reprapperMC/mini-hibiscus/production_parts/electronics/HEATSINK/No_heatsink/IR_4687.jpg

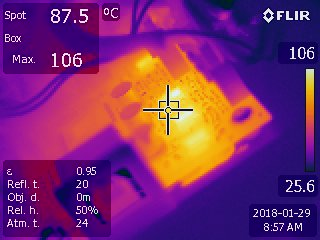
production_parts/electronics/HEATSINK/No_heatsink/IR_4687.jpg
