reprapperMC/mini-hibiscus/production_parts/printed_parts/x_carriage_mini2/ATTIC/README

X-Carriage v4.1 replaces v4 to address this ticket: https://code.alephobjects.com/T1295
See ticket for complete details
