reprapperMC/mini-hibiscus/photos/Mini2_Angled_800x800.PNG

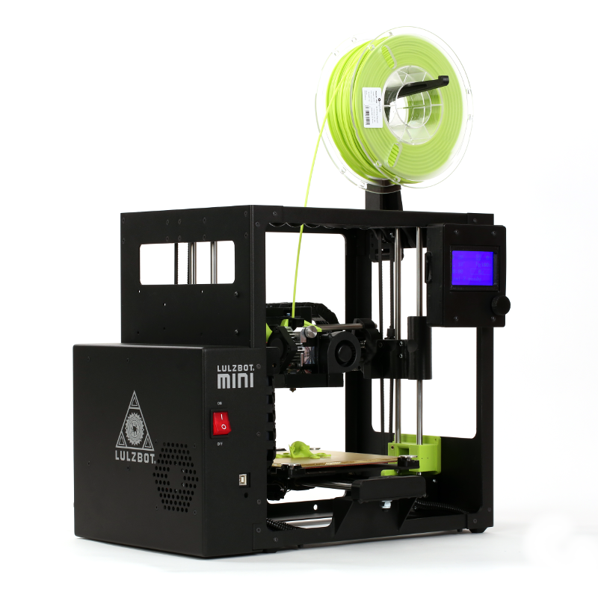
photos/Mini2_Angled_800x800.PNG
