reprapperMC/mini-hibiscus/photos/Mini2_Graphic_onBlack.JPG

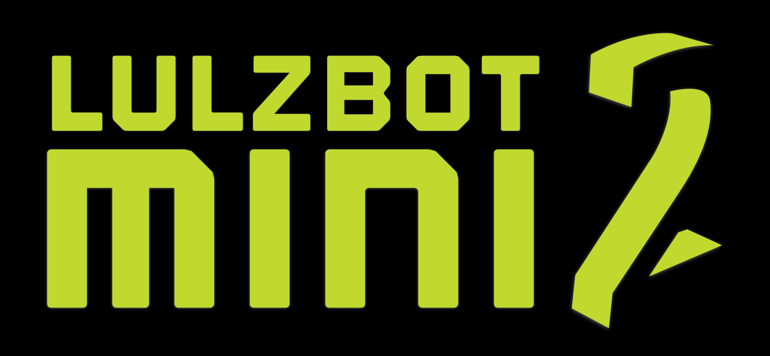
photos/Mini2_Graphic_onBlack.JPG
