reprapperMC/mini-hibiscus/photos/Mini2_Graphic_TransparentBG.png

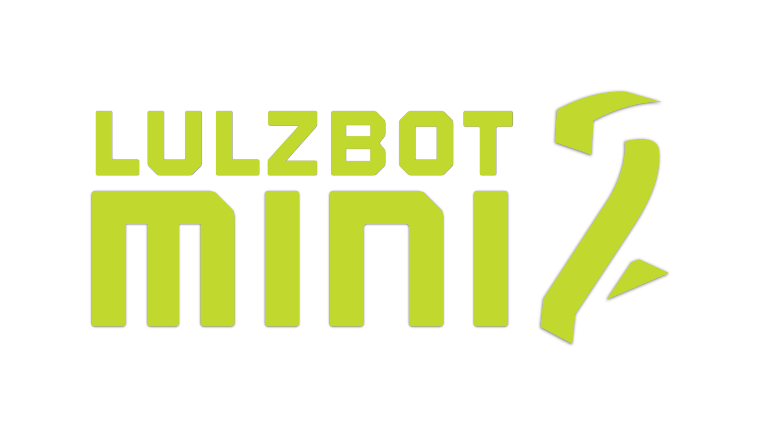
photos/Mini2_Graphic_TransparentBG.png
