reprapperMC/mini-hibiscus/photos/Mini2_Graphic_whitebg.JPG

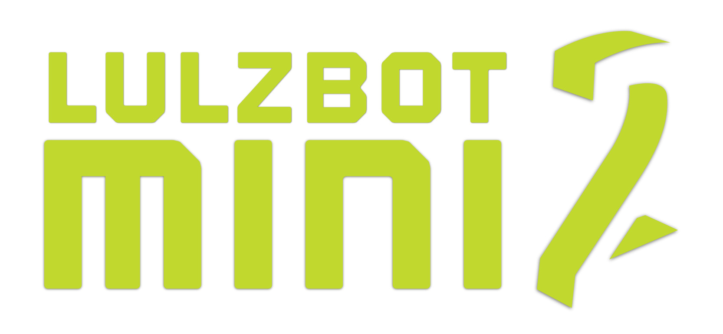
photos/Mini2_Graphic_whitebg.JPG
