reprapperMC/mini-hibiscus/photos/Mini2_StraightOn_800x800.PNG

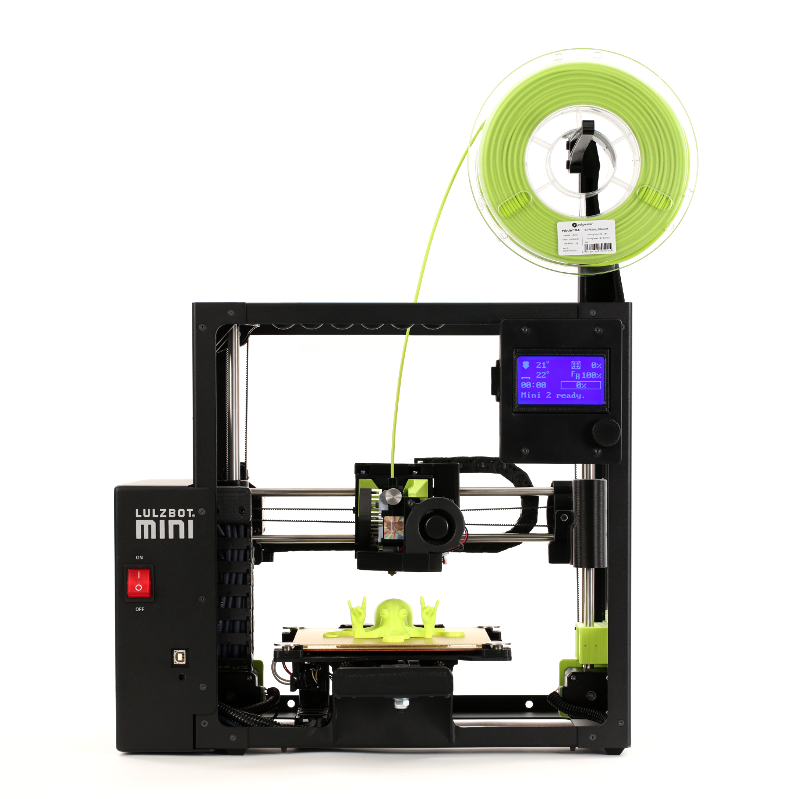
photos/Mini2_StraightOn_800x800.PNG
