reprapperMC/mini-hibiscus/production_docs/labels/asset_tag/source/Mini2_AssetTag_MockedUp.JPG

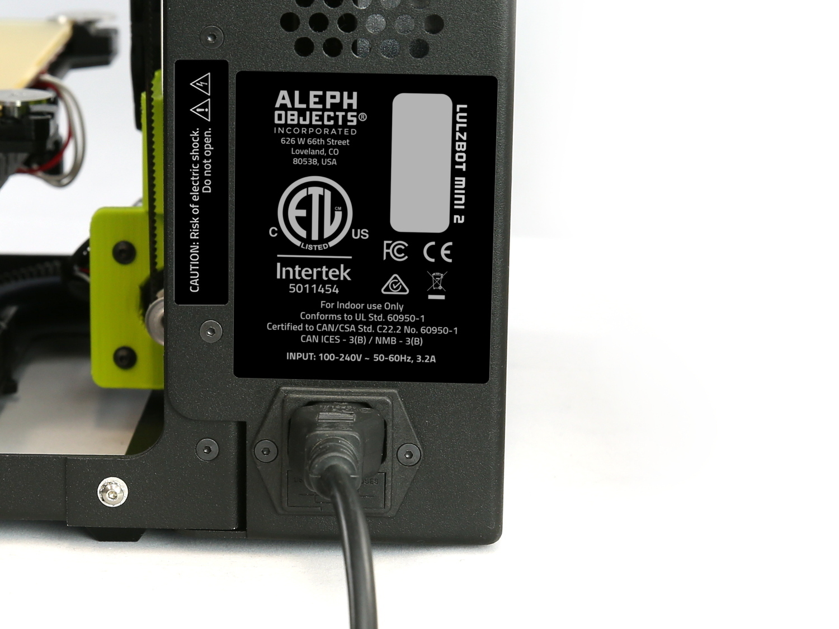
production_docs/labels/asset_tag/source/Mini2_AssetTag_MockedUp.JPG
