reprapperMC/mini-hibiscus/production_docs/labels/hot_symbol/Source/Mini2_FrontRight_Caution.JPG

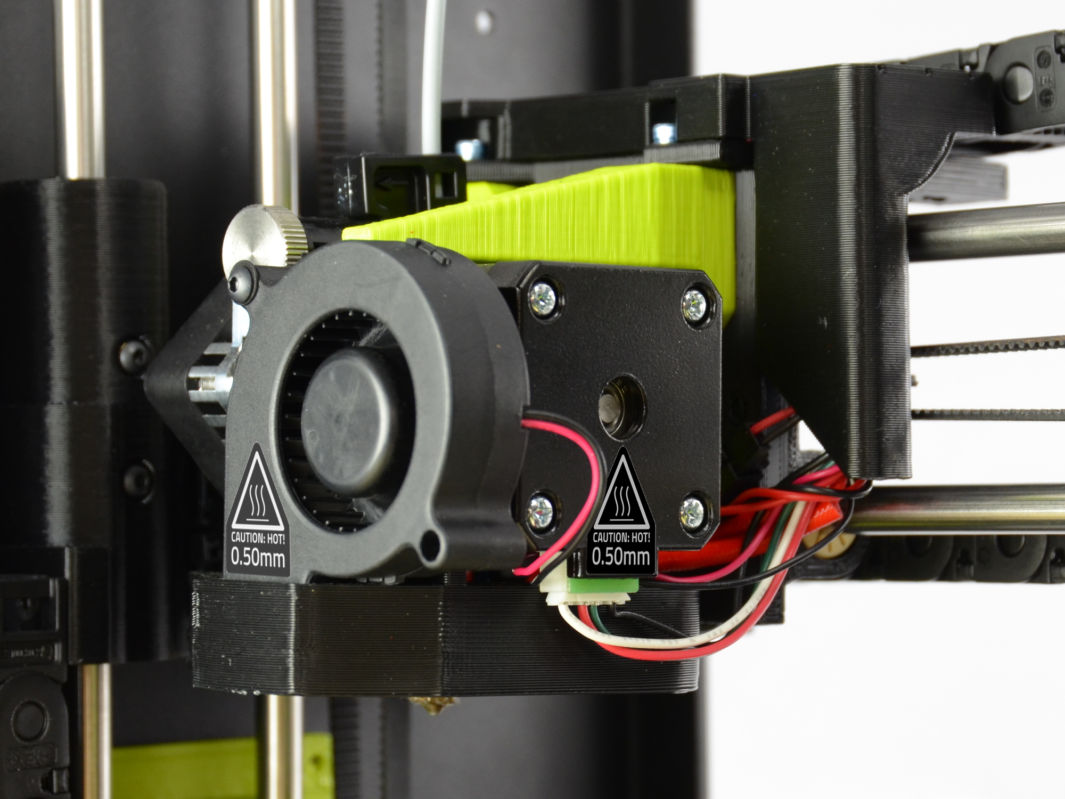
production_docs/labels/hot_symbol/Source/Mini2_FrontRight_Caution.JPG
