reprapperMC/mini-hibiscus/production_parts/electronics/HEATSINK/No_heatsink/IR_4691.jpg

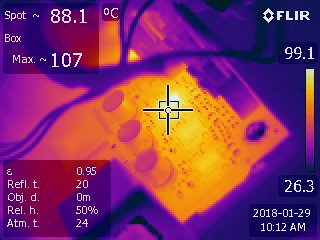
production_parts/electronics/HEATSINK/No_heatsink/IR_4691.jpg
