reprapperMC/mini-hibiscus/production_docs/Mini_2_MBOM.ods

Sheet: OdooParts_PurchaseNotes
Internal Reference | Name | Long Lead | Possibly Change Part, PN, or Modify | Special | U/M | Supplier PN | Category | Price Per Unit | Released to Order | Manufacturer | Mfg PN | Distributor | Distributor SKU | Notes | 2nd Distributor | 2nd Dist. Part Number | Mass each (g) | Mass per Printer (g) | Mass Total (kg)
AO-PG0001 | Aleph Objects, Inc. Business Cards | #N/A | #N/A | #N/A | PCE | 0 | #N/A | #N/A | #N/A | #N/A | 0 | #N/A | #N/A | #N/A | #N/A | #N/A | #N/A | #N/A | #N/A
AP0010 | Print die | No | No | No | PCE |  |  |  |  | Aleph Objects
AP-MM0000 | MendelMax Prototype, Dual Extrusion | No | No | No | PCE |  |  |  |  | Aleph Objects
AP-MM0001 | RepRap 3D Printer, MendelMax Variant, Fully Calibrated | No | No | No | PCE |  |  |  |  | Aleph Objects
AP-MM0001 | RepRap 3D Printer, MendelMax Variant, Fully Calibrated (copy) | No | No | No | PCE |  |  |  |  | Aleph Objects
AP-PR0000 | 3D Printer, RepRap Mendel by LulzBot | No | No | No | PCE |  |  |  |  | Aleph Objects
AP-PR0001 | RepRap Prusa Mendel by LulzBot, Used 3D Printer | No | No | No | PCE |  |  |  |  | Aleph Objects
AP-PR0002 | Original Prusa i3 MK2 3D Printer | No | No | No | PCE |  |  |  |  | Aleph Objects
AS-CB0001 | Heater Cartridge 225mm Harness | No | No | No | PCE |  |  |  |  | Aleph Objects
AS-CB0002 | Thermistor 220mm Harness | No | No | No | PCE |  |  |  |  | Aleph Objects
AS-CB0003 | Zero Sense 220mm Harness | No | No | No | PCE |  |  |  |  | Aleph Objects
AS-CB0005 | 40mm 5v Low Flow Fan-150mm Harness | No | No | No | PCE |  |  |  |  | Aleph Objects
AS-CB0006 | X-Max-185mm Purple Harness | No | No | No | PCE |  |  |  |  | Aleph Objects
AS-CB0007 | Heater Cartridge 180mm Harness | No | No | No | PCE |  |  |  |  | Aleph Objects
AS-CB0008 | Thermistor 150mm Harness | No | No | No | PCE |  |  |  |  | Aleph Objects
AS-CB0009 | Zero Sense 155mm Harness | No | No | No | PCE |  |  |  |  | Aleph Objects
AS-CB0010 | Zero Sense 175mm Harness | No | No | No | PCE |  |  |  |  | Aleph Objects
AS-CB0011 | 40mm 5v Low Flow Fan-160mm Harness | No | No | No | PCE |  |  |  |  | Aleph Objects
AS-CB0012 | Dual 24v Fan 115mm-65mm SS Harness | No | No | No | PCE |  |  |  |  | Aleph Objects
AS-CB0013 | Heater Cartridge 185mm Harness | No | No | No | PCE |  |  |  |  | Aleph Objects
AS-CB0014 | MOARstruder Thermistor Extension Harness | No | No | No | PCE |  |  |  |  | Aleph Objects
AS-CB0015 | X-Max 160mm-Purple Harness | No | No | No | PCE |  |  |  |  | Aleph Objects
AS-CB0016 | NEMA17 Stepper Motor-200mm Leads Harness | No | No | No | PCE |  |  |  |  | Aleph Objects
AS-CB0017 | Microblower- 195mm | No | No | No | PCE |  |  |  |  | Aleph Objects
AS-CB0018 | TAZ 5, Extruder Motor Harness | No | No | No | PCE |  |  |  |  | Aleph Objects
AS-CB0019 | Heater Cartridge 210mm Harness | No | No | No | PCE |  |  |  |  | Aleph Objects
AS-CB0020 | 40mm 24v Low Flow Fan-200mm Harness | No | No | No | PCE |  |  |  |  | Aleph Objects
AS-CB0021 | NEMA17 Half Height Stepper Motor-130mm Leads Harness | No | No | No | PCE |  |  |  |  | Aleph Objects
AS-CB0022 | Thermistor 235mm Harness | No | No | No | PCE |  |  |  |  | Aleph Objects
AS-CB0023 | X-Max-160mm Black harness | No | No | No | PCE |  |  |  |  | Aleph Objects
AS-CB0024 | Heater Cartridge 175mm Harness | No | No | No | PCE |  |  |  |  | Aleph Objects
AS-CB0025 | Thermistor 195mm Harness | No | No | No | PCE |  |  |  |  | Aleph Objects
AS-CB0026 | Mini 1.00 - 1.03 Bed Power Cable 550mm | No | No | No | PCE |  |  |  |  | Aleph Objects
AS-CB0027 | Mini 1.00 - 1.03 Bed Thermistor Cable 500mm | No | No | No | PCE |  |  |  |  | Aleph Objects
AS-CB0028 | Mini 1.00 - 1.03 Y Max Switch Cable 525mm | No | No | No | PCE |  |  |  |  | Aleph Objects
AS-CB0029 | Mini 1.00 - 1.03 Y Min Switch Cable 525mm | No | No | No | PCE |  |  |  |  | Aleph Objects
AS-CB0030 | Mini 1.00 - 1.03 Bed Ground Cable 500mm | No | No | No | PCE |  |  |  |  | Aleph Objects
AS-CB0031 | NEMA17 Stepper Motor-65mm Leads Harness | No | No | No | PCE |  |  |  |  | Aleph Objects
AS-CB0032 | 24v 40w Heater Cartridge, 235mm | No | No | No | PCE |  |  |  |  | Aleph Objects
AS-CB0033 | NTC Thermistor Extension, 170mm | No | No | No | PCE |  |  |  |  | Aleph Objects
AS-CB0034 | Heat Bed Extension v1.0, TAZ | No | No | No | PCE |  |  |  |  | Aleph Objects
AS-CB0035 | CB Heat Bed Harness v2.1, TAZ | No | No | No | PCE |  |  |  |  | Aleph Objects
AS-CB0036 | 40mm 5v LowFlowFan Harness | No | No | No | PCE |  |  |  |  | Aleph Objects
AS-CB0037 | Stepper Motor JST 55mm Harness | No | No | No | PCE |  |  |  |  | Aleph Objects
AS-CB0038 | TAZ Dual Extruder v3 40mm Fan Harness | No | No | No | PCE |  |  |  |  | Aleph Objects
AS-CB0039 | v3 Dual Extruder Harness 1 | No | No | No | PCE |  |  |  |  | Aleph Objects
AS-CB0040 | v3 Dual Thermistor Extension Harness | No | No | No | PCE |  |  |  |  | Aleph Objects
AS-CB0041 | X Max Purple Harness | No | No | No | PCE |  |  |  |  | Aleph Objects
AS-CB0042 | v3 Dual Extruder Harness 0 | No | No | No | PCE |  |  |  |  | Aleph Objects
AS-CB0043 | 24v 30w Heater Cartridge, 200mm | No | No | No | PCE |  |  |  |  | Aleph Objects
AS-CB0044 | Blower Fan Harness, 210mm | No | No | No | PCE |  |  |  |  | Aleph Objects
AS-CB0045 | Extruder Motor Harness, 185mm | No | No | No | PCE |  |  |  |  | Aleph Objects
AS-CB0046 | Heatsink Fan Harness, 155mm | No | No | No | PCE |  |  |  |  | Aleph Objects
AS-CB0047 | Hotend GND Wire, 210mm | No | No | No | PCE |  |  |  |  | Aleph Objects
AS-CB0048 | Thermistor Harness | No | No | No | PCE |  |  |  |  | Aleph Objects
AS-CB0049 | Xmax Switch Harness, 190mm | No | No | No | PCE |  |  |  |  | Aleph Objects
AS-CB0050 | Blower fan Harness, 250mm | No | No | No | PCE |  |  |  |  | Aleph Objects
AS-CB0051 | Extruder Motor Harness, 180mm | No | No | No | PCE |  |  |  |  | Aleph Objects
AS-CB0052 | Heatsink fan Harness, 220mm | No | No | No | PCE |  |  |  |  | Aleph Objects
AS-CB0053 | Thermistor Harness, 120mm | No | No | No | PCE |  |  |  |  | Aleph Objects
AS-CB0054 | Xmax switch Harness, 175mm | No | No | No | PCE |  |  |  |  | Aleph Objects
AS-CB0055 | Replicape CB Bed Power Harness | No | No | No | PCE |  |  |  |  | Aleph Objects
AS-CB0056 | Replicape CB Y-Z Harness | No | No | No | PCE |  |  |  |  | Aleph Objects
AS-CB0057 | Replicape CB Extruder Harness | No | No | No | PCE |  |  |  |  | Aleph Objects
AS-CB0058 | Replicape CB X-Harness | No | No | No | PCE |  |  |  |  | Aleph Objects
AS-CB0059 | Replicape CB Bed Harness | No | No | No | PCE |  |  |  |  | Aleph Objects
AS-CB0060 | Zero Sense 145mm Harness | No | No | No | PCE |  |  |  |  | Aleph Objects
AS-CB0061 | Extruder Motor Harness v2Aero | No | No | No | PCE |  |  |  |  | Aleph Objects
AS-CB0062 | v2Aero Extruder Blower Harness | No | No | No | PCE |  |  |  |  | Aleph Objects
AS-CB0063 | v2 Aero Zero Sense Harness | No | No | No | PCE |  |  |  |  | Aleph Objects
AS-CB0064 | v2Aero Heatsink Fan Harness | No | No | No | PCE |  |  |  |  | Aleph Objects
AS-CB0065 | v2 Aero X-Max Switch Harness | No | No | No | PCE |  |  |  |  | Aleph Objects
AS-CB0066 | v2Aero Thermistor Harness | No | No | No | PCE |  |  |  |  | Aleph Objects
AS-CB0067 | v2Aero Extruder Harness - Complete | No | No | No | PCE |  |  |  |  | Aleph Objects
AS-CB0068 | TAZ6_CB_LCD_Harness_V2 | No | No | No | PCE |  |  |  |  | Aleph Objects
AS-CB0069 | Z brake power harness | No | No | No | PCE |  |  |  |  | Aleph Objects
AS-CB0070 | Z brake motor harness- Hibiscus | No | No | No | PCE |  |  |  |  | Aleph Objects
AS-CB0071 | Bed Harnesses- Hibiscus | No | No | No | PCE |  |  |  |  | Aleph Objects
AS-CB0072 | YZ Harness- Hibiscus | No | No | No | PCE |  |  |  |  | Aleph Objects
AS-CB0073 | Mini Plug to SW Extension Harness Assembly - Hibiscus | No | No | No | PCE |  |  |  |  | Aleph Objects
AS-CB0074 | Mini PS to EinsyRetro Red Wire | No | No | No | PCE |  |  |  |  | Aleph Objects
AS-CB0075 | Earth Ground Extension Wire Harness- Hibiscus | No | No | No | PCE |  |  |  |  | Aleph Objects
AS-CB0076 | Mini SW to PS - Black Wire Extension Harness Assembly - Hibiscus | No | No | No | PCE |  |  |  |  | Aleph Objects
AS-CB0077 | Mini SW to PS - White Wire Extension Harness Assembly – Hibiscus | No | No | No | PCE |  |  |  |  | Aleph Objects
AS-CB0078 | Case Fan Harness- Hibiscus | No | No | No | PCE |  |  |  |  | Aleph Objects
AS-CB0079 | Plug to Ground Post Extension- Hibiscus | No | No | No | PCE |  |  |  |  | Aleph Objects
AS-CB0080 | PS to Ground Post Extension- Hibiscus | No | No | No | PCE |  |  |  |  | Aleph Objects
AS-CB0081 | Mini PS to EinsyRetro Black Wire | No | No | No | PCE |  |  |  |  | Aleph Objects
AS-EL0001 | Mini LCD Add-On Assembly | No | No | No | PCE |  |  |  |  | Aleph Objects
AS-EL0002 | Hibiscus LCD Assembly | No | No | No | PCE |  |  |  |  | Aleph Objects
AS-EL0003 | Z-Motor Brake Assembled | No | No | No | PCE |  |  |  |  | Aleph Objects
AS-FA0001 | Micro Blower Assembly 250mm | No | No | No | PCE |  |  |  |  | Aleph Objects
AS-HB0001 | Mini Glass/PEI Print Surface | No | No | No | PCE |  |  |  |  | Aleph Objects
AS-HB0002 | Mini Modular Print Bed Heater | No | No | No | PCE |  |  |  |  | Aleph Objects
AS-HB0003 | TAZ Glass/PEI Print Surface | No | No | No | PCE |  |  |  |  | Aleph Objects
AS-HB0004 | TAZ Modular Print Bed Heater | No | No | No | PCE |  |  |  |  | Aleph Objects
AS-HB0005 | Mini Etched Modular Print Bed Heater | No | No | No | PCE |  |  |  |  | Aleph Objects
AS-HB0006 | TAZ Silkscreened Modular Print Bed Heater | No | No | No | PCE |  |  |  |  | Aleph Objects
AS-HB0007 | TAZ Modular Print Bed Heater, no felt | No | No | No | PCE |  |  |  |  | Aleph Objects
AS-HB0008 | Mini Modular Print Bed Heater, no felt, UR/CSA | No | No | No | PCE |  |  |  |  | Aleph Objects
AS-HE0001 | .50mm Hot End Assembly, for dual | No | No | No | PCE |  |  |  |  | Aleph Objects
AS-HE0002 | .50mm Hot End Assembly, for single | No | No | No | PCE |  |  |  |  | Aleph Objects
AS-HE0003 | .60mm Hot End Assembly | No | No | No | PCE |  |  |  |  | Aleph Objects
AS-HE0005 | Hexagon Hot End, .5mm Assembly, Mini Single | No | No | No | PCE |  |  |  |  | Aleph Objects
AS-HE0007 | Longblock Hotend kit, Lulzbot Edition, 3.0mm Filament | No | No | No | PCE |  |  |  |  | Aleph Objects
AS-HE0008 | Flexystruder_v2, .60mm Hot End Assembly | No | No | No | PCE |  |  |  |  | Aleph Objects
AS-HE0009 | TAZ 0.35mm Hot End Assembly | No | No | No | PCE |  |  |  |  | Aleph Objects
AS-HE0010 | TAZ, Flexystruder, Hot End Assembly | No | No | No | PCE |  |  |  |  | Aleph Objects
AS-HE0011 | TAZ 5 Hot End Assembly, 0.5mm | No | No | No | PCE |  |  |  |  | Aleph Objects
AS-HE0012 | 0.50 Hot End Assembly for HE Kit | No | No | No | PCE |  |  |  |  | Aleph Objects
AS-HE0013 | 0.35 Hot End Assembly for HE Kit | No | No | No | PCE |  |  |  |  | Aleph Objects
AS-HE0014 | .60 Hot End Assembly for HE Kit | No | No | No | PCE |  |  |  |  | Aleph Objects
AS-HE0015 | E3D MOARstruder Hot End, 3.0mm Filament, 1.2mm Nozzle, assembled and crimped | No | No | No | PCE |  |  |  |  | Aleph Objects
AS-HE0016 | E3D Dual v3 Hot End, Left, Pre-Assembled | No | No | No | PCE |  |  |  |  | Aleph Objects
AS-HE0017 | E3D Dual v3 Hot End, Right, Pre-Assembled | No | No | No | PCE |  |  |  |  | Aleph Objects
AS-HE0018 | TAZ Dual V3 Hotend Assembly | No | No | No | PCE |  |  |  |  | Aleph Objects
AS-HE0019 | TAZ Aero Hotend Assembly | No | No | No | PCE |  |  |  |  | Aleph Objects
AS-HE0020 | TAZ E3D Aero Hot End 3.0mm, 0.5mm Nozzle, Hot-Tightened, Pre-Assembled | No | No | No | PCE |  |  |  |  | Aleph Objects
AS-HE0021 | Mini E3D Aero Hot End 3.0mm, 0.5mm Nozzle, Hot-Tightened, Pre-Assembled | No | No | No | PCE |  |  |  |  | Aleph Objects
AS-HE0022 | Mini AeroStruder Hotend Assembly | No | No | No | PCE |  |  |  |  | Aleph Objects
AS-HE0023 | E3D Dual v3 Hot End, Left, Assembly | No | No | No | PCE |  |  |  |  | Aleph Objects
AS-HE0024 | E3D Dual v3 Hot End, Right, Assembly | No | No | No | PCE |  |  |  |  | Aleph Objects
AS-HE0025 | v2Aero Hotend Assembly | No | No | No | PCE |  |  |  |  | Aleph Objects
AS-HE0026 | Universal E3D Aero Hot End 3.0mm, 0.5mm Nozzle, Hot-Tightened, Pre-Assembled | No | No | No | PCE |  |  |  |  | Aleph Objects
AS-PK0001 | TAZ, Dual Extruder, Packaging | No | No | No | PCE |  |  |  |  | Aleph Objects
AS-PK0002 | Tilapia, Extruder Assembly_v2.1, Packaging | No | No | No | PCE |  |  |  |  | Aleph Objects
AS-PK0003 | FlexyDually_v2, Packaging | No | No | No | PCE |  |  |  |  | Aleph Objects
AS-PK0004 | FlexyDually_v2, Accessories | No | No | No | PCE |  |  |  |  | Aleph Objects
AS-PK0006 | TAZ6, Olive Oil, Documentation Bag | No | No | No | PCE |  |  |  |  | Aleph Objects
AS-PK0007 | TAZ6, Olive Oil, Extruder Package | No | No | No | PCE |  |  |  |  | Aleph Objects
AS-PK0008 | TAZ6, Olive Oil, Accessories Package | No | No | No | PCE |  |  |  |  | Aleph Objects
AS-PK0009 | TAZ6, Tool Kit | No | No | No | PCE |  |  |  |  | Aleph Objects
AS-PK0010 | 90 mm wiper pad set | No | No | No | PCE |  |  |  |  | Aleph Objects
AS-PK0012 | TAZ, MOARstruder, Accessories | No | No | No | PCE |  |  |  |  | Aleph Objects
AS-PK0013 | Flexystruder_v2, TAZ, Accessories | No | No | No | PCE |  |  |  |  | Aleph Objects
AS-PK0014 | TAZ, Flexystruder v2 Packaging | No | No | No | PCE |  |  |  |  | Aleph Objects
AS-PK0015 | Flexystruder_V2, Mini, Accessories | No | No | No | PCE |  |  |  |  | Aleph Objects
AS-PK0016 | Flexystruder_V2, Mini, Packaging | No | No | No | PCE |  |  |  |  | Aleph Objects
AS-PK0017 | TAZ 5 Extruder Assembly, Packaging | No | No | No | PCE |  |  |  |  | Aleph Objects
AS-PK0018 | Single Extruder Tool Head 2.1 Packaging | No | No | No | PCE |  |  |  |  | Aleph Objects
AS-PK0019 | Mini, Gladiola, Documentation Bag | No | No | No | PCE |  |  |  |  | Aleph Objects
AS-PK0020 | Mini, Tool Kit | No | No | No | PCE |  |  |  |  | Aleph Objects
AS-PK0021 | Mini Modular Bed Corners Kit | No | No | No | PCE |  |  |  |  | Aleph Objects
AS-PK0022 | TAZ Dual Extruder V3 Accessories Kit | No | No | No | PCE |  |  |  |  | Aleph Objects
AS-PK0023 | Mini LCD Packaging Assembly | No | No | No | PCE |  |  |  |  | Aleph Objects
AS-PK0024 | 6 Mil Heavy Duty Poly Tubing 250mm | No | No | No | PCE |  |  |  |  | Aleph Objects
AS-PK0025 | 6 Mil Heavy Duty Poly Tubing 390mm | No | No | No | PCE |  |  |  |  | Aleph Objects
AS-PK0026 | 6 Mil Heavy Duty Poly Tubing 425mm | No | No | No | PCE |  |  |  |  | Aleph Objects
AS-PK0027 | Clam knife with label | No | No | No | PCE |  |  |  |  | Aleph Objects
AS-PK0028 | Mini 2 Documentation Bag | No | No | No | PCE |  |  |  |  | Aleph Objects
AS-PK0029 | Mini 2, Tool Kit | No | No | No | PCE |  |  |  |  | Aleph Objects
AS-PR0001 | TAZ6, Olive Oil, Calibrated Assembly | #N/A | #N/A | #N/A | PCE | 0 | #N/A | #N/A | #N/A | #N/A | 0 | #N/A | #N/A | #N/A | #N/A | #N/A | #N/A | #N/A | #N/A
AS-PR0002 | TAZ6, Print Bed Assembly | #N/A | #N/A | #N/A | PCE | 0 | #N/A | #N/A | #N/A | #N/A | 0 | #N/A | #N/A | #N/A | #N/A | #N/A | #N/A | #N/A | #N/A
AS-PR0003 | TAZ6, Olive Oil, Final Mechanical Assembly | #N/A | #N/A | #N/A | PCE | 0 | #N/A | #N/A | #N/A | #N/A | 0 | #N/A | #N/A | #N/A | #N/A | #N/A | #N/A | #N/A | #N/A
AS-PR0004 | TAZ6, Olive Oil, Control Box Assembly | #N/A | #N/A | #N/A | PCE | 0 | #N/A | #N/A | #N/A | #N/A | 0 | #N/A | #N/A | #N/A | #N/A | #N/A | #N/A | #N/A | #N/A
AS-PR0006 | TAZ6, Frame, Final Assembly | #N/A | #N/A | #N/A | PCE | S-2845 | #N/A | #N/A | #N/A | #N/A | 0 | #N/A | #N/A | #N/A | #N/A | #N/A | #N/A | #N/A | #N/A
AS-PR0008 | TAZ6, Bed Mount Chassis with Inserts | #N/A | #N/A | #N/A | PCE | 0 | #N/A | #N/A | #N/A | #N/A | 0 | #N/A | #N/A | #N/A | #N/A | #N/A | #N/A | #N/A | #N/A
AS-PR0010 | Taz tool sub-kit | #N/A | #N/A | #N/A | PCE | 0 | #N/A | #N/A | #N/A | #N/A | 0 | #N/A | #N/A | #N/A | #N/A | #N/A | #N/A | #N/A | #N/A
AS-PR0011 | TAZ6, Tippy Feed Tube Holder with Bushing Assembly | #N/A | #N/A | #N/A | PCE | 0 | #N/A | #N/A | #N/A | #N/A | 0 | #N/A | #N/A | #N/A | #N/A | #N/A | #N/A | #N/A | #N/A
AS-PR0012 | TAZ6, Spool Arm with Bushing Assembly | #N/A | #N/A | #N/A | PCE | S-17021 | #N/A | #N/A | #N/A | #N/A | 0 | #N/A | #N/A | #N/A | #N/A | #N/A | #N/A | #N/A | #N/A
AS-PR0013 | TAZ6, Z Axis Left Assembly | #N/A | #N/A | #N/A | PCE | S-3005 | #N/A | #N/A | #N/A | #N/A | 0 | #N/A | #N/A | #N/A | #N/A | #N/A | #N/A | #N/A | #N/A
AS-PR0014 | TAZ6, Z Carriage Motor with Bearings and Inserts Assembly | #N/A | #N/A | #N/A | PCE | S-248 | #N/A | #N/A | #N/A | #N/A | 0 | #N/A | #N/A | #N/A | #N/A | #N/A | #N/A | #N/A | #N/A
AS-PR0015 | TAZ6, Z Carriage Motor with Bearings Assembly | #N/A | #N/A | #N/A | PCE | 14035T23 | #N/A | #N/A | #N/A | #N/A | 0 | #N/A | #N/A | #N/A | #N/A | #N/A | #N/A | #N/A | #N/A
AS-PR0016 | TAZ6, Z Lower Left with Inserts Assembly | #N/A | #N/A | #N/A | PCE | 14035T25 | #N/A | #N/A | #N/A | #N/A | 0 | #N/A | #N/A | #N/A | #N/A | #N/A | #N/A | #N/A | #N/A
AS-PR0017 | TAZ6, Z Axis Right Assembly | #N/A | #N/A | #N/A | PCE | 0 | #N/A | #N/A | #N/A | #N/A | 0 | #N/A | #N/A | #N/A | #N/A | #N/A | #N/A | #N/A | #N/A
AS-PR0018 | TAZ6, Z Carriage Idler with Bearings and Inserts Assembly | #N/A | #N/A | #N/A | PCE | 0 | #N/A | #N/A | #N/A | #N/A | 0 | #N/A | #N/A | #N/A | #N/A | #N/A | #N/A | #N/A | #N/A
AS-PR0019 | TAZ6, Z Carriage Idler with Bearings Assembly | #N/A | #N/A | #N/A | PCE | 0 | #N/A | #N/A | #N/A | #N/A | 0 | #N/A | #N/A | #N/A | #N/A | #N/A | #N/A | #N/A | #N/A
AS-PR0020 | TAZ6, Z Lower Right with Inserts Assembly | #N/A | #N/A | #N/A | PCE | 112797 | #N/A | #N/A | #N/A | #N/A | 0 | #N/A | #N/A | #N/A | #N/A | #N/A | #N/A | #N/A | #N/A
AS-PR0021 | TAZ6, Olive Oil, Y Axis Assembly | #N/A | #N/A | #N/A | PCE | 0 | #N/A | #N/A | #N/A | #N/A | 0 | #N/A | #N/A | #N/A | #N/A | #N/A | #N/A | #N/A | #N/A
AS-PR0023 | 90mm Cut wiper pad | #N/A | #N/A | #N/A | PCE | 0 | #N/A | #N/A | #N/A | #N/A | 0 | #N/A | #N/A | #N/A | #N/A | #N/A | #N/A | #N/A | #N/A
AS-PR0024 | TAZ6, Y Belt Mount with Inserts Assembly | #N/A | #N/A | #N/A | PCE | 0 | #N/A | #N/A | #N/A | #N/A | 0 | #N/A | #N/A | #N/A | #N/A | #N/A | #N/A | #N/A | #N/A
AS-PR0025 | 10mm Single Bearing holders Assembly | #N/A | #N/A | #N/A | PCE | S-13119 | #N/A | #N/A | #N/A | #N/A | 0 | #N/A | #N/A | #N/A | #N/A | #N/A | #N/A | #N/A | #N/A
AS-PR0026 | TAZ6, Y Corner Right with Insert Assembly | #N/A | #N/A | #N/A | PCE | S-5914 | #N/A | #N/A | #N/A | #N/A | 0 | #N/A | #N/A | #N/A | #N/A | #N/A | #N/A | #N/A | #N/A
AS-PR0027 | TAZ6, Y Corner Left with Insert Assembly | #N/A | #N/A | #N/A | PCE | S-13118 | #N/A | #N/A | #N/A | #N/A | 0 | #N/A | #N/A | #N/A | #N/A | #N/A | #N/A | #N/A | #N/A
AS-PR0028 | TAZ6, Y Idler with Bearings and Inserts | #N/A | #N/A | #N/A | PCE | 0 | #N/A | #N/A | #N/A | #N/A | 0 | #N/A | #N/A | #N/A | #N/A | #N/A | #N/A | #N/A | #N/A
AS-PR0030 | TAZ6, Y Axis Motor End Assembly | #N/A | #N/A | #N/A | PCE | 0 | #N/A | #N/A | #N/A | #N/A | 0 | #N/A | #N/A | #N/A | #N/A | #N/A | #N/A | #N/A | #N/A
AS-PR0032 | TAZ6, Olive Oil, X Carriage Assembly | #N/A | #N/A | #N/A | PCE | 0 | #N/A | #N/A | #N/A | #N/A | 0 | #N/A | #N/A | #N/A | #N/A | #N/A | #N/A | #N/A | #N/A
AS-PR0033 | TAZ6, X carriage with Inserts Assembly | #N/A | #N/A | #N/A | PCE | 0 | #N/A | #N/A | #N/A | #N/A | 0 | #N/A | #N/A | #N/A | #N/A | #N/A | #N/A | #N/A | #N/A
AS-PR0034 | TAZ6, 12mm Double Bearing Holder with Bearings Assembly | 0 | Y | 0 | PCE | 0 | Packaging | 0.14 |  | 0 | 0 | The print shop of loveland | 0 | 0 | 0 | 0 | 0 | 0 | 0
AS-PR0035 | TAZ6, 12mm Single Bearing Holder with Bearing Assembly | 0 | Y | 0 | PCE | 0 | Packaging | 0.014 |  | 0 | 0 | The print shop of loveland | 0 | 0 | 0 | 0 | 0 | 0 | 0
AS-PR0036 | 16mm Thumbscrew Cap Installed onto M5 x14 Black Oxide screw | #N/A | #N/A | #N/A | PCE | S-13827 | #N/A | #N/A | #N/A | #N/A | 0 | #N/A | #N/A | #N/A | #N/A | #N/A | #N/A | #N/A | #N/A
AS-PR0037 | Mini, Gladiola, Final Electrical Assembly | #N/A | #N/A | #N/A | PCE | 0 | #N/A | #N/A | #N/A | #N/A | 0 | #N/A | #N/A | #N/A | #N/A | #N/A | #N/A | #N/A | #N/A
AS-PR0038 | Mini, Final Mechanical Assembly | #N/A | #N/A | #N/A | PCE | 0 | #N/A | #N/A | #N/A | #N/A | 0 | #N/A | #N/A | #N/A | #N/A | #N/A | #N/A | #N/A | #N/A
AS-PR0039 | Mini, Bed Plate Assembly | #N/A | #N/A | #N/A | PCE | 0 | #N/A | #N/A | #N/A | #N/A | 0 | #N/A | #N/A | #N/A | #N/A | #N/A | #N/A | #N/A | #N/A
AS-PR0042 | Mini, Z Axis, Left Assembly | #N/A | #N/A | #N/A | PCE | 0 | #N/A | #N/A | #N/A | #N/A | 0 | #N/A | #N/A | #N/A | #N/A | #N/A | #N/A | #N/A | #N/A
AS-PR0044 | Mini, Z upper left v1.2, Mini, complete | #N/A | #N/A | #N/A | PCE | 0 | #N/A | #N/A | #N/A | #N/A | 0 | #N/A | #N/A | #N/A | #N/A | #N/A | #N/A | #N/A | #N/A
AS-PR0045 | Mini, Z lower, Left complete | #N/A | #N/A | #N/A | PCE | 0 | #N/A | #N/A | #N/A | #N/A | 0 | #N/A | #N/A | #N/A | #N/A | #N/A | #N/A | #N/A | #N/A
AS-PR0046 | Mini, Z carriage- X Motor Inserts and Bushing Assembly | #N/A | #N/A | #N/A | PCE | 0 | #N/A | #N/A | #N/A | #N/A | 0 | #N/A | #N/A | #N/A | #N/A | #N/A | #N/A | #N/A | #N/A
AS-PR0047 | Mini, X End Motor Assembly | #N/A | #N/A | #N/A | PCE | 0 | #N/A | #N/A | #N/A | #N/A | 0 | #N/A | #N/A | #N/A | #N/A | #N/A | #N/A | #N/A | #N/A
AS-PR0048 | Mini, Z Axis, Right Assembly | #N/A | #N/A | #N/A | PCE | 0 | #N/A | #N/A | #N/A | #N/A | 0 | #N/A | #N/A | #N/A | #N/A | #N/A | #N/A | #N/A | #N/A
AS-PR0049 | Mini, Z Axis Motor, Damper, Coupler assembly | #N/A | #N/A | #N/A | PCE | 0 | #N/A | #N/A | #N/A | #N/A | 0 | #N/A | #N/A | #N/A | #N/A | #N/A | #N/A | #N/A | #N/A
AS-PR0050 | Mini, Z upper right v1.2 Assembly | #N/A | #N/A | #N/A | PCE | 0 | #N/A | #N/A | #N/A | #N/A | 0 | #N/A | #N/A | #N/A | #N/A | #N/A | #N/A | #N/A | #N/A
AS-PR0051 | Mini, Z lower right Assembly | #N/A | #N/A | #N/A | PCE | 0 | #N/A | #N/A | #N/A | #N/A | 0 | #N/A | #N/A | #N/A | #N/A | #N/A | #N/A | #N/A | #N/A
AS-PR0052 | Mini, X End Idler Assembly | #N/A | #N/A | #N/A | PCE | 0 | #N/A | #N/A | #N/A | #N/A | 0 | #N/A | #N/A | #N/A | #N/A | #N/A | #N/A | #N/A | #N/A
AS-PR0054 | Mini, X End Idler Printed Assembly | #N/A | #N/A | #N/A | PCE | 0 | #N/A | #N/A | #N/A | #N/A | 0 | #N/A | #N/A | #N/A | #N/A | #N/A | #N/A | #N/A | #N/A
AS-PR0055 | Mini, X Axis, Carriage Assembly | #N/A | #N/A | #N/A | PCE | 0 | #N/A | #N/A | #N/A | #N/A | 0 | #N/A | #N/A | #N/A | #N/A | #N/A | #N/A | #N/A | #N/A
AS-PR0056 | Mini, X Motor Carriage with Bearings Assembly | #N/A | #N/A | #N/A | PCE | Custom Part | #N/A | #N/A | #N/A | #N/A | 0 | #N/A | #N/A | #N/A | #N/A | #N/A | #N/A | #N/A | #N/A
AS-PR0057 | Mini, Upper Bearing holder Assembly | #N/A | #N/A | #N/A | PCE | 0 | #N/A | #N/A | #N/A | #N/A | 0 | #N/A | #N/A | #N/A | #N/A | #N/A | #N/A | #N/A | #N/A
AS-PR0058 | Mini, Upper Bearing holder with Bearings Assembly | #N/A | #N/A | #N/A | PCE | 0 | #N/A | #N/A | #N/A | #N/A | 0 | #N/A | #N/A | #N/A | #N/A | #N/A | #N/A | #N/A | #N/A
AS-PR0059 | Mini, Belt Clamp assembly | #N/A | #N/A | #N/A | PCE | 0 | #N/A | #N/A | #N/A | #N/A | 0 | #N/A | #N/A | #N/A | #N/A | #N/A | #N/A | #N/A | #N/A
AS-PR0060 | Mini, Printed belt clamp assembly | #N/A | #N/A | #N/A | PCE | 0 | #N/A | #N/A | #N/A | #N/A | 0 | #N/A | #N/A | #N/A | #N/A | #N/A | #N/A | #N/A | #N/A
AS-PR0061 | Mini Spool Arm Assembly | #N/A | #N/A | #N/A | PCE | 0 | #N/A | #N/A | #N/A | #N/A | 0 | #N/A | #N/A | #N/A | #N/A | #N/A | #N/A | #N/A | #N/A
AS-PR0062 | Mini, Spool Hinge | #N/A | #N/A | #N/A | PCE | 0 | #N/A | #N/A | #N/A | #N/A | 0 | #N/A | #N/A | #N/A | #N/A | #N/A | #N/A | #N/A | #N/A
AS-PR0063 | Mini, Spool Mount | #N/A | #N/A | #N/A | PCE | 0 | #N/A | #N/A | #N/A | #N/A | 0 | #N/A | #N/A | #N/A | #N/A | #N/A | #N/A | #N/A | #N/A
AS-PR0064 | Mini, Final Frame Assembly | #N/A | #N/A | #N/A | PCE | 0 | #N/A | #N/A | #N/A | #N/A | 0 | #N/A | #N/A | #N/A | #N/A | #N/A | #N/A | #N/A | #N/A
AS-PR0065 | Mini, Handle Complete | #N/A | #N/A | #N/A | PCE | 0 | #N/A | #N/A | #N/A | #N/A | 0 | #N/A | #N/A | #N/A | #N/A | #N/A | #N/A | #N/A | #N/A
AS-PR0066 | Mini, Upper Relief Mount Assembly | #N/A | #N/A | #N/A | PCE | 0 | #N/A | #N/A | #N/A | #N/A | 0 | #N/A | #N/A | #N/A | #N/A | #N/A | #N/A | #N/A | #N/A
AS-PR0067 | Mini, Y Axis Assembly | #N/A | #N/A | #N/A | PCE | 0 | #N/A | #N/A | #N/A | #N/A | 0 | #N/A | #N/A | #N/A | #N/A | #N/A | #N/A | #N/A | #N/A
AS-PR0068 | Mini, Y Axis Idler Mount Assembly | #N/A | #N/A | #N/A | PCE | 0 | #N/A | #N/A | #N/A | #N/A | 0 | #N/A | #N/A | #N/A | #N/A | #N/A | #N/A | #N/A | #N/A
AS-PR0069 | Mini, Y Axis Mount Idler Insert Assembly | #N/A | #N/A | #N/A | PCE | 0 | #N/A | #N/A | #N/A | #N/A | 0 | #N/A | #N/A | #N/A | #N/A | #N/A | #N/A | #N/A | #N/A
AS-PR0070 | Mini, Y Axis Rod Mount, Motor Side Assembly | #N/A | #N/A | #N/A | PCE | 0 | #N/A | #N/A | #N/A | #N/A | 0 | #N/A | #N/A | #N/A | #N/A | #N/A | #N/A | #N/A | #N/A
AS-PR0071 | Mini, Bottom Plate Assembly | #N/A | #N/A | #N/A | PCE | Custom Part | #N/A | #N/A | #N/A | #N/A | 0 | #N/A | #N/A | #N/A | #N/A | #N/A | #N/A | #N/A | #N/A
AS-PR0072 | Mini, Double Bearing Holder, Switchside Assembly | 0 | 0 | 0 | PCE | 0 | Packaging | 0.350877 |  | 0 | 0 | Sticker Giant | 0 | 0 | 0 | 0 | 0 | 0 | 0
AS-PR0073 | Mini, Double Bearing Holder, Switchside Insert Assembly | 0 | 0 | 0 | PCE | 0 | Packaging | 0.07 |  | 0 | 0 | The print shop of loveland | 0 | 0 | 0 | 0 | 0 | 0 | 0
AS-PR0074 | Mini, Double Bearing Holder Assembly | #N/A | #N/A | #N/A | PCE | 0 | #N/A | #N/A | #N/A | #N/A | 0 | #N/A | #N/A | #N/A | #N/A | #N/A | #N/A | #N/A | #N/A
AS-PR0075 | Mini, Double Bearing Holder, Non-switchside Insert Assembly | #N/A | #N/A | #N/A | PCE | 0 | #N/A | #N/A | #N/A | #N/A | 0 | #N/A | #N/A | #N/A | #N/A | #N/A | #N/A | #N/A | #N/A
AS-PR0077 | Mini, Y Axis Motor, Damper Pulley Assembly | #N/A | #N/A | #N/A | PCE | 0 | #N/A | #N/A | #N/A | #N/A | 0 | #N/A | #N/A | #N/A | #N/A | #N/A | #N/A | #N/A | #N/A
AS-PR0078 | Mini, Electrical Cover Assembly | #N/A | #N/A | #N/A | PCE | 0 | #N/A | #N/A | #N/A | #N/A | 0 | #N/A | #N/A | #N/A | #N/A | #N/A | #N/A | #N/A | #N/A
AS-PR0079 | Mini, Glass Bed Assembly | #N/A | #N/A | #N/A | PCE | 0 | #N/A | #N/A | #N/A | #N/A | 0 | #N/A | #N/A | #N/A | #N/A | #N/A | #N/A | #N/A | #N/A
AS-PR0080 | Mini, Gladiola, Packaging | #N/A | #N/A | #N/A | PCE | 0 | #N/A | #N/A | #N/A | #N/A | 0 | #N/A | #N/A | #N/A | #N/A | #N/A | #N/A | #N/A | #N/A
AS-PR0082 | Feed Tube Assembly, v3.0 | #N/A | #N/A | #N/A | PCE | 0 | #N/A | #N/A | #N/A | #N/A | 0 | #N/A | #N/A | #N/A | #N/A | #N/A | #N/A | #N/A | #N/A
AS-PR0083 | TAZ, Flexystruder Mount with Inserts Assembly | #N/A | #N/A | #N/A | PCE | 0 | #N/A | #N/A | #N/A | #N/A | 0 | #N/A | #N/A | #N/A | #N/A | #N/A | #N/A | #N/A | #N/A
AS-PR0084 | TAZ5 Y Idler Assembly | #N/A | #N/A | #N/A | PCE | 0 | #N/A | #N/A | #N/A | #N/A | 0 | #N/A | #N/A | #N/A | #N/A | #N/A | #N/A | #N/A | #N/A
AS-PR0085 | Assembled TAZ 6 Y Idler | #N/A | #N/A | #N/A | PCE | 0 | #N/A | #N/A | #N/A | #N/A | 0 | #N/A | #N/A | #N/A | #N/A | #N/A | #N/A | #N/A | #N/A
AS-PR0086 | X Carriage Assembly, Mini 2 | #N/A | #N/A | #N/A | PCE | 0 | #N/A | #N/A | #N/A | #N/A | 0 | #N/A | #N/A | #N/A | #N/A | #N/A | #N/A | #N/A | #N/A
AS-PR0087 | X End Idler Assembly With Inserts and Bushings, Mini 2 | #N/A | #N/A | #N/A | PCE | 0 | #N/A | #N/A | #N/A | #N/A | 0 | #N/A | #N/A | #N/A | #N/A | #N/A | #N/A | #N/A | #N/A
AS-PR0088 | Z Upper Right Assembly, Mini 2 | #N/A | #N/A | #N/A | PCE | 0 | #N/A | #N/A | #N/A | #N/A | 0 | #N/A | #N/A | #N/A | #N/A | #N/A | #N/A | #N/A | #N/A
AS-PR0089 | Z Axis Right Assembly, Mini 2 | #N/A | #N/A | #N/A | PCE | 0 | #N/A | #N/A | #N/A | #N/A | 0 | #N/A | #N/A | #N/A | #N/A | #N/A | #N/A | #N/A | #N/A
AS-PR0090 | X end motor assembly with inserts and bushings, Mini 2 | #N/A | #N/A | #N/A | PCE | 0 | #N/A | #N/A | #N/A | #N/A | 0 | #N/A | #N/A | #N/A | #N/A | #N/A | #N/A | #N/A | #N/A
AS-PR0091 | Z Upper Left Assembly, Mini 2 | #N/A | #N/A | #N/A | PCE | 0 | #N/A | #N/A | #N/A | #N/A | 0 | #N/A | #N/A | #N/A | #N/A | #N/A | #N/A | #N/A | #N/A
AS-PR0092 | Mini, Hibiscus, Final Electrical Assembly | #N/A | #N/A | #N/A | PCE | 0 | #N/A | #N/A | #N/A | #N/A | 0 | #N/A | #N/A | #N/A | #N/A | #N/A | #N/A | #N/A | #N/A
AS-PR0093 | Mini, Hibiscus, Calibrated | #N/A | #N/A | #N/A | PCE | 0 | #N/A | #N/A | #N/A | #N/A | 0 | #N/A | #N/A | #N/A | #N/A | #N/A | #N/A | #N/A | #N/A
AS-PR0094 | X End Motor Assembly, Mini 2 | #N/A | #N/A | #N/A | PCE | 0 | #N/A | #N/A | #N/A | #N/A | 0 | #N/A | #N/A | #N/A | #N/A | #N/A | #N/A | #N/A | #N/A
AS-PR0095 | X End Idler Assembly Mini 2 | #N/A | #N/A | #N/A | PCE | 0 | #N/A | #N/A | #N/A | #N/A | 0 | #N/A | #N/A | #N/A | #N/A | #N/A | #N/A | #N/A | #N/A
AS-PR0096 | X Carriage with Bushing Assembly, Mini 2 | #N/A | #N/A | #N/A | PCE | 0 | #N/A | #N/A | #N/A | #N/A | 0 | #N/A | #N/A | #N/A | #N/A | #N/A | #N/A | #N/A | #N/A
AS-PR0097 | X Bearing Holder Assembly, Mini 2 | #N/A | #N/A | #N/A | PCE | 0 | #N/A | #N/A | #N/A | #N/A | 0 | #N/A | #N/A | #N/A | #N/A | #N/A | #N/A | #N/A | #N/A
AS-PR0098 | Spool Mount Assembly, Mini 2 | #N/A | #N/A | #N/A | PCE | 0 | #N/A | #N/A | #N/A | #N/A | 0 | #N/A | #N/A | #N/A | #N/A | #N/A | #N/A | #N/A | #N/A
AS-PR0099 | Z Axis Left Assembly, Mini 2 | #N/A | #N/A | #N/A | PCE | 0 | #N/A | #N/A | #N/A | #N/A | 0 | #N/A | #N/A | #N/A | #N/A | #N/A | #N/A | #N/A | #N/A
AS-PR0100 | Mini 2 Part Bed Assembly | #N/A | #N/A | #N/A | PCE | 0 | #N/A | #N/A | #N/A | #N/A | 0 | #N/A | #N/A | #N/A | #N/A | #N/A | #N/A | #N/A | #N/A
AS-PR0101 | Mini 2 Final Frame Assembly | #N/A | #N/A | #N/A | PCE | 0 | #N/A | #N/A | #N/A | #N/A | 0 | #N/A | #N/A | #N/A | #N/A | #N/A | #N/A | #N/A | #N/A
AS-PR0102 | Mini 2 Y-axis Assembly | #N/A | #N/A | #N/A | PCE | 0 | #N/A | #N/A | #N/A | #N/A | 0 | #N/A | #N/A | #N/A | #N/A | #N/A | #N/A | #N/A | #N/A
AS-PR0104 | Mini 2 Double Bearing Holder | #N/A | #N/A | #N/A | PCE | 0 | #N/A | #N/A | #N/A | #N/A | 0 | #N/A | #N/A | #N/A | #N/A | #N/A | #N/A | #N/A | #N/A
AS-PR0107 | Mini Spool Arm Assembly, v2 | #N/A | #N/A | #N/A | PCE | 0 | #N/A | #N/A | #N/A | #N/A | 0 | #N/A | #N/A | #N/A | #N/A | #N/A | #N/A | #N/A | #N/A
AS-PR0108 | Filament sample pack | #N/A | #N/A | #N/A | PCE | 0 | #N/A | #N/A | #N/A | #N/A | 0 | #N/A | #N/A | #N/A | #N/A | #N/A | #N/A | #N/A | #N/A
AS-PR0109 | Mini tool sub-kit | #N/A | #N/A | #N/A | PCE | 105 up - 1.25" x 0.375" | #N/A | #N/A | #N/A | #N/A | 0 | #N/A | #N/A | #N/A | #N/A | #N/A | #N/A | #N/A | #N/A
AS-PR0110 | TAZ 6 Controller Box assembly (without external harnesses) | #N/A | #N/A | #N/A | PCE | 0 | #N/A | 0.22833 | #N/A | Sticker Giant | 0 | Sticker Giant | #N/A | #N/A | #N/A | #N/A | #N/A | #N/A | #N/A
AS-PR0111 | Mini 2, Y Axis Rod Mount, Motor Side Assembly | #N/A | #N/A | #N/A | PCE | 0 | #N/A | #N/A | #N/A | #N/A | 0 | #N/A | #N/A | #N/A | #N/A | #N/A | #N/A | #N/A | #N/A
AS-PR0112 | Mini 2, Electrical Cover Assembly | #N/A | #N/A | #N/A | PCE | 0 | #N/A | #N/A | #N/A | #N/A | 0 | #N/A | #N/A | #N/A | #N/A | #N/A | #N/A | #N/A | #N/A
AS-TH0001 | TAZ, Dual Extruder Mount with Inserts Assembly | #N/A | #N/A | #N/A | PCE | 0 | #N/A | #N/A | #N/A | #N/A | 0 | #N/A | #N/A | #N/A | #N/A | #N/A | #N/A | #N/A | #N/A
AS-TH0002 | TAZ, Dual Extruder Flexplate with Inserts Assembly | #N/A | #N/A | #N/A | PCE | 0 | #N/A | #N/A | #N/A | #N/A | 0 | #N/A | #N/A | #N/A | #N/A | #N/A | #N/A | #N/A | #N/A
AS-TH0003 | Large Herringbone, Green with Hob Bolt Assembly | #N/A | #N/A | #N/A | PCE | 0 | #N/A | #N/A | #N/A | #N/A | 0 | #N/A | #N/A | #N/A | #N/A | #N/A | #N/A | #N/A | #N/A
AS-TH0004 | Extruder Idler Block with Bearing Assembly | #N/A | #N/A | #N/A | PCE | 0 | #N/A | #N/A | #N/A | #N/A | 0 | #N/A | #N/A | #N/A | #N/A | #N/A | #N/A | #N/A | #N/A
AS-TH0005 | Extruder Thumb Screw assembly | #N/A | #N/A | #N/A | PCE | 0 | #N/A | #N/A | #N/A | #N/A | 0 | #N/A | #N/A | #N/A | #N/A | #N/A | #N/A | #N/A | #N/A
AS-TH0010 | TAZ, Dual Extruder Assembly | #N/A | #N/A | #N/A | PCE | 0 | #N/A | 0.01791 | Yes | Sticker Giant | 0 | Sticker Giant | #N/A | #N/A | #N/A | #N/A | #N/A | #N/A | #N/A
AS-TH0011 | TAZ, Dual Extruder, Feed Tube Assembly | #N/A | #N/A | #N/A | PCE | S-13121 | #N/A | #N/A | #N/A | #N/A | 0 | #N/A | #N/A | #N/A | #N/A | #N/A | #N/A | #N/A | #N/A
AS-TH0012 | TAZ, Dual Extruder, Spool arm assembly | #N/A | #N/A | #N/A | PCE | 0 | #N/A | #N/A | #N/A | #N/A | 0 | #N/A | #N/A | #N/A | #N/A | #N/A | #N/A | #N/A | #N/A
AS-TH0013 | TAZ, Dual Extruder, Accessory Assembly | #N/A | #N/A | #N/A | PCE | 0 | #N/A | #N/A | #N/A | #N/A | 0 | #N/A | #N/A | #N/A | #N/A | #N/A | #N/A | #N/A | #N/A
AS-TH0014 | TAZ6, Olive Oil, Extruder Assembly | #N/A | #N/A | #N/A | PCE | 0 | #N/A | #N/A | #N/A | #N/A | 0 | #N/A | #N/A | #N/A | #N/A | #N/A | #N/A | #N/A | #N/A
AS-TH0015 | TAZ6, Extruder Mount with Inserts | #N/A | #N/A | #N/A | PCE | 0 | #N/A | #N/A | #N/A | #N/A | 0 | #N/A | #N/A | #N/A | #N/A | #N/A | #N/A | #N/A | #N/A
AS-TH0016 | Extruder Heatsink Fan duct with Insert Assembly | #N/A | #N/A | #N/A | PCE | 0 | #N/A | #N/A | #N/A | #N/A | 0 | #N/A | #N/A | #N/A | #N/A | #N/A | #N/A | #N/A | #N/A
AS-TH0017 | TAZ6, Fan Duct Left | #N/A | #N/A | #N/A | PCE | 0 | #N/A | 0.1258 | #N/A | Sticker Giant | 0 | Sticker Giant | #N/A | #N/A | #N/A | #N/A | #N/A | #N/A | #N/A
AS-TH0018 | TAZ6, Fan Duct Right | #N/A | #N/A | #N/A | Each - OLD | 0 | #N/A | #N/A | #N/A | #N/A | 0 | #N/A | #N/A | #N/A | #N/A | #N/A | #N/A | #N/A | #N/A
AS-TH0019 | TAZ, FlexyDualy_v2, Extruder assembly | #N/A | #N/A | #N/A | PCE | 0 | #N/A | #N/A | #N/A | #N/A | 0 | #N/A | #N/A | #N/A | #N/A | #N/A | #N/A | #N/A | #N/A
AS-TH0020 | Large Herringbone Black Assembly | #N/A | #N/A | #N/A | PCE | 0 | #N/A | #N/A | #N/A | #N/A | 0 | #N/A | #N/A | #N/A | #N/A | #N/A | #N/A | #N/A | #N/A
AS-TH0021 | Flexystruder_v2, Extruder body with PTFE tube | #N/A | #N/A | #N/A | PCE | 0 | #N/A | #N/A | #N/A | #N/A | 0 | #N/A | #N/A | #N/A | #N/A | #N/A | #N/A | #N/A | #N/A
AS-TH0022 | Mini, Gladiola, Extruder Assembly | #N/A | #N/A | #N/A | PCE | 0 | #N/A | #N/A | #N/A | #N/A | 0 | #N/A | #N/A | #N/A | #N/A | #N/A | #N/A | #N/A | #N/A
AS-TH0023 | Mini, Nozzle Fan Mount Complete | #N/A | #N/A | #N/A | PCE | 0 | #N/A | #N/A | #N/A | #N/A | 0 | #N/A | #N/A | #N/A | #N/A | #N/A | #N/A | #N/A | #N/A
AS-TH0025 | Mini, Heat Sink Fan Mount Complete | #N/A | #N/A | #N/A | PCE | 0 | #N/A | #N/A | #N/A | #N/A | 0 | #N/A | #N/A | #N/A | #N/A | #N/A | #N/A | #N/A | #N/A
AS-TH0027 | Mini, Extruder Mount Complete | #N/A | #N/A | #N/A | PCE | 0 | #N/A | #N/A | #N/A | #N/A | 0 | #N/A | #N/A | #N/A | #N/A | #N/A | #N/A | #N/A | #N/A
AS-TH0028 | Beefy idler Assembly, Black | #N/A | #N/A | #N/A | PCE | 0 | #N/A | #N/A | #N/A | #N/A | 0 | #N/A | #N/A | #N/A | #N/A | #N/A | #N/A | #N/A | #N/A
AS-TH0032 | TAZ, MOARstruder, Extruder Assembly | #N/A | #N/A | #N/A | PCE | 0 | #N/A | #N/A | #N/A | #N/A | 0 | #N/A | #N/A | #N/A | #N/A | #N/A | #N/A | #N/A | #N/A
AS-TH0033 | TAZ, MOARstruder Mount with Inserts Assembly | #N/A | #N/A | #N/A | PCE | 0 | #N/A | #N/A | #N/A | #N/A | 0 | #N/A | #N/A | #N/A | #N/A | #N/A | #N/A | #N/A | #N/A
AS-TH0035 | MOARstruder Heat sink Fan duct with Inserts Assembly | #N/A | #N/A | #N/A | PCE | 0 | #N/A | #N/A | #N/A | #N/A | 0 | #N/A | #N/A | #N/A | #N/A | #N/A | #N/A | #N/A | #N/A
AS-TH0036 | MOARstruder Body with Insert Assembly | #N/A | #N/A | #N/A | PCE | 0 | #N/A | #N/A | #N/A | #N/A | 0 | #N/A | #N/A | #N/A | #N/A | #N/A | #N/A | #N/A | #N/A
AS-TH0041 | TAZ, Extruder Fan Mount with Inserts Toolhead V2 | #N/A | #N/A | #N/A | PCE | 0 | #N/A | #N/A | #N/A | #N/A | 0 | #N/A | #N/A | #N/A | #N/A | #N/A | #N/A | #N/A | #N/A
AS-TH0045 | TAZ, Flexystruder v2, Extruder Assembly | #N/A | #N/A | #N/A | PCE | 0 | #N/A | 2.42 | #N/A | Lightning Source | 0 | #N/A | #N/A | #N/A | #N/A | #N/A | #N/A | #N/A | #N/A
AS-TH0046 | Mini, Flexystruder v2 Mount with Inserts Assembly | #N/A | #N/A | #N/A | PCE | 0 | #N/A | #N/A | #N/A | #N/A | 0 | #N/A | #N/A | #N/A | #N/A | #N/A | #N/A | #N/A | #N/A
AS-TH0047 | Mini, Flexystruder v2, Extruder Assembly | #N/A | #N/A | #N/A | PCE | 0 | #N/A | #N/A | #N/A | #N/A | 0 | #N/A | #N/A | #N/A | #N/A | #N/A | #N/A | #N/A | #N/A
AS-TH0048 | TAZ 5 Extruder Mount with Inserts | #N/A | #N/A | #N/A | PCE | 0 | #N/A | #N/A | #N/A | #N/A | 0 | #N/A | #N/A | #N/A | #N/A | #N/A | #N/A | #N/A | #N/A
AS-TH0049 | TAZ 5 Extruder Assembly, 0.5mm | #N/A | #N/A | #N/A | PCE | 0 | #N/A | #N/A | #N/A | #N/A | 0 | #N/A | #N/A | #N/A | #N/A | #N/A | #N/A | #N/A | #N/A
AS-TH0050 | TAZ 5 Extruder Assembly, 0.35mm | #N/A | #N/A | #N/A | PCE | 0 | #N/A | #N/A | #N/A | #N/A | 0 | #N/A | #N/A | #N/A | #N/A | #N/A | #N/A | #N/A | #N/A
AS-TH0051 | Dual Extruder Mount v2 Sub Assembly | #N/A | #N/A | #N/A | PCE | 0 | #N/A | #N/A | #N/A | #N/A | 0 | #N/A | #N/A | #N/A | #N/A | #N/A | #N/A | #N/A | #N/A
AS-TH0052 | TAZ Titan Aero Assembled | #N/A | #N/A | #N/A | PCE | 0 | #N/A | #N/A | #N/A | #N/A | 0 | #N/A | #N/A | #N/A | #N/A | #N/A | #N/A | #N/A | #N/A
AS-TH0053 | Mini Titan Aero Assembled | #N/A | #N/A | #N/A | PCE | 0 | #N/A | #N/A | #N/A | #N/A | 0 | #N/A | #N/A | #N/A | #N/A | #N/A | #N/A | #N/A | #N/A
AS-TH0054 | V3 Dual Extruder Mount with Ducts | #N/A | #N/A | #N/A | PCE | 0 | #N/A | #N/A | #N/A | #N/A | 0 | #N/A | #N/A | #N/A | #N/A | #N/A | #N/A | #N/A | #N/A
AS-TH0055 | TAZ Dual V3 Extruder Body Assembly | #N/A | #N/A | #N/A | PCE | 0 | #N/A | #N/A | #N/A | #N/A | 0 | #N/A | #N/A | #N/A | #N/A | #N/A | #N/A | #N/A | #N/A
AS-TH0056 | TAZ Dual V3 Assembly | #N/A | #N/A | #N/A | PCE | 0 | #N/A | #N/A | #N/A | #N/A | 0 | #N/A | #N/A | #N/A | #N/A | #N/A | #N/A | #N/A | #N/A
AS-TH0057 | TAZ Aero Motor with Gear Assembly | #N/A | #N/A | #N/A | PCE | 0 | #N/A | #N/A | #N/A | #N/A | 0 | #N/A | #N/A | #N/A | #N/A | #N/A | #N/A | #N/A | #N/A
AS-TH0058 | TAZ Aero Blower Shroud Assembly | #N/A | #N/A | #N/A | PCE | 0 | #N/A | #N/A | #N/A | #N/A | 0 | #N/A | #N/A | #N/A | #N/A | #N/A | #N/A | #N/A | #N/A
AS-TH0059 | TAZ AeroStruder Assembly | #N/A | #N/A | #N/A | PCE | 0 | #N/A | #N/A | #N/A | #N/A | 0 | #N/A | #N/A | #N/A | #N/A | #N/A | #N/A | #N/A | #N/A
AS-TH0060 | Mini Aero Motor with Gear Assembly | #N/A | #N/A | #N/A | PCE | 0 | #N/A | #N/A | #N/A | #N/A | 0 | #N/A | #N/A | #N/A | #N/A | #N/A | #N/A | #N/A | #N/A
AS-TH0061 | Mini AeroStruder Assembly | #N/A | #N/A | #N/A | PCE | 0 | #N/A | #N/A | #N/A | #N/A | 0 | #N/A | #N/A | #N/A | #N/A | #N/A | #N/A | #N/A | #N/A
AS-TH0063 | TAZ Dual V3 Front Bearing Housing with Bearings | #N/A | #N/A | #N/A | PCE | 0 | #N/A | #N/A | #N/A | #N/A | 0 | #N/A | #N/A | #N/A | #N/A | #N/A | #N/A | #N/A | #N/A
AS-TH0066 | Titan Aero Assembly, Mini 2 | #N/A | #N/A | #N/A | PCE | 0 | #N/A | #N/A | #N/A | #N/A | 0 | #N/A | #N/A | #N/A | #N/A | #N/A | #N/A | #N/A | #N/A
AS-TH0067 | V3 Thumbscrew Assembly | #N/A | #N/A | #N/A | PCE | 0 | #N/A | #N/A | #N/A | #N/A | 0 | #N/A | #N/A | #N/A | #N/A | #N/A | #N/A | #N/A | #N/A
DC-LB0001 | Label, Lulzbot AO-101 Barcode label | #N/A | #N/A | #N/A | PCE | 0 | #N/A | #N/A | #N/A | #N/A | 0 | #N/A | #N/A | #N/A | #N/A | #N/A | #N/A | #N/A | #N/A
DC-LB0002 | Label, LulzBot AO-100 Barcode | #N/A | #N/A | #N/A | PCE | 0 | #N/A | #N/A | #N/A | #N/A | 0 | #N/A | #N/A | #N/A | #N/A | #N/A | #N/A | #N/A | #N/A
DC-LB0003 | Label, Hobbed Bolt | #N/A | #N/A | #N/A | PCE | 0 | #N/A | #N/A | #N/A | #N/A | 0 | #N/A | #N/A | #N/A | #N/A | #N/A | #N/A | #N/A | #N/A
DC-LB0004 | Label, Budaschnozzle 1.1 threaded extension | #N/A | #N/A | #N/A | PCE | 0 | #N/A | #N/A | #N/A | #N/A | 0 | #N/A | #N/A | #N/A | #N/A | #N/A | #N/A | #N/A | #N/A
DC-LB0005 | 2 x 2" D.O.T. Labels - "Right to Know" | #N/A | #N/A | #N/A | PCE | 0 | #N/A | #N/A | #N/A | #N/A | 0 | #N/A | #N/A | #N/A | #N/A | #N/A | #N/A | #N/A | #N/A
DC-LB0006 | Label, Lulzbot TAZ 2.0 Barcode | #N/A | #N/A | #N/A | PCE | 0 | #N/A | #N/A | #N/A | #N/A | 0 | #N/A | #N/A | #N/A | #N/A | #N/A | #N/A | #N/A | #N/A
DC-LB0007 | Label, Top of Box | #N/A | #N/A | #N/A | PCE | 0 | #N/A | #N/A | #N/A | #N/A | 0 | #N/A | #N/A | #N/A | #N/A | #N/A | #N/A | #N/A | #N/A
DC-LB0008 | 2 x 2" D.O.T. Labels - "Right to Know", single label | #N/A | #N/A | #N/A | PCE | 0 | #N/A | #N/A | #N/A | #N/A | 0 | #N/A | #N/A | #N/A | #N/A | #N/A | #N/A | #N/A | #N/A
DC-LB0009 | 1", "Made In USA" Labels 500/roll | #N/A | #N/A | #N/A | PCE | 0 | #N/A | #N/A | #N/A | #N/A | 0 | #N/A | #N/A | #N/A | #N/A | #N/A | #N/A | #N/A | #N/A
DC-LB0010 | 3X5 DELICATE INSTRUMENTS LBL 500/RL | #N/A | #N/A | #N/A | PCE | 0 | #N/A | #N/A | #N/A | #N/A | 0 | #N/A | #N/A | #N/A | #N/A | #N/A | #N/A | #N/A | #N/A
DC-LB0011 | Flame Labels - "Hot", 1 1⁄2 x 2" | #N/A | #N/A | #N/A | PCE | 0 | #N/A | #N/A | #N/A | #N/A | 0 | #N/A | #N/A | #N/A | #N/A | #N/A | #N/A | #N/A | #N/A
DC-LB0012 | 14035T23 Hazardous Material Sign, NFPA Diamond Style, 5" X5", Adhesive-Backed Vinyl | 0 | 0 | 0 | PCE | 0 | Packaging | 0.18 |  | 0 | 0 | The print shop of loveland | 0 | 0 | 0 | 0 | 0 | 0 | 0
DC-LB0013 | Hazardous Material Sign, NFPA Diamond, 10-1/2" x 10-1/2", Adhesive-Back Vinyl | 0 | 0 | 0 | PCE | 0 | Packaging | 0.11 |  | 0 | 0 | The print shop of loveland | 0 | 0 | 0 | 0 | 0 | 0 | 0
DC-LB0014 | TAZ v3.1 serial number sticker | 0 | 0 | 0 | PCE | 0 | Packaging | 0.75 |  | 0 | 0 | The print shop of loveland | 0 | 0 | 0 | 0 | 0 | 0 | 0
DC-LB0015 | 24VDC sticker | 0 | 0 | 0 | PCE | 0 | Packaging | 0.07 |  | 0 | 0 | The print shop of loveland | 0 | 0 | 0 | 0 | 0 | 0 | 0
DC-LB0016 | TAZ v3.1 bar code and serial number sticker | 0 | 0 | 0 | PCE | 0 | Packaging | 0.95 |  | 0 | 0 | The Print shop of Loveland | 0 | 0 | 0 | 0 | 0 | 0 | 0
DC-LB0017 | Label, Extruder E-Step Number, Avery 1/2 x 3/4 | 0 | 0 | 0 | PCE | 0 | Packaging | 0.11 |  | 0 | 0 | The print shop of loveland | 0 | 0 | 0 | 0 | 0 | 0 | 0
DC-LB0018 | TAZ v4.0 serial number sticker | #N/A | #N/A | #N/A | PCE | 0 | #N/A | #N/A | #N/A | #N/A | 0 | #N/A | #N/A | #N/A | #N/A | #N/A | #N/A | #N/A | #N/A
DC-LB0019 | Label, 12VDC Extrusion Fan | #N/A | #N/A | #N/A | PCE | 0 | #N/A | #N/A | #N/A | #N/A | 0 | #N/A | #N/A | #N/A | #N/A | #N/A | #N/A | #N/A | #N/A
DC-LB0020 | Label, 24VDC Extrusion Fan | #N/A | #N/A | #N/A | PCE | 0 | #N/A | #N/A | #N/A | #N/A | 0 | #N/A | #N/A | #N/A | #N/A | #N/A | #N/A | #N/A | #N/A
DC-LB0021 | 1" Circle Inventory Control Labels - "Inspected by _____" roll 500 | #N/A | #N/A | #N/A | PCE | 0 | #N/A | #N/A | #N/A | #N/A | 0 | #N/A | #N/A | #N/A | #N/A | #N/A | #N/A | #N/A | #N/A
DC-LB0022 | 2" Circle Inventory Control Labels - "QC Rejected" roll 500 | #N/A | #N/A | #N/A | PCE | 0 | #N/A | #N/A | #N/A | #N/A | 0 | #N/A | #N/A | #N/A | #N/A | #N/A | #N/A | #N/A | #N/A
DC-LB0023 | 1" Circle Inventory Control Labels - "QC Passed" Roll 500 | #N/A | #N/A | #N/A | PCE | 0 | #N/A | #N/A | #N/A | #N/A | 0 | #N/A | #N/A | #N/A | #N/A | #N/A | #N/A | #N/A | #N/A
DC-LB0024 | Label, Bottom of Box | #N/A | #N/A | #N/A | PCE | 0 | #N/A | #N/A | #N/A | #N/A | 0 | #N/A | #N/A | #N/A | #N/A | #N/A | #N/A | #N/A | #N/A
DC-LB0025 | TAZ v4.1 serial number sticker | #N/A | #N/A | #N/A | PCE | 0 | #N/A | #N/A | #N/A | #N/A | 0 | #N/A | #N/A | #N/A | #N/A | #N/A | #N/A | #N/A | #N/A
DC-LB0026 | Label, Lulzbot TAZ 4.1 Barcode | #N/A | #N/A | #N/A | PCE | 0 | #N/A | #N/A | #N/A | #N/A | 0 | #N/A | #N/A | #N/A | #N/A | #N/A | #N/A | #N/A | #N/A
DC-LB0027 | KITTAZ Labels Complete Set | #N/A | #N/A | #N/A | PCE | DC-MS0043 | #N/A | #N/A | #N/A | #N/A | 0 | #N/A | #N/A | #N/A | #N/A | #N/A | #N/A | #N/A | #N/A
DC-LB0028 | Label, Lulzbot Mini Barcode | #N/A | #N/A | #N/A | PCE | 0 | #N/A | #N/A | #N/A | #N/A | 0 | #N/A | #N/A | #N/A | #N/A | #N/A | #N/A | #N/A | #N/A
DC-LB0029 | Mini v1 serial number sticker | #N/A | #N/A | #N/A | PCE | 0 | #N/A | #N/A | #N/A | #N/A | 0 | #N/A | #N/A | #N/A | #N/A | #N/A | #N/A | #N/A | #N/A
DC-LB0030 | "CE" Regulated Label - 1 x 1" | #N/A | #N/A | #N/A | PCE | 0 | #N/A | #N/A | #N/A | #N/A | 0 | #N/A | #N/A | #N/A | #N/A | #N/A | #N/A | #N/A | #N/A
DC-LB0031 | TAZ v5.0 serial number sticker, KT-PR0017NA | #N/A | #N/A | #N/A | PCE | 0 | #N/A | #N/A | #N/A | #N/A | 0 | #N/A | #N/A | #N/A | #N/A | #N/A | #N/A | #N/A | #N/A
DC-LB0032 | Label, Lulzbot TAZ 5.0 Barcode, KT-PR0017NA | #N/A | #N/A | #N/A | PCE | 0 | #N/A | #N/A | #N/A | #N/A | 0 | #N/A | #N/A | #N/A | #N/A | #N/A | #N/A | #N/A | #N/A
DC-LB0033 | TAZ v5.0 serial number sticker, KT-PR0017EU | #N/A | #N/A | #N/A | PCE | 0 | #N/A | #N/A | #N/A | #N/A | 0 | #N/A | #N/A | #N/A | #N/A | #N/A | #N/A | #N/A | #N/A
DC-LB0034 | Label, Lulzbot TAZ 5.0 Barcode, KT-PR0017EU | #N/A | #N/A | #N/A | PCE | 0 | #N/A | #N/A | #N/A | #N/A | 0 | #N/A | #N/A | #N/A | #N/A | #N/A | #N/A | #N/A | #N/A
DC-LB0035 | TAZ v5.0 serial number sticker, KT-PR0017AU | #N/A | #N/A | #N/A | PCE | 0 | #N/A | #N/A | #N/A | #N/A | 0 | #N/A | #N/A | #N/A | #N/A | #N/A | #N/A | #N/A | #N/A
DC-LB0036 | Label, Lulzbot TAZ 5.0 Barcode, KT-PR0017AU | #N/A | #N/A | #N/A | PCE | 0 | #N/A | #N/A | #N/A | #N/A | 0 | #N/A | #N/A | #N/A | #N/A | #N/A | #N/A | #N/A | #N/A
DC-LB0037 | FCC Sticker, Blank | #N/A | #N/A | #N/A | PCE | 0 | #N/A | #N/A | #N/A | #N/A | 0 | #N/A | #N/A | #N/A | #N/A | #N/A | #N/A | #N/A | #N/A
DC-LB0038 | FCC Sticker, KT-PR0035-**** | #N/A | #N/A | #N/A | PCE | 0 | #N/A | #N/A | #N/A | #N/A | 0 | #N/A | #N/A | #N/A | #N/A | #N/A | #N/A | #N/A | #N/A
DC-LB0039 | Label, LulzBot TAZ Single Extruder Tool Head v2, 0.35 Nozzle | #N/A | #N/A | #N/A | PCE | 0 | #N/A | #N/A | #N/A | #N/A | 0 | #N/A | #N/A | #N/A | #N/A | #N/A | #N/A | #N/A | #N/A
DC-LB0040 | Label, Lulzbot Mini Barcode, NA | #N/A | #N/A | #N/A | PCE | 0 | #N/A | #N/A | #N/A | #N/A | 0 | #N/A | #N/A | #N/A | #N/A | #N/A | #N/A | #N/A | #N/A
DC-LB0041 | Label, Lulzbot Mini Barcode, EU | #N/A | #N/A | #N/A | PCE | 0 | #N/A | #N/A | #N/A | #N/A | 0 | #N/A | #N/A | #N/A | #N/A | #N/A | #N/A | #N/A | #N/A
DC-LB0042 | Label, Lulzbot Mini Barcode, AU | #N/A | #N/A | #N/A | PCE | ALE-0000133 | #N/A | #N/A | #N/A | #N/A | 0 | #N/A | #N/A | #N/A | #N/A | #N/A | #N/A | #N/A | #N/A
DC-LB0043 | Mini v1 serial number sticker, NA | #N/A | #N/A | #N/A | PCE | ALE-0000132 | #N/A | #N/A | #N/A | #N/A | 0 | #N/A | #N/A | #N/A | #N/A | #N/A | #N/A | #N/A | #N/A
DC-LB0044 | Mini v1 serial number sticker, EU | #N/A | #N/A | #N/A | PCE | 5441 | #N/A | #N/A | #N/A | #N/A | 0 | #N/A | #N/A | #N/A | #N/A | #N/A | #N/A | #N/A | #N/A
DC-LB0045 | Mini v1 serial number sticker, AU | #N/A | #N/A | #N/A | PCE | 5445 | #N/A | #N/A | #N/A | #N/A | 0 | #N/A | #N/A | #N/A | #N/A | #N/A | #N/A | #N/A | #N/A
DC-LB0046 | FCC-CE-RSF-Colorado Made 3" x 3" B&W Sticker | #N/A | #N/A | #N/A | PCE | 5436 | #N/A | #N/A | #N/A | #N/A | 0 | #N/A | #N/A | #N/A | #N/A | #N/A | #N/A | #N/A | #N/A
DC-LB0047 | TAZ v5.0 serial number sticker, KT-PR0036NA | #N/A | #N/A | #N/A | PCE | 5440 | #N/A | #N/A | #N/A | #N/A | 0 | #N/A | #N/A | #N/A | #N/A | #N/A | #N/A | #N/A | #N/A
DC-LB0048 | Label, Lulzbot TAZ 5.0 Barcode, KT-PR0036NA | #N/A | #N/A | #N/A | PCE | 5442 | #N/A | #N/A | #N/A | #N/A | 0 | #N/A | #N/A | #N/A | #N/A | #N/A | #N/A | #N/A | #N/A
DC-LB0049 | TAZ v5.0 serial number sticker, KT-PR0036EU | #N/A | #N/A | #N/A | PCE | 5437 | #N/A | #N/A | #N/A | #N/A | 0 | #N/A | #N/A | #N/A | #N/A | #N/A | #N/A | #N/A | #N/A
DC-LB0050 | Label, Lulzbot TAZ 5.0 Barcode, KT-PR0036EU | #N/A | #N/A | #N/A | PCE | 5443 | #N/A | #N/A | #N/A | #N/A | 0 | #N/A | #N/A | #N/A | #N/A | #N/A | #N/A | #N/A | #N/A
DC-LB0051 | TAZ v5.0 serial number sticker, KT-PR0036AU | #N/A | #N/A | #N/A | PCE | 5439 | #N/A | #N/A | #N/A | #N/A | 0 | #N/A | #N/A | #N/A | #N/A | #N/A | #N/A | #N/A | #N/A
DC-LB0052 | Label, Lulzbot TAZ 5.0 Barcode, KT-PR0036AU | #N/A | #N/A | #N/A | PCE | 5449 | #N/A | #N/A | #N/A | #N/A | 0 | #N/A | #N/A | #N/A | #N/A | #N/A | #N/A | #N/A | #N/A
DC-LB0053 | Label, LulzBot TAZ Flexystruder Tool Head v2, 0.6 Nozzle | #N/A | #N/A | #N/A | PCE | 0 | #N/A | #N/A | #N/A | #N/A | 0 | #N/A | #N/A | #N/A | #N/A | #N/A | #N/A | #N/A | #N/A
DC-LB0054 | TAZ v5.0 serial number sticker, KT-PR0036NA | #N/A | #N/A | #N/A | PCE | 482038 | #N/A | #N/A | #N/A | #N/A | 0 | #N/A | #N/A | #N/A | #N/A | #N/A | #N/A | #N/A | #N/A
DC-LB0055 | Label, Lulzbot TAZ 5.0 Barcode, KT-PR0036NA | #N/A | #N/A | #N/A | PCE | 51935 | #N/A | #N/A | #N/A | #N/A | 0 | #N/A | #N/A | #N/A | #N/A | #N/A | #N/A | #N/A | #N/A
DC-LB0056 | TAZ v5.0 serial number sticker, KT-PR0036EU | #N/A | #N/A | #N/A | PCE | 284410 | #N/A | #N/A | #N/A | #N/A | 0 | #N/A | #N/A | #N/A | #N/A | #N/A | #N/A | #N/A | #N/A
DC-LB0057 | Label, Lulzbot TAZ 5.0 Barcode, KT-PR0036EU | #N/A | #N/A | #N/A | ft | 517-3517/10 | #N/A | #N/A | #N/A | #N/A | 0 | #N/A | #N/A | #N/A | #N/A | #N/A | #N/A | #N/A | #N/A
DC-LB0058 | TAZ v5.0 serial number sticker, KT-PR0036AU | #N/A | #N/A | #N/A | PCE | 517-3517/10 | #N/A | #N/A | #N/A | #N/A | 0 | #N/A | #N/A | #N/A | #N/A | #N/A | #N/A | #N/A | #N/A
DC-LB0059 | Label, Lulzbot TAZ 5.0 Barcode, KT-PR0036AU | #N/A | #N/A | #N/A | PCE | 0 | #N/A | #N/A | #N/A | #N/A | 0 | #N/A | #N/A | #N/A | #N/A | #N/A | #N/A | #N/A | #N/A
DC-LB0060 | Tool head ID label, TAZ 5 0.5mm Nozzle | #N/A | #N/A | #N/A | PCE | 0 | #N/A | #N/A | #N/A | #N/A | 0 | #N/A | #N/A | #N/A | #N/A | #N/A | #N/A | #N/A | #N/A
DC-LB0061 | FCC_CE_ROHS_OSHW_RYF_CO_Made_Sticker_4" x3" | #N/A | #N/A | #N/A | PCE | 0 | #N/A | #N/A | #N/A | #N/A | 0 | #N/A | #N/A | #N/A | #N/A | #N/A | #N/A | #N/A | #N/A
DC-LB0062 | Clam Knife Sheath Sticker - Caution Sharp Blade! (1"x2.5" Rectangle) | #N/A | #N/A | #N/A | PCE | 0 | #N/A | #N/A | #N/A | #N/A | 0 | #N/A | #N/A | #N/A | #N/A | #N/A | #N/A | #N/A | #N/A
DC-LB0063 | Modification Warning Insert Modification 2.75 x 8.5 on 100 lb. Astrobright Lift Off Lemon Very Bright | #N/A | #N/A | #N/A | PCE | B003L1ZYYM | #N/A | #N/A | #N/A | #N/A | 0 | #N/A | #N/A | #N/A | #N/A | #N/A | #N/A | #N/A | #N/A
DC-LB0064 | Hexagon Hot End Retail Box Label | #N/A | #N/A | #N/A | PCE | 8818542 | #N/A | #N/A | #N/A | #N/A | 0 | #N/A | #N/A | #N/A | #N/A | #N/A | #N/A | #N/A | #N/A
DC-LB0065 | Hexagon Hot End Retail Box Label, 0.35mm | #N/A | #N/A | #N/A | PCE | 9432 | #N/A | #N/A | #N/A | #N/A | 0 | #N/A | #N/A | #N/A | #N/A | #N/A | #N/A | #N/A | #N/A
DC-LB0066 | Hexagon Hot End Retail Box Label, 0.50mm | #N/A | #N/A | #N/A | PCE | 2132 | #N/A | #N/A | #N/A | #N/A | 0 | #N/A | #N/A | #N/A | #N/A | #N/A | #N/A | #N/A | #N/A
DC-LB0067 | Hexagon Hot End Retail Box Label, 0.60mm | #N/A | #N/A | #N/A | PCE | 2139 | #N/A | #N/A | #N/A | #N/A | 0 | #N/A | #N/A | #N/A | #N/A | #N/A | #N/A | #N/A | #N/A
DC-LB0068 | Label, LulzBot TAZ Flexystruder Tool Head v2c, 0.6 Nozzle, Front | #N/A | #N/A | #N/A | PCE | 2145 | #N/A | #N/A | #N/A | #N/A | 0 | #N/A | #N/A | #N/A | #N/A | #N/A | #N/A | #N/A | #N/A
DC-LB0069 | Label, LulzBot TAZ Flexystruder Tool Head v2c, 0.6 Nozzle, Back | #N/A | #N/A | #N/A | PCE | 4984 | #N/A | #N/A | #N/A | #N/A | 0 | #N/A | #N/A | #N/A | #N/A | #N/A | #N/A | #N/A | #N/A
DC-LB0070 | Label, LulzBot Mini Flexystruder Tool Head v2, 0.6 Nozzle, Front | #N/A | #N/A | #N/A | PCE | 2151 | #N/A | #N/A | #N/A | #N/A | 0 | #N/A | #N/A | #N/A | #N/A | #N/A | #N/A | #N/A | #N/A
DC-LB0071 | Label, LulzBot Mini Flexystruder Tool Head v2, 0.6 Nozzle, Back | #N/A | #N/A | #N/A | PCE | 3384 | #N/A | #N/A | #N/A | #N/A | 0 | #N/A | #N/A | #N/A | #N/A | #N/A | #N/A | #N/A | #N/A
DC-LB0072 | Label, LulzBot TAZ Dual Extruder Tool Head v2c, 0.5 Nozzle, Front | 0 | 0 | 0 | PCE | 5279 | Electronic | 1.1 |  | 0 | 0 | Linvox | 5279 | 0 | 0 | 0 | 0 | 0 | 0
DC-LB0073 | Label, LulzBot TAZ Dual Extruder Tool Head v2c, 0.5 Nozzle, Back | 0 | 0 | 0 | PCE | 7691 | Electronic | 1.98 |  | 0 | 0 | Linvox | 7691 |  | 0 | 0 | 0 | 0 | 0
DC-LB0074 | Label, LulzBot TAZ FlexyDually Tool Head v2c, 0.6 Nozzle, Front | 0 | 0 | 0 | PCE | 7692 | Electronic | 1.25 |  | 0 | 0 | Linvox | 7692 |  | 0 | 0 | 0 | 0 | 0
DC-LB0075 | Label, LulzBot TAZ FlexyDually Tool Head v2c, 0.6 Nozzle, Back | #N/A | #N/A | #N/A | PCE | 5280 | #N/A | #N/A | #N/A | #N/A | 0 | #N/A | #N/A | #N/A | #N/A | #N/A | #N/A | #N/A | #N/A
DC-LB0076 | LulzBot Mini Flexystruder v2 Serial Number Label | #N/A | #N/A | #N/A | PCE | 5281 | #N/A | #N/A | #N/A | #N/A | 0 | #N/A | #N/A | #N/A | #N/A | #N/A | #N/A | #N/A | #N/A
DC-LB0077 | Tool head ID label, TAZ 5 0.35mm Nozzle | #N/A | #N/A | #N/A | PCE | T3008-152-ND | #N/A | #N/A | #N/A | #N/A | 0 | #N/A | #N/A | #N/A | #N/A | #N/A | #N/A | #N/A | #N/A
DC-LB0078 | Label, LulzBot TAZ Single Extruder Tool Head v2c, 0.5 Nozzle, Front | #N/A | #N/A | #N/A | PCE | 0 | #N/A | #N/A | #N/A | #N/A | 0 | #N/A | #N/A | #N/A | #N/A | #N/A | #N/A | #N/A | #N/A
DC-LB0079 | Label, LulzBot TAZ Single Extruder Tool Head v2c, 0.5 Nozzle, Back | #N/A | #N/A | #N/A | PCE | 0 | #N/A | #N/A | #N/A | #N/A | 0 | #N/A | #N/A | #N/A | #N/A | #N/A | #N/A | #N/A | #N/A
DC-LB0080 | Label, LulzBot TAZ Single Extruder Tool Head v2c, 0.35 Nozzle, Front | #N/A | #N/A | #N/A | PCE | 0 | #N/A | #N/A | #N/A | #N/A | 0 | #N/A | #N/A | #N/A | #N/A | #N/A | #N/A | #N/A | #N/A
DC-LB0081 | Label, LulzBot TAZ Single Extruder Tool Head v2c, 0.35 Nozzle, Back | #N/A | #N/A | #N/A | PCE | 0 | #N/A | #N/A | #N/A | #N/A | 0 | #N/A | #N/A | #N/A | #N/A | #N/A | #N/A | #N/A | #N/A
DC-LB0082 | LulzBot TAZ Flexystruder v2 Serial Number Label | #N/A | #N/A | #N/A | PCE | 0 | #N/A | #N/A | #N/A | #N/A | 0 | #N/A | #N/A | #N/A | #N/A | #N/A | #N/A | #N/A | #N/A
DC-LB0083 | LulzBot TAZ Dual Extruder v2 Serial Number Label | #N/A | #N/A | #N/A | PCE | 0 | #N/A | #N/A | #N/A | #N/A | 0 | #N/A | #N/A | #N/A | #N/A | #N/A | #N/A | #N/A | #N/A
DC-LB0084 | LulzBot TAZ FlexyDually v2 Serial Number Label | #N/A | #N/A | #N/A | PCE | 0 | #N/A | #N/A | #N/A | #N/A | 0 | #N/A | #N/A | #N/A | #N/A | #N/A | #N/A | #N/A | #N/A
DC-LB0085 | LulzBot TAZ Single Extruder 0.50noz v2c Serial Number Label | #N/A | #N/A | #N/A | PCE | 909-CABLE-IDC40-15CM | #N/A | #N/A | #N/A | #N/A | 0 | #N/A | #N/A | #N/A | #N/A | #N/A | #N/A | #N/A | #N/A
DC-LB0086 | LulzBot TAZ Single Extruder 0.35noz v2c Serial Number Label | #N/A | #N/A | #N/A | PCE | 1188-1018-ND | #N/A | #N/A | #N/A | #N/A | 0 | #N/A | #N/A | #N/A | #N/A | #N/A | #N/A | #N/A | #N/A
DC-LB0087 | Lulzbot Mini topper "sign for Micro Center" | #N/A | #N/A | #N/A | PCE | 5137 | #N/A | #N/A | #N/A | #N/A | 0 | #N/A | #N/A | #N/A | #N/A | #N/A | #N/A | #N/A | #N/A
DC-LB0088 | Lulzbot Taz 5, "sign for Micro Center" | #N/A | #N/A | #N/A | PCE | 908 | #N/A | #N/A | #N/A | #N/A | 0 | #N/A | #N/A | #N/A | #N/A | #N/A | #N/A | #N/A | #N/A
DC-LB0089 | Lulzbot ticket molding "for Micro Center" | #N/A | #N/A | #N/A | PCE | 909 | #N/A | #N/A | #N/A | #N/A | 0 | #N/A | #N/A | #N/A | #N/A | #N/A | #N/A | #N/A | #N/A
DC-LB0090 | Lulzbot Channel strip "for Micro Center" | #N/A | #N/A | #N/A | PCE | 3872 | #N/A | #N/A | #N/A | #N/A | 0 | #N/A | #N/A | #N/A | #N/A | #N/A | #N/A | #N/A | #N/A
DC-LB0091 | Lulzbot Mini Fact Tag "for Micro Center" | #N/A | #N/A | #N/A | PCE | SERCAB_PCDUINO_O29 | #N/A | #N/A | #N/A | #N/A | 0 | #N/A | #N/A | #N/A | #N/A | #N/A | #N/A | #N/A | #N/A
DC-LB0092 | Lulzbot Taz 5 Fact Tag "for Micro Center" | #N/A | #N/A | #N/A | PCE | 3344 | #N/A | #N/A | #N/A | #N/A | 0 | #N/A | #N/A | #N/A | #N/A | #N/A | #N/A | #N/A | #N/A
DC-LB0093 | RCM certified for sales in Australia | #N/A | #N/A | #N/A | PCE | 3345 | #N/A | #N/A | #N/A | #N/A | 0 | #N/A | #N/A | #N/A | #N/A | #N/A | #N/A | #N/A | #N/A
DC-LB0094 | Serial number label sheets (blank) 100/pk 105 up - 1.25" x 0.375" | #N/A | #N/A | #N/A | PCE | 3659 | #N/A | #N/A | #N/A | #N/A | 0 | #N/A | #N/A | #N/A | #N/A | #N/A | #N/A | #N/A | #N/A
DC-LB0095 | LulzBot Logo Sticker, 3 - Inch | #N/A | #N/A | #N/A | PCE | AE40A-25-ND | #N/A | #N/A | #N/A | #N/A | 0 | #N/A | #N/A | #N/A | #N/A | #N/A | #N/A | #N/A | #N/A
DC-LB0096 | Tool head ID label, Mini 0.5mm Nozzle | #N/A | #N/A | #N/A | PCE | RFQ442 | #N/A | #N/A | #N/A | #N/A | 0 | #N/A | #N/A | #N/A | #N/A | #N/A | #N/A | #N/A | #N/A
DC-LB0097 | TAZ v6.0 serial number sticker, KT-PR0041NA | #N/A | #N/A | #N/A | PCE | 11381 | #N/A | #N/A | #N/A | #N/A | 0 | #N/A | #N/A | #N/A | #N/A | #N/A | #N/A | #N/A | #N/A
DC-LB0098 | Label, Lulzbot TAZ 6.0 Barcode, KT-PR0041NA | #N/A | #N/A | #N/A | PCE | 7670 | #N/A | #N/A | #N/A | #N/A | 0 | #N/A | #N/A | #N/A | #N/A | #N/A | #N/A | #N/A | #N/A
DC-LB0099 | TAZ v6.0 serial number sticker, KT-PR0041EU | #N/A | #N/A | #N/A | PCE | ACX17236-ND | #N/A | #N/A | #N/A | #N/A | 0 | #N/A | #N/A | #N/A | #N/A | #N/A | #N/A | #N/A | #N/A
DC-LB0100 | Label, Lulzbot TAZ 6.0 Barcode, KT-PR0041EU | #N/A | #N/A | #N/A | PCE | 110A | #N/A | #N/A | #N/A | #N/A | 0 | #N/A | #N/A | #N/A | #N/A | #N/A | #N/A | #N/A | #N/A
DC-LB0101 | TAZ v6.0 serial number sticker, KT-PR0041AU | #N/A | #N/A | #N/A | PCE | 290-1012-ND | #N/A | #N/A | #N/A | #N/A | 0 | #N/A | #N/A | #N/A | #N/A | #N/A | #N/A | #N/A | #N/A
DC-LB0102 | Label, Lulzbot TAZ 6.0 Barcode, KT-PR0041AU | #N/A | #N/A | #N/A | PCE | 9581T21 | #N/A | #N/A | #N/A | #N/A | 0 | #N/A | #N/A | #N/A | #N/A | #N/A | #N/A | #N/A | #N/A
DC-LB0104 | Tool Head Wiring Connector Alignment Label | #N/A | #N/A | #N/A | PCE | 5388K14 | #N/A | #N/A | #N/A | #N/A | 0 | #N/A | #N/A | #N/A | #N/A | #N/A | #N/A | #N/A | #N/A
DC-LB0105 | Arrow Labels - Yellow, 1 x 3" 500/roll | Y | 0 | 0 | PCE | U023-006 | Electronic | 2.89 |  | 0 | U023-006 | EDC (Electronics Distributors Corp. | Tripplite U023-006 | 0 | 0 | 0 | 0 | 0 | 0
DC-LB0106 | TAZ 6 Inner Box Label #1 Contents | #N/A | #N/A | #N/A | PCE | C1352-50-ND | #N/A | #N/A | #N/A | #N/A | 0 | #N/A | #N/A | #N/A | #N/A | #N/A | #N/A | #N/A | #N/A
DC-LB0107 | TAZ 6 Inner Box Label #2, Contents | #N/A | #N/A | #N/A | PCE | 11559 | #N/A | #N/A | #N/A | #N/A | 0 | #N/A | #N/A | #N/A | #N/A | #N/A | #N/A | #N/A | #N/A
DC-LB0108 | Filament Samples Bag Label - TAZ 6 | #N/A | #N/A | #N/A | PCE | 3391 | #N/A | #N/A | #N/A | #N/A | 0 | #N/A | #N/A | #N/A | #N/A | #N/A | #N/A | #N/A | #N/A
DC-LB0109 | Label, LulzBot TAZ Opah Tool Head v2c, 1.2 Nozzle, Front | #N/A | #N/A | #N/A | PCE | N82E16812422007 | #N/A | #N/A | #N/A | #N/A | 0 | #N/A | #N/A | #N/A | #N/A | #N/A | #N/A | #N/A | #N/A
DC-LB0110 | Label, LulzBot TAZ Opah Tool Head v2c, 1.2 Nozzle, Back | #N/A | #N/A | #N/A | PCE | B00GCG94WG | #N/A | #N/A | #N/A | #N/A | 0 | #N/A | #N/A | #N/A | #N/A | #N/A | #N/A | #N/A | #N/A
DC-LB0111 | Filament Samples Bag Label - Mini | #N/A | #N/A | #N/A | PCE | 5460 | #N/A | #N/A | #N/A | #N/A | 0 | #N/A | #N/A | #N/A | #N/A | #N/A | #N/A | #N/A | #N/A
DC-LB0112 | Calibration Label, Self-Adhesive Polyester, Height: 1/2" x Width: 1", 350 PK | #N/A | #N/A | #N/A | PCE | 5450 | #N/A | #N/A | #N/A | #N/A | 0 | #N/A | #N/A | #N/A | #N/A | #N/A | #N/A | #N/A | #N/A
DC-LB0113 | Inventory Control Labels - "Quarantine", 2 x 3" | #N/A | #N/A | #N/A | PCE | 87327-01 | #N/A | #N/A | #N/A | #N/A | 0 | #N/A | #N/A | #N/A | #N/A | #N/A | #N/A | #N/A | #N/A
DC-LB0114 | LulzBot Logo Hologram Tamper-Evident Sticker | #N/A | #N/A | #N/A | PCE | TL383-ND | #N/A | #N/A | #N/A | #N/A | 0 | #N/A | #N/A | #N/A | #N/A | #N/A | #N/A | #N/A | #N/A
DC-LB0115 | MOARstruder Tool Head Packaging Sleeve | #N/A | #N/A | #N/A | mm | 1310A 010U500 | #N/A | #N/A | #N/A | #N/A | 0 | #N/A | #N/A | #N/A | #N/A | #N/A | #N/A | #N/A | #N/A
DC-LB0116 | FlexyDually Tool Head Packaging Sleeve | #N/A | #N/A | #N/A | PCE | 566-1310A-U500-10 | #N/A | #N/A | #N/A | #N/A | 0 | #N/A | #N/A | #N/A | #N/A | #N/A | #N/A | #N/A | #N/A
DC-LB0117 | Dual Extruder Tool Head Packaging Sleeve | #N/A | #N/A | #N/A | PCE | B00L3KNY22 | #N/A | #N/A | #N/A | #N/A | 0 | #N/A | #N/A | #N/A | #N/A | #N/A | #N/A | #N/A | #N/A
DC-LB0118 | Save your TAZ 6 Packaging Sticker | #N/A | #N/A | #N/A | PCE | 109767 or B00AJHBES6 | #N/A | #N/A | #N/A | #N/A | 0 | #N/A | #N/A | #N/A | #N/A | #N/A | #N/A | #N/A | #N/A
DC-LB0119 | Circle Inventory Control Labels - "Do Not Inventory", 2" | #N/A | #N/A | #N/A | PCE | 443149 | #N/A | #N/A | #N/A | #N/A | 0 | #N/A | #N/A | #N/A | #N/A | #N/A | #N/A | #N/A | #N/A
DC-LB0120 | Standard White Matte - 0.5" x 0.5" Small Square Labels | #N/A | #N/A | #N/A | PCE | 68113107335 | #N/A | #N/A | #N/A | #N/A | 0 | #N/A | #N/A | #N/A | #N/A | #N/A | #N/A | #N/A | #N/A
DC-LB0121 | Save your Mini Packaging Sticker | #N/A | #N/A | #N/A | mm | 517-3302/10-300 | #N/A | #N/A | #N/A | #N/A | 3302/10-300 | #N/A | #N/A | #N/A | #N/A | #N/A | #N/A | #N/A | #N/A
DC-LB0122 | Longblock Hot End Retail Box Label | #N/A | #N/A | #N/A | PCE | 0 | #N/A | #N/A | #N/A | #N/A | 0 | #N/A | #N/A | #N/A | #N/A | #N/A | #N/A | #N/A | #N/A
DC-LB0123 | LulzBot Fidget Spinner Labels | #N/A | #N/A | #N/A | PCE | 29812 | #N/A | #N/A | #N/A | #N/A | 0 | #N/A | #N/A | #N/A | #N/A | #N/A | #N/A | #N/A | #N/A
DC-LB0124 | Laser Label - White, 1 1⁄2 x 3⁄4"(box 7,000) | #N/A | #N/A | #N/A | PCE | 603002 | #N/A | #N/A | #N/A | #N/A | 603002 | #N/A | #N/A | #N/A | #N/A | #N/A | #N/A | #N/A | #N/A
DC-LB0125 | Hexagon Hot End Retail Box Label, 0.50mm, v2 | #N/A | #N/A | #N/A | PCE | 3271VF76 | #N/A | #N/A | #N/A | #N/A | 3271VF76 | #N/A | #N/A | #N/A | #N/A | #N/A | #N/A | #N/A | #N/A
DC-LB0126 | Label, LulzBot TAZ Dual Tool Head V3, 0.5 Nozzle, Front | #N/A | #N/A | #N/A | PCE | UM40FAN | #N/A | #N/A | #N/A | #N/A | 0 | #N/A | #N/A | #N/A | #N/A | #N/A | #N/A | #N/A | #N/A
DC-LB0127 | Suffocation Warning Label - 3 x 4 1⁄4" | #N/A | #N/A | #N/A | PCE | 1053-1205-ND | #N/A | #N/A | #N/A | #N/A | 0 | #N/A | #N/A | #N/A | #N/A | #N/A | #N/A | #N/A | #N/A
DC-LB0128 | Hexagon Hot End Retail Box Label, 0.35mm, v2 | #N/A | #N/A | #N/A | PCE | TF4010-12H-S | #N/A | #N/A | #N/A | #N/A | 0 | #N/A | #N/A | #N/A | #N/A | #N/A | #N/A | #N/A | #N/A
DC-LB0129 | Hexagon Hot End Retail Box Label, 0.60mm, v2 | #N/A | #N/A | #N/A | PCE | 0 | #N/A | #N/A | #N/A | #N/A | 0 | #N/A | #N/A | #N/A | #N/A | #N/A | #N/A | #N/A | #N/A
DC-LB0130 | Factory Refurbished Checkerboard Tamperproof Labels - ¾" x 1-7/8" | #N/A | #N/A | #N/A | PCE | ME40101V1-000U-A99 | #N/A | #N/A | #N/A | #N/A | 0 | #N/A | #N/A | #N/A | #N/A | #N/A | #N/A | #N/A | #N/A
DC-LB0131 | Gladiola Serial Number Labels | #N/A | #N/A | #N/A | PCE | 25-1565-ND | #N/A | #N/A | #N/A | #N/A | 0 | #N/A | #N/A | #N/A | #N/A | #N/A | #N/A | #N/A | #N/A
DC-LB0132 | Label, LulzBot TAZ Dual Tool Head V3, 0.5 Nozzle, Back | #N/A | #N/A | #N/A | PCE | 259-1630-ND | #N/A | #N/A | #N/A | #N/A | 0 | #N/A | #N/A | #N/A | #N/A | #N/A | #N/A | #N/A | #N/A
DC-LB0133 | Label, Mini Modular Glass/PEI | #N/A | #N/A | #N/A | PCE | 664-D4010HX-G70-LF | #N/A | #N/A | #N/A | #N/A | 0 | #N/A | #N/A | #N/A | #N/A | #N/A | #N/A | #N/A | #N/A
DC-LB0134 | Label, Mini Modular Heat Bed | #N/A | #N/A | #N/A | PCE | 0 | #N/A | #N/A | #N/A | #N/A | 0 | #N/A | #N/A | #N/A | #N/A | #N/A | #N/A | #N/A | #N/A
DC-LB0135 | Label, TAZ Modular Glass/PEI | 0 | 0 | 0 | PCE | 69829 - TF4010-24H-S | #N/A | #N/A | #N/A | #N/A | TF4010-24H-S | #N/A | #N/A | #N/A | #N/A | #N/A | #N/A | #N/A | #N/A
DC-LB0136 | Label, TAZ Modular Heat Bed | 0 | Y | 0 | PCE | 69866 - TF8015-24M-B | #N/A | #N/A | #N/A | #N/A | TF8015-24M-B | #N/A | #N/A | #N/A | #N/A | #N/A | #N/A | #N/A | #N/A
DC-LB0137 | Label, LulzBot TAZ Aerostruder Tool Head, Front | #N/A | #N/A | #N/A | PCE | TF4010-12H-S | #N/A | #N/A | #N/A | #N/A | 0 | #N/A | #N/A | #N/A | #N/A | #N/A | #N/A | #N/A | #N/A
DC-LB0138 | Label, LulzBot TAZ Aerosturder Tool Head, Back | #N/A | #N/A | #N/A | PCE | 1053-1210-ND | #N/A | #N/A | #N/A | #N/A | 0 | #N/A | #N/A | #N/A | #N/A | #N/A | #N/A | #N/A | #N/A
DC-LB0139 | Label, LulzBot Mini Aerostruder Tool Head, Front | #N/A | #N/A | #N/A | PCE | 0 | #N/A | #N/A | #N/A | #N/A | 0 | #N/A | #N/A | #N/A | #N/A | #N/A | #N/A | #N/A | #N/A
DC-LB0140 | Label, LulzBot Mini Aerostruder Tool Head, Back | #N/A | #N/A | #N/A | PCE | 0 | #N/A | #N/A | #N/A | #N/A | 0 | #N/A | #N/A | #N/A | #N/A | #N/A | #N/A | #N/A | #N/A
DC-LB0141 | LulzBot Make Everything Sticker, 4x1.25 | #N/A | #N/A | #N/A | PCE | 0 | #N/A | #N/A | #N/A | #N/A | 0 | #N/A | #N/A | #N/A | #N/A | #N/A | #N/A | #N/A | #N/A
DC-LB0142 | Rock2pus Make Everything Sticker, 3x2.25 | #N/A | #N/A | #N/A | PCE | TF4010-12H-S | #N/A | #N/A | #N/A | #N/A | 0 | #N/A | #N/A | #N/A | #N/A | #N/A | #N/A | #N/A | #N/A
DC-LB0143 | Rocknrollo Made it in Vegas Sticker, 3x3 | #N/A | #N/A | #N/A | PCE | 259-1316-ND | #N/A | #N/A | #N/A | #N/A | 0 | #N/A | #N/A | #N/A | #N/A | #N/A | #N/A | #N/A | #N/A
DC-LB0144 | LulzBot Mini Graphical LCD Controller Label - Front | 0 | 0 | 0 | PCE | RFB2008 | Electronic | 6.54 |  | 0 | 0 | Pelonis | 0 | 0 | 0 | 0 | 0 | 0 | 0
DC-LB0145 | LulzBot Mini Graphical LCD Controller Label - Back | Y | #N/A | #N/A | PCE | 603-1116-ND | #N/A | #N/A | #N/A | #N/A | 0 | #N/A | #N/A | #N/A | #N/A | #N/A | #N/A | #N/A | #N/A
DC-LB0146 | Mini 2 Certification Sticker | #N/A | #N/A | #N/A | PCE | 259-1615-ND | #N/A | #N/A | #N/A | #N/A | 0 | #N/A | #N/A | #N/A | #N/A | #N/A | #N/A | #N/A | #N/A
DC-MN0000 | AO-100 User Manual | #N/A | #N/A | #N/A | PCE | 0 | #N/A | #N/A | #N/A | #N/A | 0 | #N/A | #N/A | #N/A | #N/A | #N/A | #N/A | #N/A | #N/A
DC-MN0001 | AO-101 User Manual | #N/A | #N/A | #N/A | PCE | 0 | #N/A | #N/A | #N/A | #N/A | 0 | #N/A | #N/A | #N/A | #N/A | #N/A | #N/A | #N/A | #N/A
DC-MN0002 | Lulzbot-Taz Manual Print & Binding | #N/A | #N/A | #N/A | PCE | TF4010-24H-S | #N/A | #N/A | #N/A | #N/A | 0 | #N/A | #N/A | #N/A | #N/A | #N/A | #N/A | #N/A | #N/A
DC-MN0003 | Lulzbot-Taz User Manual | #N/A | #N/A | #N/A | PCE | TF8015-24M-B | #N/A | #N/A | #N/A | #N/A | 0 | #N/A | #N/A | #N/A | #N/A | #N/A | #N/A | #N/A | #N/A
DC-MN0004 | Quick Start Guide, Lulzbot | #N/A | #N/A | #N/A | PCE | 0 | #N/A | #N/A | #N/A | #N/A | 0 | #N/A | #N/A | #N/A | #N/A | #N/A | #N/A | #N/A | #N/A
DC-MN0005 | Lulzbot-Taz 2.0 User Manual | #N/A | #N/A | #N/A | PCE | 0 | #N/A | #N/A | #N/A | #N/A | 0 | #N/A | #N/A | #N/A | #N/A | #N/A | #N/A | #N/A | #N/A
DC-MN0006 | Lulzbot-Taz 2.1 User Manual | #N/A | #N/A | #N/A | PCE | 259-1565-ND | #N/A | #N/A | #N/A | #N/A | 0 | #N/A | #N/A | #N/A | #N/A | #N/A | #N/A | #N/A | #N/A
DC-MN0007 | Lulzbot-Taz 3.0 User Manual | #N/A | #N/A | #N/A | PCE | 0 | #N/A | #N/A | #N/A | #N/A | 0 | #N/A | #N/A | #N/A | #N/A | #N/A | #N/A | #N/A | #N/A
DC-MN0008 | Lulzbot-Taz 3.1 User Manual | #N/A | #N/A | #N/A | PCE | 0 | #N/A | #N/A | #N/A | #N/A | 0 | #N/A | #N/A | #N/A | #N/A | #N/A | #N/A | #N/A | #N/A
DC-MN0009 | Lulzbot-Taz 4.0 User Manual | Y | #N/A | #N/A | PCE | C4010L24BPLB1b-7 | #N/A | 3.13 | Y- Long Lead | #N/A | C4010L24BPLB1b-7 | Pelonis | #N/A | #N/A | #N/A | #N/A | #N/A | #N/A | #N/A
DC-MN0010 | Lulzbot-Taz 4.1 User Manual | Y | #N/A | #N/A | PCE | C8015L24BPLP1b-7 | #N/A | 3.12 | Y- Long Lead | #N/A | C8015L24BPLP1b-7 | Pelonis | #N/A | #N/A | #N/A | #N/A | #N/A | #N/A | #N/A
DC-MN0011 | Getting Started Guide, TAZ 4 | Y | #N/A | #N/A | PCE | C4010L05BPLB1b-7 | #N/A | 3.07 | Y- Long Lead | #N/A | C4010L05BPLB1b-7 | Pelonis | #N/A | #N/A | #N/A | #N/A | #N/A | #N/A | #N/A
DC-MN0012 | Getting Started Guide, TAZ 5 | Y | #N/A | #N/A | PCE | C4010M24BPLP1b-7 | #N/A | #N/A | Y- Long Lead | #N/A | 0 | Pelonis | #N/A | #N/A | #N/A | #N/A | #N/A | #N/A | #N/A
DC-MN0013 | Lulzbot-Taz 5.0 User Manual | #N/A | #N/A | #N/A | PCE | 0 | #N/A | #N/A | #N/A | #N/A | 0 | #N/A | #N/A | #N/A | #N/A | #N/A | #N/A | #N/A | #N/A
DC-MN0014 | LulzBot Mini User Manual | #N/A | #N/A | #N/A | PCE | 00051135329573-31196 | #N/A | #N/A | #N/A | #N/A | 963E | #N/A | #N/A | #N/A | #N/A | #N/A | #N/A | #N/A | #N/A
DC-MN0015 | Lulzbot-TAZ 6.0 User Manual | #N/A | #N/A | #N/A | PCE | 381-2367-ND | #N/A | #N/A | #N/A | #N/A | 414FH | #N/A | #N/A | #N/A | #N/A | #N/A | #N/A | #N/A | #N/A
DC-MN0016 | Operating Guide, TAZ 6 | #N/A | #N/A | #N/A | PCE | 1053-1210-ND | #N/A | #N/A | #N/A | #N/A | OD4010-24HSS | #N/A | #N/A | #N/A | #N/A | #N/A | #N/A | #N/A | #N/A
DC-MN0017 | Unboxing Guide, TAZ 6 | #N/A | #N/A | #N/A | PCE | 1053-1208-ND | #N/A | #N/A | #N/A | #N/A | OD4010-24HB | #N/A | #N/A | #N/A | #N/A | #N/A | #N/A | #N/A | #N/A
DC-MN0018 | FreeCAD: A Manual | #N/A | #N/A | #N/A | PCE | MDS410-24 | #N/A | #N/A | #N/A | #N/A | MDS410-24 | #N/A | #N/A | #N/A | #N/A | #N/A | #N/A | #N/A | #N/A
DC-MN0019 | LulzBot Mini 2 User Manual | Y | #N/A | #N/A | PCE | C8015M24BPLP1b-7 | #N/A | #N/A | #N/A | #N/A | C8015M24BPLP1b-7 | Pelonis | #N/A | #N/A | #N/A | #N/A | #N/A | #N/A | #N/A
DC-MS0001 | Registration Card, AO-100 | Y | #N/A | #N/A | PCE | C8015H24BPLP1b-7 | #N/A | 3.88 | #N/A | #N/A | C8015H24BPLP1b-7 | Pelonis | #N/A | #N/A | #N/A | #N/A | #N/A | #N/A | #N/A
DC-MS0003 | AO-101 Unpacking Instructions | #N/A | #N/A | #N/A | PCE | 0 | #N/A | #N/A | #N/A | #N/A | 0 | #N/A | #N/A | #N/A | #N/A | #N/A | #N/A | #N/A | #N/A
DC-MS0004 | Quality checklist, TAZ 2.0 | #N/A | #N/A | #N/A | PCE | 0 | #N/A | #N/A | #N/A | #N/A | 0 | #N/A | #N/A | #N/A | #N/A | #N/A | #N/A | #N/A | #N/A
DC-MS0005 | Test/Acceptance record TAZ 2.0 | #N/A | #N/A | #N/A | PCE | 35765K51 | #N/A | #N/A | #N/A | #N/A | 0 | #N/A | #N/A | #N/A | #N/A | #N/A | #N/A | #N/A | #N/A
DC-MS0006 | Forum Postcards | #N/A | #N/A | #N/A | PCE | 0 | #N/A | #N/A | #N/A | #N/A | 0 | #N/A | #N/A | #N/A | #N/A | #N/A | #N/A | #N/A | #N/A
DC-MS0007 | Packing List, TAZ 2.0 | #N/A | #N/A | #N/A | PCE | 35765k512 | #N/A | #N/A | #N/A | #N/A | 0 | #N/A | #N/A | #N/A | #N/A | #N/A | #N/A | #N/A | #N/A
DC-MS0008 | AO-101 Printer Documentation | #N/A | #N/A | #N/A | PCE | 35765K513 | #N/A | #N/A | #N/A | #N/A | 0 | #N/A | #N/A | #N/A | #N/A | #N/A | #N/A | #N/A | #N/A
DC-MS0009 | Brochure, Lulzbot Flyer | #N/A | #N/A | #N/A | PCE | 0 | #N/A | #N/A | #N/A | #N/A | 0 | #N/A | #N/A | #N/A | #N/A | #N/A | #N/A | #N/A | #N/A
DC-MS0010 | DVD Training 12: Blender for 3D Printing | #N/A | #N/A | #N/A | PCE | 0 | #N/A | #N/A | #N/A | #N/A | 0 | #N/A | #N/A | #N/A | #N/A | #N/A | #N/A | #N/A | #N/A
DC-MS0011 | New Product Introduction | #N/A | #N/A | #N/A | PCE | 0 | #N/A | #N/A | #N/A | #N/A | 0 | #N/A | #N/A | #N/A | #N/A | #N/A | #N/A | #N/A | #N/A
DC-MS0012 | Postcards | #N/A | #N/A | #N/A | PCE | 0 | #N/A | #N/A | #N/A | #N/A | 0 | #N/A | #N/A | #N/A | #N/A | #N/A | #N/A | #N/A | #N/A
DC-MS0013 | Product Flyers | #N/A | #N/A | #N/A | PCE | 35765K55 | #N/A | #N/A | #N/A | #N/A | 0 | #N/A | #N/A | #N/A | #N/A | #N/A | #N/A | #N/A | #N/A
DC-MS0014 | Quality checklist, TAZ 3.1 | #N/A | #N/A | #N/A | PCE | 0 | #N/A | #N/A | #N/A | #N/A | 0 | #N/A | #N/A | #N/A | #N/A | #N/A | #N/A | #N/A | #N/A
DC-MS0015 | Test/Acceptance record TAZ 3.1 | #N/A | #N/A | #N/A | PCE | HH-SC_PCB_YH | #N/A | #N/A | #N/A | #N/A | 0 | #N/A | #N/A | #N/A | #N/A | #N/A | #N/A | #N/A | #N/A
DC-MS0016 | Packing List, TAZ 3.1 | #N/A | #N/A | #N/A | PCE | 0 | #N/A | #N/A | #N/A | #N/A | 0 | #N/A | #N/A | #N/A | #N/A | #N/A | #N/A | #N/A | #N/A
DC-MS0017 | TAZ 3 unpacking instructions, #1 | #N/A | #N/A | #N/A | PCE | 0 | #N/A | #N/A | #N/A | #N/A | 0 | #N/A | #N/A | #N/A | #N/A | #N/A | #N/A | #N/A | #N/A
DC-MS0018 | TAZ 3 set up instructions, #2 | #N/A | #N/A | #N/A | PCE | 0 | #N/A | #N/A | #N/A | #N/A | 0 | #N/A | #N/A | #N/A | #N/A | #N/A | #N/A | #N/A | #N/A
DC-MS0019 | TAZ 3 quick print instructions, #3 | #N/A | #N/A | #N/A | PCE | 0 | #N/A | #N/A | #N/A | #N/A | 0 | #N/A | #N/A | #N/A | #N/A | #N/A | #N/A | #N/A | #N/A
DC-MS0020 | Test/Acceptance record TAZ 4.0 | #N/A | #N/A | #N/A | PCE | 0 | #N/A | #N/A | #N/A | #N/A | 0 | #N/A | #N/A | #N/A | #N/A | #N/A | #N/A | #N/A | #N/A
DC-MS0021 | Quality checklist, TAZ 4.0 | #N/A | #N/A | #N/A | PCE | 0 | #N/A | #N/A | #N/A | #N/A | 0 | #N/A | #N/A | #N/A | #N/A | #N/A | #N/A | #N/A | #N/A
DC-MS0022 | Packing List, TAZ 4.0 | #N/A | #N/A | #N/A | PCE | 0 | #N/A | #N/A | #N/A | #N/A | 0 | #N/A | #N/A | #N/A | #N/A | #N/A | #N/A | #N/A | #N/A
DC-MS0023 | Test/Acceptance record TAZ 4.1 | #N/A | #N/A | #N/A | PCE | 0 | #N/A | #N/A | #N/A | #N/A | 0 | #N/A | #N/A | #N/A | #N/A | #N/A | #N/A | #N/A | #N/A
DC-MS0024 | Quality checklist, TAZ 4.1 | #N/A | #N/A | #N/A | PCE | 0 | #N/A | #N/A | #N/A | #N/A | 0 | #N/A | #N/A | #N/A | #N/A | #N/A | #N/A | #N/A | #N/A
DC-MS0025 | Packing List, TAZ 4.1 | #N/A | #N/A | #N/A | PCE | 0 | #N/A | #N/A | #N/A | #N/A | 0 | #N/A | #N/A | #N/A | #N/A | #N/A | #N/A | #N/A | #N/A
DC-MS0026 | KITTAZ 4 Page Packing List | #N/A | #N/A | #N/A | PCE | 0 | #N/A | #N/A | #N/A | #N/A | 0 | #N/A | #N/A | #N/A | #N/A | #N/A | #N/A | #N/A | #N/A
DC-MS0027 | KITTAZ Insert | #N/A | #N/A | #N/A | PCE | 0 | #N/A | #N/A | #N/A | #N/A | 0 | #N/A | #N/A | #N/A | #N/A | #N/A | #N/A | #N/A | #N/A
DC-MS0028 | Packing List, Mini 1.0 | #N/A | #N/A | #N/A | PCE | 0 | #N/A | #N/A | #N/A | #N/A | 0 | #N/A | #N/A | #N/A | #N/A | #N/A | #N/A | #N/A | #N/A
DC-MS0029 | Quality assurance record Mini 1.0 | #N/A | #N/A | #N/A | PCE | 0 | #N/A | #N/A | #N/A | #N/A | 0 | #N/A | #N/A | #N/A | #N/A | #N/A | #N/A | #N/A | #N/A
DC-MS0030 | Lulzbot Mini Poster | #N/A | #N/A | #N/A | PCE | 0 | #N/A | #N/A | #N/A | #N/A | 0 | #N/A | #N/A | #N/A | #N/A | #N/A | #N/A | #N/A | #N/A
DC-MS0031 | Warning sheet, Mini | #N/A | #N/A | #N/A | PCE | 0 | #N/A | #N/A | #N/A | #N/A | 0 | #N/A | #N/A | #N/A | #N/A | #N/A | #N/A | #N/A | #N/A
DC-MS0032 | Quick start guide, Mini | #N/A | #N/A | #N/A | PCE | 0 | #N/A | #N/A | #N/A | #N/A | 0 | #N/A | #N/A | #N/A | #N/A | #N/A | #N/A | #N/A | #N/A
DC-MS0033 | EC Declaration of Conformity, Mini v1.0 | #N/A | #N/A | #N/A | PCE | 0 | #N/A | #N/A | #N/A | #N/A | 0 | #N/A | #N/A | #N/A | #N/A | #N/A | #N/A | #N/A | #N/A
DC-MS0034 | Test/Acceptance record TAZ 5.0 | #N/A | #N/A | #N/A | PCE | 0 | #N/A | #N/A | #N/A | #N/A | 0 | #N/A | #N/A | #N/A | #N/A | #N/A | #N/A | #N/A | #N/A
DC-MS0035 | Quality checklist, TAZ 5.0 | #N/A | #N/A | #N/A | PCE | 0 | #N/A | #N/A | #N/A | #N/A | 0 | #N/A | #N/A | #N/A | #N/A | #N/A | #N/A | #N/A | #N/A
DC-MS0036 | Packing List, TAZ 5.0 | #N/A | #N/A | #N/A | PCE | 0 | #N/A | #N/A | #N/A | #N/A | 0 | #N/A | #N/A | #N/A | #N/A | #N/A | #N/A | #N/A | #N/A
DC-MS0037 | Colorado Made Green Sticker | #N/A | #N/A | #N/A | PCE | 0 | #N/A | #N/A | #N/A | #N/A | 0 | #N/A | #N/A | #N/A | #N/A | #N/A | #N/A | #N/A | #N/A
DC-MS0038 | Lulzbot Mini Promo Postcard | #N/A | #N/A | #N/A | PCE | 0 | #N/A | #N/A | #N/A | #N/A | 0 | #N/A | #N/A | #N/A | #N/A | #N/A | #N/A | #N/A | #N/A
DC-MS0039 | Lulzbot MINI Brochure | #N/A | #N/A | #N/A | PCE | 0 | #N/A | #N/A | #N/A | #N/A | 0 | #N/A | #N/A | #N/A | #N/A | #N/A | #N/A | #N/A | #N/A
DC-MS0040 | TAZ 4, One Pager (Brochure and Specs) | #N/A | #N/A | #N/A | PCE | 0 | #N/A | #N/A | #N/A | #N/A | 0 | #N/A | #N/A | #N/A | #N/A | #N/A | #N/A | #N/A | #N/A
DC-MS0041 | EC Declaration of Conformity, TAZ v5.0 | #N/A | #N/A | #N/A | PCE | 0 | #N/A | #N/A | #N/A | #N/A | 0 | #N/A | #N/A | #N/A | #N/A | #N/A | #N/A | #N/A | #N/A
DC-MS0042 | TAZ 5, One Pager (Brochure and Specs) | #N/A | #N/A | #N/A | PCE | 0 | #N/A | #N/A | #N/A | #N/A | 0 | #N/A | #N/A | #N/A | #N/A | #N/A | #N/A | #N/A | #N/A
DC-MS0043 | Vinyl Lulzbot Wall Graphic, 4/0, contour cut, 24 x 30 White # 3M Control Tac IJ180 CV3 Matte , high resolution ink jet on 1 side | #N/A | #N/A | #N/A | PCE | 1725950-2 | #N/A | #N/A | #N/A | #N/A | 0 | #N/A | #N/A | #N/A | #N/A | #N/A | #N/A | #N/A | #N/A
DC-MS0044 | LulzBot Give-Away Banner v2 | #N/A | #N/A | #N/A | PCE | 1333228-2 | #N/A | #N/A | #N/A | #N/A | 0 | #N/A | #N/A | #N/A | #N/A | #N/A | #N/A | #N/A | #N/A
DC-MS0045 | LulzBot_Give-Away_Banner_Final | #N/A | #N/A | #N/A | PCE | 1-1333201-1 | #N/A | #N/A | #N/A | #N/A | 0 | #N/A | #N/A | #N/A | #N/A | #N/A | #N/A | #N/A | #N/A
DC-MS0046 | Warning sheet, TAZ | #N/A | #N/A | #N/A | PCE | 2-456135-2 | #N/A | #N/A | #N/A | #N/A | 0 | #N/A | #N/A | #N/A | #N/A | #N/A | #N/A | #N/A | #N/A
DC-MS0047 | v2 - CONGRATULATIONS!- Tool Head Instruction Card | #N/A | #N/A | #N/A | PCE | 2119784.7 | #N/A | #N/A | #N/A | #N/A | 0 | #N/A | #N/A | #N/A | #N/A | #N/A | #N/A | #N/A | #N/A
DC-MS0048 | TAZ 1 Page Brochure v. 3.1 | #N/A | #N/A | #N/A | PCE | 1-456403-2 | #N/A | #N/A | #N/A | #N/A | 0 | #N/A | #N/A | #N/A | #N/A | #N/A | #N/A | #N/A | #N/A
DC-MS0049 | Test/Acceptance record TAZ 6.0 | #N/A | #N/A | #N/A | PCE | 4-456406-7 | #N/A | #N/A | #N/A | #N/A | 0 | #N/A | #N/A | #N/A | #N/A | #N/A | #N/A | #N/A | #N/A
DC-MS0050 | Packing List, TAZ 6.0 | #N/A | #N/A | #N/A | PCE | 454276-1 | #N/A | #N/A | #N/A | #N/A | 0 | #N/A | #N/A | #N/A | #N/A | #N/A | #N/A | #N/A | #N/A
DC-MS0051 | EC Declaration of Conformity, TAZ 6.0 | #N/A | #N/A | #N/A | PCE | 462006-6 | #N/A | #N/A | #N/A | #N/A | 0 | #N/A | #N/A | #N/A | #N/A | #N/A | #N/A | #N/A | #N/A
DC-MS0052 | Safety Warnings sheet, TAZ 6.0 | #N/A | #N/A | #N/A | PCE | 1426179-2 | #N/A | #N/A | #N/A | #N/A | 0 | #N/A | #N/A | #N/A | #N/A | #N/A | #N/A | #N/A | #N/A
DC-MS0053 | LulzBot Give-Away Banner | #N/A | #N/A | #N/A | PCE | 2119806-1 | #N/A | #N/A | #N/A | #N/A | 0 | #N/A | #N/A | #N/A | #N/A | #N/A | #N/A | #N/A | #N/A
DC-MS0054 | Firmware Update Warning Cards | #N/A | #N/A | #N/A | PCE | 2151641-1 | #N/A | #N/A | #N/A | #N/A | 0 | #N/A | #N/A | #N/A | #N/A | #N/A | #N/A | #N/A | #N/A
DC-MS0055 | TAZ 6 One-Page Flyers | #N/A | #N/A | #N/A | PCE | 2151101-1 | #N/A | #N/A | #N/A | #N/A | 0 | #N/A | #N/A | #N/A | #N/A | #N/A | #N/A | #N/A | #N/A
DC-MS0056 | Frosted Vinyl Applique Sticker | #N/A | #N/A | #N/A | PCE | CRK-1003 | #N/A | #N/A | #N/A | #N/A | 0 | #N/A | #N/A | #N/A | #N/A | #N/A | #N/A | #N/A | #N/A
DC-MS0057 | Mini One-Page Flyers | #N/A | #N/A | #N/A | PCE | 0 | #N/A | #N/A | #N/A | #N/A | 0 | #N/A | #N/A | #N/A | #N/A | #N/A | #N/A | #N/A | #N/A
DC-MS0058 | LulzBot Product Brochure - Angle cut tri-fold | #N/A | #N/A | #N/A | PCE | 0 | #N/A | #N/A | #N/A | #N/A | 0 | #N/A | #N/A | #N/A | #N/A | #N/A | #N/A | #N/A | #N/A
DC-MS0059 | Printed Case Study, 4.25 x 11" | #N/A | #N/A | #N/A | PCE | 0 | #N/A | #N/A | #N/A | #N/A | 0 | #N/A | #N/A | #N/A | #N/A | #N/A | #N/A | #N/A | #N/A
DC-MS0060 | CONGRATULATIONS!- Tool Head Instruction Card | #N/A | #N/A | #N/A | PCE | CRK-420102105 | #N/A | #N/A | #N/A | #N/A | 0 | #N/A | #N/A | #N/A | #N/A | #N/A | #N/A | #N/A | #N/A
DC-MS0061 | Firmware Update Warning Cards- Cura 2 | #N/A | #N/A | #N/A | PCE | 0 | #N/A | #N/A | #N/A | #N/A | 0 | #N/A | #N/A | #N/A | #N/A | #N/A | #N/A | #N/A | #N/A
DC-MS0062 | LulzBot Reseller Banner, Vinyl 5x2 | #N/A | #N/A | #N/A | PCE | 0 | #N/A | #N/A | #N/A | #N/A | 0 | #N/A | #N/A | #N/A | #N/A | #N/A | #N/A | #N/A | #N/A
DC-MS0063 | LulzBot Education Banner, Vinyl 5x2 | #N/A | #N/A | #N/A | PCE | 0 | #N/A | #N/A | #N/A | #N/A | 0 | #N/A | #N/A | #N/A | #N/A | #N/A | #N/A | #N/A | #N/A
DC-MS0064 | LulzBot Generic Banner, Vinyl 5x2 | #N/A | #N/A | #N/A | PCE | 0 | #N/A | #N/A | #N/A | #N/A | 0 | #N/A | #N/A | #N/A | #N/A | #N/A | #N/A | #N/A | #N/A
DC-MS0065 | Cura LE Update Insert Card | #N/A | #N/A | #N/A | PCE | 0 | #N/A | #N/A | #N/A | #N/A | 0 | #N/A | #N/A | #N/A | #N/A | #N/A | #N/A | #N/A | #N/A
DC-MS0066 | Quick Start Quide, Mini 2 | #N/A | #N/A | #N/A | PCE | 0 | #N/A | #N/A | #N/A | #N/A | 0 | #N/A | #N/A | #N/A | #N/A | #N/A | #N/A | #N/A | #N/A
DC-MS0067 | Lulzbot Brand Book | #N/A | #N/A | #N/A | PCE | 0 | #N/A | #N/A | #N/A | #N/A | 0 | #N/A | #N/A | #N/A | #N/A | #N/A | #N/A | #N/A | #N/A
EL-CA0001 | 6ft USB 2.0 A Male to B Male 28/24AWG Cable | #N/A | #N/A | #N/A | PCE | 0 | #N/A | #N/A | #N/A | #N/A | 0 | #N/A | #N/A | #N/A | #N/A | #N/A | #N/A | #N/A | #N/A
EL-CA0002 | AC Power Cable w/ Bare End | #N/A | #N/A | #N/A | PCE | 0 | #N/A | #N/A | #N/A | #N/A | 0 | #N/A | #N/A | #N/A | #N/A | #N/A | #N/A | #N/A | #N/A
EL-CA0003 | 1.5ft USB 2.0 A Male to A Male 28/24AWG Cable (Gold Plated) | #N/A | #N/A | #N/A | PCE | 0 | #N/A | #N/A | #N/A | #N/A | 0 | #N/A | #N/A | #N/A | #N/A | #N/A | #N/A | #N/A | #N/A
EL-CA0004 | 15ft USB 2.0 A Male to A Male 28/24AWG Cable (Gold Plated) | #N/A | #N/A | #N/A | PCE | 0 | #N/A | #N/A | #N/A | #N/A | 0 | #N/A | #N/A | #N/A | #N/A | #N/A | #N/A | #N/A | #N/A
EL-CA0005 | 1.5ft USB 2.0 A Male to B Male 28/24AWG Cable - (Gold Plated) | #N/A | #N/A | #N/A | PCE | 0 | #N/A | #N/A | #N/A | #N/A | 0 | #N/A | #N/A | #N/A | #N/A | #N/A | #N/A | #N/A | #N/A
EL-CA0006 | 15ft USB 2.0 A Male to B Male 28/24AWG Cable (Gold Plated) | #N/A | #N/A | #N/A | PCE | 0 | #N/A | #N/A | #N/A | #N/A | 0 | #N/A | #N/A | #N/A | #N/A | #N/A | #N/A | #N/A | #N/A
EL-CA0007 | 3ft USB 2.0 A Male to A Male 28/24AWG Cable (Gold Plated) | #N/A | #N/A | #N/A | PCE | 0 | #N/A | #N/A | #N/A | #N/A | 0 | #N/A | #N/A | #N/A | #N/A | #N/A | #N/A | #N/A | #N/A
EL-CA0008 | 3ft USB 2.0 A Male to B Male 28/24AWG Cable - (Gold Plated) | #N/A | #N/A | #N/A | PCE | 0 | #N/A | #N/A | #N/A | #N/A | 0 | #N/A | #N/A | #N/A | #N/A | #N/A | #N/A | #N/A | #N/A
EL-CA0009 | 6ft USB 2.0 A Male to A Male 28/24AWG Cable (Gold Plated) | #N/A | #N/A | #N/A | PCE | 0 | #N/A | #N/A | #N/A | #N/A | 0 | #N/A | #N/A | #N/A | #N/A | #N/A | #N/A | #N/A | #N/A
EL-CA0010 | 10ft USB 2.0 A Male to B Male 28/24AWG Cable (Gold Plated) | #N/A | #N/A | #N/A | PCE | 0 | #N/A | #N/A | #N/A | #N/A | 0 | #N/A | #N/A | #N/A | #N/A | #N/A | #N/A | #N/A | #N/A
EL-CA0011 | 10ft USB 2.0 A Male to Mini-B 5pin Male 28/24AWG Cable w/ Ferrite Core (Gold Plated) | 0 | 0 | 0 | PCE | 0 | Electronic | 0 |  | 0 | 0 | 0 | 0 | 0 | 0 | 0 | 0 | 0 | 0
EL-CA0012 | 100cm Length Wire K-type Thermocouple Sensor Probe Temperature 1M Cable New | 0 | 0 | 0 | PCE | 0 | Electronic | 0 |  | 0 | 0 | 0 | 0 | 0 | 0 | 0 | 0 | 0 | 0
EL-CA0013 | Ativa® 3' High-Speed HDMI Cable, Black | #N/A | #N/A | #N/A | PCE | 0 | #N/A | #N/A | #N/A | #N/A | 0 | #N/A | #N/A | #N/A | #N/A | #N/A | #N/A | #N/A | #N/A
EL-CA0014 | BNC to USB Video Converter Cable, 2M length | #N/A | #N/A | #N/A | PCE | 0 | #N/A | #N/A | #N/A | #N/A | 0 | #N/A | #N/A | #N/A | #N/A | #N/A | #N/A | #N/A | #N/A
EL-CA0015 | CBL, MNG, PVC, 6' | #N/A | #N/A | #N/A | PCE | 0 | #N/A | #N/A | #N/A | #N/A | 0 | #N/A | #N/A | #N/A | #N/A | #N/A | #N/A | #N/A | #N/A
EL-CA0016 | Flat Cables .050" 10C SHIELDED BLACK 28AWG STRANDED | #N/A | #N/A | #N/A | PCE | 0 | #N/A | #N/A | #N/A | #N/A | 0 | #N/A | #N/A | #N/A | #N/A | #N/A | #N/A | #N/A | #N/A
EL-CA0016 old | (Obsolete) Flat Cables .050" 10C SHIELDED BLACK 28AWG STRANDED | #N/A | #N/A | #N/A | PCE | 0 | #N/A | #N/A | #N/A | #N/A | 0 | #N/A | #N/A | #N/A | #N/A | #N/A | #N/A | #N/A | #N/A
EL-CA0017 | HDMI cable for Raspberry Pi | #N/A | #N/A | #N/A | PCE | 0 | #N/A | #N/A | #N/A | #N/A | 0 | #N/A | #N/A | #N/A | #N/A | #N/A | #N/A | #N/A | #N/A
EL-CA0018 | Lot of Male to Male A/A USB cables | #N/A | #N/A | #N/A | PCE | 0 | #N/A | #N/A | #N/A | #N/A | 0 | #N/A | #N/A | #N/A | #N/A | #N/A | #N/A | #N/A | #N/A
EL-CA0019 | USB DATA CABLE | #N/A | #N/A | #N/A | PCE | 0 | #N/A | #N/A | #N/A | #N/A | 0 | #N/A | #N/A | #N/A | #N/A | #N/A | #N/A | #N/A | #N/A
EL-CA0020 | USB Extension Cable | #N/A | #N/A | #N/A | PCE | 0 | #N/A | #N/A | #N/A | #N/A | 0 | #N/A | #N/A | #N/A | #N/A | #N/A | #N/A | #N/A | #N/A
EL-CA0021 | AmazonBasics High-Speed HDMI Cable (6.5 Feet/2.0 Meters) - Supports Ethernet, 3D, and Audio Return [Newest Standard] | #N/A | #N/A | #N/A | PCE | 0 | #N/A | #N/A | #N/A | #N/A | 0 | #N/A | #N/A | #N/A | #N/A | #N/A | #N/A | #N/A | #N/A
EL-CA0022 | Micro HDMI Low Profile Cable | #N/A | #N/A | #N/A | PCE | 0 | #N/A | #N/A | #N/A | #N/A | 0 | #N/A | #N/A | #N/A | #N/A | #N/A | #N/A | #N/A | #N/A
EL-CA0023 | 50ft Ultra Slim Series High Performance HDMI® Cable w/ RedMere® Technology | #N/A | #N/A | #N/A | PCE | Q5-3X-3/4-01 | #N/A | #N/A | #N/A | #N/A | 0 | #N/A | #N/A | #N/A | #N/A | #N/A | #N/A | #N/A | #N/A
EL-CA0024 | 3FT 24AWG Cat5e 350MHz UTP Bare Copper Ethernet Network Cable - Black, 2132 | #N/A | #N/A | #N/A | PCE | 0 | #N/A | #N/A | #N/A | #N/A | 0 | #N/A | #N/A | #N/A | #N/A | #N/A | #N/A | #N/A | #N/A
EL-CA0025 | 7FT 24AWG Cat5e 350MHz UTP Bare Copper Ethernet Network Cable - Black, 2139 | #N/A | #N/A | #N/A | PCE | 0 | #N/A | #N/A | #N/A | #N/A | 0 | #N/A | #N/A | #N/A | #N/A | #N/A | #N/A | #N/A | #N/A
EL-CA0026 | 14FT 24AWG Cat5e 350MHz UTP Bare Copper Ethernet Network Cable - Black, 2145 | #N/A | #N/A | #N/A | PCE | Q5-3X-3/4-01 | #N/A | #N/A | #N/A | #N/A | 0 | #N/A | #N/A | #N/A | #N/A | #N/A | #N/A | #N/A | #N/A
EL-CA0027 | 20FT 24AWG Cat5e 350MHz UTP Bare Copper Ethernet Network Cable - Black, 4984 | #N/A | #N/A | #N/A | PCE | 0 | #N/A | #N/A | #N/A | #N/A | 0 | #N/A | #N/A | #N/A | #N/A | #N/A | #N/A | #N/A | #N/A
EL-CA0028 | 25FT 24AWG Cat5e 350MHz UTP Bare Copper Ethernet Network Cable - Black, 2151 | #N/A | #N/A | #N/A | PCE | 0 | #N/A | #N/A | #N/A | #N/A | 0 | #N/A | #N/A | #N/A | #N/A | #N/A | #N/A | #N/A | #N/A
EL-CA0029 | 10FT 24AWG Cat5e 350MHz UTP Bare Copper Ethernet Network Cable - Black, 3384 | #N/A | #N/A | #N/A | PCE | FSD74-6 | #N/A | #N/A | #N/A | #N/A | 0 | #N/A | #N/A | #N/A | #N/A | #N/A | #N/A | #N/A | #N/A
EL-CA0030 | North American - 6ft 18AWG Power Cord Cable w/ 3 Conductor PC Power Connector Socket (C13/5-15P) - Black, 5279, Box of 125 | #N/A | #N/A | #N/A | PCE | Q5-3X-3/4-01 | #N/A | #N/A | #N/A | #N/A | 0 | #N/A | #N/A | #N/A | #N/A | #N/A | #N/A | #N/A | #N/A
EL-CA0031 | 6ft 18AWG England Power Cord Cable - H05VV-F NEMA C13 - Black , Box of 75 | #N/A | #N/A | #N/A | PCE | 0 | #N/A | #N/A | #N/A | #N/A | 0 | #N/A | #N/A | #N/A | #N/A | #N/A | #N/A | #N/A | #N/A
EL-CA0032 | 6ft 18AWG European Power Cord Cable - H05VV-F NEMA C13 - Black, 125 per box | #N/A | #N/A | #N/A | PCE | 0 | #N/A | #N/A | #N/A | #N/A | 0 | #N/A | #N/A | #N/A | #N/A | #N/A | #N/A | #N/A | #N/A
EL-CA0033 | 10ft 18AWG Power Cord Cable w/ 3 Conductor PC Power Connector Socket (C13/5-15P) - Black, 5280 | #N/A | #N/A | #N/A | PCE | 0 | #N/A | #N/A | #N/A | #N/A | 0 | #N/A | #N/A | #N/A | #N/A | #N/A | #N/A | #N/A | #N/A
EL-CA0034 | 15ft 18AWG Power Cord Cable w/ 3 Conductor PC Power Connector Socket (C13/5-15P) - Black, 5281 | #N/A | #N/A | #N/A | PCE | 0 | #N/A | #N/A | #N/A | #N/A | 0 | #N/A | #N/A | #N/A | #N/A | #N/A | #N/A | #N/A | #N/A
EL-CA0035 | CABLE 22AWG 2COND 300V 152M | #N/A | #N/A | #N/A | PCE | 4634140204390 | #N/A | #N/A | #N/A | #N/A | 4634140204390 | #N/A | #N/A | #N/A | #N/A | #N/A | #N/A | #N/A | #N/A
EL-CA0036 | Velcro Reusable Self-Gripping Cable Ties, 0.5 Inches x 8 Inches Long, Black, 100 Ties per Pack (91140) | #N/A | #N/A | #N/A | PCE | 4634140204391 | #N/A | #N/A | #N/A | #N/A | 4634140204391 | #N/A | #N/A | #N/A | #N/A | #N/A | #N/A | #N/A | #N/A
EL-CA0037 | 5FT 24AWG Cat5e 350MHz UTP Bare Copper Ethernet Network Cable - Black, 3375 | #N/A | #N/A | #N/A | PCE | 0 | #N/A | #N/A | #N/A | #N/A | 0 | #N/A | #N/A | #N/A | #N/A | #N/A | #N/A | #N/A | #N/A
EL-CA0038 | Patch Cord, Cat5E, 7 foot | #N/A | #N/A | #N/A | PCE | 0 | #N/A | #N/A | #N/A | #N/A | 0 | #N/A | #N/A | #N/A | #N/A | #N/A | #N/A | #N/A | #N/A
EL-CA0039 | Patch Cord, Cat5E, 10 foot | #N/A | #N/A | #N/A | PCE | 0 | #N/A | #N/A | #N/A | #N/A | 0 | #N/A | #N/A | #N/A | #N/A | #N/A | #N/A | #N/A | #N/A
EL-CA0040 | Patch Cord, Cat5E, 3 foot | #N/A | #N/A | #N/A | PCE | 0 | #N/A | #N/A | #N/A | #N/A | 0 | #N/A | #N/A | #N/A | #N/A | #N/A | #N/A | #N/A | #N/A
EL-CA0041 | C2G / Cables to Go 27329 WSB 2.0 A to Mini-B Cable, Black (1 Meter/3.28 Feet) | #N/A | #N/A | #N/A | PCE | 0 | #N/A | #N/A | #N/A | #N/A | 0 | #N/A | #N/A | #N/A | #N/A | #N/A | #N/A | #N/A | #N/A
EL-CA0042 | 50 Ft Power Extension Cable | #N/A | #N/A | #N/A | PCE | 0 | #N/A | #N/A | #N/A | #N/A | 0 | #N/A | #N/A | #N/A | #N/A | #N/A | #N/A | #N/A | #N/A
EL-CA0043 | Olimex Ribbon Cables / IDC Cables UEXT FEM-FEM REPLACEMENT CABLE | 0 | 0 | 0 | PCE | 0 | Electronic | 29.58 |  | 0 | 0 | IGUS | 0 | 0 | 0 | 0 | 0 | 0 | 0
EL-CA0044 | Olimex Specialized Cables USB TO SERIAL CABLE | #N/A | #N/A | #N/A | PCE | 0 | #N/A | #N/A | #N/A | #N/A | 0 | #N/A | #N/A | #N/A | #N/A | #N/A | #N/A | #N/A | #N/A
EL-CA0045 | 1.5ft USB 2.0 A Male to Micro 5pin Male 28/28AWG Cable | #N/A | #N/A | #N/A | PCE | 0 | #N/A | #N/A | #N/A | #N/A | 0 | #N/A | #N/A | #N/A | #N/A | #N/A | #N/A | #N/A | #N/A
EL-CA0046 | Panel Mount USB Cable - A Male to A Female | #N/A | #N/A | #N/A | PCE | 0 | #N/A | #N/A | #N/A | #N/A | 0 | #N/A | #N/A | #N/A | #N/A | #N/A | #N/A | #N/A | #N/A
EL-CA0047 | Panel Mount Ethernet Extension Cable | 0 | 0 | 0 | PCE | 0 | Electronic | 73.26 |  | 0 | 0 | IGUS | 0 | 0 | 0 | 0 | 0 | 0 | 0
EL-CA0048 | 1.5ft 28AWG High Speed HDMI® Cable w/Ferrite Cores - Black | #N/A | #N/A | #N/A | PCE | CR282-ND | #N/A | 0.30414 | #N/A | #N/A | 09080-G | Digi-Key | #N/A | #N/A | #N/A | #N/A | #N/A | #N/A | #N/A
EL-CA0049 | Serial Debug Cable for pcDuino | #N/A | #N/A | #N/A | PCE | CR212-ND | #N/A | #N/A | #N/A | #N/A | 09325-F/30 | #N/A | #N/A | #N/A | #N/A | #N/A | #N/A | #N/A | #N/A
EL-CA0050 | 15ft 24AWG CL2 Standard HDMI® Cable Male to Female Extension - Black, 3344 | #N/A | #N/A | #N/A | PCE | 1053-1394-ND | #N/A | #N/A | #N/A | #N/A | GRM80-45 | #N/A | #N/A | #N/A | #N/A | #N/A | #N/A | #N/A | #N/A
EL-CA0051 | 25ft 24AWG CL2 Standard HDMI® Cable Male to Female Extension - Black, 3345 | #N/A | #N/A | #N/A | PCE | CR226-ND | #N/A | #N/A | #N/A | #N/A | 09325-G | #N/A | #N/A | #N/A | #N/A | #N/A | #N/A | #N/A | #N/A
EL-CA0052 | 10ft 24AWG CL2 Silver Plated High Speed HDMI® Cable - Black, 3659 | #N/A | #N/A | #N/A | PCE | 0 | #N/A | #N/A | #N/A | #N/A | 0 | #N/A | #N/A | #N/A | #N/A | #N/A | #N/A | #N/A | #N/A
EL-CA0053 | CABLE 40COND GRAY 25' RIBBON | #N/A | #N/A | #N/A | PCE | 0 | #N/A | #N/A | #N/A | #N/A | 0 | #N/A | #N/A | #N/A | #N/A | #N/A | #N/A | #N/A | #N/A
EL-CA0054 | AmazonBasics High-Speed HDMI Cable - 3 Feet (0.9 Meter) - Supports Ethernet, 3D and Audio Return | #N/A | #N/A | #N/A | PCE | 0 | #N/A | #N/A | #N/A | #N/A | 0 | #N/A | #N/A | #N/A | #N/A | #N/A | #N/A | #N/A | #N/A
EL-CA0055 | 7FT FLEXboot Series 24AWG Cat5e 350MHz UTP Bare Copper Ethernet Network Cable - Black, 11381 | #N/A | #N/A | #N/A | PCE | 0 | #N/A | #N/A | #N/A | #N/A | 0 | #N/A | #N/A | #N/A | #N/A | #N/A | #N/A | #N/A | #N/A
EL-CA0056 | 6ft 18AWG Australian Power Cord Cable - H05VV-FNEMA C13 - Black, Box of 75 | #N/A | #N/A | #N/A | PCE | 0 | #N/A | #N/A | #N/A | #N/A | 0 | #N/A | #N/A | #N/A | #N/A | #N/A | #N/A | #N/A | #N/A
EL-CA0057 | Cable Assembly SMA STR Plug RG58 36" | #N/A | #N/A | #N/A | PCE | 0 | #N/A | #N/A | #N/A | #N/A | 0 | #N/A | #N/A | #N/A | #N/A | #N/A | #N/A | #N/A | #N/A
EL-CA0059 | 110A Probe Cable | #N/A | #N/A | #N/A | PCE | 0 | #N/A | #N/A | #N/A | #N/A | 0 | #N/A | #N/A | #N/A | #N/A | #N/A | #N/A | #N/A | #N/A
EL-CA0060 | Cable Molded RG58/U 48" | #N/A | #N/A | #N/A | PCE | 0 | #N/A | #N/A | #N/A | #N/A | 0 | #N/A | #N/A | #N/A | #N/A | #N/A | #N/A | #N/A | #N/A
EL-CA0061 | Black Extension Cord, 14 Gauge Wire, 3' Long | #N/A | #N/A | #N/A | PCE | 0 | #N/A | #N/A | #N/A | #N/A | 0 | #N/A | #N/A | #N/A | #N/A | #N/A | #N/A | #N/A | #N/A
EL-CA0062 | Black Extension Cord, 14 Gauge Wire, 6' Long | #N/A | #N/A | #N/A | PCE | 0 | #N/A | #N/A | #N/A | #N/A | 0 | #N/A | #N/A | #N/A | #N/A | #N/A | #N/A | #N/A | #N/A
EL-CA0063 | 6ft Tripp Lite - USB 2.0 A/B Gold Device Cable Ferrite Chokes A Male B Male | #N/A | #N/A | #N/A | PCE | 0 | #N/A | #N/A | #N/A | #N/A | 0 | #N/A | #N/A | #N/A | #N/A | #N/A | #N/A | #N/A | #N/A
EL-CA0064 | Cable 2PR CPU SHLD PVC 22 AWG 50' | #N/A | #N/A | #N/A | PCE | 0 | #N/A | #N/A | #N/A | #N/A | 0 | #N/A | #N/A | #N/A | #N/A | #N/A | #N/A | #N/A | #N/A
EL-CA0065 | 3ft HDMI Cable - Black | #N/A | #N/A | #N/A | PCE | 0 | #N/A | #N/A | #N/A | #N/A | 0 | #N/A | #N/A | #N/A | #N/A | #N/A | #N/A | #N/A | #N/A
EL-CA0066 | 10FT 24AWG Cat5e 350MHz UTP Bare Copper Ethernet Network Cable - White | #N/A | #N/A | #N/A | PCE | 0 | #N/A | #N/A | #N/A | #N/A | 0 | #N/A | #N/A | #N/A | #N/A | #N/A | #N/A | #N/A | #N/A
EL-CA0067 | Coboc CY-CAT5E-10-BK 10ft.24AWG Snagless Cat 5e Black Color 350MHz UTP Ethernet Stranded Copper Patch cord /Molded Network lan C | #N/A | #N/A | #N/A | PCE | 0 | #N/A | #N/A | #N/A | #N/A | 0 | #N/A | #N/A | #N/A | #N/A | #N/A | #N/A | #N/A | #N/A
EL-CA0068 | 1.5 Feet USB 2.0 Extender Cable - A Male to A Female 28/24AWG Extension Gold Plated (Black) | #N/A | #N/A | #N/A | PCE | 0 | #N/A | #N/A | #N/A | #N/A | 0 | #N/A | #N/A | #N/A | #N/A | #N/A | #N/A | #N/A | #N/A
EL-CA0069 | 15ft USB 2.0 A Male to Micro 5pin Male 28/24 AWG Cable w/Ferrite Core (Gold Plated) | #N/A | #N/A | #N/A | PCE | 0 | #N/A | #N/A | #N/A | #N/A | 0 | #N/A | #N/A | #N/A | #N/A | #N/A | #N/A | #N/A | #N/A
EL-CA0070 | 15ft. USB 2.0 A Male to Mini - B 5pin Male 28/24 AWG Cable w/Ferrite Core (Gold Plated)
EL-CA0071 | Plantronics APD-80 CS500/SAVI EHS For Grandstream | #N/A | #N/A | #N/A | PCE | HH-PT1IN_FT | #N/A | #N/A | #N/A | #N/A | 0 | #N/A | #N/A | #N/A | #N/A | #N/A | #N/A | #N/A | #N/A
EL-CA0072 | 10ft USB Cable 2.0 EXT 3M Gold, A Male to A Female | #N/A | #N/A | #N/A | PCE | HH-PT1IN_1x4 | #N/A | #N/A | #N/A | #N/A | 0 | #N/A | #N/A | #N/A | #N/A | #N/A | #N/A | #N/A | #N/A
EL-CA0073 | Belden 1310A 010U500 Multi-Conductor Cables 14AWG 4C UNSHLD, BLACK | #N/A | #N/A | #N/A | PCE | HH-PT1IN_MT | #N/A | #N/A | #N/A | #N/A | 0 | #N/A | #N/A | #N/A | #N/A | #N/A | #N/A | #N/A | #N/A
EL-CA0073- old | OLD - Multi-Conductor Cables 14AWG 4C UNSHLD 500ft BOX BLACK | #N/A | #N/A | #N/A | PCE | HH-PT1IN_1x2 | #N/A | #N/A | #N/A | #N/A | 0 | #N/A | #N/A | #N/A | #N/A | #N/A | #N/A | #N/A | #N/A
EL-CA0074 | AmazonBasics High-Speed HDMI Cable 2-Pack - 3 Feet | #N/A | #N/A | #N/A | PCE | HH-PT1IN_1x3 | #N/A | #N/A | #N/A | #N/A | 0 | #N/A | #N/A | #N/A | #N/A | #N/A | #N/A | #N/A | #N/A
EL-CA0075 | Monoprice 109767 3-Feet 3.5mm Stereo Male to RCA Stereo Male Gold Plated Cable for Mobile, Black | #N/A | #N/A | #N/A | PCE | 70355K76 | #N/A | #N/A | #N/A | #N/A | 0 | #N/A | #N/A | #N/A | #N/A | #N/A | #N/A | #N/A | #N/A
EL-CA0076 | Ativa® 6' High-Speed HDMI Cable Kit, Black | #N/A | #N/A | #N/A | PCE | 0 | #N/A | #N/A | #N/A | #N/A | 0 | #N/A | #N/A | #N/A | #N/A | #N/A | #N/A | #N/A | #N/A
EL-CA0077 | ONN miniHDMI to HDMI Cable, 3', Black | 0 | 0 | 0 | PCE | 879-1327G6-BK | Electronic | 0.192 |  | Anderson | 1327G6-BK | SAGER | 879-1327G6-BK | 0 | 0 | 0 | 0 | 0 | 0
EL-CA0078 | Flat Cables .050" 10C 10 COLOR 28AWG STRANDED | #N/A | #N/A | #N/A | cm | 7432K91 | #N/A | #N/A | #N/A | #N/A | 0 | #N/A | #N/A | #N/A | #N/A | #N/A | #N/A | #N/A | #N/A
EL-CA0079 | Electop USB 2.0 A Female To 2 Dual USB Male Jack Y Splitter Charger Cable | 0 | 0 | 0 | PCE | 879-1332-BK | Electronic | 0.1 |  | Anderson | 1332-BK | Mouser | 879-1332-BK | 0 | 0 | 0 | 0 | 0 | 0
EL-CA0080 | 6ft 16 AWG 1-to-2 Power Cord Splitter (NEMA 5-15P to 1 NEMA 5-15R + 1 IEC320C13) | #N/A | #N/A | #N/A | cm | 7432K93 | #N/A | #N/A | #N/A | #N/A | 0 | #N/A | #N/A | #N/A | #N/A | #N/A | #N/A | #N/A | #N/A
EL-CA0081 | Cable Matters Micro USB SlimPort (MyDP) to HDMI 6 Foot Cable with 6 Foot USB Charging Cable | #N/A | #N/A | #N/A | PCE | 9681K15 | #N/A | #N/A | #N/A | #N/A | 0 | #N/A | #N/A | #N/A | #N/A | #N/A | #N/A | #N/A | #N/A
EL-CA0082 | 6ft Japan NEMA 5-15P 3-pin to C13 Power Cord with VCTF 0.75mm, Black (Box of 100) | #N/A | #N/A | #N/A | PCE | 9681K17 | #N/A | #N/A | #N/A | #N/A | 0 | #N/A | #N/A | #N/A | #N/A | #N/A | #N/A | #N/A | #N/A
EL-CA0083 | Commercial Series Standard HDMI® Cable with Ethernet, 25ft Black | #N/A | #N/A | #N/A | PCE | 9681K21 | #N/A | #N/A | #N/A | #N/A | 0 | #N/A | #N/A | #N/A | #N/A | #N/A | #N/A | #N/A | #N/A
EL-CA0084 | Cat6 24AWG UTP Ethernet Network Patch Cable, 6-inch Black | #N/A | #N/A | #N/A | PCE | 538-19003-0107 | #N/A | #N/A | #N/A | #N/A | 0 | #N/A | #N/A | #N/A | #N/A | #N/A | #N/A | #N/A | #N/A
EL-CA0085 | Cat6 24AWG UTP Ethernet Network Patch Cable, 6-inch Gray | #N/A | #N/A | #N/A | PCE | 0 | #N/A | #N/A | #N/A | #N/A | 0 | #N/A | #N/A | #N/A | #N/A | #N/A | #N/A | #N/A | #N/A
EL-CA0086 | Cat6 24AWG UTP Ethernet Network Patch Cable, 6-inch Orange | #N/A | #N/A | #N/A | PCE | 0 | #N/A | #N/A | #N/A | #N/A | 0 | #N/A | #N/A | #N/A | #N/A | #N/A | #N/A | #N/A | #N/A
EL-CA0087 | Cat6 24AWG UTP Ethernet Network Patch Cable, 6-inch Red | #N/A | #N/A | #N/A | PCE | 0 | #N/A | #N/A | #N/A | #N/A | 0 | #N/A | #N/A | #N/A | #N/A | #N/A | #N/A | #N/A | #N/A
EL-CA0088 | Cat6 24AWG UTP Ethernet Network Patch Cable, 6-inch Yellow | #N/A | #N/A | #N/A | PCE | 0 | #N/A | #N/A | #N/A | #N/A | 0 | #N/A | #N/A | #N/A | #N/A | #N/A | #N/A | #N/A | #N/A
EL-CA0089 | Cat6 24AWG UTP Ethernet Network Patch Cable, 1ft Black | #N/A | #N/A | #N/A | PCE | HH-PT1IN_1x5 | #N/A | #N/A | #N/A | #N/A | 0 | #N/A | #N/A | #N/A | #N/A | #N/A | #N/A | #N/A | #N/A
EL-CA0090 | Cat6 24AWG UTP Ethernet Network Patch Cable, 1ft Gray | #N/A | #N/A | #N/A | PCE | HH-SC_UNH | #N/A | #N/A | #N/A | #N/A | 0 | #N/A | #N/A | #N/A | #N/A | #N/A | #N/A | #N/A | #N/A
EL-CA0091 | Cat6 24AWG UTP Ethernet Network Patch Cable, 1ft Orange | #N/A | #N/A | #N/A | PCE | HH-SC_UNS | #N/A | #N/A | #N/A | #N/A | 0 | #N/A | #N/A | #N/A | #N/A | #N/A | #N/A | #N/A | #N/A
EL-CA0091 | Cat6 24AWG UTP Ethernet Network Patch Cable, 1ft Orange | #N/A | #N/A | #N/A | PCE | HH-SC_FJH | #N/A | #N/A | #N/A | #N/A | 0 | #N/A | #N/A | #N/A | #N/A | #N/A | #N/A | #N/A | #N/A
EL-CA0092 | Cat6 24AWG UTP Ethernet Network Patch Cable, 1ft Red | #N/A | #N/A | #N/A | PCE | HH-SC_FJS | #N/A | #N/A | #N/A | #N/A | 0 | #N/A | #N/A | #N/A | #N/A | #N/A | #N/A | #N/A | #N/A
EL-CA0093 | Cat6 24AWG UTP Ethernet Network Patch Cable, 1ft Yellow | #N/A | #N/A | #N/A | PCE | HH-PT1IN_1x1 | #N/A | #N/A | #N/A | #N/A | 0 | #N/A | #N/A | #N/A | #N/A | #N/A | #N/A | #N/A | #N/A
EL-CA0094 | Cat6 24AWG UTP Ethernet Network Patch Cable, 2ft Black | #N/A | #N/A | #N/A | PCE | HH-PT1IN_1x6 | #N/A | #N/A | #N/A | #N/A | 0 | #N/A | #N/A | #N/A | #N/A | #N/A | #N/A | #N/A | #N/A
EL-CA0095 | Cat6 24AWG UTP Ethernet Network Patch Cable, 2ft Gray | #N/A | #N/A | #N/A | PCE | HH-PT1IN_1x7 | #N/A | #N/A | #N/A | #N/A | 0 | #N/A | #N/A | #N/A | #N/A | #N/A | #N/A | #N/A | #N/A
EL-CA0096 | Cat6 24AWG UTP Ethernet Network Patch Cable, 2ft Orange | #N/A | #N/A | #N/A | PCE | HH-PT1IN_1x8 | #N/A | #N/A | #N/A | #N/A | 0 | #N/A | #N/A | #N/A | #N/A | #N/A | #N/A | #N/A | #N/A
EL-CA0097 | Cat6 24AWG UTP Ethernet Network Patch Cable, 2ft Red | #N/A | #N/A | #N/A | PCE | HH-PT1IN_1x9 | #N/A | #N/A | #N/A | #N/A | 0 | #N/A | #N/A | #N/A | #N/A | #N/A | #N/A | #N/A | #N/A
EL-CA0098 | Cat6 24AWG UTP Ethernet Network Patch Cable, 2ft Yellow | #N/A | #N/A | #N/A | PCE | HH-PT1IN_1x10 | #N/A | #N/A | #N/A | #N/A | 0 | #N/A | #N/A | #N/A | #N/A | #N/A | #N/A | #N/A | #N/A
EL-CA0099 | Cat6 24AWG UTP Ethernet Network Patch Cable, 25ft White | #N/A | #N/A | #N/A | PCE | HH-PT1IN_2x2 | #N/A | #N/A | #N/A | #N/A | 0 | #N/A | #N/A | #N/A | #N/A | #N/A | #N/A | #N/A | #N/A
EL-CA0100 | Cat6 24AWG UTP Ethernet Network Patch Cable, 75ft White | #N/A | #N/A | #N/A | PCE | HH-PT1IN_2x3 | #N/A | #N/A | #N/A | #N/A | 0 | #N/A | #N/A | #N/A | #N/A | #N/A | #N/A | #N/A | #N/A
EL-CA0101 | Cable Matters USB 3.1 Type C (USB-C) to Type A (USB-A) Cable in Black 3.3 Feet | #N/A | #N/A | #N/A | PCE | HH-PT1IN_2x4 | #N/A | #N/A | #N/A | #N/A | 0 | #N/A | #N/A | #N/A | #N/A | #N/A | #N/A | #N/A | #N/A
EL-CA0102 | Mediabridge USB 2.0 - Mini-USB to USB Cable (8 Feet) - High-Speed A Male to Mini B with Gold-Plated Connectors | #N/A | #N/A | #N/A | PCE | HH-PT1IN_2x5 | #N/A | #N/A | #N/A | #N/A | 0 | #N/A | #N/A | #N/A | #N/A | #N/A | #N/A | #N/A | #N/A
EL-CA0103 | 3ft USB 2.0 A Male to Mini-B 5pin Male 28/24AWG Cable w/ Ferrite Core (Gold Plated) | #N/A | #N/A | #N/A | PCE | HH-PT1IN_SRSH40 | #N/A | #N/A | #N/A | #N/A | 0 | #N/A | #N/A | #N/A | #N/A | #N/A | #N/A | #N/A | #N/A
EL-CA0104 | 6ft USB 2.0 A Male to Mini-B 5pin Male 28/24AWG Cable w/ Ferrite Core (Gold Plated) | #N/A | #N/A | #N/A | PCE | HH-PT1IN_SRSH80 | #N/A | #N/A | #N/A | #N/A | 0 | #N/A | #N/A | #N/A | #N/A | #N/A | #N/A | #N/A | #N/A
EL-CA0105 | JST 6 Position Cable Assembly Rectangular Socket to Socket 0.500' (152.40mm, 6.00") | #N/A | #N/A | #N/A | PCE | HH-PT1IN_SRRAH40 | #N/A | #N/A | #N/A | #N/A | 0 | #N/A | #N/A | #N/A | #N/A | #N/A | #N/A | #N/A | #N/A
EL-CA0106 | Select Series High Speed HDMI® Cable, 3ft Black | #N/A | #N/A | #N/A | PCE | HH-PT1IN_SRRAH80 | #N/A | #N/A | #N/A | #N/A | 0 | #N/A | #N/A | #N/A | #N/A | #N/A | #N/A | #N/A | #N/A
EL-CA0107 | Cable Matters 5-Color Combo, Cat6 Snagless Ethernet Patch Cable in Black, Blue, White, Red, and Green 1 Foot | #N/A | #N/A | #N/A | PCE | HH-PT1IN_SCFMA | #N/A | #N/A | #N/A | #N/A | 0 | #N/A | #N/A | #N/A | #N/A | #N/A | #N/A | #N/A | #N/A
EL-CA0108 | Cable Matters 5-Color Combo, Cat6 Snagless Ethernet Patch Cable in Black, Blue, White, Red, and Green 3 Feet | #N/A | #N/A | #N/A | PCE | HH-PT1IN_SRFMA40 | #N/A | #N/A | #N/A | #N/A | 0 | #N/A | #N/A | #N/A | #N/A | #N/A | #N/A | #N/A | #N/A
EL-CA0109 | AmazonBasics RJ45 Cat-6 Ethernet Patch Cable - 5 Feet (1.5 Meters) | #N/A | #N/A | #N/A | PCE | HH-PT1IN_SRFMA80 | #N/A | #N/A | #N/A | #N/A | 0 | #N/A | #N/A | #N/A | #N/A | #N/A | #N/A | #N/A | #N/A
EL-CA0110 | Cable Cat-5E - 3 Feet Blue | #N/A | #N/A | #N/A | PCE | HH-SC_3WM | #N/A | #N/A | #N/A | #N/A | 0 | #N/A | #N/A | #N/A | #N/A | #N/A | #N/A | #N/A | #N/A
EL-CA0111 | 1 ft 350MHz, Cat5E C | #N/A | #N/A | #N/A | PCE | 70313867 | #N/A | #N/A | #N/A | #N/A | 0 | #N/A | #N/A | #N/A | #N/A | #N/A | #N/A | #N/A | #N/A
EL-CA0112 | 15 ft 350MHz, Cat5E E | #N/A | #N/A | #N/A | PCE | HH-SC_PCB_PT1INSS | #N/A | #N/A | #N/A | #N/A | 0 | #N/A | #N/A | #N/A | #N/A | #N/A | #N/A | #N/A | #N/A
EL-CA0113 | Product Title Blackweb CAT6 High-Performance Snagless Patch Cable, 14' | #N/A | #N/A | #N/A | PCE | HH-SC_PCB_USCA | #N/A | #N/A | #N/A | #N/A | 0 | #N/A | #N/A | #N/A | #N/A | #N/A | #N/A | #N/A | #N/A
EL-CA0114 | AmazonBasics High-Speed Micro-HDMI to HDMI Cable - 3 Feet | #N/A | #N/A | #N/A | PCE | HH-LEAD_DX22-08 | #N/A | #N/A | #N/A | #N/A | 0 | #N/A | #N/A | #N/A | #N/A | #N/A | #N/A | #N/A | #N/A
EL-CA0115 | Cat6 24AWG UTP Ethernet Network Patch Cable, 3 ft | #N/A | #N/A | #N/A | PCE | ALE-0000217 | #N/A | #N/A | #N/A | #N/A | 0 | #N/A | #N/A | #N/A | #N/A | #N/A | #N/A | #N/A | #N/A
EL-CA0116 | Patch Cord, Cat5E, 15 foot | #N/A | #N/A | #N/A | PCE | 9681K28 | #N/A | #N/A | #N/A | #N/A | 0 | #N/A | #N/A | #N/A | #N/A | #N/A | #N/A | #N/A | #N/A
EL-CA0117 | Patch Cord, Cat5E, 7 foot | #N/A | #N/A | #N/A | PCE | 9681K25 | #N/A | #N/A | #N/A | #N/A | 0 | #N/A | #N/A | #N/A | #N/A | #N/A | #N/A | #N/A | #N/A
EL-CA0118 | Cat 6 Network Cable, 14, Blue | #N/A | #N/A | #N/A | PCE | 9681K21 | #N/A | #N/A | #N/A | #N/A | 0 | #N/A | #N/A | #N/A | #N/A | #N/A | #N/A | #N/A | #N/A
EL-CA0119 | Cat 6 Network Cable, 14, Black | #N/A | #N/A | #N/A | PCE | 9681K13 | #N/A | #N/A | #N/A | #N/A | 0 | #N/A | #N/A | #N/A | #N/A | #N/A | #N/A | #N/A | #N/A
EL-CA0120 | Cat 6 Network Cable, 25, Blue | #N/A | #N/A | #N/A | PCE | 9681K11 | #N/A | #N/A | #N/A | #N/A | 0 | #N/A | #N/A | #N/A | #N/A | #N/A | #N/A | #N/A | #N/A
EL-CA0121 | Cat 6 Network Cable, 25', Black | #N/A | #N/A | #N/A | PCE | 70175099 | #N/A | #N/A | #N/A | #N/A | 0 | #N/A | #N/A | #N/A | #N/A | #N/A | #N/A | #N/A | #N/A
EL-CA0122 | GearIT 8-Pack, Cat 6 Ethernet Cable Cat6 Snagless Patch 15 Feet - Snagless RJ45 Computer LAN Network Cord, Black - Compatible with 8 Port Switch POE 8port Gigabit | #N/A | #N/A | #N/A | PCE | ENS1J-B28-L00256L-ND | #N/A | #N/A | #N/A | #N/A | 0 | #N/A | #N/A | #N/A | #N/A | #N/A | #N/A | #N/A | #N/A
EL-CA0123 | GearIT 10 Pack, Cat 6 Ethernet Cable Cat6 Snagless Patch 10 Feet - Computer LAN Network Cord, Black - Compatible with 10 Port Switch POE 10port Gigabit | #N/A | #N/A | #N/A | PCE | 0 | #N/A | #N/A | #N/A | #N/A | 0 | #N/A | #N/A | #N/A | #N/A | #N/A | #N/A | #N/A | #N/A
EL-CA0124 | GearIT 10 Pack, Cat 6 Ethernet Cable Cat6 Snagless Patch 6 Feet - Computer LAN Network Cord, Black - Compatible with 10 Port Switch POE 10port Gigabit | #N/A | #N/A | #N/A | PCE | 4446T72 | #N/A | #N/A | #N/A | #N/A | 0 | #N/A | #N/A | #N/A | #N/A | #N/A | #N/A | #N/A | #N/A
EL-CA0125 | GearIT 10 Pack, Cat 6 Ethernet Cable Cat6 Snagless Patch 2 Feet - Computer LAN Network Cord, Black - Compatible with 10 Port Switch POE 10port Gigabit | #N/A | #N/A | #N/A | PCE | 4446T74 | #N/A | #N/A | #N/A | #N/A | 0 | #N/A | #N/A | #N/A | #N/A | #N/A | #N/A | #N/A | #N/A
EL-CA0126 | GearIT 5-Pack, Cat 6 Ethernet Cable Cat6 Snagless Patch 5 Feet - Snagless RJ45 Computer LAN Network Cord, Orange - Compatible with 5 Port Switch POE 5port Gigabit | #N/A | #N/A | #N/A | PCE | 1-66106-5 | #N/A | #N/A | #N/A | #N/A | 16-02-0108 | #N/A | #N/A | #N/A | #N/A | #N/A | #N/A | #N/A | #N/A
EL-CA0127 | GearIT 5-Pack, Cat 6 Ethernet Cable Cat6 Snagless Patch 3 Feet - Snagless RJ45 Computer LAN Network Cord, Orange - Compatible with 5 Port Switch POE 5port Gigabit | 0 | 0 | 0 | PCE | 16-02-0086 | Electronic | 0.0146 |  | Molex Inc. | 16-02-0086 / 16-02-0102 | TTI | WM2510TR-ND | 0 | 0 | 0 | 0 | 0 | 0
EL-CA0128 | GearIT 3 Feet Cat 6 Ethernet Cable Cat6 Snagless Patch - Computer LAN Network Cord, White | #N/A | #N/A | #N/A | PCE | 534-8291 | #N/A | #N/A | #N/A | #N/A | 0 | #N/A | #N/A | #N/A | #N/A | #N/A | #N/A | #N/A | #N/A
EL-CA0129 | GearIT 16-Pack, Cat 6 Ethernet Cable Cat6 Snagless Patch 1 Foot - Snagless RJ45 Computer LAN Network Cord, Blue - Compatible with 16 Port Switch POE 16port Gigabit | 0 | 0 | 0 | PCE | 701070003 | Electronic | 0.116 |  | Molex | 701070003 | SAGER | WM2535-ND | 0 | 0 | 0 | 0 | 0 | 0
EL-CA0130 | GearIT 20 Feet Cat 6 Ethernet Cable Cat6 Snagless Patch - Computer LAN Network Cord, Pink | 0 | 0 | 0 | PCE | ALE-0000191 | Electronic | 0.0523 |  | Molex Inc. | 50579404 | SAGER | WM2902-ND | 0 | 0 | 0 | 0 | 0 | 0
EL-CA0131 | GearIT 5-Pack, Cat 6 Ethernet Cable Cat6 Snagless Patch 1 Foot - Snagless RJ45 Computer LAN Network Cord, Yellow - Compatible with 5 Port Switch POE 5port Gigabit | #N/A | #N/A | #N/A | PCE | ED2581-ND | #N/A | #N/A | #N/A | #N/A | 0 | #N/A | #N/A | #N/A | #N/A | #N/A | #N/A | #N/A | #N/A
EL-CA0132 | GearIT 25 Feet Cat 6 Ethernet Cable Cat6 Snagless Patch - Computer LAN Network Cord, Blue | #N/A | #N/A | #N/A | PCE | B00200K1TI | #N/A | #N/A | #N/A | #N/A | 0 | #N/A | #N/A | #N/A | #N/A | #N/A | #N/A | #N/A | #N/A
EL-CA0133 | GearIT 5 Pack, Cat 6 Ethernet Cable Cat6 Snagless Patch 20 Feet - Computer LAN Network Cord, Blue - Compatible with 5 Port Switch POE 5port Gigabit | #N/A | #N/A | #N/A | PCE | 9681K17 | #N/A | #N/A | #N/A | #N/A | 0 | #N/A | #N/A | #N/A | #N/A | #N/A | #N/A | #N/A | #N/A
EL-CA0134 | GearIT 8-Pack, Cat 6 Ethernet Cable Cat6 Snagless Patch 15 Feet - Snagless RJ45 Computer LAN Network Cord, Blue - Compatible with 8 Port Switch POE 8port Gigabit | #N/A | #N/A | #N/A | PCE | 9681K17 | #N/A | #N/A | #N/A | #N/A | 0 | #N/A | #N/A | #N/A | #N/A | #N/A | #N/A | #N/A | #N/A
EL-CA0135 | GearIT 25 Feet Cat 6 Ethernet Cable Cat6 Snagless Patch - Computer LAN Network Cord, Black | #N/A | #N/A | #N/A | PCE | 3-350820-2 | #N/A | #N/A | #N/A | #N/A | 0 | #N/A | #N/A | #N/A | #N/A | #N/A | #N/A | #N/A | #N/A
EL-CA0136 | GearIT 5 Pack, Cat 6 Ethernet Cable Cat6 Snagless Patch 20 Feet - Computer LAN Network Cord, Black - Compatible with 5 Port Switch POE 5port Gigabit | #N/A | #N/A | #N/A | PCE | S-13010 | #N/A | #N/A | #N/A | #N/A | 0 | #N/A | #N/A | #N/A | #N/A | #N/A | #N/A | #N/A | #N/A
EL-CA0137 | GearIT 6 Feet Cat 6 Ethernet Cable Cat6 Snagless Patch - Computer LAN Network Cord, Green | #N/A | #N/A | #N/A | PCE | 71600-308LF | #N/A | #N/A | #N/A | #N/A | 0 | #N/A | #N/A | #N/A | #N/A | #N/A | #N/A | #N/A | #N/A
EL-CA0138 | 3 FT RJ45 CAT 5E MOLDED NETWORK CABLE - PINK | #N/A | #N/A | #N/A | PCE | 34542 | #N/A | #N/A | #N/A | #N/A | 0 | #N/A | #N/A | #N/A | #N/A | #N/A | #N/A | #N/A | #N/A
EL-CA0139 | GearIT 5-Pack, Cat 6 Ethernet Cable Cat6 Snagless Patch 2 Feet - Snagless RJ45 Computer LAN Network Cord, White - Compatible with 5 Port Switch POE 5port Gigabit | 0 | 0 | 0 | ft | 708161 | Electronic | 0.002246 |  | Panduit | 88-00011 | Electronics Distributors Corp (Distrubutor for Advanced Cable Tie) | 0 | 695 * 3050 / 304.8 = 6955 ft need 3 x 3200' rollsordered 9600 ft 2 x 3200' rolls | 0 | 0 | 0 | 0 | 0
EL-CA0140 | GearIT 10 Pack, Cat 6 Ethernet Cable Cat6 Snagless Patch 2 Feet - Computer LAN Network Cord, Blue - Compatible with 10 Port Switch POE 10port Gigabit | #N/A | #N/A | #N/A | PCE | CLT25F-C20 / 298-1141-ND | #N/A | #N/A | #N/A | #N/A | 0 | #N/A | #N/A | #N/A | #N/A | #N/A | #N/A | #N/A | #N/A
EL-CA0141 | GearIT 5 Feet Cat 6 Ethernet Cable Cat6 Snagless Patch - Computer LAN Network Cord, Green | 0 | 0 | 0 | PCE | 22552201 | Electronic | 0.5101 |  | Molex Inc. | 22552201 | SAGER | WM2527-ND | 0 | 0 | 0 | 0 | 0 | 0
EL-CA0142 | GearIt 5-Pack, Cat5e Ethernet Patch Cable 10 Feet - Snagless RJ45 Computer LAN Network Cord, Pink | #N/A | #N/A | #N/A | PCE | 22552081 | #N/A | #N/A | #N/A | #N/A | 22552081 | #N/A | #N/A | #N/A | #N/A | #N/A | #N/A | #N/A | #N/A
EL-CA0143 | GearIT 20 Feet Cat 6 Ethernet Cable Cat6 Snagless Patch - Computer LAN Network Cord, White | #N/A | #N/A | #N/A | PCE | HH-PT1IN_FT (x1,000) | #N/A | #N/A | #N/A | #N/A | 0 | #N/A | #N/A | #N/A | #N/A | #N/A | #N/A | #N/A | #N/A
EL-CA0144 | GearIT 5-Pack, Cat 6 Ethernet Cable Cat6 Snagless Patch 1 Foot - Snagless RJ45 Computer LAN Network Cord, White - Compatible with 5 Port Switch POE 5port Gigabit | #N/A | #N/A | #N/A | PCE | HH-PT1IN_MT (x1,000) | #N/A | #N/A | #N/A | #N/A | 0 | #N/A | #N/A | #N/A | #N/A | #N/A | #N/A | #N/A | #N/A
EL-CA0145 | GearIT 3 Feet Cat 6 Ethernet Cable Cat6 Snagless Patch - Computer LAN Network Cord, Purple | #N/A | #N/A | #N/A | pkg, 10 | 0 | #N/A | #N/A | #N/A | #N/A | 0 | #N/A | #N/A | #N/A | #N/A | #N/A | #N/A | #N/A | #N/A
EL-CA0146 | GearIT 20 Feet Cat 6 Ethernet Cable Cat6 Snagless Patch - Computer LAN Network Cord, Purple | #N/A | #N/A | #N/A | PCE | TC-1500 | #N/A | #N/A | #N/A | #N/A | 0 | #N/A | #N/A | #N/A | #N/A | #N/A | #N/A | #N/A | #N/A
EL-CA0147 | GearIT 5-Pack, Cat 6 Ethernet Cable Cat6 Snagless Patch 5 Feet - Snagless RJ45 Computer LAN Network Cord, Purple - Compatible with 5 Port Switch POE 5port Gigabit | #N/A | #N/A | #N/A | PCE | HH-PT1IN_1x1 (x100) | #N/A | #N/A | #N/A | #N/A | 0 | #N/A | #N/A | #N/A | #N/A | #N/A | #N/A | #N/A | #N/A
EL-CA0148 | GearIT 5-Pack, Cat 6 Ethernet Cable Cat6 Snagless Patch 1.5 Feet - Snagless RJ45 Computer LAN Network Cord, Black - Compatible with 5 Port Switch POE 5port Gigabit | #N/A | #N/A | #N/A | PCE | HH-PT1IN_1x2 (x300) | #N/A | #N/A | #N/A | #N/A | 0 | #N/A | #N/A | #N/A | #N/A | #N/A | #N/A | #N/A | #N/A
EL-CA0149 | Sparkfun Banana to IC Hook Cables | #N/A | #N/A | #N/A | PCE | HH-PT1IN_1x3 (x300) | #N/A | #N/A | #N/A | #N/A | 0 | #N/A | #N/A | #N/A | #N/A | #N/A | #N/A | #N/A | #N/A
EL-CA0150 | GearIT 30 Feet Cat 6 Ethernet Cable Cat6 Snagless Patch - Computer LAN Network Cord, Orange | #N/A | #N/A | #N/A | PCE | HH-PT1IN_1x4 (x300) | #N/A | #N/A | #N/A | #N/A | 0 | #N/A | #N/A | #N/A | #N/A | #N/A | #N/A | #N/A | #N/A
EL-CA0151 | GearIT 30 Feet Cat 6 Ethernet Cable Cat6 Snagless Patch - Computer LAN Network Cord, Green | #N/A | #N/A | #N/A | PCE | 161-PF0030/28 | #N/A | #N/A | #N/A | #N/A | 0 | #N/A | #N/A | #N/A | #N/A | #N/A | #N/A | #N/A | #N/A
EL-CA0152 | GearIt 30 Feet Cat 6 Ethernet Cable Cat6 Snagless Patch - Computer LAN Network Cord, Pink | #N/A | #N/A | #N/A | PCE | 98265T72 | #N/A | #N/A | #N/A | #N/A | 0 | #N/A | #N/A | #N/A | #N/A | #N/A | #N/A | #N/A | #N/A
EL-CA0153 | USB C to HDMI Cable (5.9ft/1.8m), CHOETECH USB 3.1 Type C Male (Thunderbolt 3 Compatible) to HDMI Male 4K Cable for the 2016 MacBook Pro, 2015 MacBook, ChromeBook Pixel, Samsung Galaxy S8/S8 Plus etc | #N/A | #N/A | #N/A | PCE | 79458035360 | #N/A | #N/A | #N/A | #N/A | 0 | #N/A | #N/A | #N/A | #N/A | #N/A | #N/A | #N/A | #N/A
EL-CA0154 | Cable Matters SuperSpeed USB 3.0 to RJ45 Gigabit Ethernet Network Adapter in Black | #N/A | #N/A | #N/A | PCE | 595-CD74HC4050M | #N/A | #N/A | #N/A | #N/A | 0 | #N/A | #N/A | #N/A | #N/A | #N/A | #N/A | #N/A | #N/A
EL-CA0155 | AmazonBasics CL3 Rated (In-Wall Installation) HDMI Cable - 6 Feet | #N/A | #N/A | #N/A | PCE | 595-CD74HC4050PWRG4 | #N/A | #N/A | #N/A | #N/A | 0 | #N/A | #N/A | #N/A | #N/A | #N/A | #N/A | #N/A | #N/A
EL-CA0156 | Auskic 1080P HDMI Male to Dual HDMI Female 1 to 2 Way Splitter Cable Adapter Converter for DVD Players/PS3/HDTV/STB and Most LCD Projectors | #N/A | #N/A | #N/A | PCE | A32515-ND | #N/A | #N/A | #N/A | #N/A | 0 | #N/A | #N/A | #N/A | #N/A | #N/A | #N/A | #N/A | #N/A
EL-CA0157 | DVI to HDMI, Rankie 2-Pack Gold-Plated DVI to HDMI HDTV Male to Female Adapter Converter (Black) - R1190 | #N/A | #N/A | #N/A | PCE | 0 | #N/A | #N/A | #N/A | #N/A | 0 | #N/A | #N/A | #N/A | #N/A | #N/A | #N/A | #N/A | #N/A
EL-CA0158 | GearIT 5-Pack, Cat 6 Ethernet Cable Cat6 Snagless Patch 1 Foot - Snagless RJ45 Computer LAN Network Cord, Purple - Compatible with 5 Port Switch POE 5port Gigabit | #N/A | #N/A | #N/A | PCE | F1641CT-ND | #N/A | #N/A | #N/A | #N/A | 0 | #N/A | #N/A | #N/A | #N/A | #N/A | #N/A | #N/A | #N/A
EL-CA0159 | GearIT 10 Feet Cat 6 Ethernet Cable Cat6 Snagless Patch - Computer LAN Network Cord, Purple | #N/A | #N/A | #N/A | PCE | F4200-ND | #N/A | #N/A | #N/A | #N/A | 0 | #N/A | #N/A | #N/A | #N/A | #N/A | #N/A | #N/A | #N/A
EL-CA0160 | AmazonBasics High-Speed HDMI Cable - 6 Feet | #N/A | #N/A | #N/A | PCE | BPHHN | #N/A | #N/A | #N/A | #N/A | 0 | #N/A | #N/A | #N/A | #N/A | #N/A | #N/A | #N/A | #N/A
EL-CA0161 | Cat6 24AWG UTP Ethernet Network Patch Cable, 10ft Black | #N/A | #N/A | #N/A | PCE | F4710-ND | #N/A | #N/A | #N/A | #N/A | 0 | #N/A | #N/A | #N/A | #N/A | #N/A | #N/A | #N/A | #N/A
EL-CA0162 | Cat6 24AWG UTP Ethernet Network Patch Cable, 25ft Black | 0 | 0 | 0 | PCE | 576-0233007.MXP | Electronic | 0.381 |  | 0 | F4710-ND | Mouser | 576-0233007.MXP | 0 | 0 | 0 | 0 | 0 | 0
EL-CA0163 | Ativa Cat6 Cable 14' Blue | #N/A | #N/A | #N/A | PCE | 0 | #N/A | #N/A | #N/A | #N/A | 0 | #N/A | #N/A | #N/A | #N/A | #N/A | #N/A | #N/A | #N/A
EL-CA0164 | Ativa Cat6 Cable 14' Black | #N/A | #N/A | #N/A | PCE | 461-1013-ND | #N/A | #N/A | #N/A | #N/A | 0 | #N/A | #N/A | #N/A | #N/A | #N/A | #N/A | #N/A | #N/A
EL-CA0165 | Ativa Cat6 Cable 25' Blue | #N/A | #N/A | #N/A | PCE | 461-1014-ND | #N/A | #N/A | #N/A | #N/A | 0 | #N/A | #N/A | #N/A | #N/A | #N/A | #N/A | #N/A | #N/A
EL-CA0166 | Ativa Cat6 Cable 25' Black | #N/A | #N/A | #N/A | PCE | 486-2181-ND | #N/A | #N/A | #N/A | #N/A | 0 | #N/A | #N/A | #N/A | #N/A | #N/A | #N/A | #N/A | #N/A
EL-CA0167 | Cat 6 Ethernet Cable White 3 ft ( 6 Pack ) - Flat Internet Network Cable - Jadaol Cat6 Ethernet Patch Cable Short - Cat6 Computer Lan Cable With Snagless RJ45 Connectors - 3 feet White 6 Pack | #N/A | #N/A | #N/A | PCE | 783250853960 | #N/A | #N/A | #N/A | #N/A | 0 | #N/A | #N/A | #N/A | #N/A | #N/A | #N/A | #N/A | #N/A
EL-CA0168 | Cat 6 Ethernet Cable Black 3 ft ( 6 Pack ) - Flat Internet Network Cable - Jadaol Cat6 Ethernet Patch Cable Short - Cat6 Computer Lan Cable With Snagless RJ45 Connectors - 3 feet Black 6 Pack | #N/A | #N/A | #N/A | PCE | 9681K15 | #N/A | #N/A | #N/A | #N/A | 0 | #N/A | #N/A | #N/A | #N/A | #N/A | #N/A | #N/A | #N/A
EL-CA0169 | dCables Nikon CoolPix L840 USB Cable - USB Computer Cord for CoolPix L840 | #N/A | #N/A | #N/A | PCE | 625-1N4004-E3/54 | #N/A | #N/A | #N/A | #N/A | 0 | #N/A | #N/A | #N/A | #N/A | #N/A | #N/A | #N/A | #N/A
EL-CA0170 | Mini HDMI to HDMI Cable, Rankie 6 Feet High-Speed Mini-HDMI to HDMI Cable (Black) - R1110 | #N/A | #N/A | #N/A | PCE | 85417 | #N/A | #N/A | #N/A | #N/A | 0 | #N/A | #N/A | #N/A | #N/A | #N/A | #N/A | #N/A | #N/A
EL-CA0171 | Cable Matters USB 3.1 Type C (USB-C & Thunderbolt 3 Port Compatible) to HDMI 4K 60Hz UHD Adapter in Black | #N/A | #N/A | #N/A | PCE | 819562006029 | #N/A | #N/A | #N/A | #N/A | 0 | #N/A | #N/A | #N/A | #N/A | #N/A | #N/A | #N/A | #N/A
EL-CA0172 | C2G 54170 USB 3.0 A Male to A Male Cable, Black (1 Meter/3.2 Feet) | #N/A | #N/A | #N/A | PCE | 0 | #N/A | #N/A | #N/A | #N/A | 0 | #N/A | #N/A | #N/A | #N/A | #N/A | #N/A | #N/A | #N/A
EL-CA0173 | USB 2.0 A to Micro B 5 pin Hi-Speed Cable for External Hard Drives/Digital Cameras/Mobile Phones (150cm - 4.5 Foot - 1.5M) | #N/A | #N/A | #N/A | PCE | 72555K66 | #N/A | #N/A | #N/A | #N/A | 0 | #N/A | #N/A | #N/A | #N/A | #N/A | #N/A | #N/A | #N/A
EL-CA0174 | USB Type C Cable, Anker PowerLine USB C to USB 3.0 Cable (6ft) with 56k Ohm Pull-up Resistor | #N/A | #N/A | #N/A | PCE | 72555K55 | #N/A | #N/A | #N/A | #N/A | 0 | #N/A | #N/A | #N/A | #N/A | #N/A | #N/A | #N/A | #N/A
EL-CA0175 | USB Type C Cable, Anker PowerLine USB C to USB 3.0 Cable (3ft) with 56k Ohm Pull-up Resistor | #N/A | #N/A | #N/A | PCE | 72555K54 | #N/A | #N/A | #N/A | #N/A | 0 | #N/A | #N/A | #N/A | #N/A | #N/A | #N/A | #N/A | #N/A
EL-CA0176 | Anker PowerLine USB-C to USB-C 2.0 Cable (6ft) for USB Type-C Devices | #N/A | #N/A | #N/A | PCE | 72555K53 | #N/A | #N/A | #N/A | #N/A | 0 | #N/A | #N/A | #N/A | #N/A | #N/A | #N/A | #N/A | #N/A
EL-CA0177 | AmazonBasics 3.5mm Male to Female Stereo Audio Cable - 6 Feet (1.83 Meters) | #N/A | #N/A | #N/A | PCE | 85447 | #N/A | #N/A | #N/A | #N/A | 0 | #N/A | #N/A | #N/A | #N/A | #N/A | #N/A | #N/A | #N/A
EL-CA0178 | AmazonBasics Mini DisplayPort to HDMI Cable - 6 Feet | #N/A | #N/A | #N/A | PCE | 0 | #N/A | #N/A | #N/A | #N/A | 0 | #N/A | #N/A | #N/A | #N/A | #N/A | #N/A | #N/A | #N/A
EL-CA0179 | Anker [5-Pack] PowerLine Micro USB - Charging Cable [Assorted Lengths] | #N/A | #N/A | #N/A | PCE | 0 | #N/A | #N/A | #N/A | #N/A | 0 | #N/A | #N/A | #N/A | #N/A | #N/A | #N/A | #N/A | #N/A
EL-CA0180 | Areo Thermistor Extension Harness | #N/A | #N/A | #N/A | PCE | 0 | #N/A | #N/A | #N/A | #N/A | 0 | #N/A | #N/A | #N/A | #N/A | #N/A | #N/A | #N/A | #N/A
EL-CA0181 | Anker PowerLine Micro USB (6ft) - Durable Charging Cable, with Aramid Fiber and 5000+ Bend Lifespan | #N/A | #N/A | #N/A | PCE | CP3-002AH-ND | #N/A | #N/A | #N/A | #N/A | 0 | #N/A | #N/A | #N/A | #N/A | #N/A | #N/A | #N/A | #N/A
EL-CA0182 | Cable Matters 2 Pack, SuperSpeed USB 3.0 Type A Male to Female Extension Cable in Black 6 Feet | #N/A | #N/A | #N/A | PCE | N82E16820239229 | #N/A | #N/A | #N/A | #N/A | 0 | #N/A | #N/A | #N/A | #N/A | #N/A | #N/A | #N/A | #N/A
EL-CA0183 | Cable Matters 2 Pack, SuperSpeed USB 3.0 Type A Male to Female Extension Cable in Black 3 Feet | #N/A | #N/A | #N/A | PCE | 0 | #N/A | #N/A | #N/A | #N/A | 0 | #N/A | #N/A | #N/A | #N/A | #N/A | #N/A | #N/A | #N/A
EL-CA0184 | Cable Matters SuperSpeed USB 3.0 Type A Male to Female Extension Cable in Black 10 Feet | #N/A | #N/A | #N/A | PCE | 0 | #N/A | #N/A | #N/A | #N/A | 0 | #N/A | #N/A | #N/A | #N/A | #N/A | #N/A | #N/A | #N/A
EL-CA0185 | GearIT 5-Pack, Cat 6 Ethernet Cable Cat6 Snagless Patch 5 Feet - Snagless RJ45 Computer LAN Network Cord, Yellow - Compatible with 5 Port Switch POE 5port Gigabit | #N/A | #N/A | #N/A | PCE | 0 | #N/A | #N/A | #N/A | #N/A | 0 | #N/A | #N/A | #N/A | #N/A | #N/A | #N/A | #N/A | #N/A
EL-CA0186 | GearIT 5-Pack, Cat 6 Ethernet Cable Cat6 Snagless Patch 6 Feet - Snagless RJ45 Computer LAN Network Cord, Orange - Compatible with 5 Port Switch POE 5port Gigabit | #N/A | #N/A | #N/A | PCE | N82E13820239275 | #N/A | #N/A | #N/A | #N/A | 0 | #N/A | #N/A | #N/A | #N/A | #N/A | #N/A | #N/A | #N/A
EL-CA0187 | C2G/Cables to Go 04022 Cat6 Snagless Unshielded (UTP) Network Patch Cable, Orange (15 Feet/4.57 Meters) | #N/A | #N/A | #N/A | PCE | 1-66358-6 | #N/A | #N/A | #N/A | #N/A | 1-66359-4 | #N/A | #N/A | #N/A | #N/A | #N/A | #N/A | #N/A | #N/A
EL-CA0188 | C2G/Cables to Go 03995 Cat6 Snagless Unshielded (UTP) Network Patch Cable, Green (15 Feet/4.57 Meters) | #N/A | #N/A | #N/A | PCE | 1-66359-4 | #N/A | #N/A | #N/A | #N/A | 0 | #N/A | #N/A | #N/A | #N/A | #N/A | #N/A | #N/A | #N/A
EL-CA0189 | C2G/Cables to Go 04036 Cat6 Snagless Unshielded (UTP) Network Patch Cable, White (6 Feet/1.82 Meters) | #N/A | #N/A | #N/A | PCE | 1-66106-5 | #N/A | #N/A | #N/A | #N/A | 0 | #N/A | #N/A | #N/A | #N/A | #N/A | #N/A | #N/A | #N/A
EL-CA0190 | Jadaol Cat 6 Ethernet Cable 1 ft White ( 6 Pack ) – Flat Internet Network Cable | #N/A | #N/A | #N/A | PCE | 1-66331-4 | #N/A | #N/A | #N/A | #N/A | 1-66331-4 | #N/A | #N/A | #N/A | #N/A | #N/A | #N/A | #N/A | #N/A
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
