reprapperMC/mini-hibiscus/production_parts/assemblies/LCD_Assembly/Mini_LCD_assembled.fcstd

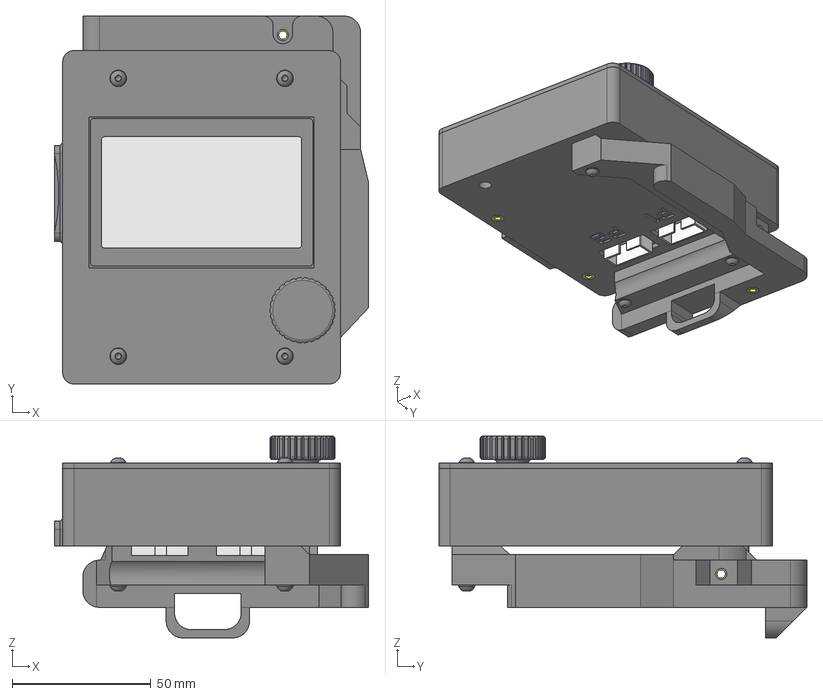
[picture p14: CAD file, 2018-02-06]
production_parts/assemblies/LCD_Assembly/Mini_LCD_assembled.fcstd
113.1 x 132.5 x 72.6 mm
LCD_Mini_bracket_RIGHT_01
mini_lcd_bezel_02
Mini_lcd_bezel_spacer_01
LCD_spacer_01
LCD_01
plastic_laser_cut_lcd_cover_step1_01
LCD_spacer_02
LCD_spacer_03
LCD_spacer_04
M3_insert_01
M3_insert_02
M3_insert_03
M3_insert_04
M3_insert_05
M3_insert_06
M3_insert_07
M3_insert_08
M3_insert_09
M3_insert_10
M3_insert_11
M3_insert_12
M3_insert_13
LCD_case_v3_01
M3-Washer
M3-Washer039
M3-Washer037
M3-Washer038
M3x25-Screw
M3x25-Screw020
M3x25-Screw021
M3x25-Screw019
M3x20-Screw005
M3x20-Screw
M3-Washer031
M3-Washer032
M3x20-Screw006
M3-Washer036
M3x8-Screw021
M3x8-Screw022
M3x8-Screw023
M3x8-Screw
mini_lcd_knob_02
cover_spacer_02
lcd_cover_m_02
