reprapperMC/mini-hibiscus/production_parts/jigs/fixtures/double-bearing-holder_reaming/double-bearing-holder_reaming_assembly.fcstd

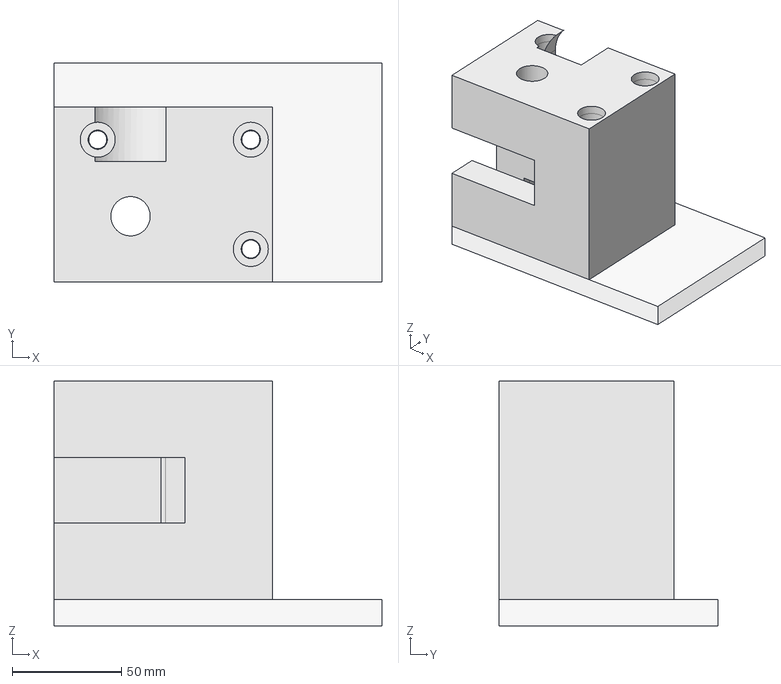
[picture p15: CAD file, 2018-01-10]
production_parts/jigs/fixtures/double-bearing-holder_reaming/double-bearing-holder_reaming_assembly.fcstd
150.0 x 100.0 x 112.0 mm
reaming_base_01
reaming_top_double_bearing_holder_01
