reprapperMC/mini-hibiscus/production_parts/jigs/fixtures/x_carriage_reaming/x_carriage_reaming_assembly.fcstd

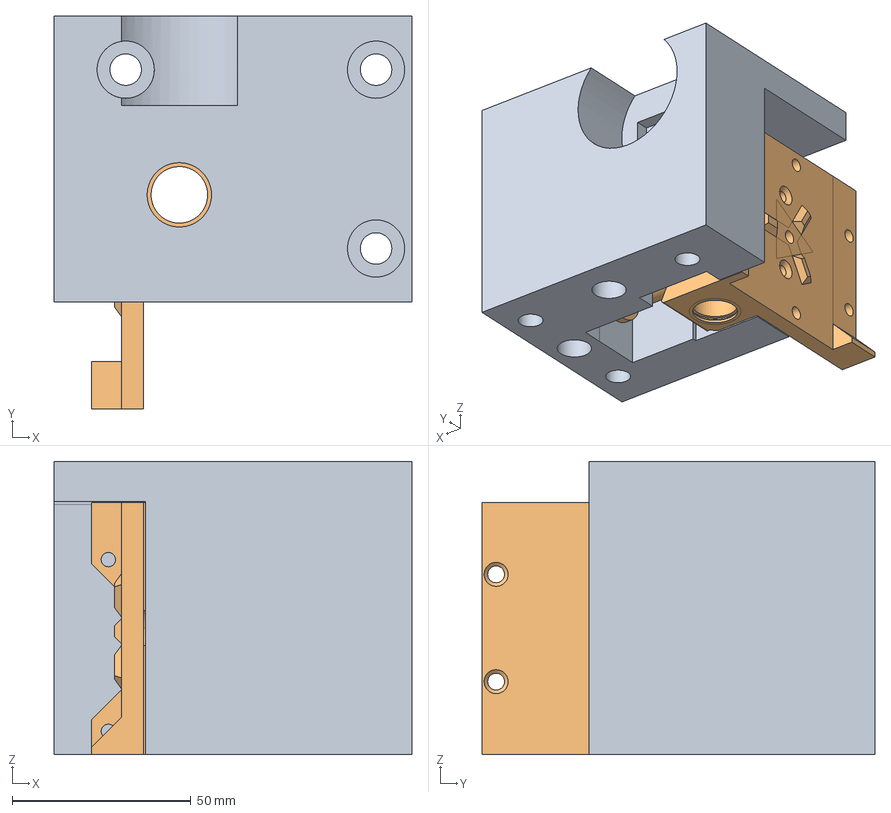
[picture p16: CAD file, 2018-03-16]
production_parts/jigs/fixtures/x_carriage_reaming/x_carriage_reaming_assembly.fcstd
100.0 x 109.9 x 82.0 mm
reaming_top_x_carriage_01
x_carriage_v4_3_1_mini2_01
