reprapperMC/mini-hibiscus/production_parts/jigs/fixtures/x_end_idler_reaming/x_end_idler_reaming_assembly.fcstd

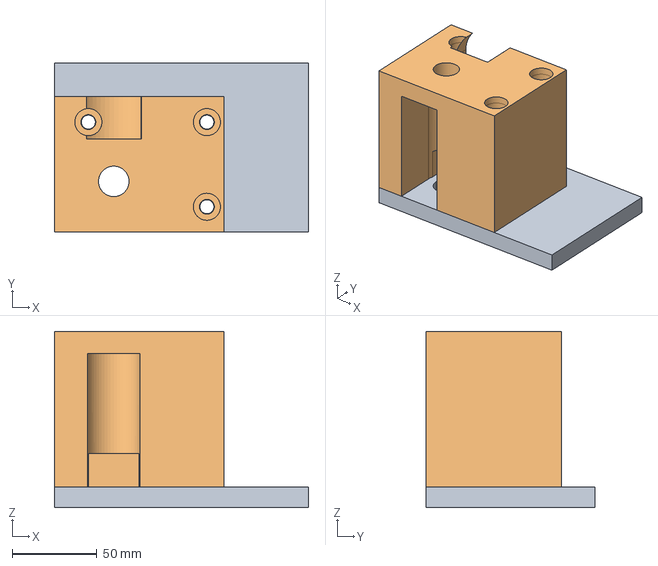
[picture p17: CAD file, 2018-01-10]
production_parts/jigs/fixtures/x_end_idler_reaming/x_end_idler_reaming_assembly.fcstd
150.0 x 100.0 x 104.0 mm
reaming_base_01
reaming_top_x_end_idler_01
