reprapperMC/mini-hibiscus/production_parts/machined_parts/hibiscus_frame_assembled.fcstd

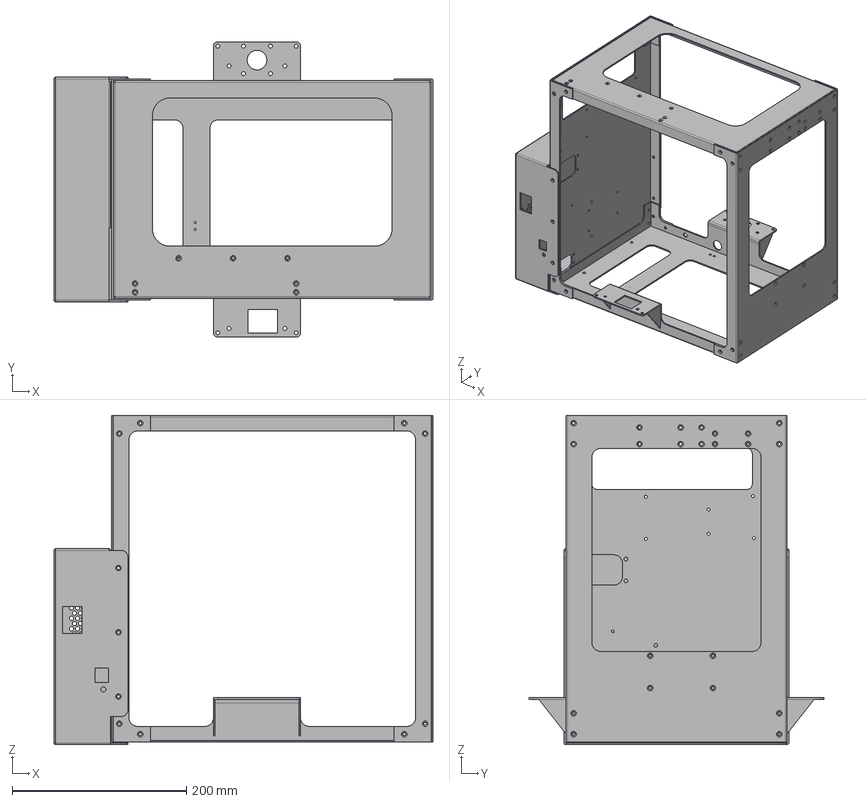
[picture p18: CAD file, 2017-11-30]
production_parts/machined_parts/hibiscus_frame_assembled.fcstd
435.0 x 339.0 x 378.0 mm
