reprapperMC/mini-hibiscus/production_parts/jigs/fixtures/x_bearing_holder_reaming/x_bearing_holder_reaming_assembly.fcstd

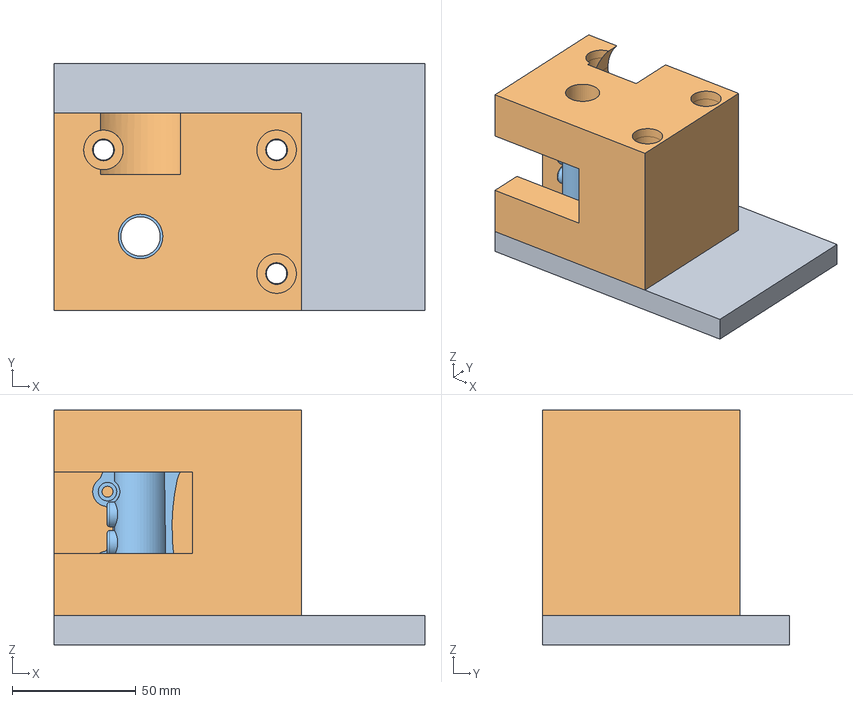
[picture p19: CAD file, 2018-02-09]
production_parts/jigs/fixtures/x_bearing_holder_reaming/x_bearing_holder_reaming_assembly.fcstd
150.0 x 100.0 x 95.0 mm
reaming_base_01
reaming_top_x_bearing_holder_01
x_bearing_holder_V3_7_3
