reprapperMC/mini-hibiscus/production_parts/jigs/fixtures/x_end_motor_reaming/x_end_motor_reaming_assembly.fcstd

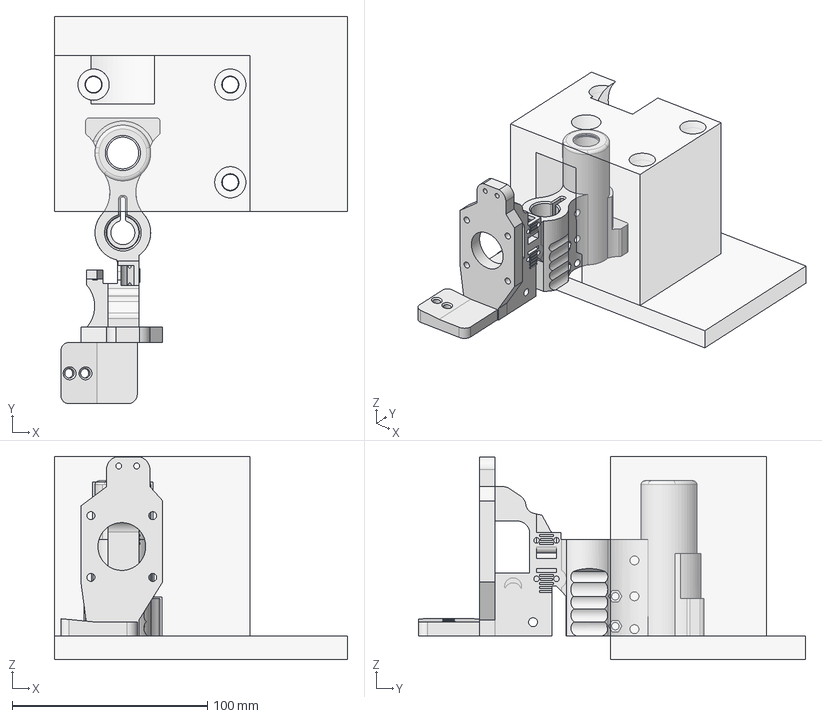
[picture p20: CAD file, 2018-01-10]
production_parts/jigs/fixtures/x_end_motor_reaming/x_end_motor_reaming_assembly.fcstd
150.0 x 198.4 x 104.0 mm
reaming_base_01
reaming_top_x_end_motor_01
X_end_motor_mini2_v2_5_1_01
