reprapperMC/mini-hibiscus/production_parts/assemblies/assembly_parts/1mmx20mm_dowel_pin.fcstd

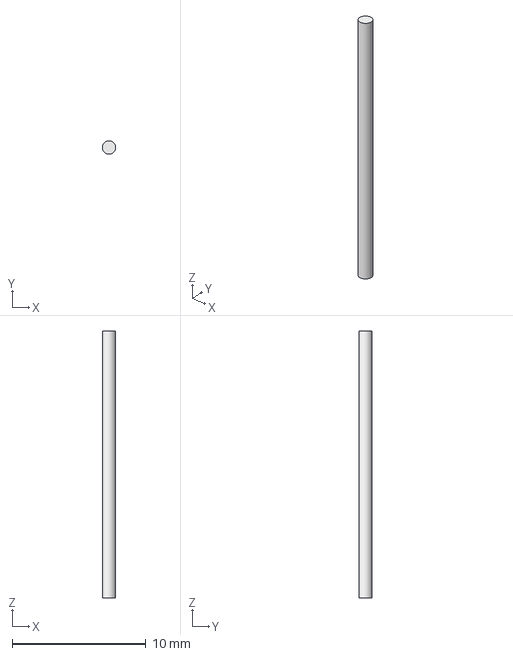
[picture p21: CAD file, 2018-04-23]
production_parts/assemblies/assembly_parts/1mmx20mm_dowel_pin.fcstd
0.999 x 1 x 20.0 mm
