reprapperMC/mini-hibiscus/production_parts/assemblies/assembly_subs/aerostruder_v2.fcstd

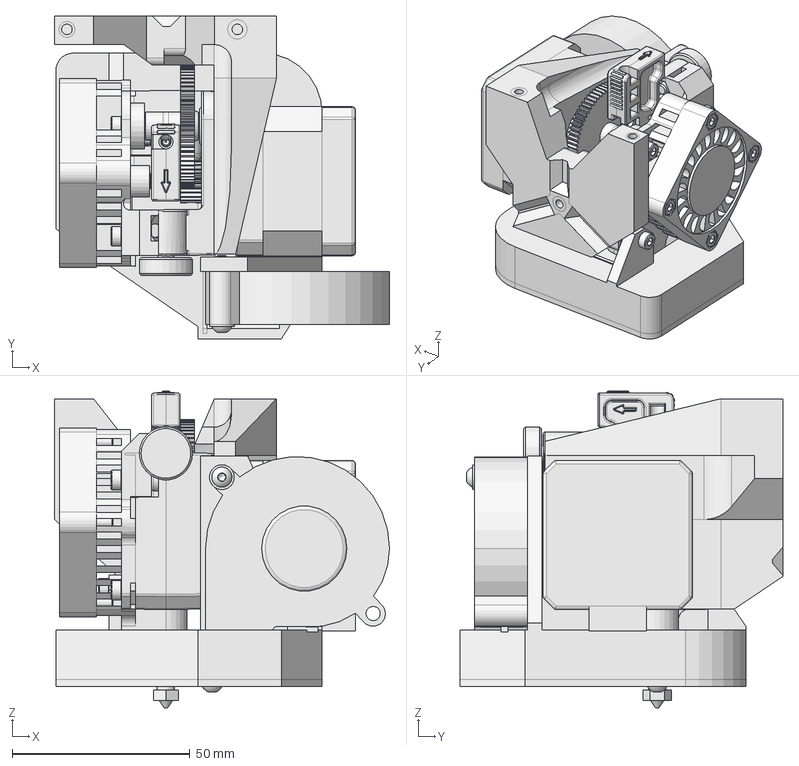
[picture p22: CAD file, 2018-03-21]
production_parts/assemblies/assembly_subs/aerostruder_v2.fcstd
94.3 x 90.9 x 89.1 mm
