reprapperMC/mini-hibiscus/production_parts/assemblies/assembly_subs/PEM/pem_pins.fcstd

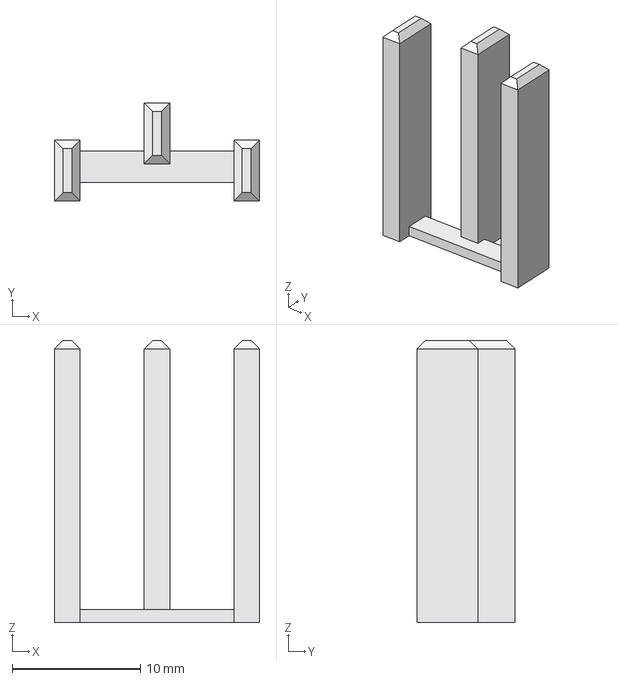
[picture p23: CAD file, 2018-02-07]
production_parts/assemblies/assembly_subs/PEM/pem_pins.fcstd
16.0 x 7.66 x 22.0 mm
