reprapperMC/mini-hibiscus/production_parts/assemblies/assembly_subs/RAMBO/PCB.fcstd

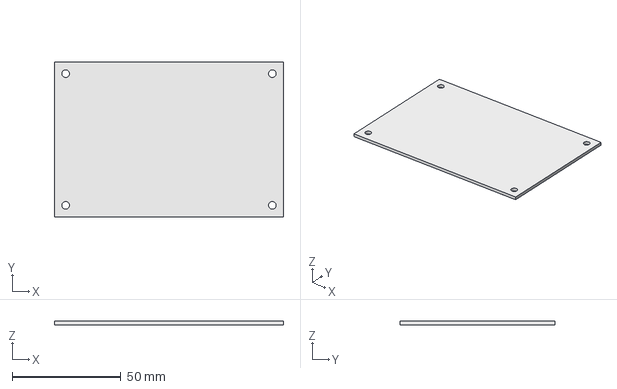
[picture p24: CAD file, 2018-02-07]
production_parts/assemblies/assembly_subs/RAMBO/PCB.fcstd
105.2 x 71.2 x 1.65 mm
