reprapperMC/mini-hibiscus/production_parts/assemblies/inserts_assemblies/z_upper_right_inserts.fcstd

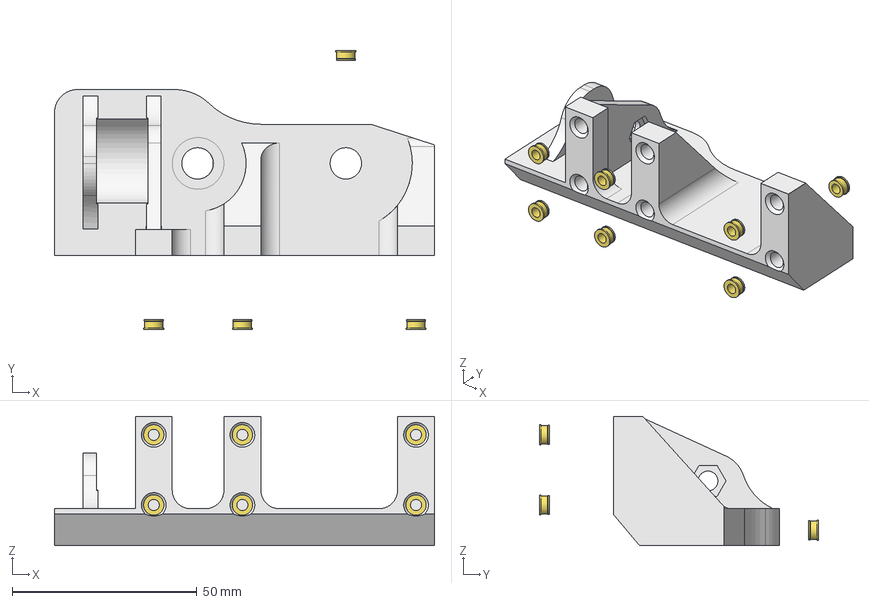
[picture p25: CAD file, 2018-04-23]
production_parts/assemblies/inserts_assemblies/z_upper_right_inserts.fcstd
102.9 x 75.6 x 35.0 mm
Z_Upper_Right_Mini2_v1_4_01
M3_insert_01
M3_insert_02
M3_insert_03
M3_insert_04
M3_insert_05
M3_insert_06
M3_insert_07
