reprapperMC/mini-hibiscus/Production_parts/Assembly_subs/belts.fcstd

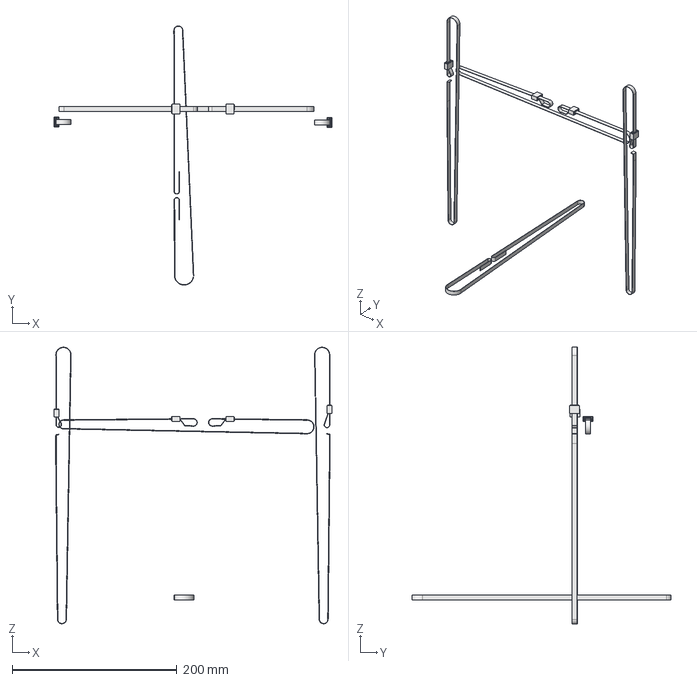
[picture p26: CAD file, 2018-02-07]
Production_parts/Assembly_subs/belts.fcstd
337.0 x 314.2 x 335.4 mm
