reprapperMC/mini-hibiscus/production_parts/electronics/e3d_hot_tightened_assembly/AS-HE0026_Universal_Orientation.fcstd

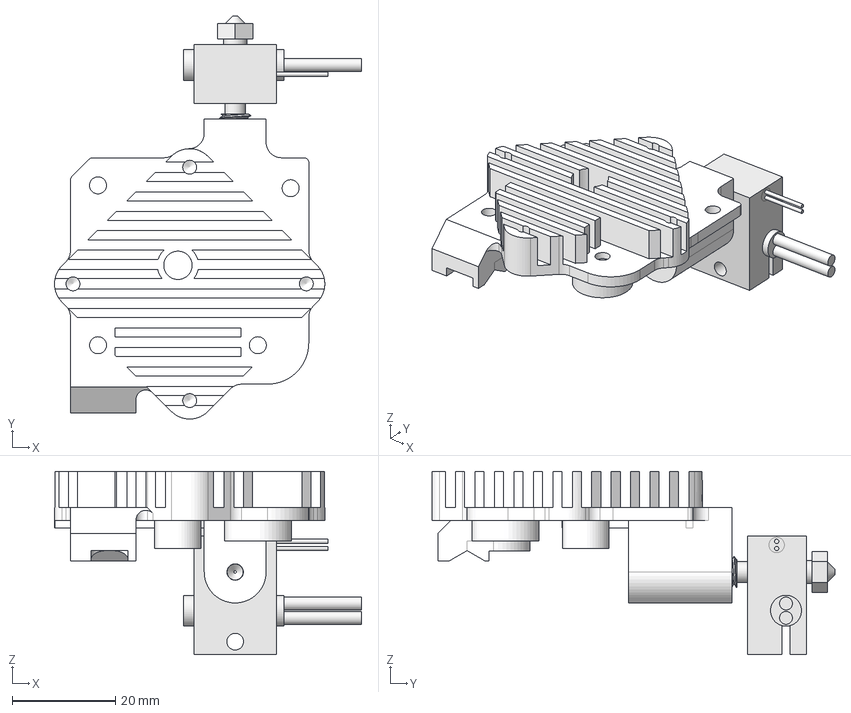
[picture p27: CAD file, 2018-01-22]
production_parts/electronics/e3d_hot_tightened_assembly/AS-HE0026_Universal_Orientation.fcstd
59.5 x 78.2 x 35.5 mm
TITAN-SINK-300-RH_(Mirror_#1)
aero_v6_block_assem_r_01
