reprapperMC/mini-hibiscus/production_parts/electronics/HEATSINK/Thermal_gap_filler_drawing.fcstd

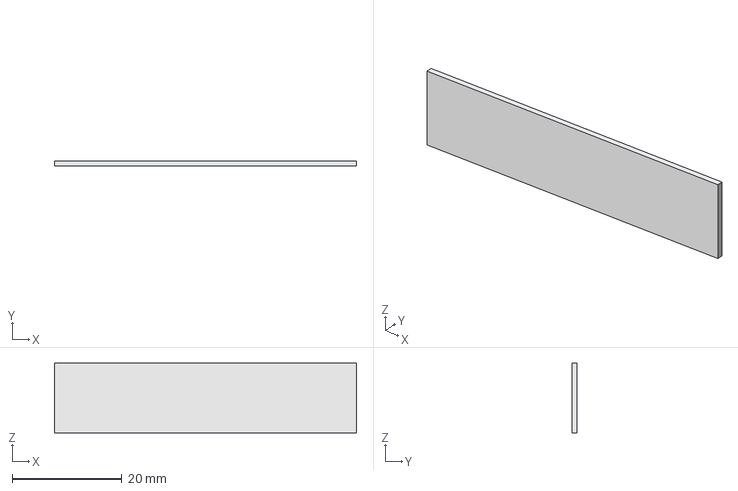
[picture p28: CAD file, 2018-02-28]
production_parts/electronics/HEATSINK/Thermal_gap_filler_drawing.fcstd
55.0 x 1.00 x 12.7 mm
