reprapperMC/mini-hibiscus/production_parts/jigs/fixtures/reaming_modular_base/long_reaming_base_milled_path_holes.fcstd

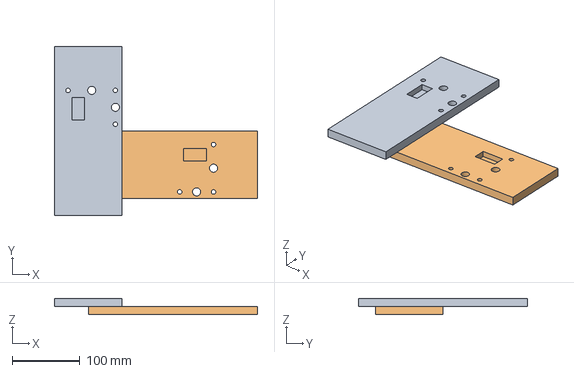
[picture p29: CAD file, 2018-04-17]
production_parts/jigs/fixtures/reaming_modular_base/long_reaming_base_milled_path_holes.fcstd
300.0 x 250.0 x 24.0 mm
