reprapperMC/mini-hibiscus/production_parts/jigs/fixtures/x_bearing_holder_reaming/reaming_top_x_bearing_holder_v3.7.4.fcstd

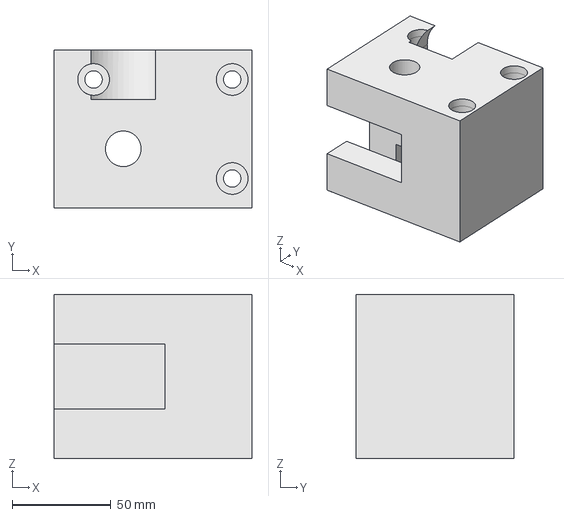
[picture p30: CAD file, 2018-02-13]
production_parts/jigs/fixtures/x_bearing_holder_reaming/reaming_top_x_bearing_holder_v3.7.4.fcstd
100.0 x 80.0 x 83.0 mm
