reprapperMC/mini-hibiscus/production_parts/jigs/fixtures/x_end_motor_reaming/reaming_top_x_end_motor.fcstd

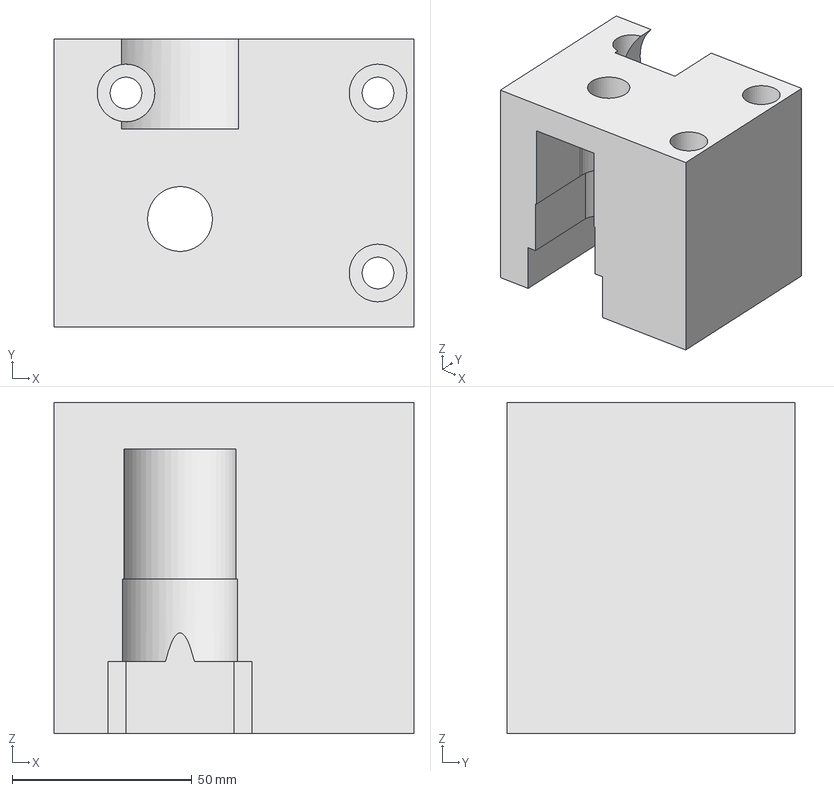
[picture p31: CAD file, 2018-02-28]
production_parts/jigs/fixtures/x_end_motor_reaming/reaming_top_x_end_motor.fcstd
100.0 x 80.0 x 92.0 mm
