reprapperMC/mini-hibiscus/production_parts/jigs/gauge/z_top_gauge_v2.step

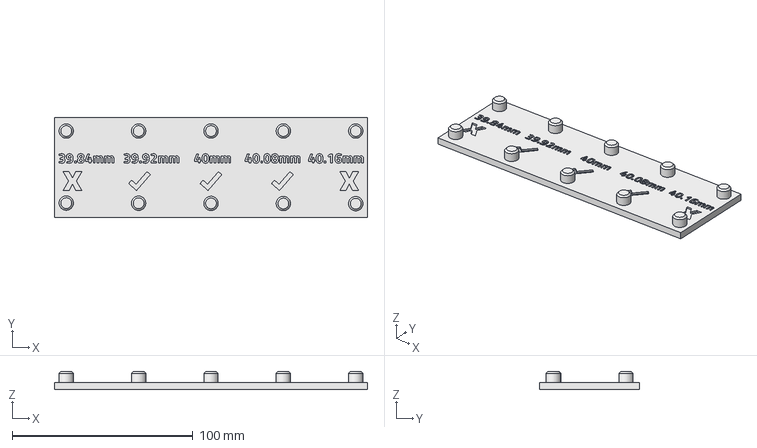
[picture p32: CAD file, 2018-04-13]
production_parts/jigs/gauge/z_top_gauge_v2.step
173.0 x 55.0 x 10.0 mm
