reprapperMC/mini-hibiscus/production_parts/jigs/OctopusRev06_Outline.stl

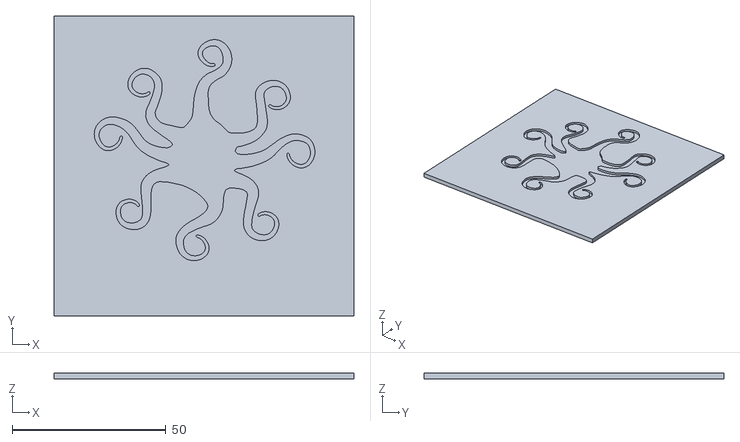
[picture p33: CAD file, 2018-05-04]
production_parts/jigs/OctopusRev06_Outline.stl
97.7 x 97.7 x 2.00
