reprapperMC/mini-hibiscus/production_parts/machined_parts/bed_mount_plate/bed-mount-plate-mini_PP-FP0138_revG.step

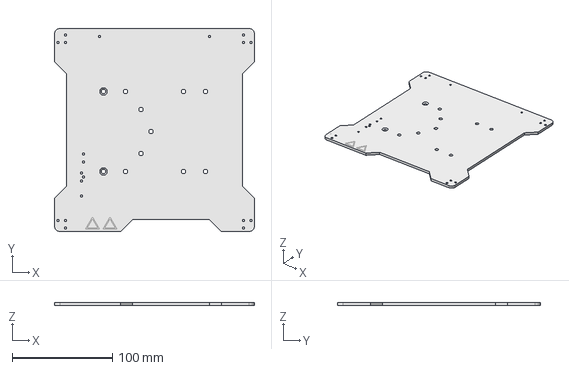
[picture p34: CAD file, 2018-02-13]
production_parts/machined_parts/bed_mount_plate/bed-mount-plate-mini_PP-FP0138_revG.step
200.0 x 203.0 x 3.18 mm
