reprapperMC/mini-hibiscus/production_parts/machined_parts/bed_standoff/bed_standoff.step

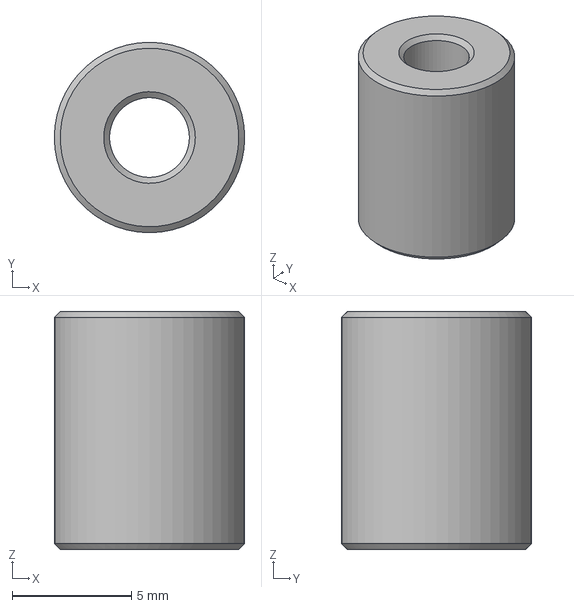
[picture p35: CAD file, 2017-11-30]
production_parts/machined_parts/bed_standoff/bed_standoff.step
8.00 x 8.00 x 10.0 mm
