reprapperMC/mini-hibiscus/production_parts/machined_parts/bottom_plate_mini/bottom-plate-mini_PP-MP0149_revE.step

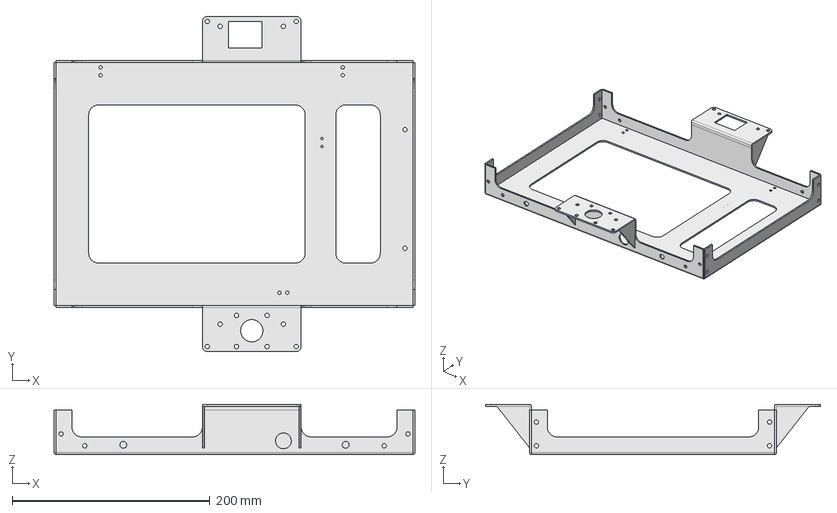
[picture p36: CAD file, 2018-02-07]
production_parts/machined_parts/bottom_plate_mini/bottom-plate-mini_PP-MP0149_revE.step
365.0 x 339.0 x 51.0 mm
