reprapperMC/mini-hibiscus/production_parts/machined_parts/electronics_case/electronics-case-mini_PP-FP0147_RevB.step

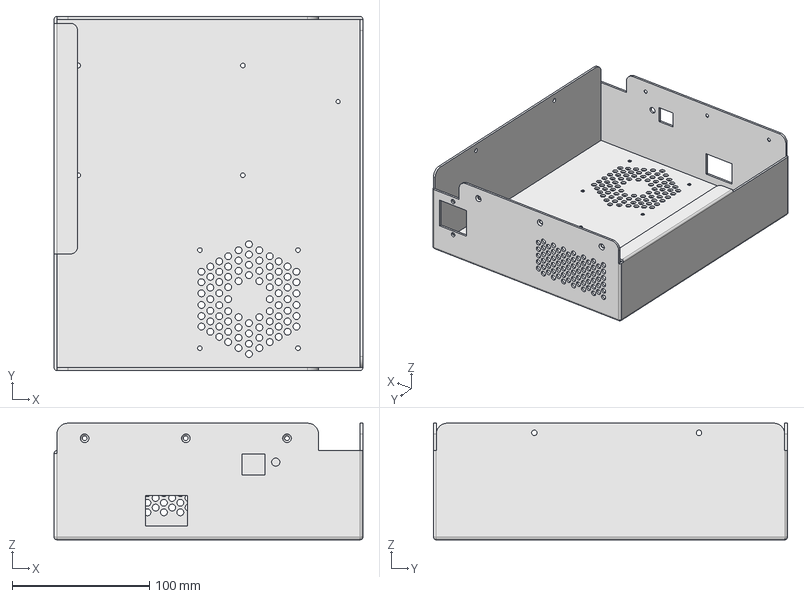
[picture p37: CAD file, 2018-02-07]
production_parts/machined_parts/electronics_case/electronics-case-mini_PP-FP0147_RevB.step
225.0 x 258.0 x 85.0 mm
