reprapperMC/mini-hibiscus/production_parts/machined_parts/heatsink_einsy/heatsink_einsy_PP-MP0210.step

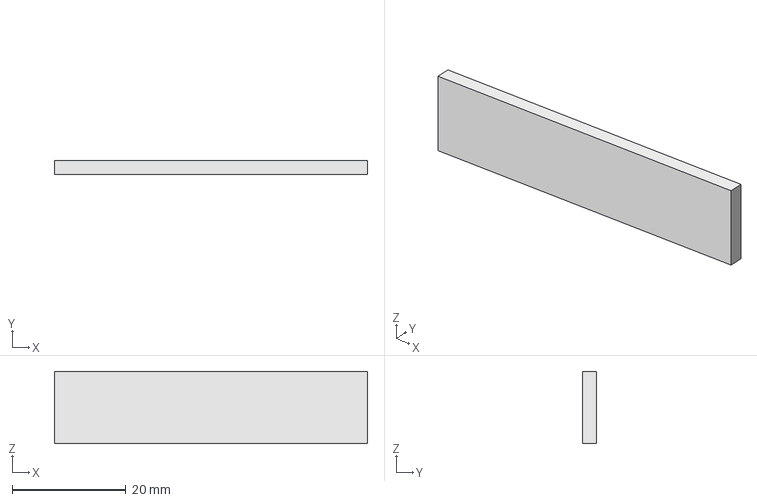
[picture p38: CAD file, 2018-01-19]
production_parts/machined_parts/heatsink_einsy/heatsink_einsy_PP-MP0210.step
55.0 x 2.38 x 12.7 mm
