reprapperMC/mini-hibiscus/production_parts/machined_parts/LCD_Machined_parts/plastic_laser_cut_lcd/plastic_laser_cut_lcd_cover.step

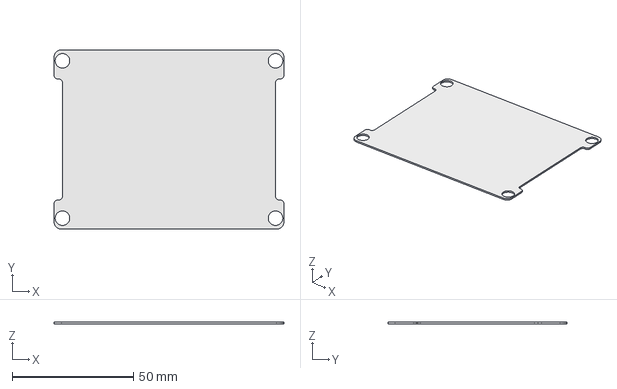
[picture p39: CAD file, 2018-01-29]
production_parts/machined_parts/LCD_Machined_parts/plastic_laser_cut_lcd/plastic_laser_cut_lcd_cover.step
95.0 x 74.0 x 0.76 mm
