reprapperMC/mini-hibiscus/production_parts/machined_parts/Modular_bed_etched/Mini_pad_drwng.fcstd

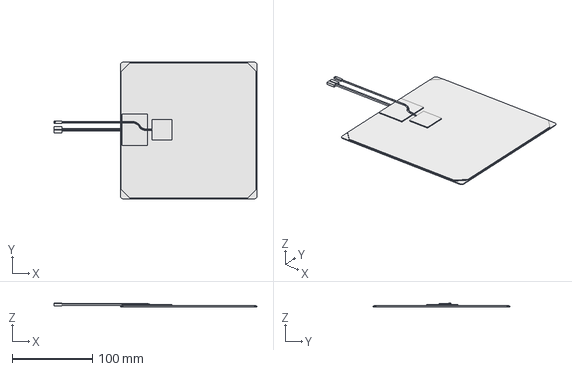
[picture p40: CAD file, 2018-03-02]
production_parts/machined_parts/Modular_bed_etched/Mini_pad_drwng.fcstd
252.6 x 170.0 x 4.59 mm
