reprapperMC/mini-hibiscus/production_parts/machined_parts/right_side/right-side-mini_PP-FP0052_revG.step

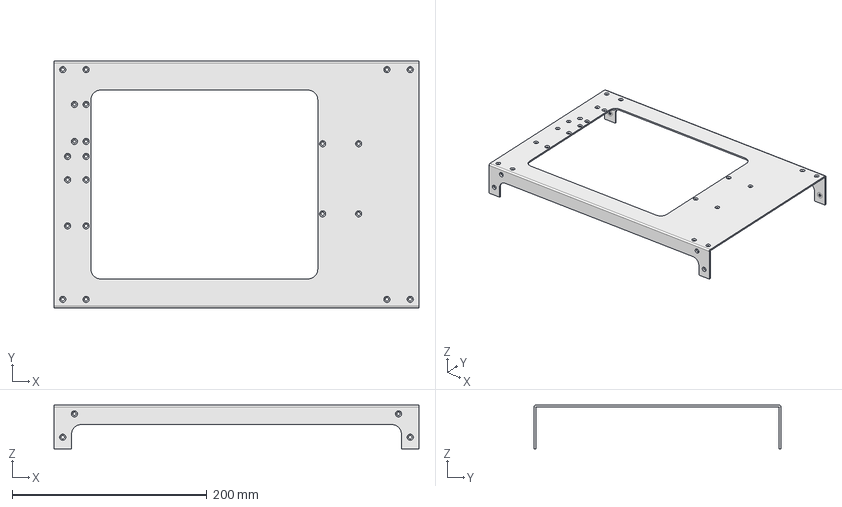
[picture p41: CAD file, 2017-09-28]
production_parts/machined_parts/right_side/right-side-mini_PP-FP0052_revG.step
375.0 x 254.0 x 45.0 mm
