reprapperMC/mini-hibiscus/production_parts/machined_parts/smooth_rod_mini/8mmx315_rod_v1.0_revA.step

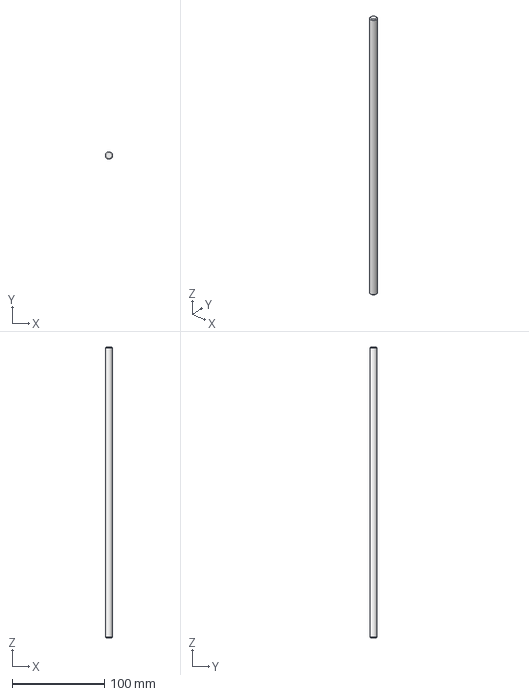
[picture p43: CAD file, 2018-02-07]
production_parts/machined_parts/smooth_rod_mini/8mmx315_rod_v1.0_revA.step
7.99 x 8.00 x 315.0 mm
