reprapperMC/mini-hibiscus/production_parts/printed_parts/bed_corner/ATTIC/bed_corner_mini_2pb.step

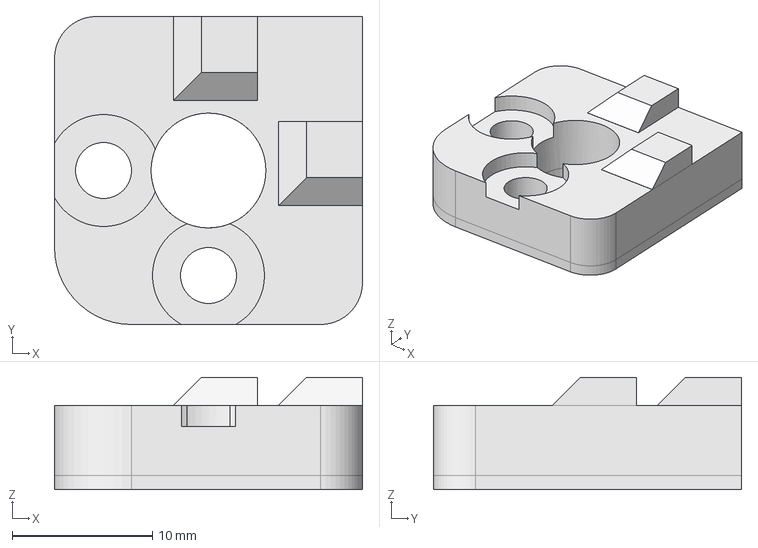
[picture p45: CAD file, 2017-11-30]
production_parts/printed_parts/bed_corner/ATTIC/bed_corner_mini_2pb.step
22.0 x 22.0 x 8.00 mm
