reprapperMC/mini-hibiscus/production_parts/printed_parts/bed_corner/bed_corner_mini_2pb_v2.fcstd

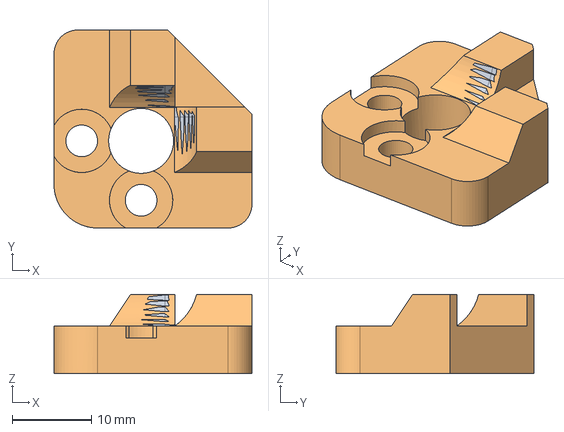
[picture p46: CAD file, 2018-01-24]
production_parts/printed_parts/bed_corner/bed_corner_mini_2pb_v2.fcstd
25.0 x 25.0 x 10.0 mm
