reprapperMC/mini-hibiscus/production_parts/printed_parts/belt-mount/belt-mount_black_v1.2.fcstd

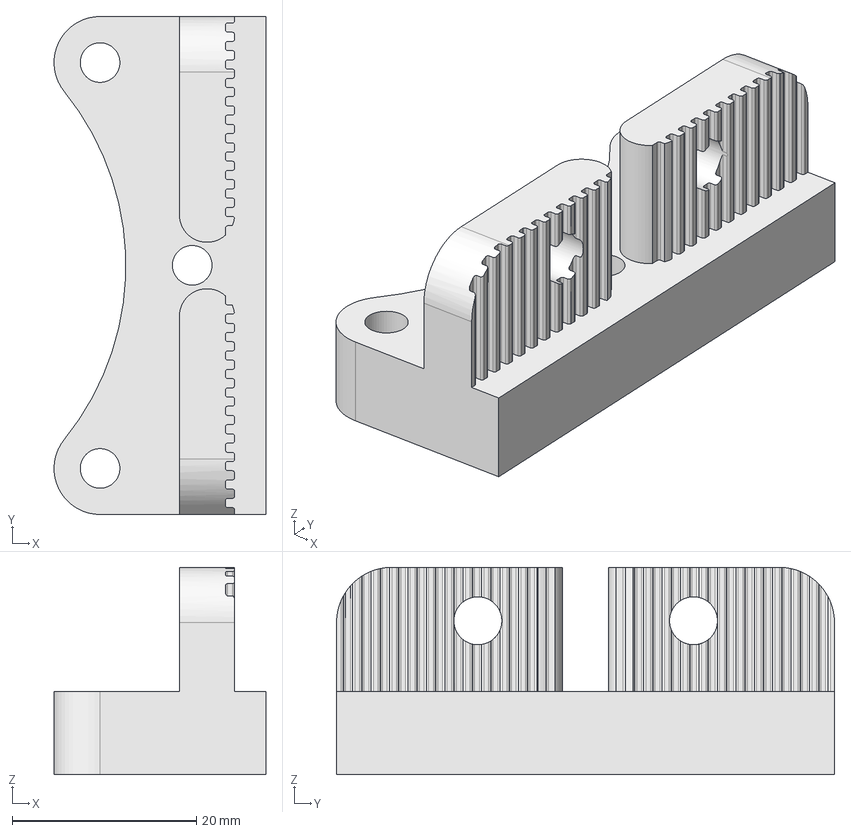
[picture p48: CAD file, 2017-10-20]
production_parts/printed_parts/belt-mount/belt-mount_black_v1.2.fcstd
23.0 x 54.0 x 22.5 mm
