reprapperMC/mini-hibiscus/production_parts/printed_parts/belt_tensioning_collar/belt_tensioner_v1.2.stl

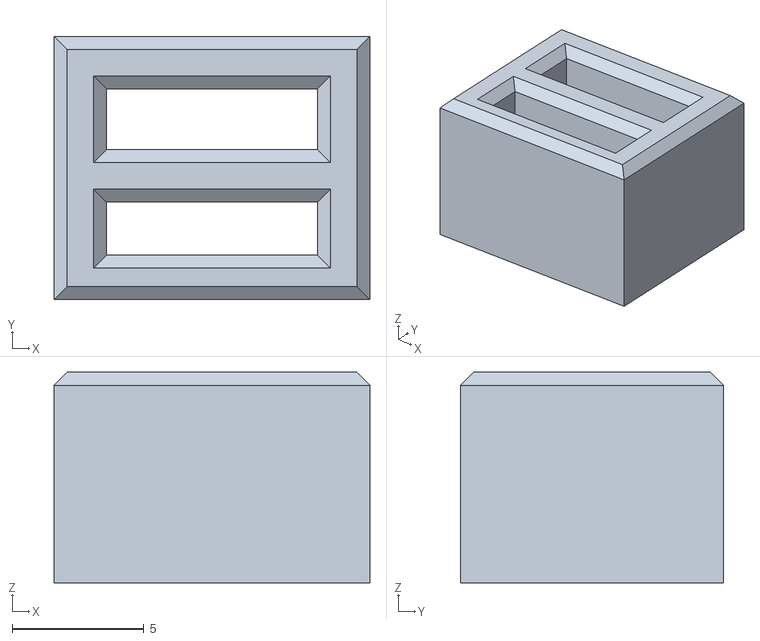
[picture p49: CAD file, 2018-04-20]
production_parts/printed_parts/belt_tensioning_collar/belt_tensioner_v1.2.stl
12.0 x 10.0 x 8.00
