reprapperMC/mini-hibiscus/production_parts/printed_parts/blower_shroud/ATTIC/Universal_blower_duct_V1.stl

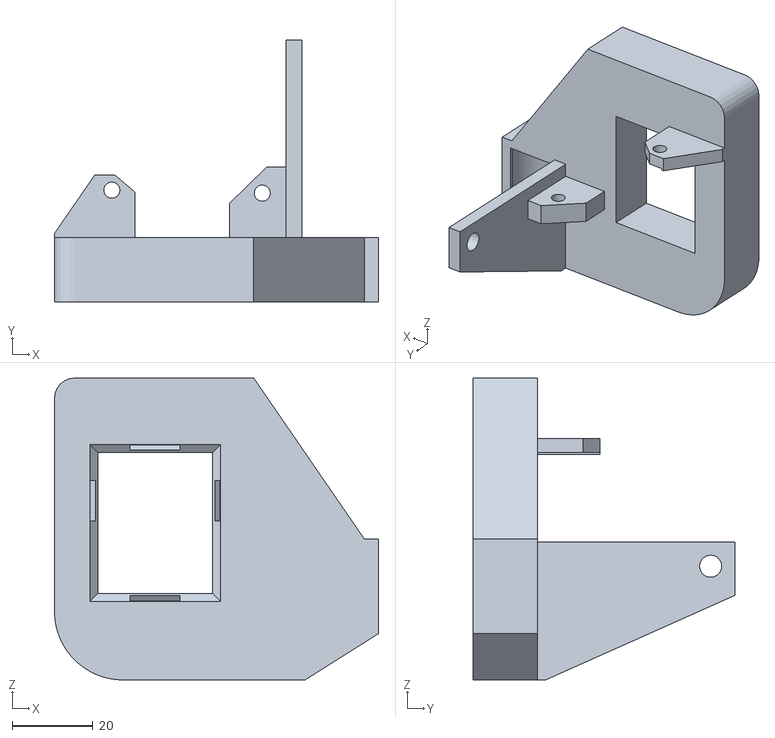
[picture p50: CAD file, 2018-01-16]
production_parts/printed_parts/blower_shroud/ATTIC/Universal_blower_duct_V1.stl
80.5 x 65.0 x 75.0
