reprapperMC/mini-hibiscus/production_parts/printed_parts/blower_shroud/blower_duct_v2.stl

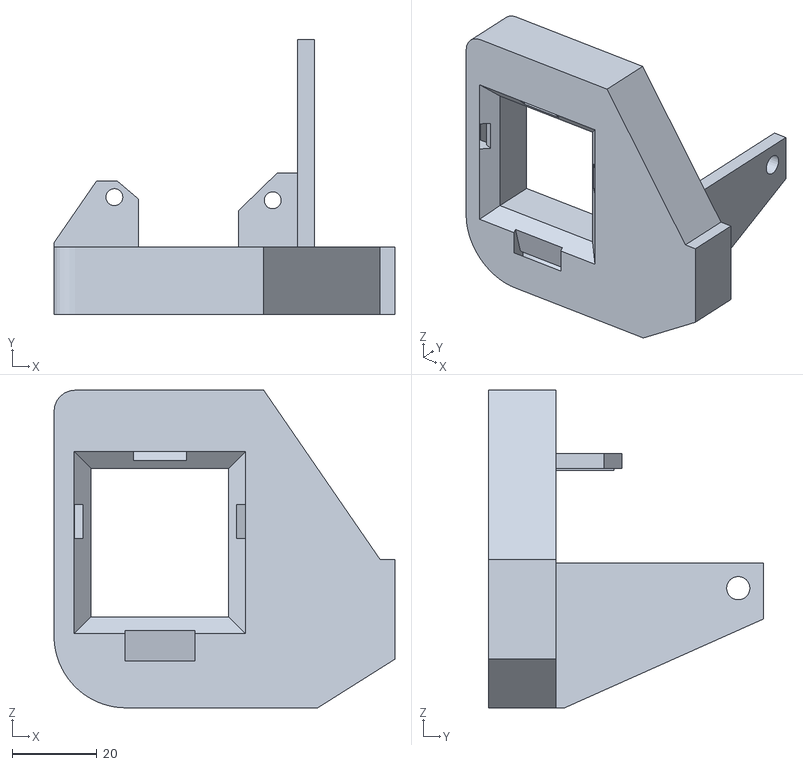
[picture p51: CAD file, 2018-02-06]
production_parts/printed_parts/blower_shroud/blower_duct_v2.stl
80.5 x 65.0 x 75.0
