reprapperMC/mini-hibiscus/production_parts/printed_parts/bump_stop/bump_stop.fcstd

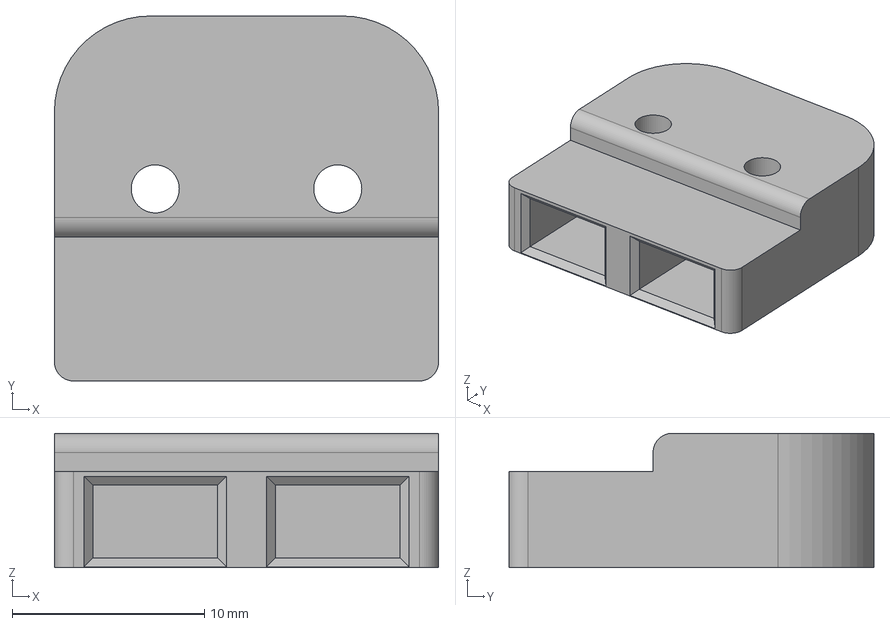
[picture p52: CAD file, 2017-12-04]
production_parts/printed_parts/bump_stop/bump_stop.fcstd
20.0 x 19.0 x 7.00 mm
