reprapperMC/mini-hibiscus/production_parts/printed_parts/double-bearing-holder/ATTIC/double-bearing-holder_black_v1.8.1.fcstd

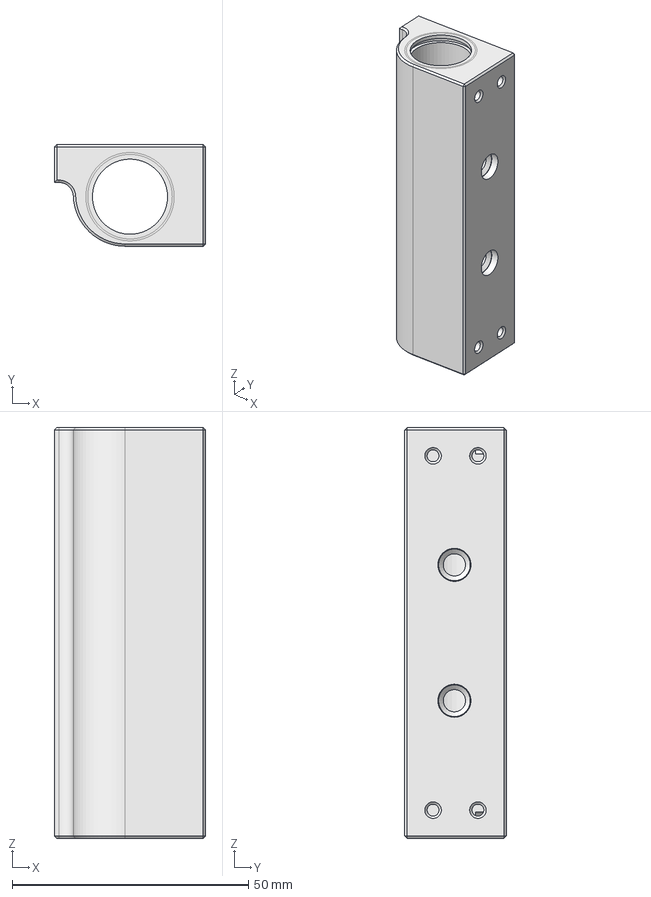
[picture p53: CAD file, 2018-01-22]
production_parts/printed_parts/double-bearing-holder/ATTIC/double-bearing-holder_black_v1.8.1.fcstd
32.0 x 21.5 x 87.0 mm
