reprapperMC/mini-hibiscus/production_parts/printed_parts/extruder_mount/ATTIC/hibiscus_beefy_extruder_mount.fcstd

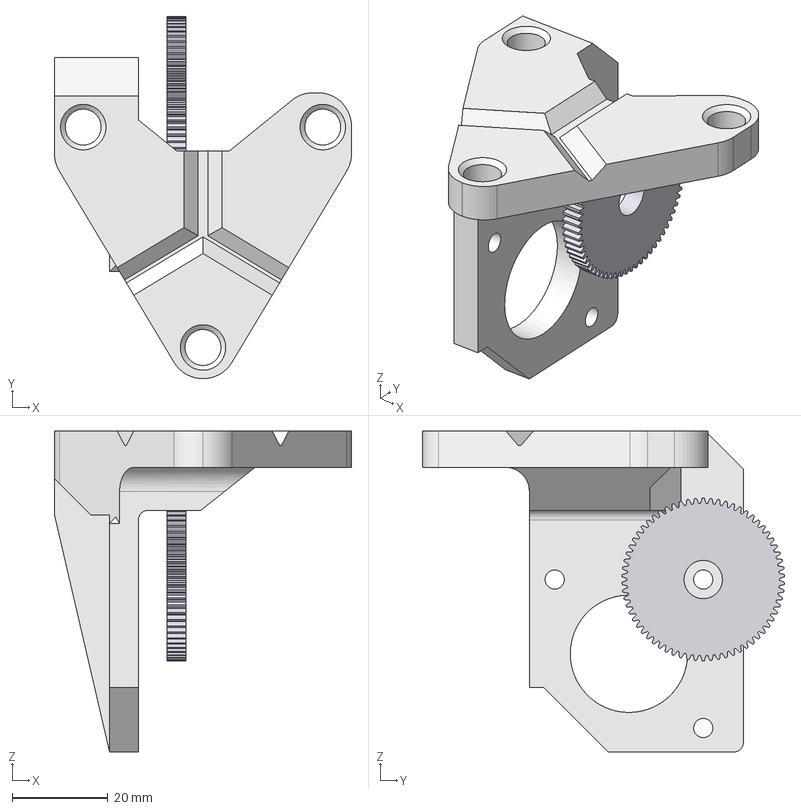
[picture p54: CAD file, 2017-12-29]
production_parts/printed_parts/extruder_mount/ATTIC/hibiscus_beefy_extruder_mount.fcstd
62.0 x 75.6 x 67.0 mm
spur_gear_step1_01
