reprapperMC/mini-hibiscus/production_parts/printed_parts/extruder_mount/Beefy_extruder_mount_v2.1.fcstd

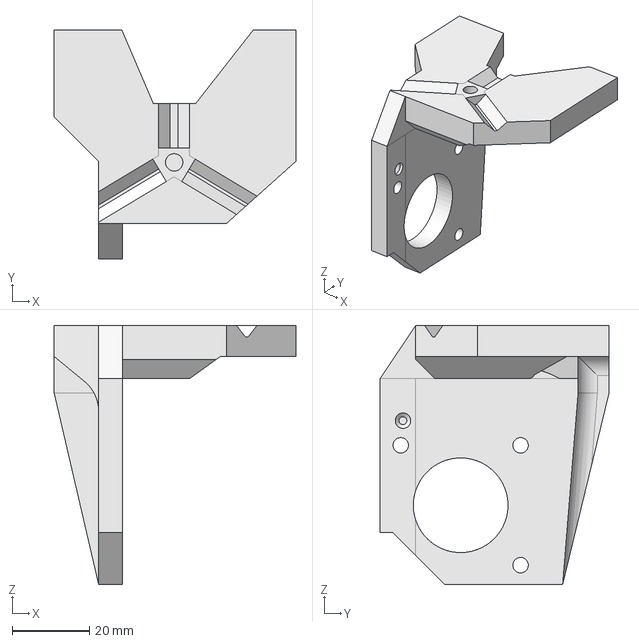
[picture p55: CAD file, 2018-03-28]
production_parts/printed_parts/extruder_mount/Beefy_extruder_mount_v2.1.fcstd
62.5 x 59.2 x 67.0 mm
