reprapperMC/mini-hibiscus/production_parts/printed_parts/handle/handle-bar_black_v2.7.step

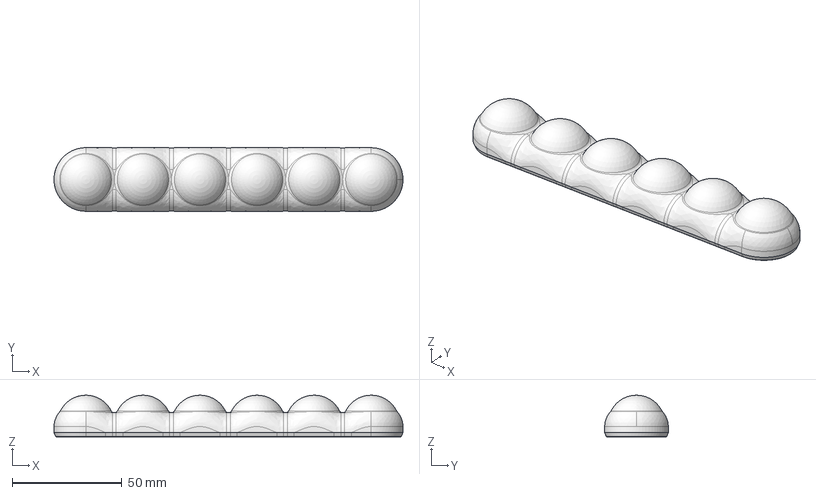
[picture p56: CAD file, 2017-09-28]
production_parts/printed_parts/handle/handle-bar_black_v2.7.step
159.0 x 29.0 x 19.0 mm
