reprapperMC/mini-hibiscus/production_parts/printed_parts/Heatsink_frame/einsy_heatsink_frame.fcstd

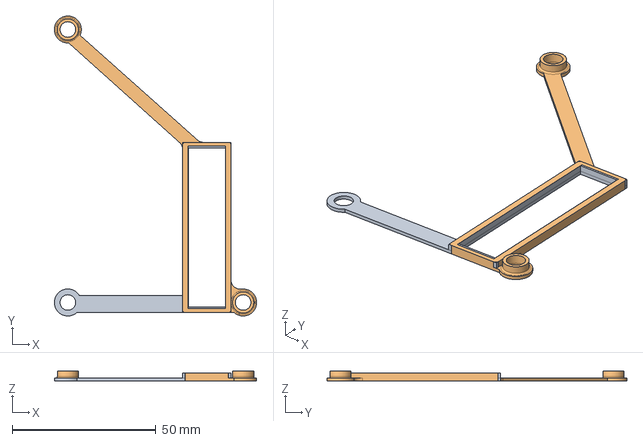
[picture p57: CAD file, 2018-01-25]
production_parts/printed_parts/Heatsink_frame/einsy_heatsink_frame.fcstd
70.4 x 104.4 x 3.50 mm
