reprapperMC/mini-hibiscus/production_parts/printed_parts/LCD_Printed_parts/cover_spacer/cover_spacer.fcstd

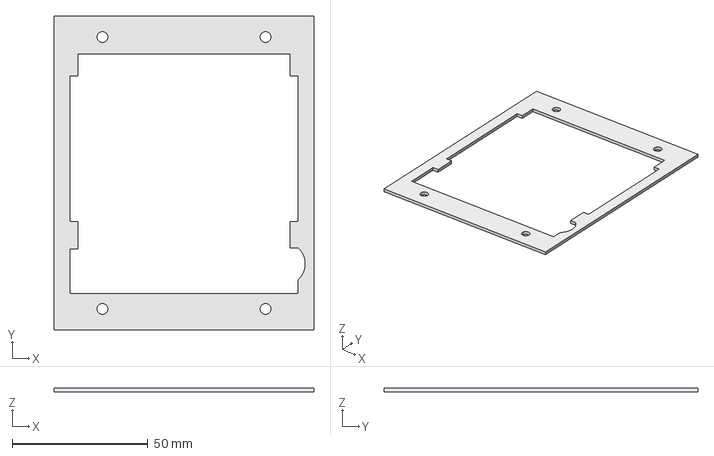
[picture p58: CAD file, 2018-01-30]
production_parts/printed_parts/LCD_Printed_parts/cover_spacer/cover_spacer.fcstd
95.5 x 115.5 x 1.50 mm
