reprapperMC/mini-hibiscus/production_parts/printed_parts/LCD_Printed_parts/LCD_Mini_bracket_right_v1/LCD_Mini_bracket_RIGHT.fcstd

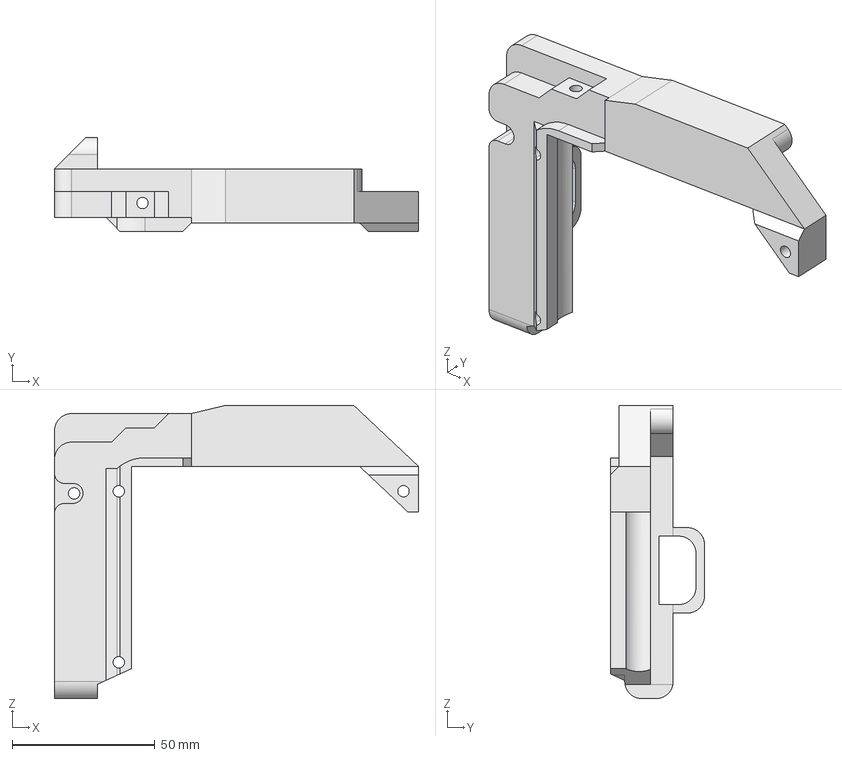
[picture p59: CAD file, 2018-01-29]
production_parts/printed_parts/LCD_Printed_parts/LCD_Mini_bracket_right_v1/LCD_Mini_bracket_RIGHT.fcstd
127.7 x 33.0 x 102.9 mm
