reprapperMC/mini-hibiscus/production_parts/printed_parts/LCD_Printed_parts/lcd_spacer/lcd_spacer_v0.4.FCStd

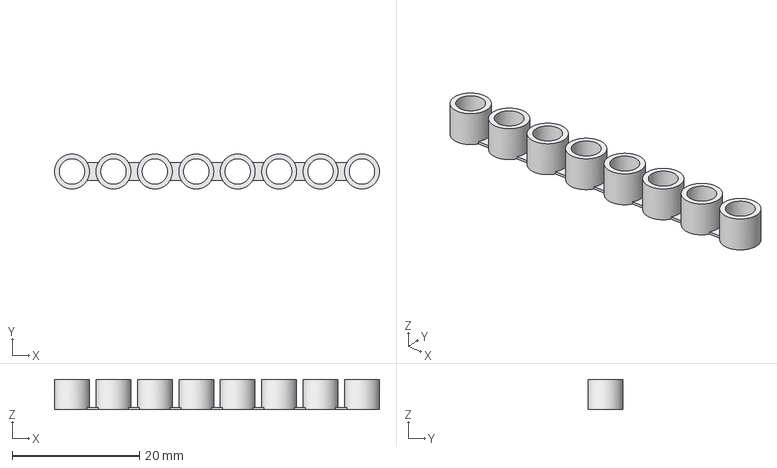
[picture p60: CAD file, 2018-01-29]
production_parts/printed_parts/LCD_Printed_parts/lcd_spacer/lcd_spacer_v0.4.FCStd
51.0 x 5.50 x 4.75 mm
