reprapperMC/mini-hibiscus/production_parts/printed_parts/LCD_Printed_parts/mini_lcd_bezel/mini_lcd_bezel.fcstd

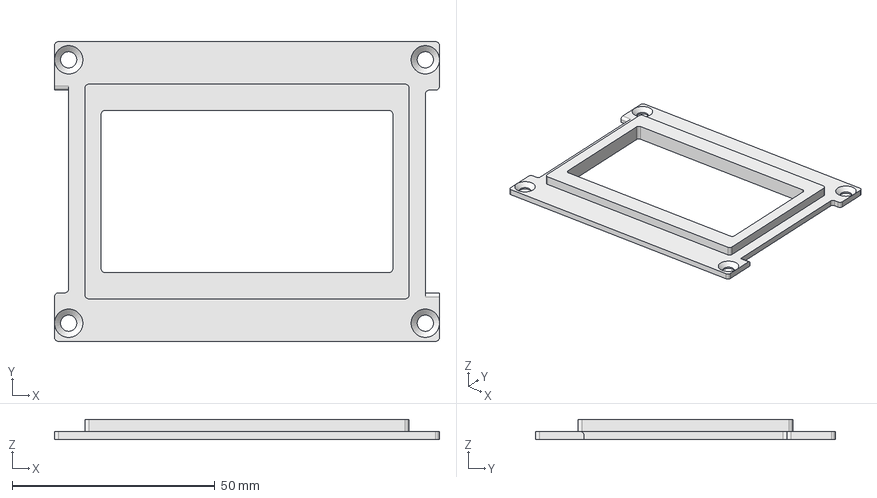
[picture p61: CAD file, 2018-01-29]
production_parts/printed_parts/LCD_Printed_parts/mini_lcd_bezel/mini_lcd_bezel.fcstd
95.0 x 74.0 x 5.00 mm
