reprapperMC/mini-hibiscus/production_parts/printed_parts/LCD_Printed_parts/Mini_lcd_bezel_spacer/Mini_lcd_bezel_spacer.fcstd

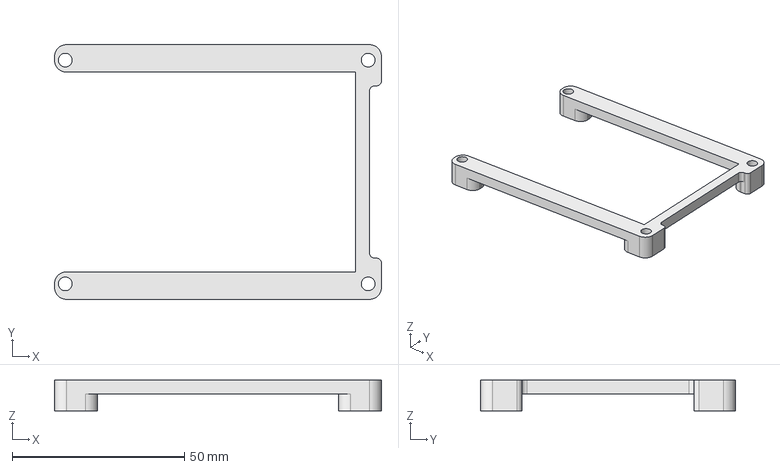
[picture p62: CAD file, 2018-01-29]
production_parts/printed_parts/LCD_Printed_parts/Mini_lcd_bezel_spacer/Mini_lcd_bezel_spacer.fcstd
95.0 x 74.0 x 9.00 mm
