reprapperMC/mini-hibiscus/production_parts/printed_parts/LCD_Printed_parts/Mini_lcd_case/LCD_case_v3.1.fcstd

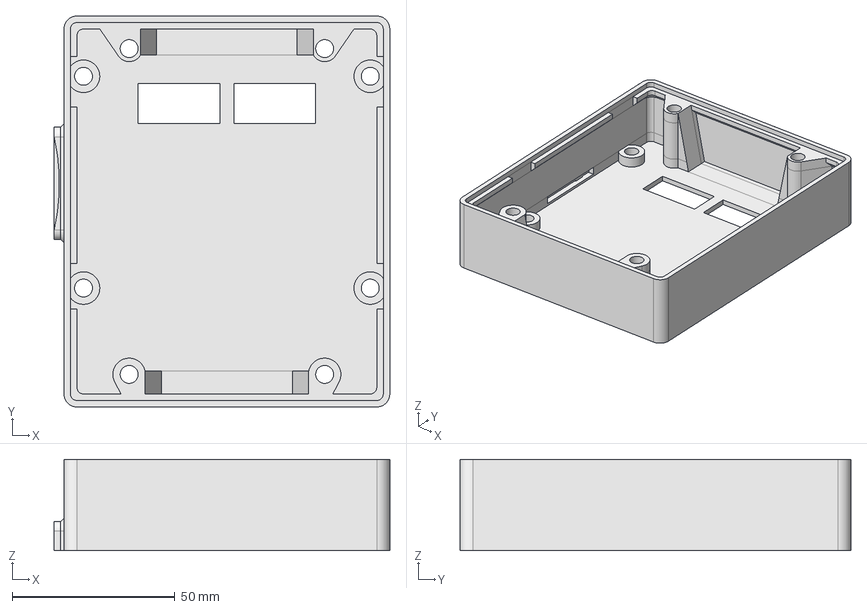
[picture p63: CAD file, 2018-01-29]
production_parts/printed_parts/LCD_Printed_parts/Mini_lcd_case/LCD_case_v3.1.fcstd
103.0 x 120.0 x 28.0 mm
