reprapperMC/mini-hibiscus/production_parts/printed_parts/LCD_Printed_parts/mini_lcd_knob/mini_lcd_knob.fcstd

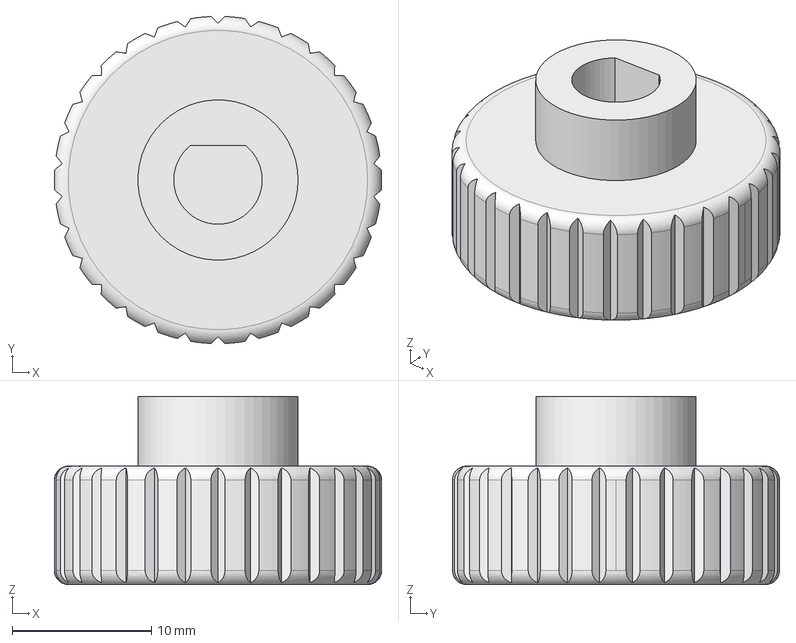
[picture p64: CAD file, 2018-01-29]
production_parts/printed_parts/LCD_Printed_parts/mini_lcd_knob/mini_lcd_knob.fcstd
23.5 x 23.5 x 13.5 mm
