reprapperMC/mini-hibiscus/production_parts/printed_parts/LCD_Printed_parts/Side_cable_bracket/side_cable_bracket.fcstd

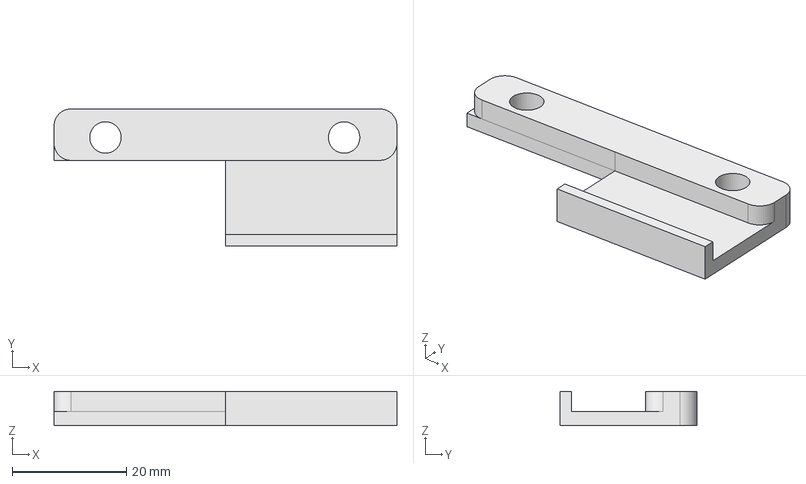
[picture p65: CAD file, 2018-01-29]
production_parts/printed_parts/LCD_Printed_parts/Side_cable_bracket/side_cable_bracket.fcstd
60.0 x 24.0 x 6.00 mm
