reprapperMC/mini-hibiscus/production_parts/printed_parts/LCD_Printed_parts/Top_cable_bracket/top_cable_bracket.fcstd

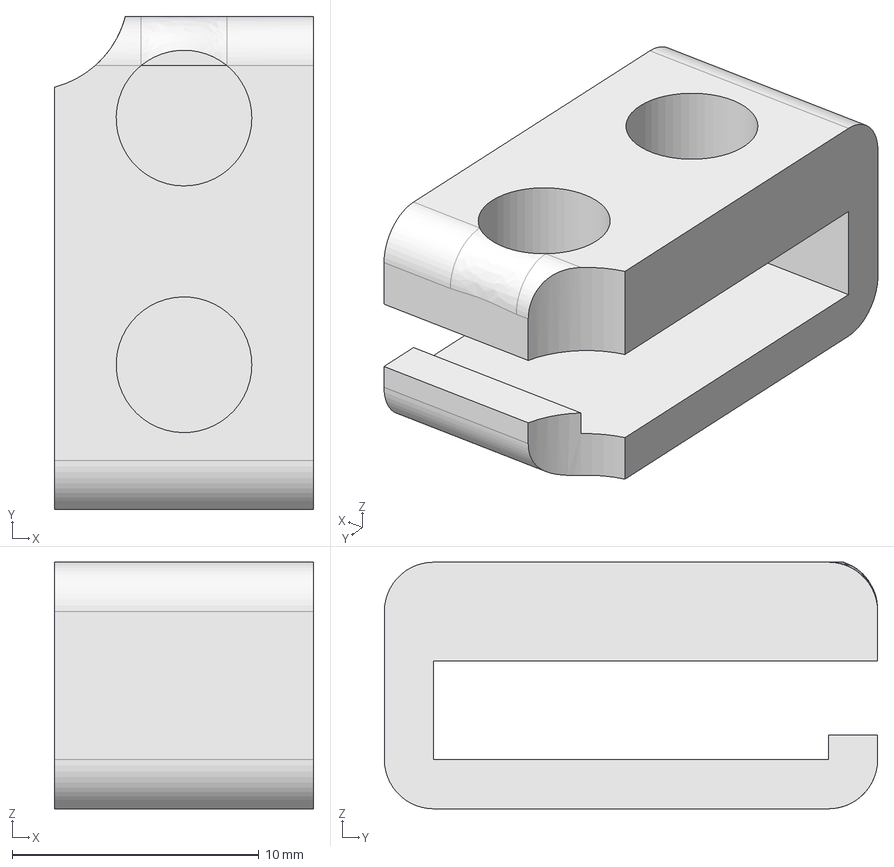
[picture p66: CAD file, 2018-03-16]
production_parts/printed_parts/LCD_Printed_parts/Top_cable_bracket/top_cable_bracket.fcstd
10.5 x 20.0 x 10.0 mm
