reprapperMC/mini-hibiscus/Production_parts/printed_parts/Mini2_assem.fcstd

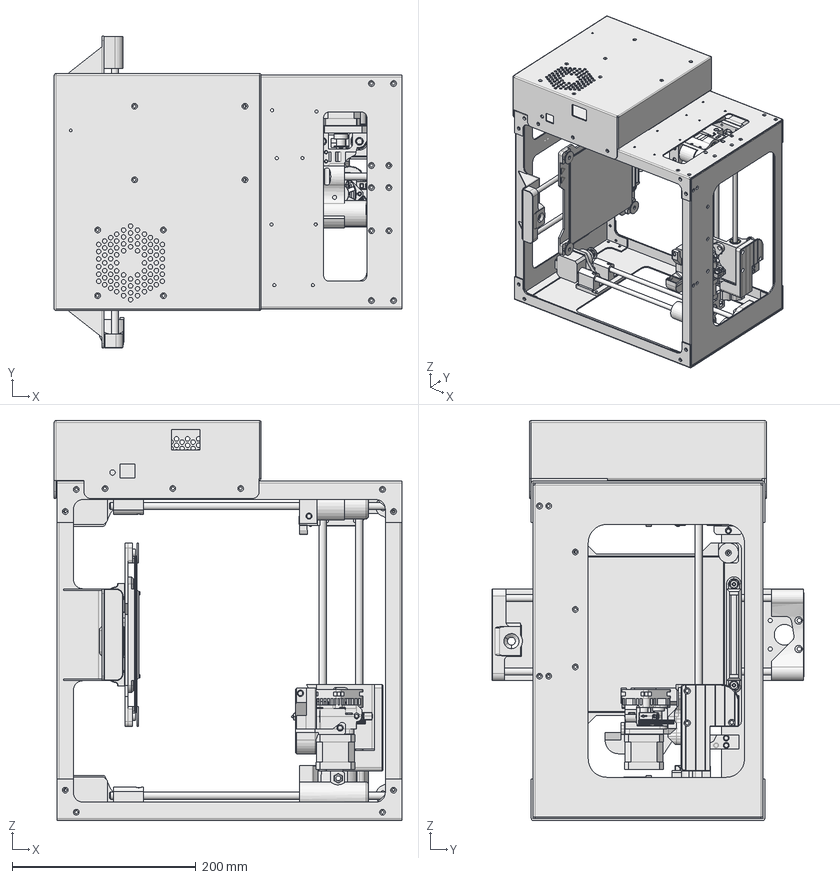
[picture p67: CAD file, 2017-09-28]
Production_parts/printed_parts/Mini2_assem.fcstd
378.0 x 339.0 x 435.0 mm
left_side_mini_PP_FP0055_revH_step1_01
z_upper_left_01
_mmx315_rod_v1_0_step1_01
_mmx315_rod_v1_0_step1_02
X_motor_01
bottom_plate_mini_PP_MP0149_revB_step1_01
Y_Axis_01
y_idler_mini_black_v1_4_step1_01
y_motor_mount_black_v1_step1_01
_mmx315_rod_v1_0_step1_03
_mmx315_rod_v1_0_step1_04
nema17_W_PULLEY_01
z_lower_left_01
right_side_mini_PP_FP0052_revF_step1_01
z_lower_right_01
_mmx315_rod_v1_0_step1_05
_mmx315_rod_v1_0_step1_06
z_upper_right_01
x_carriage_01
RJM_01_08_1_stp1_01
RJM_01_08_1_stp1_02
RJM_01_08_1_stp1_03
RJM_01_08_1_stp1_04
RJM_01_08_1_stp1_05
RJM_01_08_1_stp1_06
RJM_01_08_1_stp1_07
limit_switch_01
z_motor_w_pulley_assembly_01
z_motor_w_pulley_assembly_02
x_carriage_cap_01
X_idler_01
top_plate_mini_PP_FP0051_revG_01
_25_bearing_01
_25_bearing_02
x_belt_tensioner_01
titan_aero_mini_toolhead_01
electronics_case_mini_PP_FP0082_revH_step1_01
