reprapperMC/mini-hibiscus/production_parts/printed_parts/retaining_ring/ATTIC/retaining-ring.fcstd

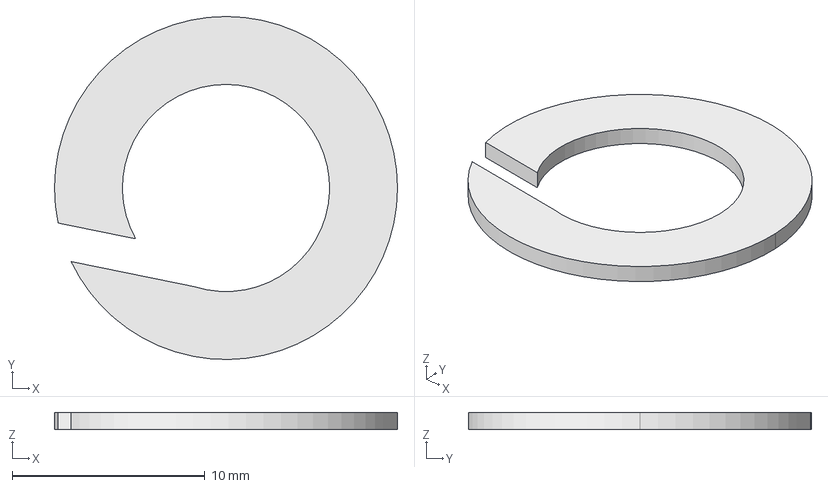
[picture p68: CAD file, 2017-11-20]
production_parts/printed_parts/retaining_ring/ATTIC/retaining-ring.fcstd
17.8 x 17.8 x 0.9 mm
