reprapperMC/mini-hibiscus/production_parts/printed_parts/retaining_ring/retaining-ring_v2.fcstd

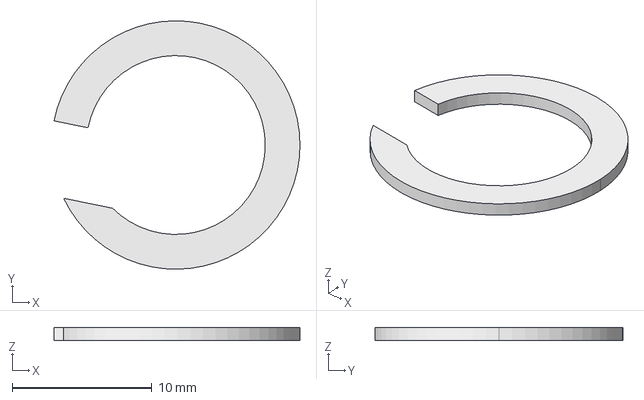
[picture p69: CAD file, 2018-01-08]
production_parts/printed_parts/retaining_ring/retaining-ring_v2.fcstd
17.6 x 17.8 x 0.9 mm
