reprapperMC/mini-hibiscus/production_parts/printed_parts/spool-arm-bracket/spool-arm-bracket_black_v1.0.step

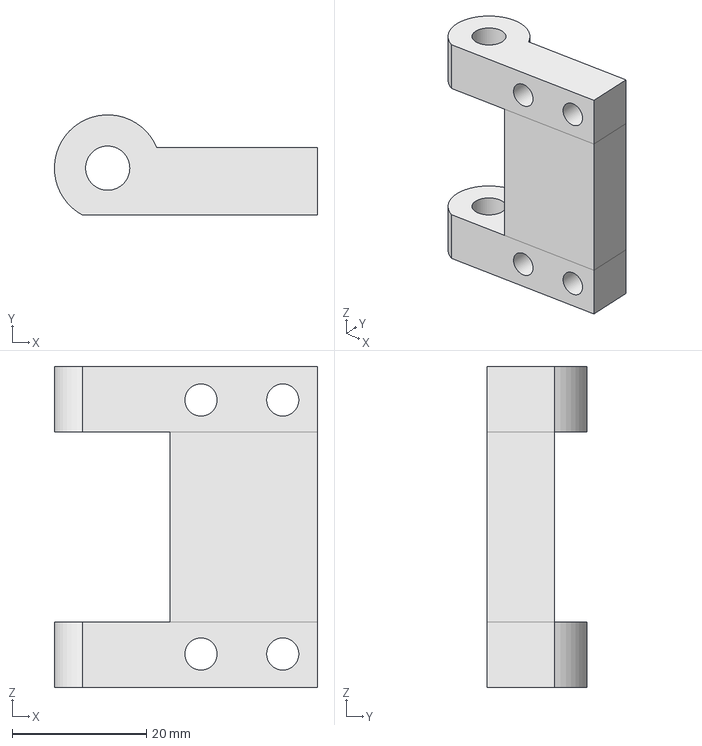
[picture p70: CAD file, 2017-09-28]
production_parts/printed_parts/spool-arm-bracket/spool-arm-bracket_black_v1.0.step
39.3 x 14.9 x 47.9 mm
