reprapperMC/mini-hibiscus/production_parts/printed_parts/spool-arm-mini/spool-arm-mini_black_v1.4.step

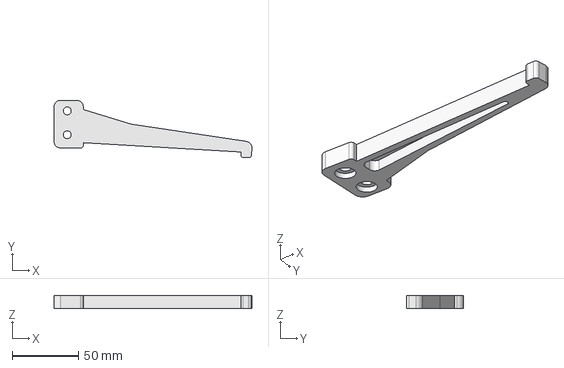
[picture p71: CAD file, 2017-09-28]
production_parts/printed_parts/spool-arm-mini/spool-arm-mini_black_v1.4.step
149.2 x 43.3 x 10.0 mm
