reprapperMC/mini-hibiscus/production_parts/printed_parts/spool_arm_support/ATTIC/spool_mount_a.fcstd

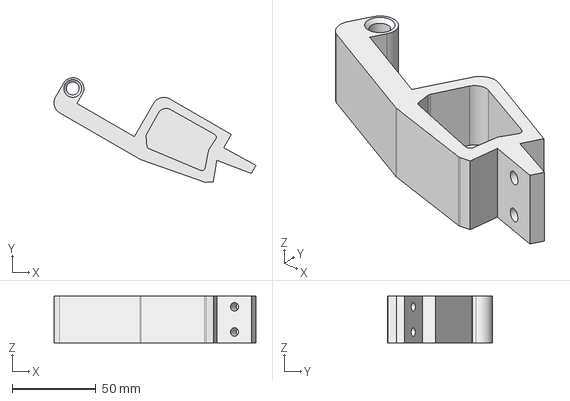
[picture p72: CAD file, 2017-09-20]
production_parts/printed_parts/spool_arm_support/ATTIC/spool_mount_a.fcstd
120.4 x 62.4 x 27.9 mm
