reprapperMC/mini-hibiscus/production_parts/printed_parts/spool_arm_support/spool_mount_b_v1.5.fcstd

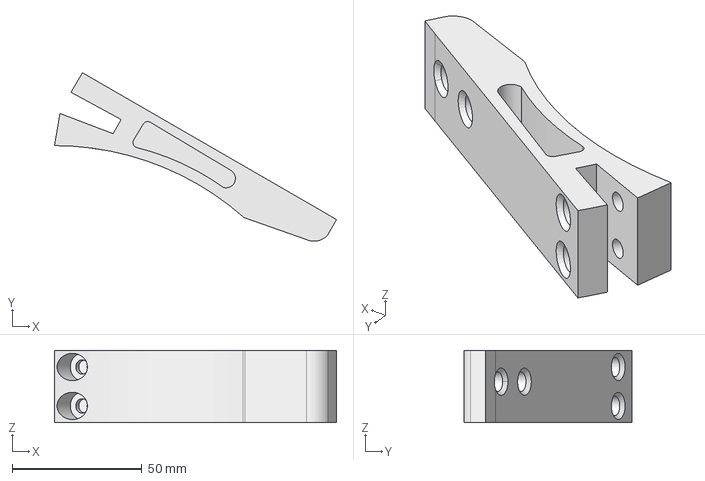
[picture p73: CAD file, 2018-01-18]
production_parts/printed_parts/spool_arm_support/spool_mount_b_v1.5.fcstd
108.7 x 64.9 x 27.9 mm
