reprapperMC/mini-hibiscus/production_parts/printed_parts/strain-relief-lower/strain-relief-lower_black_1.2.step

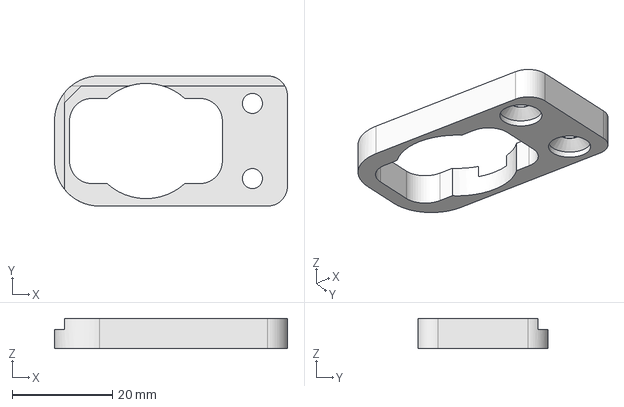
[picture p74: CAD file, 2017-09-28]
production_parts/printed_parts/strain-relief-lower/strain-relief-lower_black_1.2.step
46.5 x 26.0 x 6.00 mm
