reprapperMC/mini-hibiscus/production_parts/printed_parts/strain-relief-upper/strain-relief-upper_black_v3.0.step

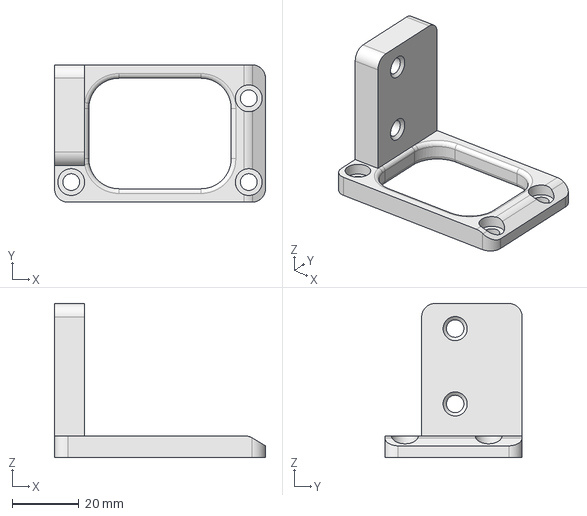
[picture p75: CAD file, 2017-09-28]
production_parts/printed_parts/strain-relief-upper/strain-relief-upper_black_v3.0.step
63.0 x 41.0 x 46.0 mm
