reprapperMC/mini-hibiscus/production_parts/printed_parts/wiper_mount/wiper_mount_v1.1-x3.stl

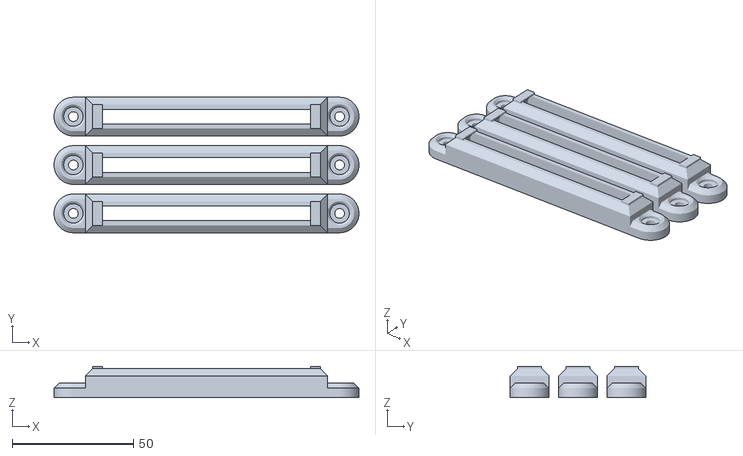
[picture p77: CAD file, 2017-09-28]
production_parts/printed_parts/wiper_mount/wiper_mount_v1.1-x3.stl
126.0 x 56.0 x 13.0
