reprapperMC/mini-hibiscus/production_parts/printed_parts/x_bearing_holder/ATTIC/x_bearing_holder_v3.7.2.stl

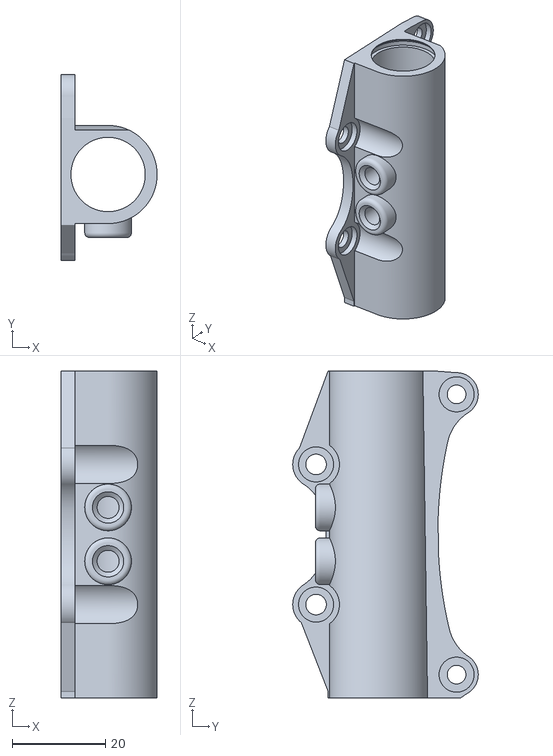
[picture p78: CAD file, 2018-01-22]
production_parts/printed_parts/x_bearing_holder/ATTIC/x_bearing_holder_v3.7.2.stl
20.6 x 39.7 x 70.0
