reprapperMC/mini-hibiscus/production_parts/printed_parts/x_bearing_holder/x_bearing_holder_V3.7.3.step

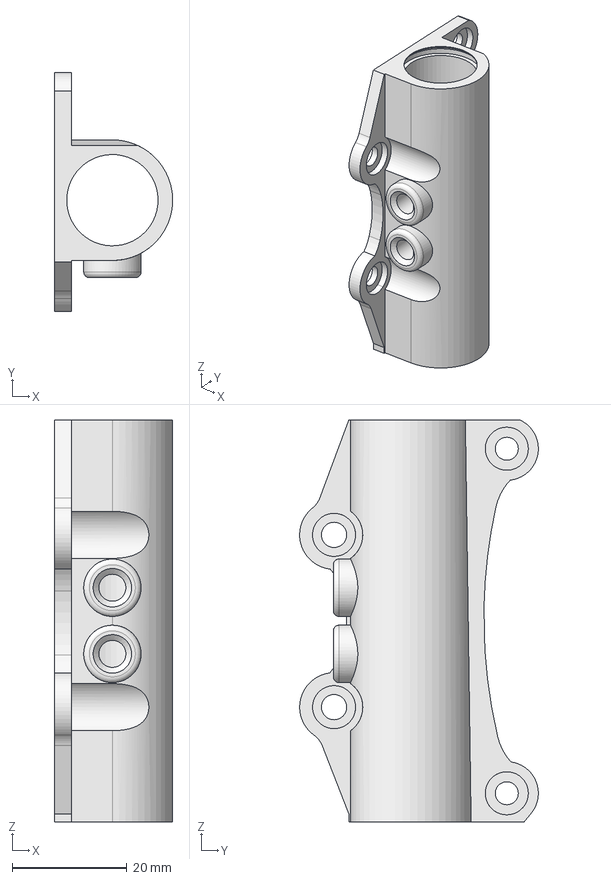
[picture p79: CAD file, 2018-02-09]
production_parts/printed_parts/x_bearing_holder/x_bearing_holder_V3.7.3.step
20.6 x 41.6 x 70.0 mm
