reprapperMC/mini-hibiscus/production_parts/printed_parts/x_belt_tensioner/ATTIC/minii_x_clamp_post_v1.1.fcstd

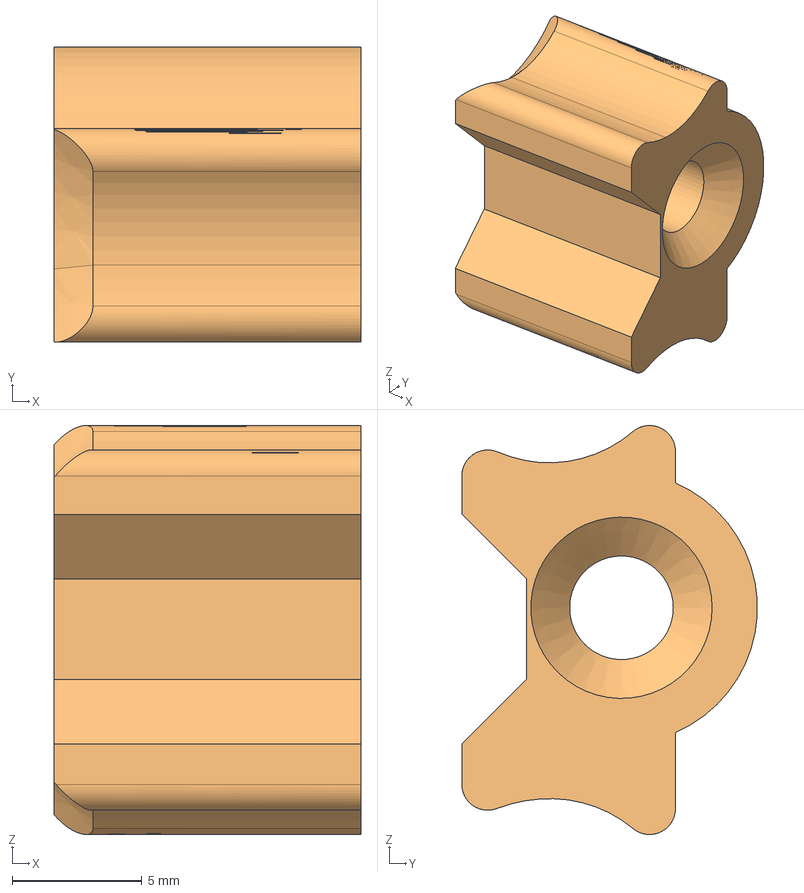
[picture p80: CAD file, 2018-04-23]
production_parts/printed_parts/x_belt_tensioner/ATTIC/minii_x_clamp_post_v1.1.fcstd
11.9 x 11.4 x 15.8 mm
