reprapperMC/mini-hibiscus/production_parts/printed_parts/x_belt_tensioner/minii_x_clamp_post_v1.2.fcstd

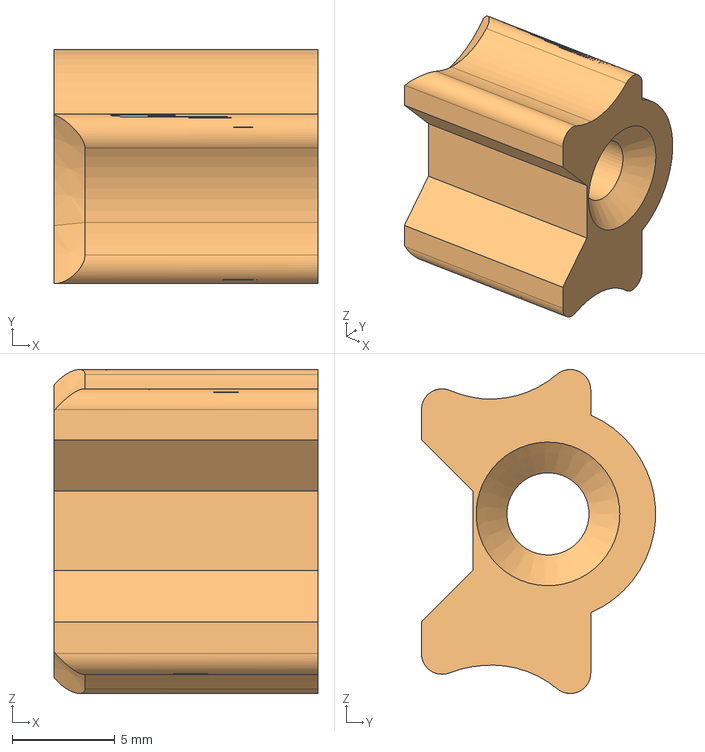
[picture p81: CAD file, 2018-04-24]
production_parts/printed_parts/x_belt_tensioner/minii_x_clamp_post_v1.2.fcstd
12.9 x 11.4 x 15.8 mm
