reprapperMC/mini-hibiscus/production_parts/printed_parts/x_carriage_cap_mini2/ATTIC/x_carriage_cap_mini2_v3.3.fcstd

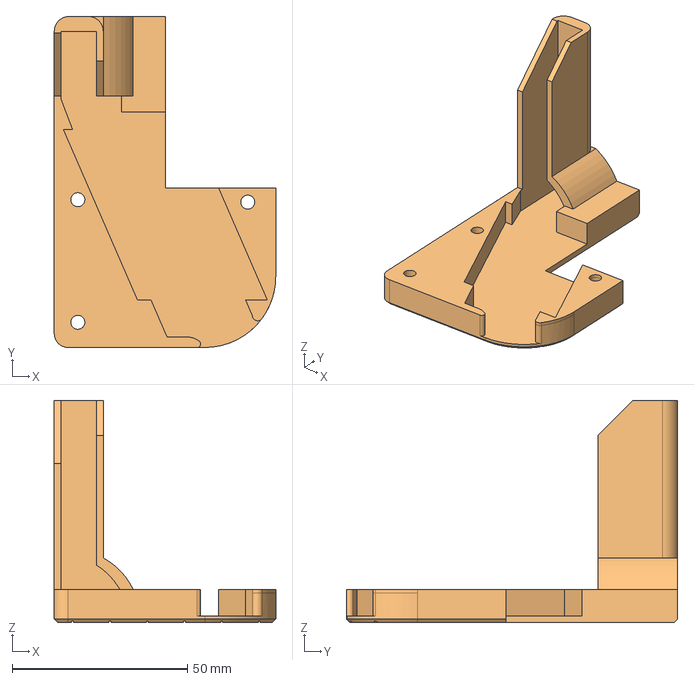
[picture p82: CAD file, 2017-11-14]
production_parts/printed_parts/x_carriage_cap_mini2/ATTIC/x_carriage_cap_mini2_v3.3.fcstd
63.3 x 94.5 x 63.5 mm
