reprapperMC/mini-hibiscus/production_parts/printed_parts/x_carriage_cap_mini2/minii_X_carriage_cap_v2.fcstd

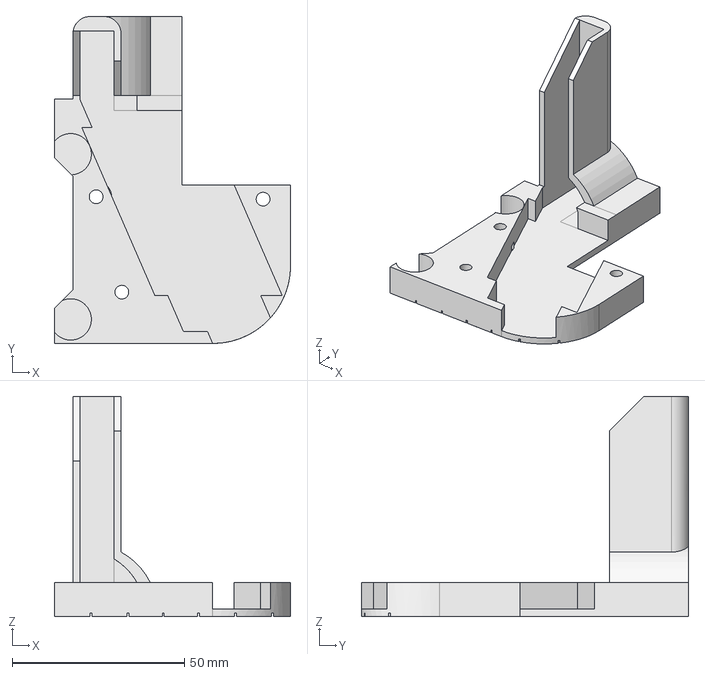
[picture p83: CAD file, 2018-03-08]
production_parts/printed_parts/x_carriage_cap_mini2/minii_X_carriage_cap_v2.fcstd
68.6 x 95.0 x 64.0 mm
