reprapperMC/mini-hibiscus/production_parts/printed_parts/x_carriage_mini2/ATTIC/x_carriage_v4.3.1.step

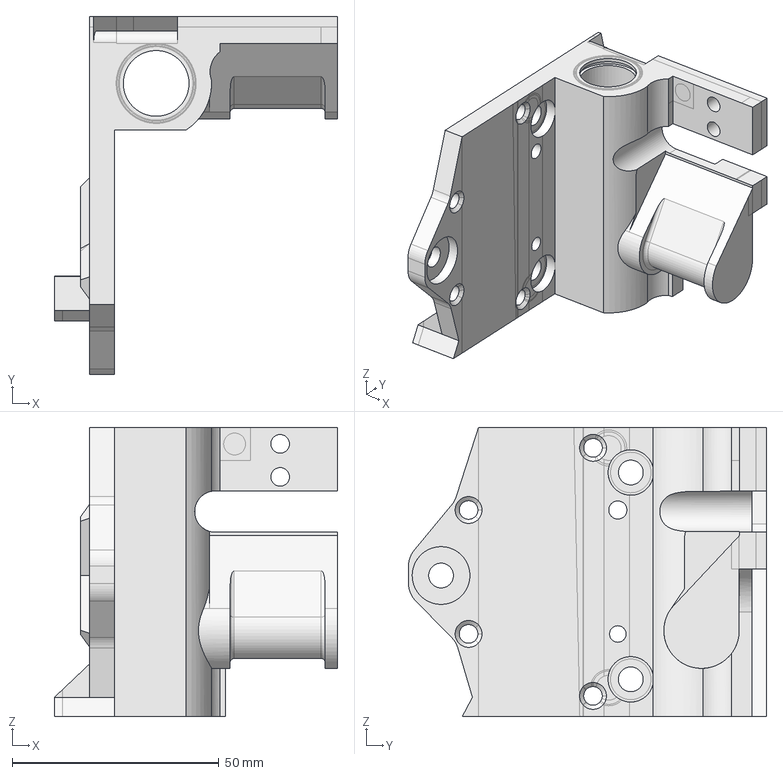
[picture p84: CAD file, 2018-01-08]
production_parts/printed_parts/x_carriage_mini2/ATTIC/x_carriage_v4.3.1.step
68.5 x 86.6 x 70.0 mm
