reprapperMC/mini-hibiscus/production_parts/printed_parts/x_carriage_mini2/Minii_x_carriage_V2.fcstd

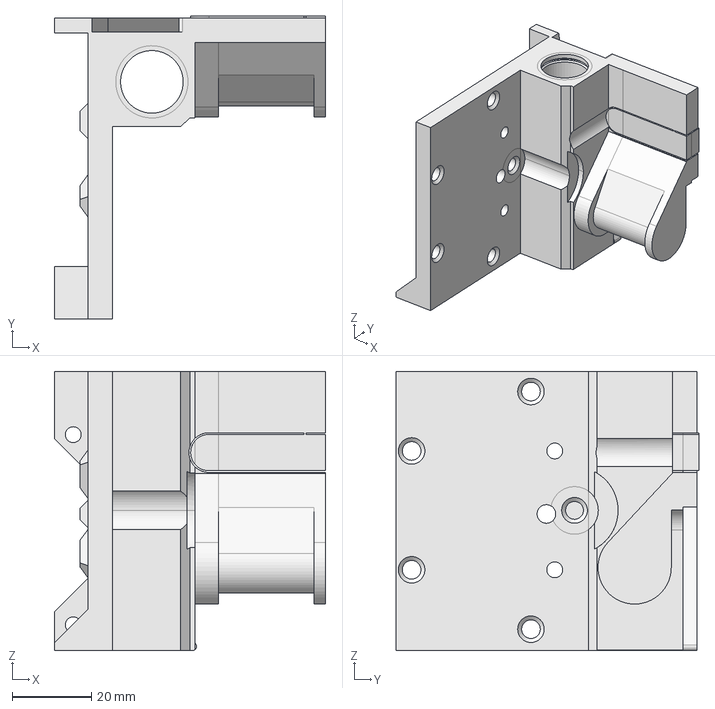
[picture p85: CAD file, 2018-01-10]
production_parts/printed_parts/x_carriage_mini2/Minii_x_carriage_V2.fcstd
68.5 x 76.5 x 70.5 mm
