reprapperMC/mini-hibiscus/production_parts/printed_parts/x_end_idler_mini2/ATTIC/x_end_idler_v2.8.4_mini2.stl

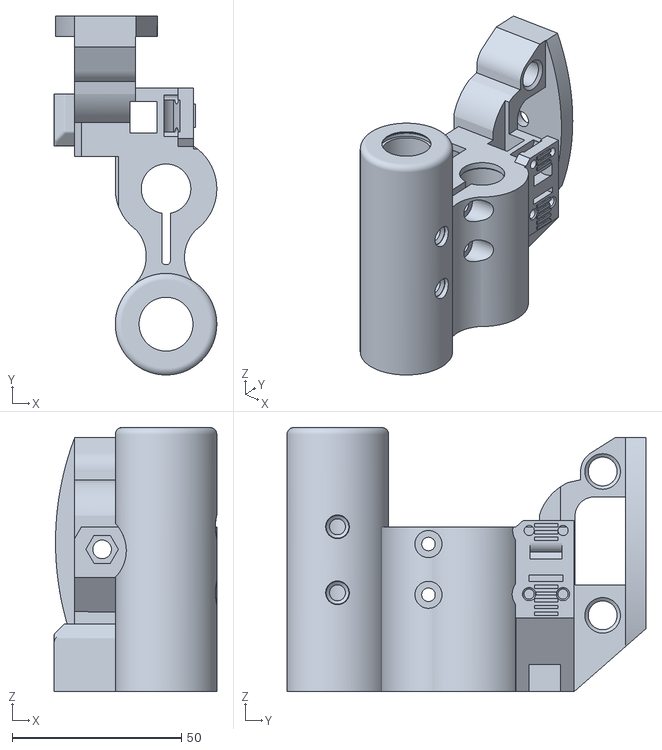
[picture p86: CAD file, 2018-03-21]
production_parts/printed_parts/x_end_idler_mini2/ATTIC/x_end_idler_v2.8.4_mini2.stl
48.0 x 106.0 x 78.0
