reprapperMC/mini-hibiscus/production_parts/printed_parts/x_end_motor_mini2/ATTIC/x_end_motor_v2.5.1_mini2.stl

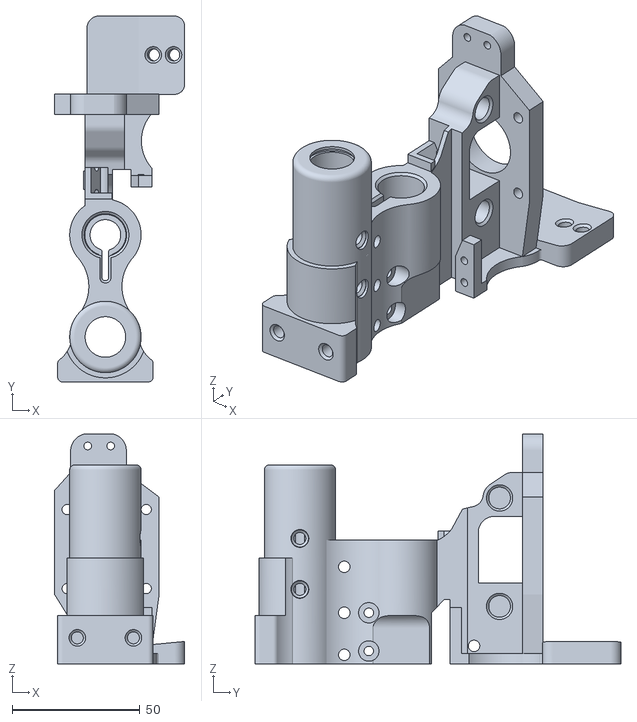
[picture p88: CAD file, 2018-01-03]
production_parts/printed_parts/x_end_motor_mini2/ATTIC/x_end_motor_v2.5.1_mini2.stl
51.1 x 143.5 x 90.0
