reprapperMC/mini-hibiscus/production_parts/printed_parts/y-idler/y-idler-mini_black_v1.6.step

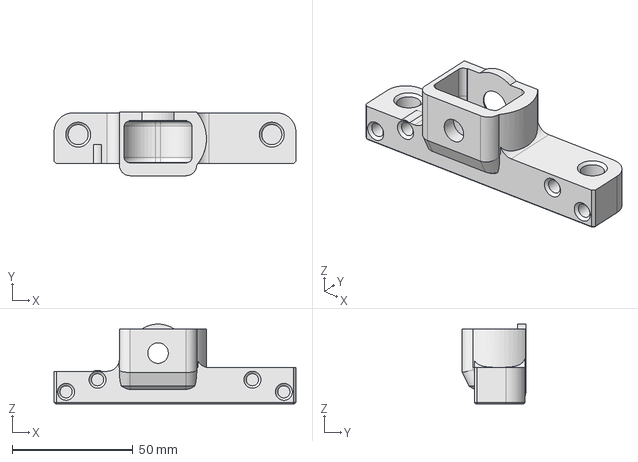
[picture p89: CAD file, 2017-11-30]
production_parts/printed_parts/y-idler/y-idler-mini_black_v1.6.step
100.0 x 26.3 x 33.0 mm
