reprapperMC/mini-hibiscus/production_parts/printed_parts/y-motor-mount/y-motor-mount_black_v1.step

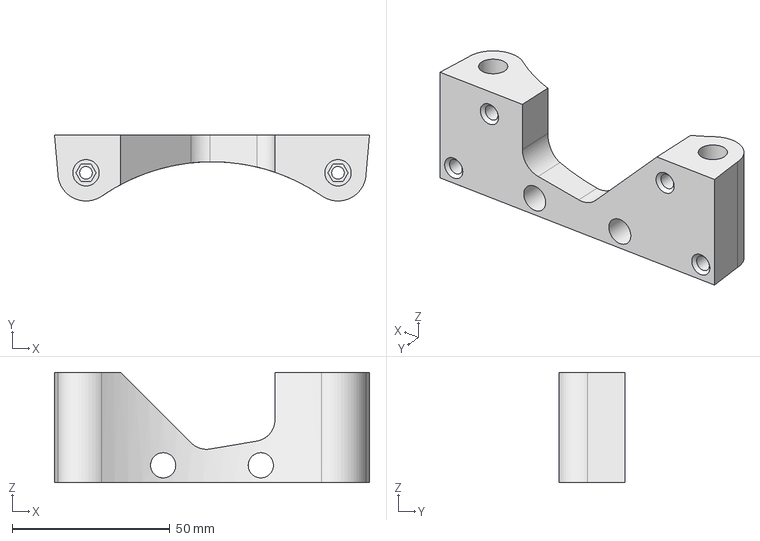
[picture p90: CAD file, 2017-09-28]
production_parts/printed_parts/y-motor-mount/y-motor-mount_black_v1.step
100.0 x 21.0 x 35.0 mm
