reprapperMC/mini-hibiscus/production_parts/printed_parts/Z-End_Pairs/Left_Pair_v0.2.fcstd

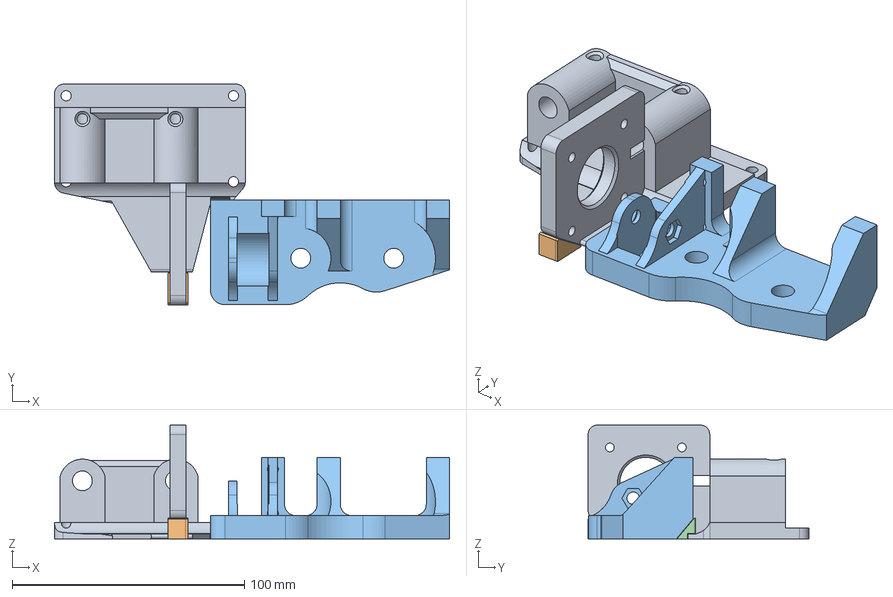
[picture p91: CAD file, 2018-02-14]
production_parts/printed_parts/Z-End_Pairs/Left_Pair_v0.2.fcstd
170.0 x 95.0 x 49.0 mm
