reprapperMC/mini-hibiscus/production_parts/printed_parts/z_belt_clamp/z_belt_clamp_v1.3.fcstd

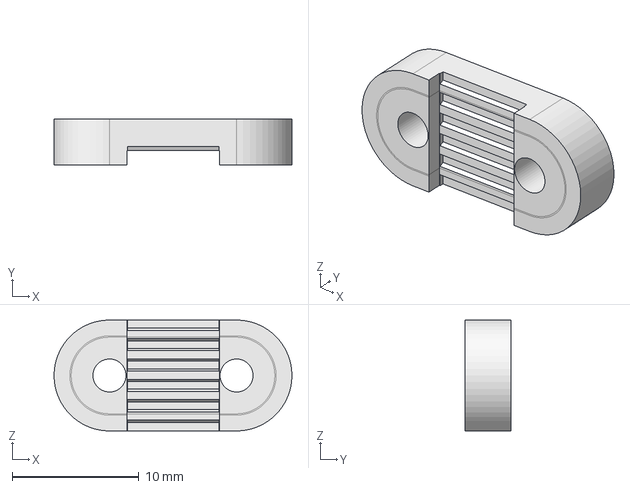
[picture p92: CAD file, 2018-04-12]
production_parts/printed_parts/z_belt_clamp/z_belt_clamp_v1.3.fcstd
18.8 x 3.65 x 8.74 mm
