reprapperMC/mini-hibiscus/production_parts/printed_parts/Z_brake_mount/z_brake_mount.fcstd

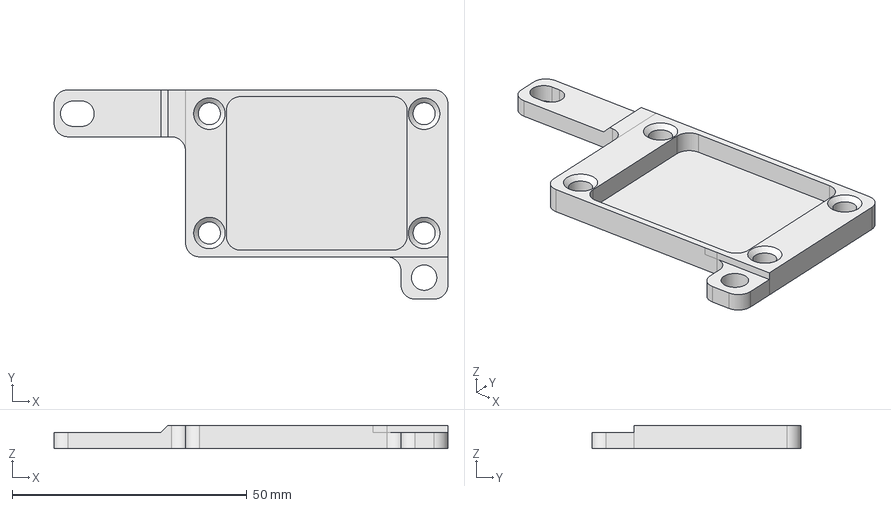
[picture p93: CAD file, 2018-01-16]
production_parts/printed_parts/Z_brake_mount/z_brake_mount.fcstd
83.9 x 44.6 x 5.00 mm
