reprapperMC/mini-hibiscus/production_parts/printed_parts/z_lower_left_mini2/ATTIC/z_lower_left_adjustable.stl

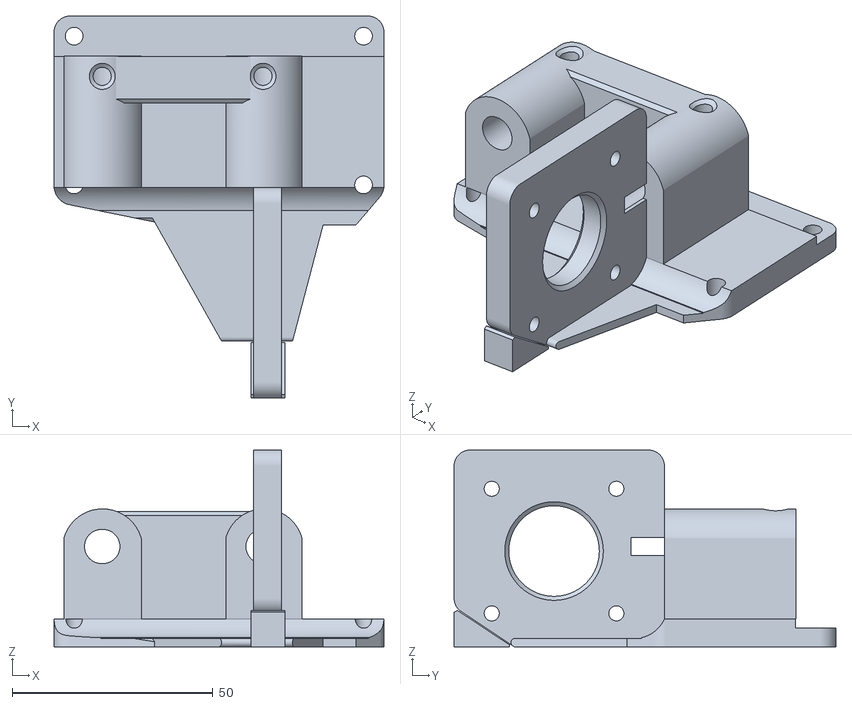
[picture p94: CAD file, 2018-04-02]
production_parts/printed_parts/z_lower_left_mini2/ATTIC/z_lower_left_adjustable.stl
82.1 x 95.0 x 49.0
