reprapperMC/mini-hibiscus/production_parts/printed_parts/z_upper_left_mini2/ATTIC/z_upper_left_mini2_v1.fcstd

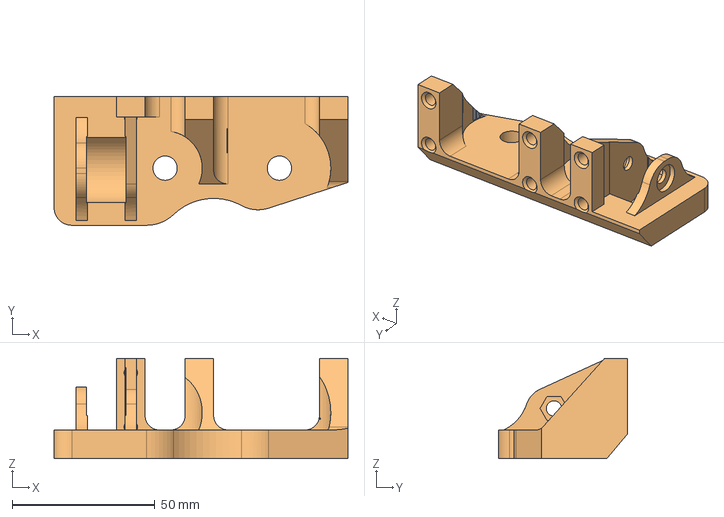
[picture p95: CAD file, 2017-12-06]
production_parts/printed_parts/z_upper_left_mini2/ATTIC/z_upper_left_mini2_v1.fcstd
102.9 x 45.0 x 35.0 mm
