reprapperMC/mini-hibiscus/production_parts/printed_parts/z_upper_left_mini2/Z-Upper_Left_Mini2_v1.4.fcstd

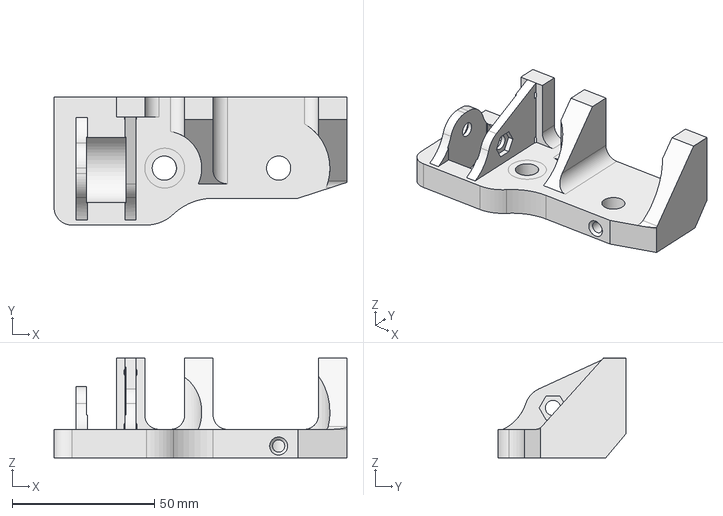
[picture p96: CAD file, 2018-04-23]
production_parts/printed_parts/z_upper_left_mini2/Z-Upper_Left_Mini2_v1.4.fcstd
102.9 x 45.0 x 35.0 mm
