reprapperMC/mini-hibiscus/production_parts/printed_parts/z_upper_right_mini2/ATTIC/z_upper_right_mini2_v1.fcstd

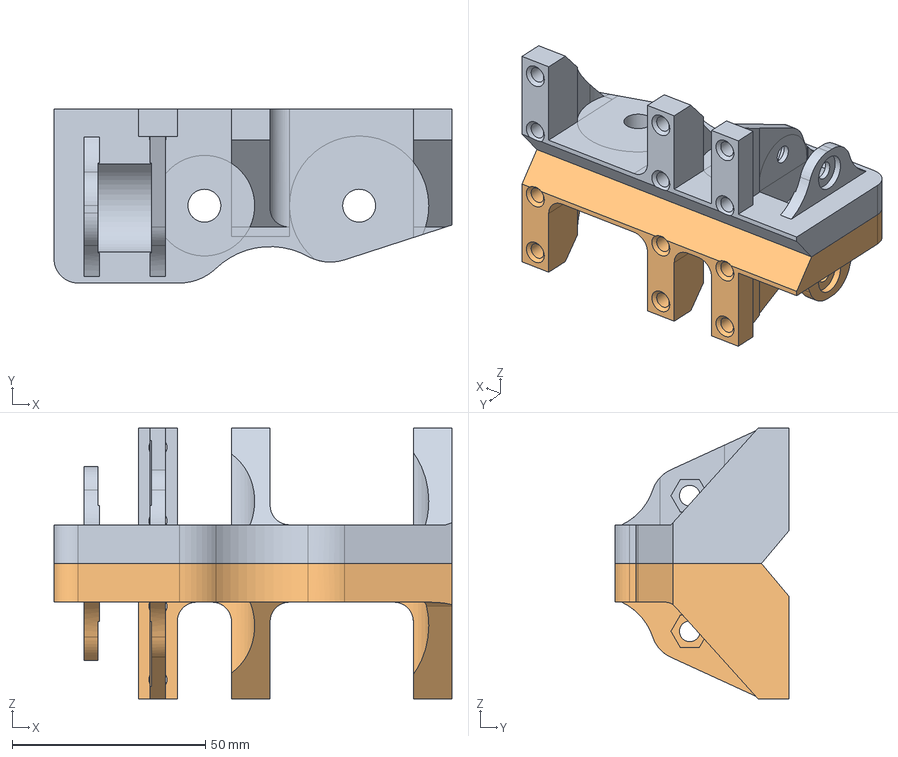
[picture p97: CAD file, 2017-12-06]
production_parts/printed_parts/z_upper_right_mini2/ATTIC/z_upper_right_mini2_v1.fcstd
102.9 x 45.0 x 70.0 mm
Fillet001 (Mirror #1)
