reprapperMC/mini-hibiscus/production_parts/assemblies/assembly_parts/50mm_blower.fcstd

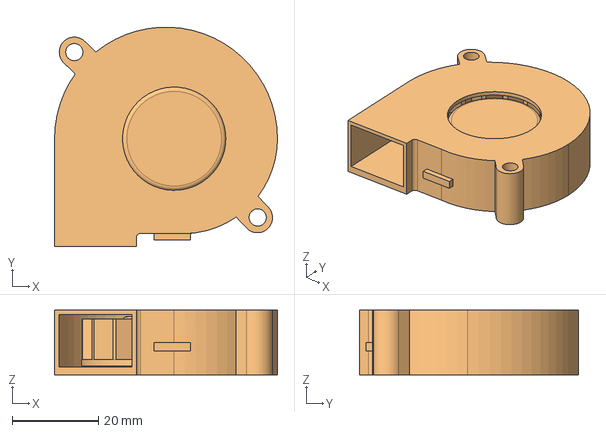
[picture p99: CAD file, 2018-03-21]
production_parts/assemblies/assembly_parts/50mm_blower.fcstd
51.8 x 51.0 x 15.0 mm
