reprapperMC/mini-hibiscus/production_parts/assemblies/assembly_subs/PEM/pem_case.fcstd

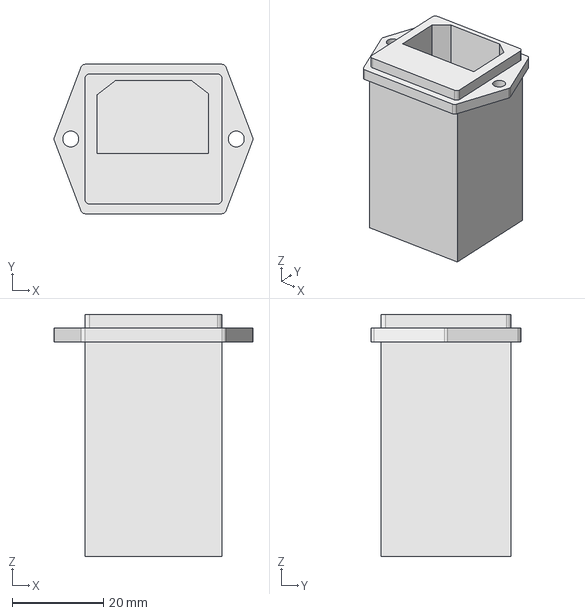
[picture p100: CAD file, 2018-02-07]
production_parts/assemblies/assembly_subs/PEM/pem_case.fcstd
43.6 x 32.8 x 53.0 mm
