reprapperMC/mini-hibiscus/production_parts/assemblies/assembly_subs/RAMBO/USB.fcstd

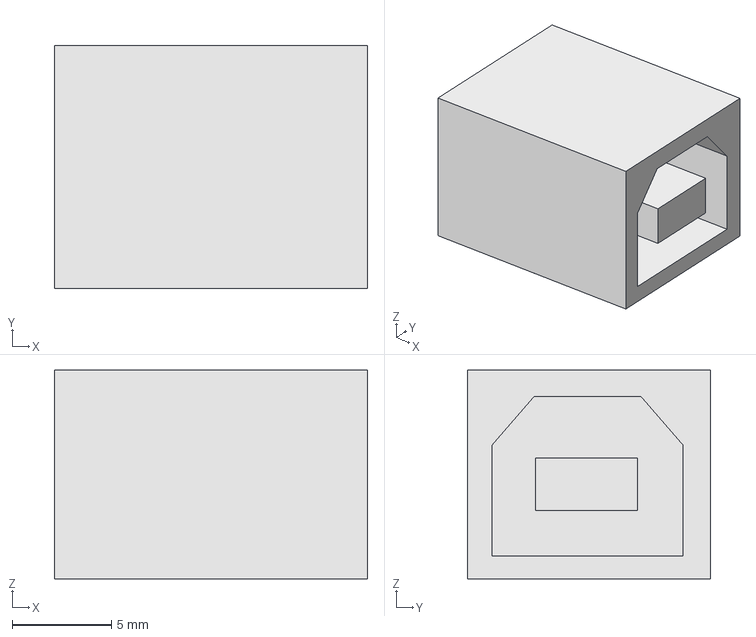
[picture p101: CAD file, 2018-02-07]
production_parts/assemblies/assembly_subs/RAMBO/USB.fcstd
15.8 x 12.2 x 10.5 mm
