reprapperMC/mini-hibiscus/production_parts/assemblies/assembly_subs/x_carriage.fcstd

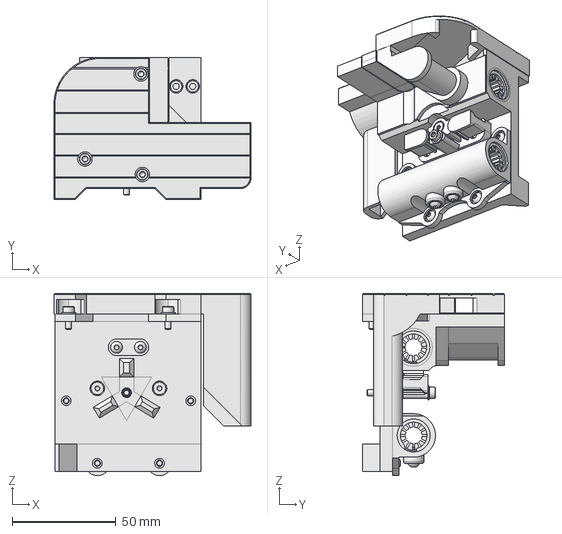
[picture p102: CAD file, 2018-02-09]
production_parts/assemblies/assembly_subs/x_carriage.fcstd
95.0 x 68.6 x 87.9 mm
