reprapperMC/mini-hibiscus/production_parts/assemblies/inserts_assemblies/x_end_idler_inserts.fcstd

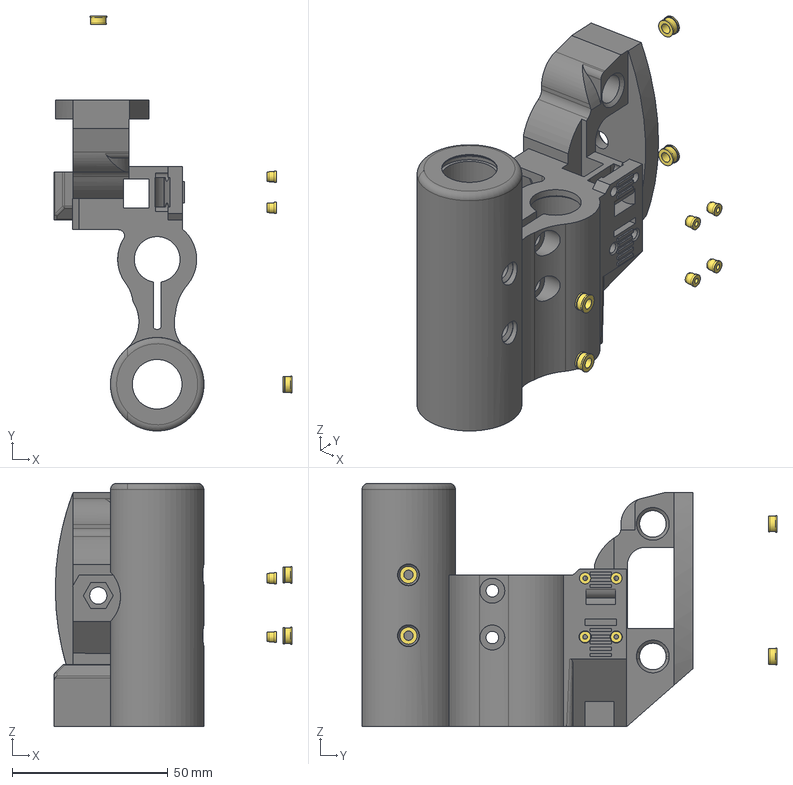
[picture p103: CAD file, 2018-04-23]
production_parts/assemblies/inserts_assemblies/x_end_idler_inserts.fcstd
76.2 x 133.0 x 78.0 mm
X_end_idler_mini2_v2_8_2_01
M3_insert_01
M3_insert_02
M3_insert_03
M3_insert_04
M2_insert_01
M2_insert_02
M2_insert_03
M2_insert_04
