reprapperMC/mini-hibiscus/production_parts/assemblies/LCD_Assembly/8mm_spacer.fcstd

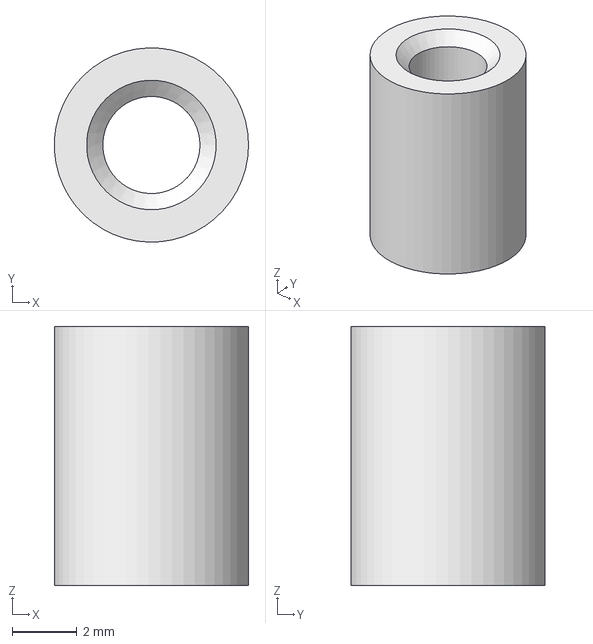
[picture p104: CAD file, 2018-01-29]
production_parts/assemblies/LCD_Assembly/8mm_spacer.fcstd
5.99 x 6.00 x 8.00 mm
