reprapperMC/mini-hibiscus/production_parts/jigs/CertStickerPlacement.fcstd

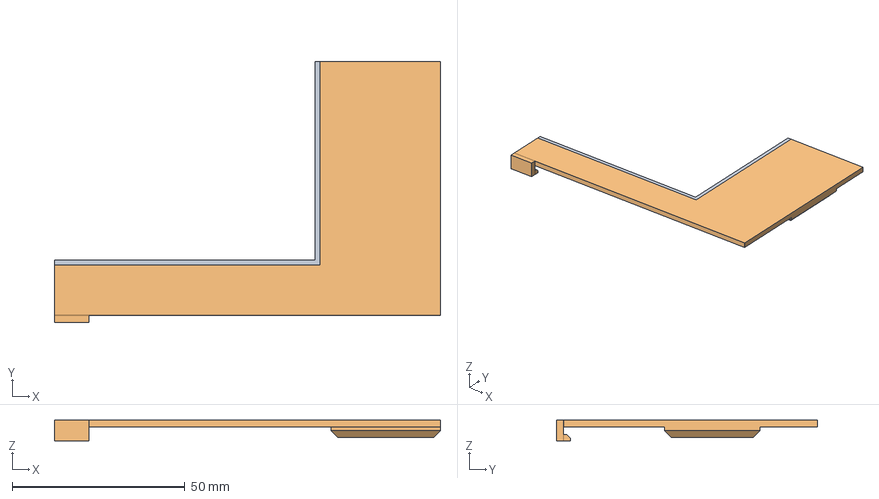
[picture p105: CAD file, 2018-04-05]
production_parts/jigs/CertStickerPlacement.fcstd
111.8 x 75.5 x 6.00 mm
