reprapperMC/mini-hibiscus/production_parts/jigs/fixtures/double-bearing-holder_reaming/reaming_top_double-bearing-holder.fcstd

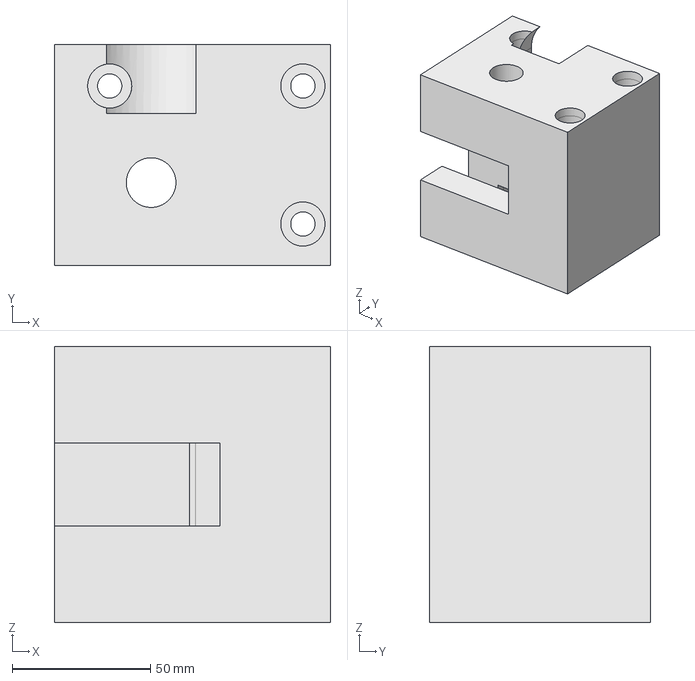
[picture p106: CAD file, 2018-01-10]
production_parts/jigs/fixtures/double-bearing-holder_reaming/reaming_top_double-bearing-holder.fcstd
100.0 x 80.0 x 100.0 mm
