reprapperMC/mini-hibiscus/production_parts/jigs/fixtures/x_carriage_reaming/reaming_top_x_carriage.fcstd

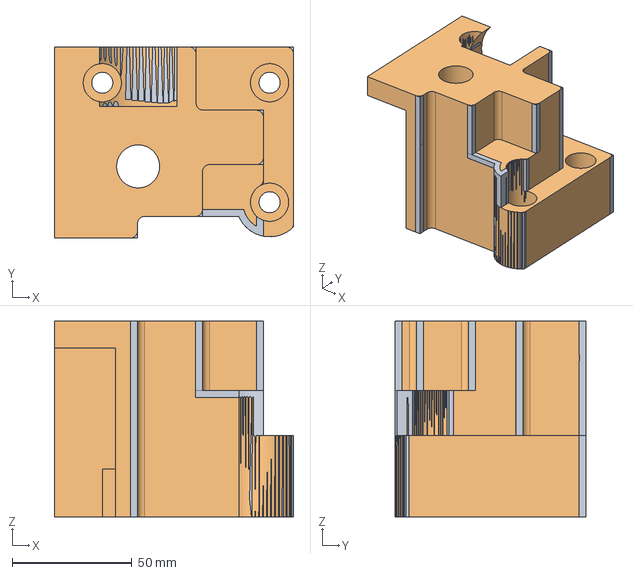
[picture p107: CAD file, 2018-03-16]
production_parts/jigs/fixtures/x_carriage_reaming/reaming_top_x_carriage.fcstd
100.0 x 80.0 x 82.0 mm
