reprapperMC/mini-hibiscus/production_parts/jigs/fixtures/x_end_idler_reaming/reaming_top_x_end_idler.fcstd

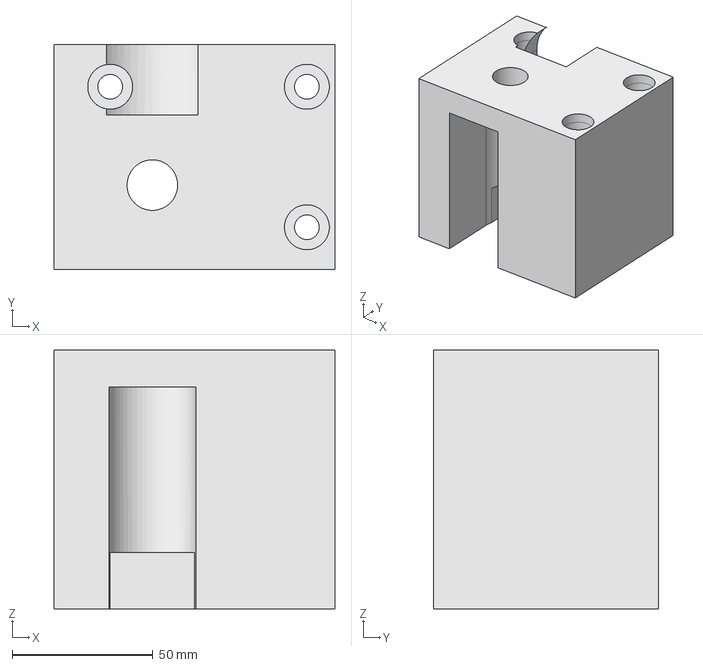
[picture p108: CAD file, 2018-01-10]
production_parts/jigs/fixtures/x_end_idler_reaming/reaming_top_x_end_idler.fcstd
100.0 x 80.0 x 92.0 mm
