reprapperMC/mini-hibiscus/production_parts/jigs/gauge/z-top_gauge.fcstd

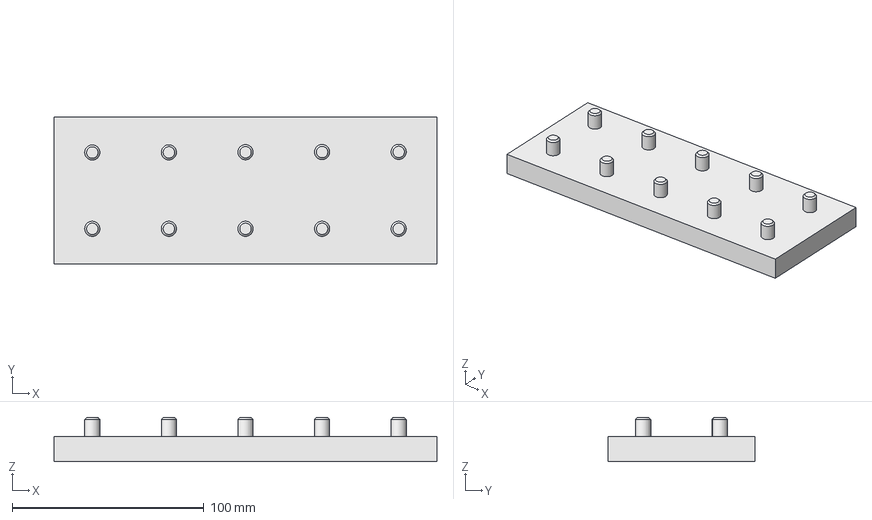
[picture p109: CAD file, 2018-04-12]
production_parts/jigs/gauge/z-top_gauge.fcstd
200.0 x 77.0 x 23.0 mm
