reprapperMC/mini-hibiscus/production_parts/printed_parts/double-bearing-holder/ATTIC/double-bearing-holder_black_v1.8.step

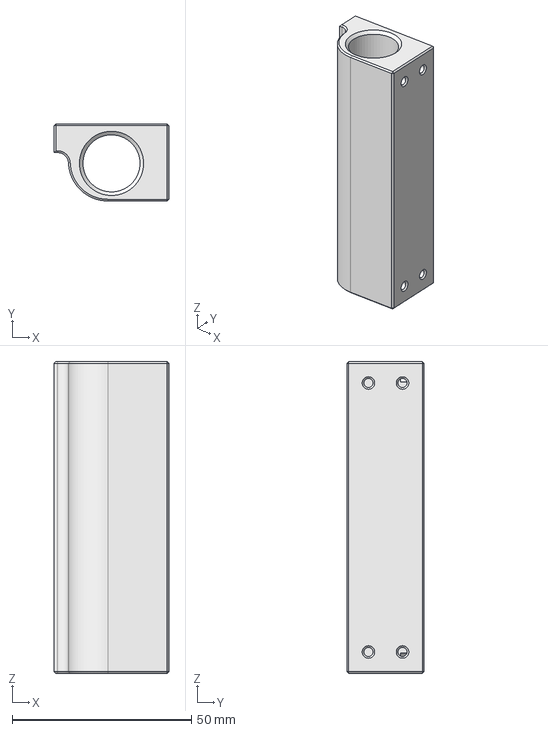
[picture p110: CAD file, 2017-12-19]
production_parts/printed_parts/double-bearing-holder/ATTIC/double-bearing-holder_black_v1.8.step
32.0 x 21.5 x 87.0 mm
