reprapperMC/mini-hibiscus/production_parts/printed_parts/extruder_mount/ATTIC/extruder_mount_v2.stl

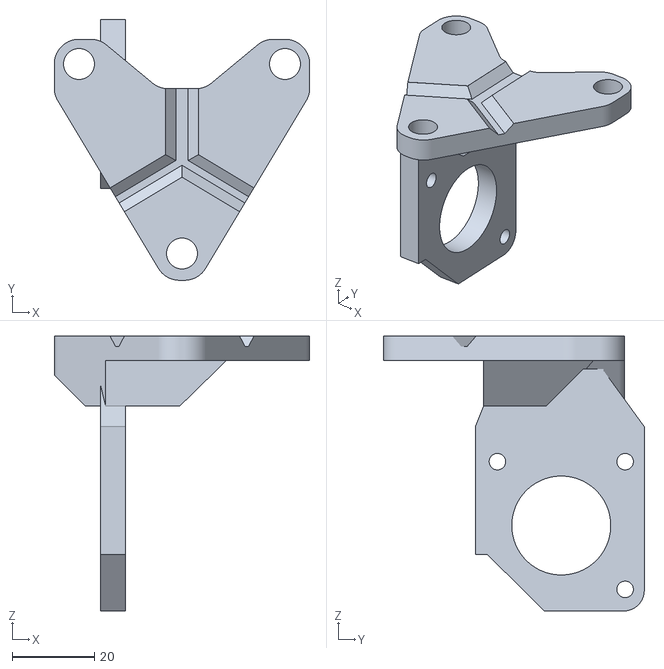
[picture p111: CAD file, 2017-11-29]
production_parts/printed_parts/extruder_mount/ATTIC/extruder_mount_v2.stl
62.0 x 63.2 x 66.8
