reprapperMC/mini-hibiscus/production_parts/printed_parts/LCD_Printed_parts/lcd_spacer/lcd_spacer_v0.4-x200.stl

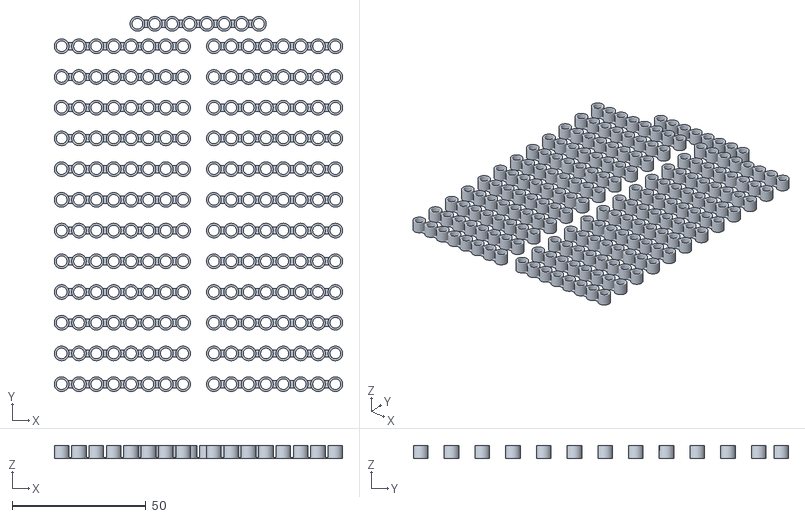
[picture p112: CAD file, 2018-01-29]
production_parts/printed_parts/LCD_Printed_parts/lcd_spacer/lcd_spacer_v0.4-x200.stl
108.0 x 140.4 x 4.75
