reprapperMC/mini-hibiscus/production_parts/printed_parts/spool_arm_support/spool_mount_a_v1.5.fcstd

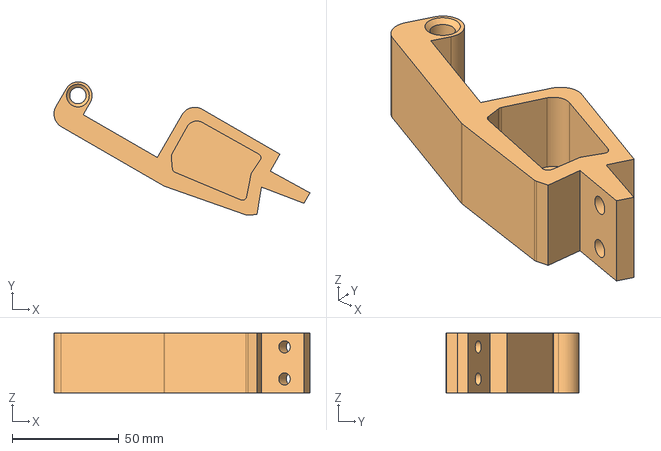
[picture p113: CAD file, 2018-01-18]
production_parts/printed_parts/spool_arm_support/spool_mount_a_v1.5.fcstd
119.7 x 62.4 x 27.9 mm
