reprapperMC/mini-hibiscus/production_parts/printed_parts/wiper_mount/wiper_mount_x3.stl

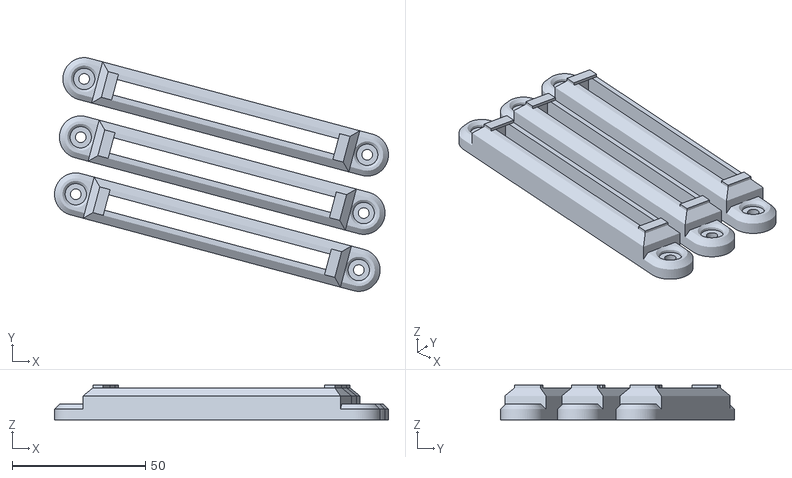
[picture p114: CAD file, 2017-09-28]
production_parts/printed_parts/wiper_mount/wiper_mount_x3.stl
125.4 x 87.8 x 13.0
