reprapperMC/mini-hibiscus/production_parts/printed_parts/x_belt_tensioner/minii_belt_mount.fcstd

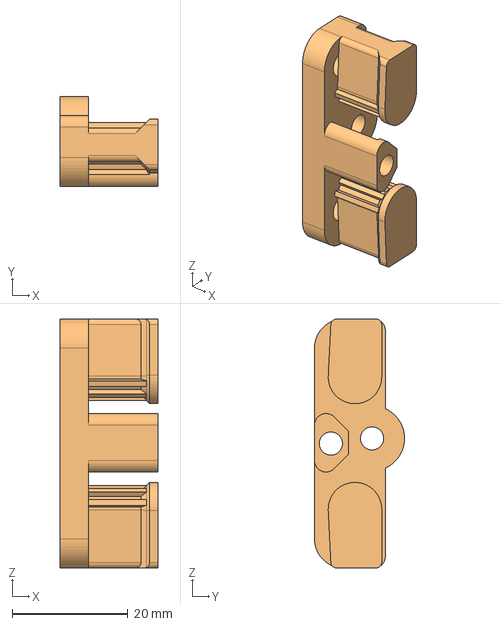
[picture p115: CAD file, 2018-01-23]
production_parts/printed_parts/x_belt_tensioner/minii_belt_mount.fcstd
17.0 x 15.6 x 43.0 mm
