reprapperMC/mini-hibiscus/production_parts/printed_parts/x_carriage_mini2/ATTIC/x_carriage_mini2_v4.3.1.stl

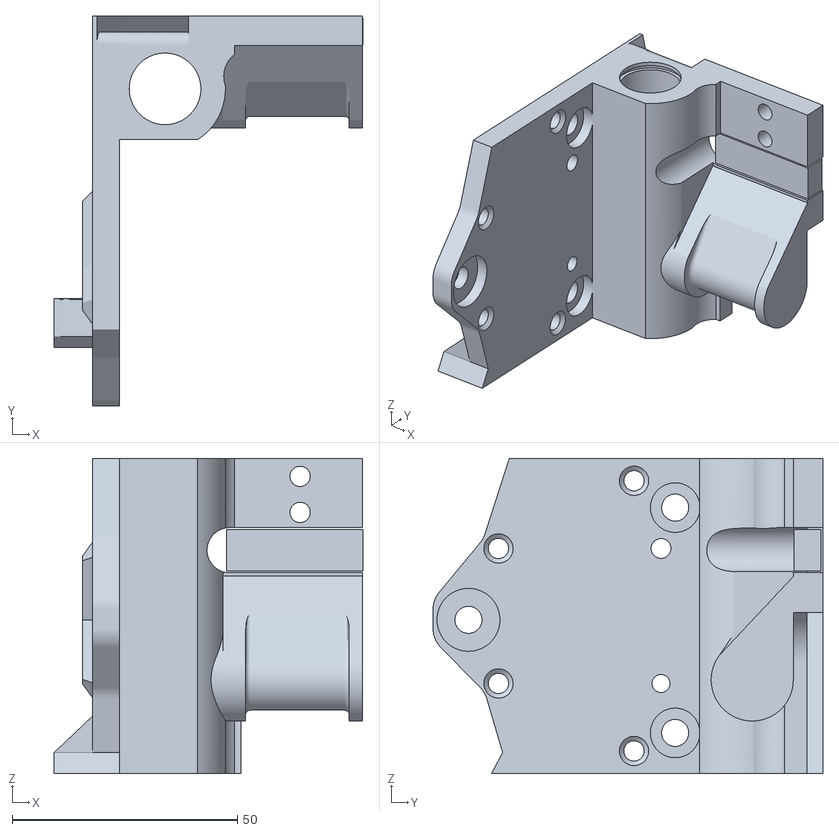
[picture p116: CAD file, 2018-01-02]
production_parts/printed_parts/x_carriage_mini2/ATTIC/x_carriage_mini2_v4.3.1.stl
68.5 x 86.6 x 70.0
