reprapperMC/mini-hibiscus/production_parts/assemblies/assembly_parts/PS.fcstd

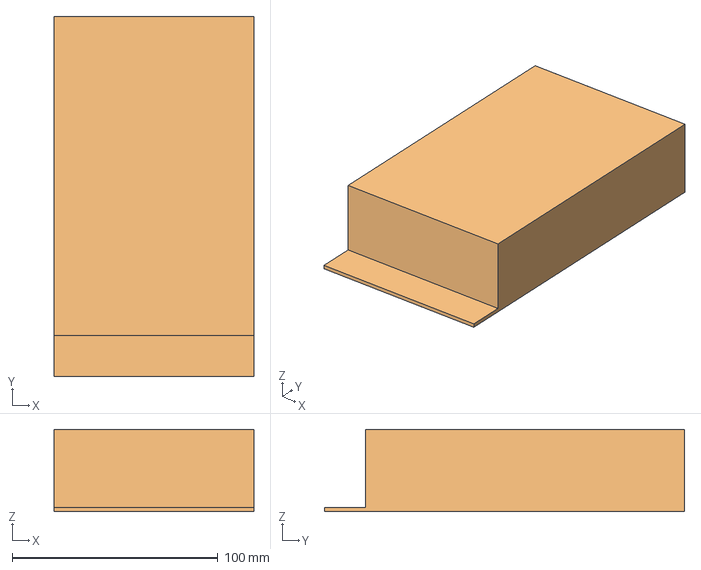
[picture p118: CAD file, 2018-02-08]
production_parts/assemblies/assembly_parts/PS.fcstd
97.0 x 175.0 x 40.0 mm
