reprapperMC/mini-hibiscus/production_parts/assemblies/assembly_subs/PEM/PEM_assem.fcstd

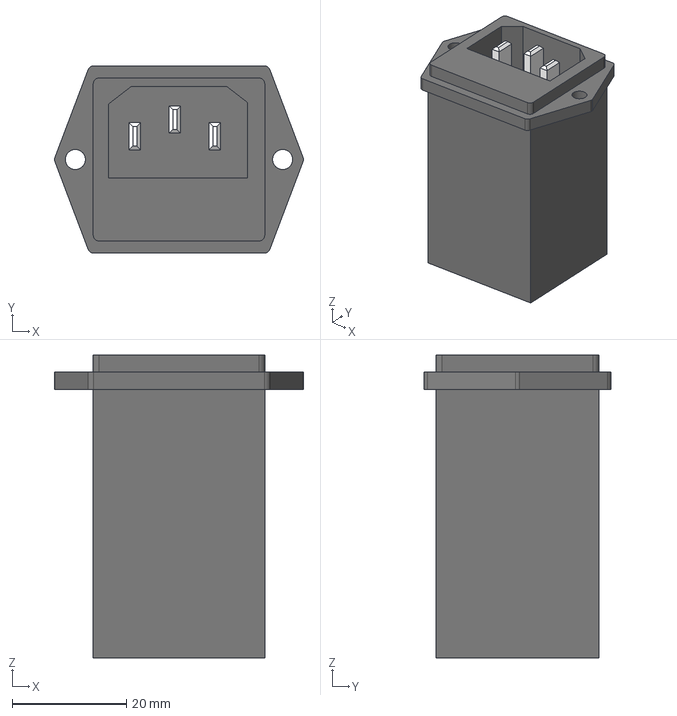
[picture p119: CAD file, 2018-02-07]
production_parts/assemblies/assembly_subs/PEM/PEM_assem.fcstd
43.6 x 32.8 x 53.0 mm
pem_case_01
pem_pins_01
