reprapperMC/mini-hibiscus/production_parts/assemblies/assembly_subs/RAMBO/EInsy_assem.fcstd

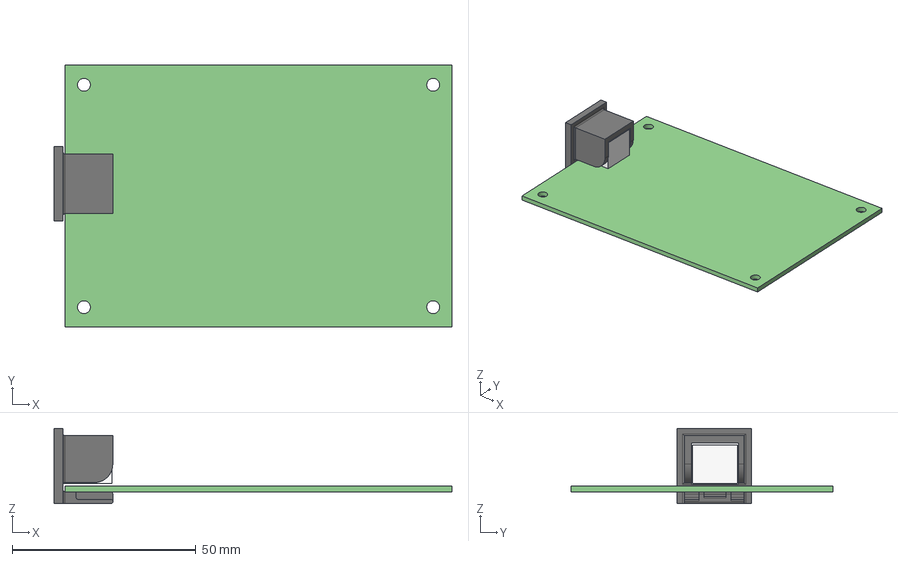
[picture p120: CAD file, 2018-02-07]
production_parts/assemblies/assembly_subs/RAMBO/EInsy_assem.fcstd
108.3 x 71.2 x 20.5 mm
PCB_01
USB_01
usb_support_mini_v1_0_step1_01
