reprapperMC/mini-hibiscus/production_parts/assemblies/assembly_subs/z_chain_assem.fcstd

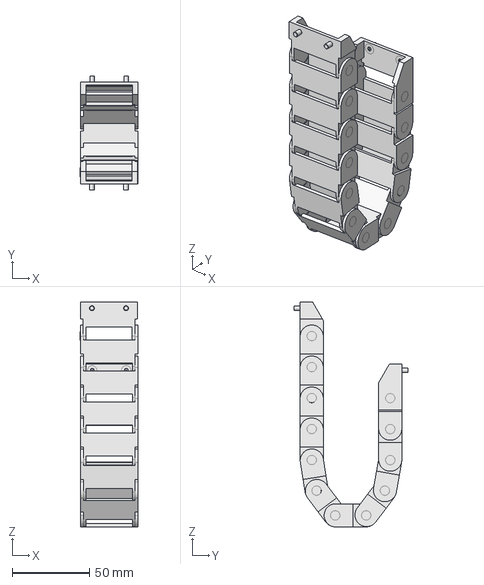
[picture p121: CAD file, 2018-02-08]
production_parts/assemblies/assembly_subs/z_chain_assem.fcstd
37.3 x 73.7 x 145.2 mm
