reprapperMC/mini-hibiscus/production_parts/assemblies/inserts_assemblies/z_lower_left_inserts.fcstd

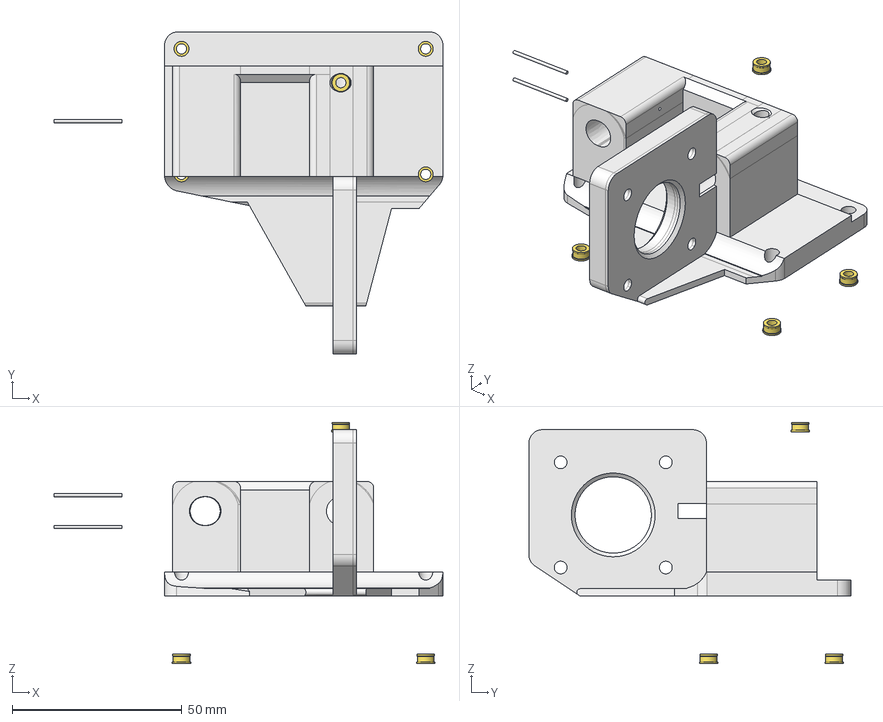
[picture p122: CAD file, 2018-04-23]
production_parts/assemblies/inserts_assemblies/z_lower_left_inserts.fcstd
114.7 x 95.0 x 71.2 mm
z_lower_left_step1_01
_mmx20mm_dowel_pin_01
_mmx20mm_dowel_pin_02
M3_insert_01
M3_insert_02
M3_insert_03
M3_insert_04
M3_insert_05
