reprapperMC/mini-hibiscus/production_parts/assemblies/LCD_Assembly/LCD_spacer.fcstd

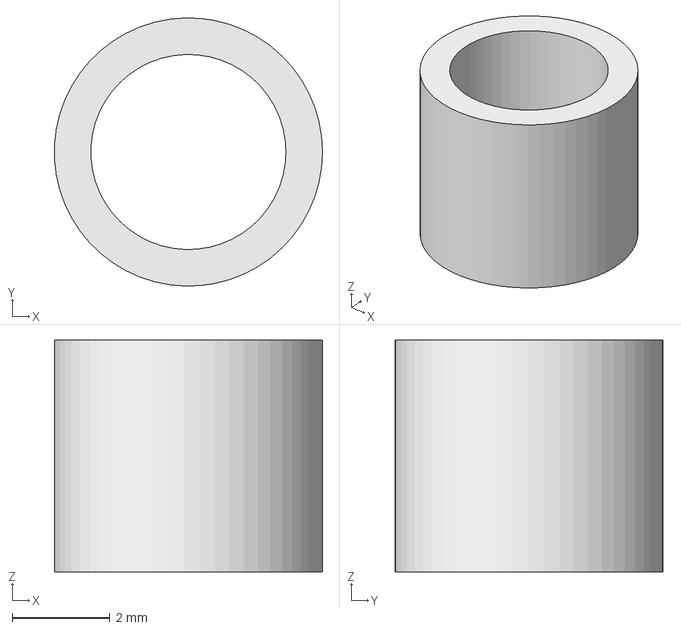
[picture p123: CAD file, 2018-01-29]
production_parts/assemblies/LCD_Assembly/LCD_spacer.fcstd
5.50 x 5.50 x 4.75 mm
