reprapperMC/mini-hibiscus/production_parts/jigs/X-Idler_BearingHelper.fcstd

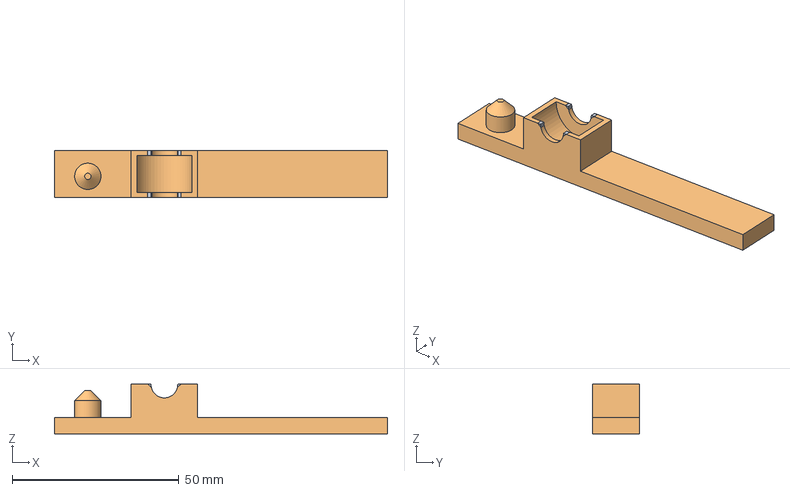
[picture p124: CAD file, 2018-04-03]
production_parts/jigs/X-Idler_BearingHelper.fcstd
100.0 x 14.0 x 15.0 mm
