reprapperMC/mini-hibiscus/Production_parts/printed_parts/extruder_mount/extruder_mount.fcstd

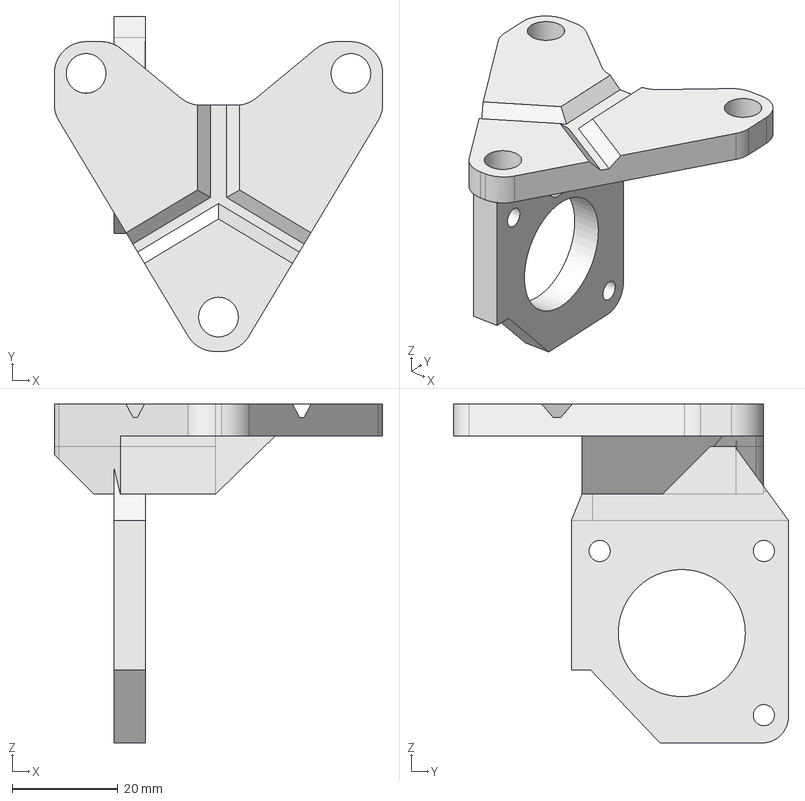
[picture p125: CAD file, 2017-09-12]
Production_parts/printed_parts/extruder_mount/extruder_mount.fcstd
62.0 x 63.2 x 64.0 mm
