reprapperMC/mini-hibiscus/production_parts/printed_parts/LCD_Printed_parts/lcd_spacer/lcd_spacer_v0.4-x64.stl

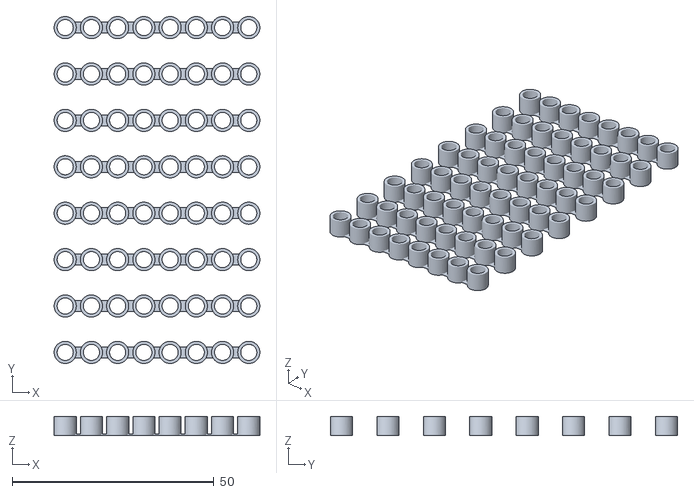
[picture p126: CAD file, 2018-01-29]
production_parts/printed_parts/LCD_Printed_parts/lcd_spacer/lcd_spacer_v0.4-x64.stl
51.0 x 86.0 x 4.75
