reprapperMC/mini-hibiscus/production_parts/printed_parts/wiper_mount/wiper_mount_v1.step

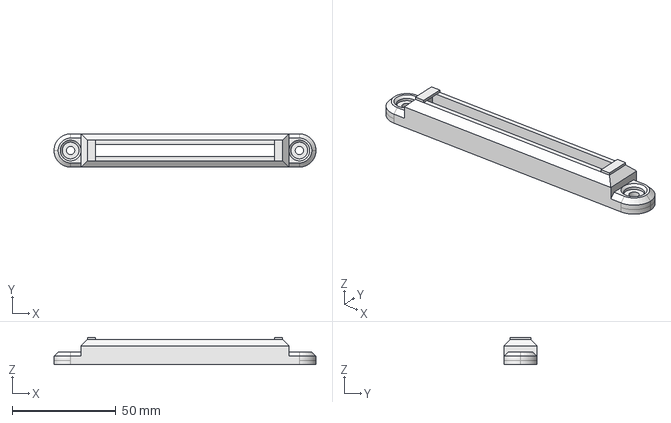
[picture p127: CAD file, 2017-09-28]
production_parts/printed_parts/wiper_mount/wiper_mount_v1.step
126.0 x 16.0 x 13.0 mm
