reprapperMC/mini-hibiscus/production_parts/printed_parts/x_belt_tensioner/ATTIC/x_belt_tensioner_v3.fcstd

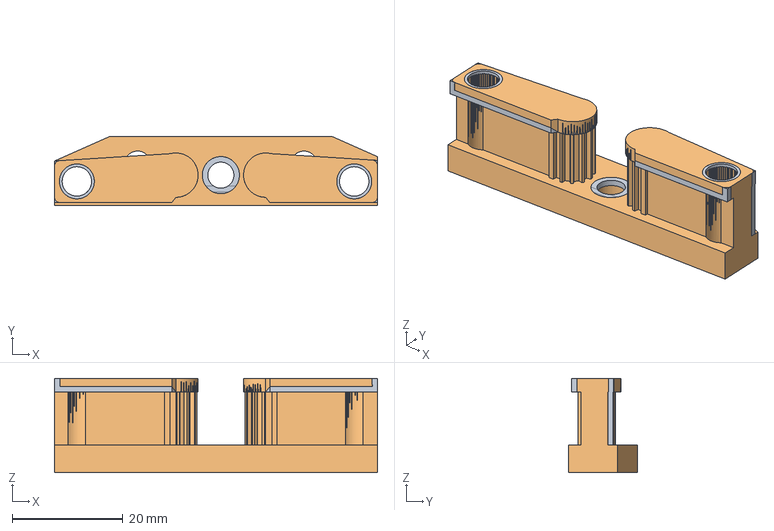
[picture p128: CAD file, 2018-01-08]
production_parts/printed_parts/x_belt_tensioner/ATTIC/x_belt_tensioner_v3.fcstd
58.3 x 12.5 x 17.0 mm
