reprapperMC/mini-hibiscus/production_parts/printed_parts/z_lower_left_mini2/ATTIC/z_lower_left_mini2_NG_v1.1.fcstd

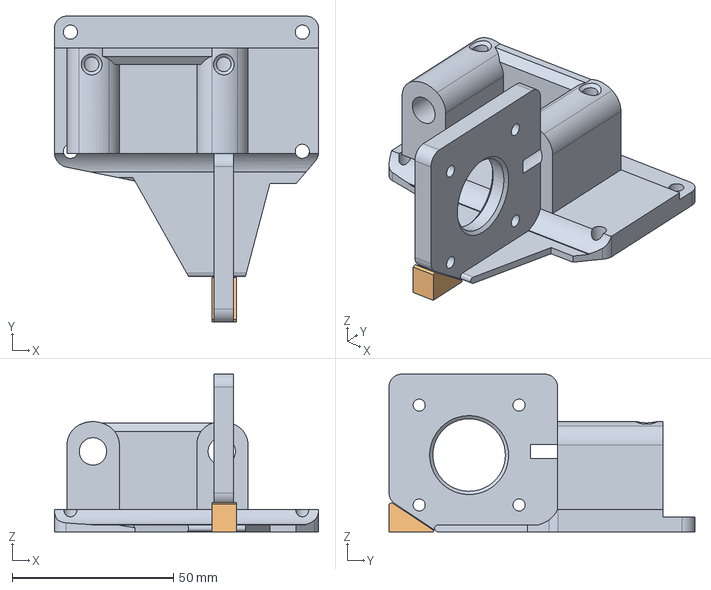
[picture p129: CAD file, 2017-12-06]
production_parts/printed_parts/z_lower_left_mini2/ATTIC/z_lower_left_mini2_NG_v1.1.fcstd
82.1 x 95.0 x 49.0 mm
