reprapperMC/mini-hibiscus/production_parts/assemblies/assembly_parts/z_brake_board.fcstd

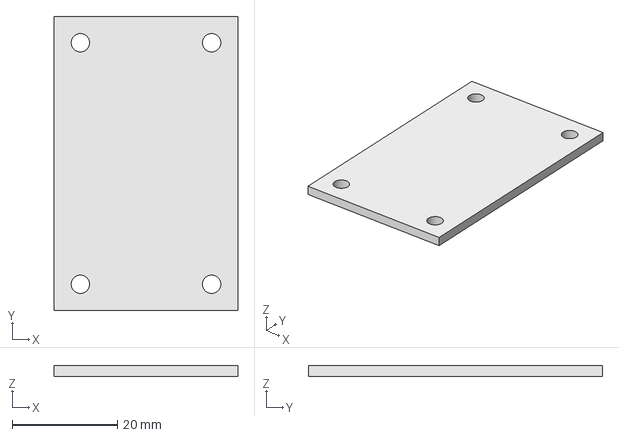
[picture p130: CAD file, 2018-02-08]
production_parts/assemblies/assembly_parts/z_brake_board.fcstd
35.0 x 56.0 x 2.00 mm
