reprapperMC/mini-hibiscus/production_parts/assemblies/assembly_subs/y_chain_assem.fcstd

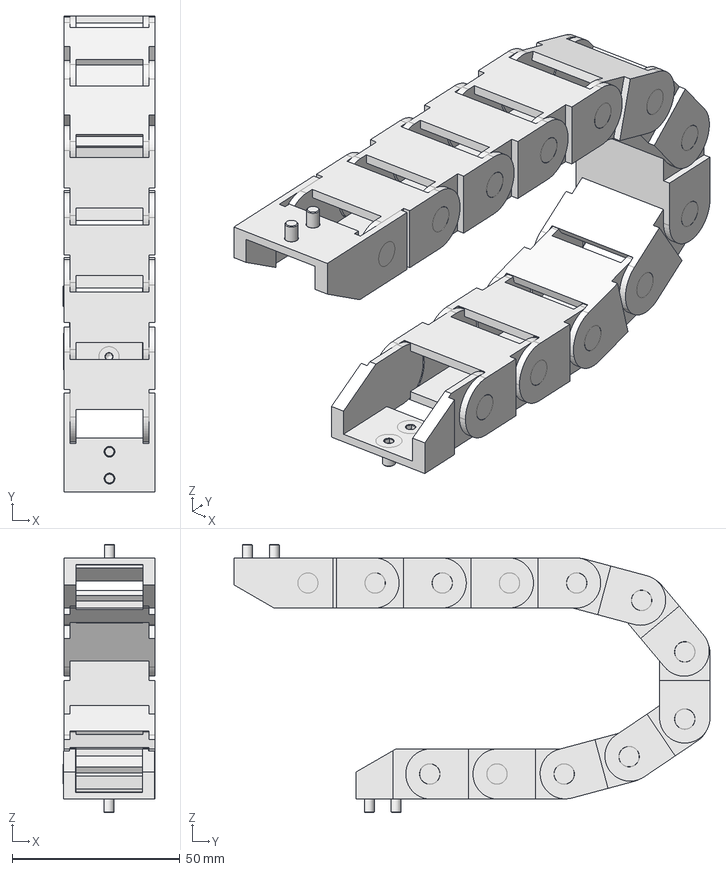
[picture p131: CAD file, 2018-02-08]
production_parts/assemblies/assembly_subs/y_chain_assem.fcstd
27.3 x 141.7 x 79.9 mm
