reprapperMC/mini-hibiscus/production_parts/assemblies/inserts_assemblies/z_lower_right_inserts.fcstd

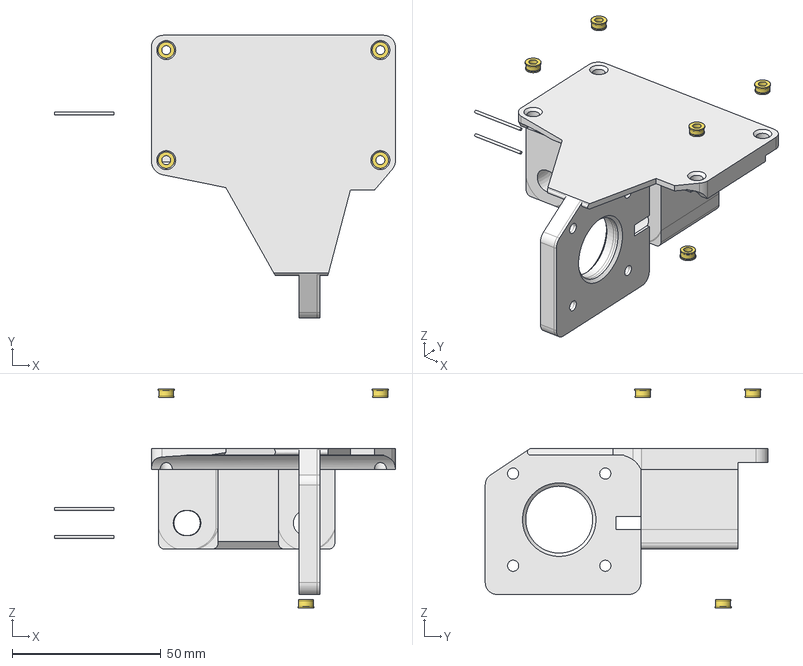
[picture p132: CAD file, 2018-04-23]
production_parts/assemblies/inserts_assemblies/z_lower_right_inserts.fcstd
114.7 x 95.0 x 73.5 mm
z_lower_right_step1_01
_mmx20mm_dowel_pin_01
_mmx20mm_dowel_pin_02
M3_insert_01
M3_insert_02
M3_insert_03
M3_insert_04
M3_insert_05
