reprapperMC/mini-hibiscus/production_parts/assemblies/LCD_Assembly/M3_insert.fcstd

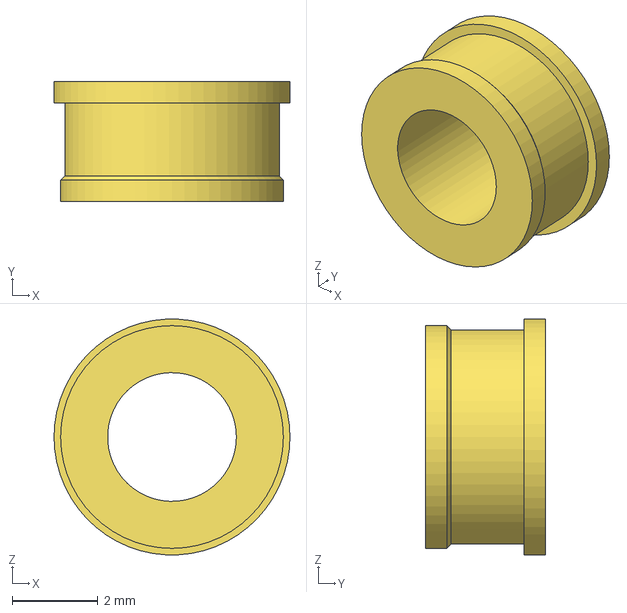
[picture p133: CAD file, 2018-01-29]
production_parts/assemblies/LCD_Assembly/M3_insert.fcstd
5.50 x 2.80 x 5.49 mm
