reprapperMC/mini-hibiscus/production_parts/jigs/v2Aero_PinionGear-Spacer.stl

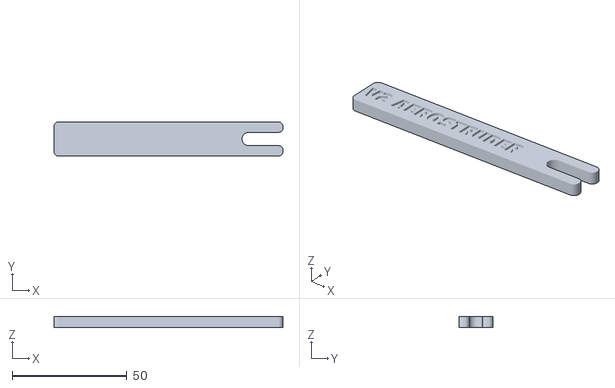
[picture p134: CAD file, 2018-03-23]
production_parts/jigs/v2Aero_PinionGear-Spacer.stl
100.0 x 15.0 x 4.60
