reprapperMC/mini-hibiscus/production_parts/printed_parts/z_lower_left_mini2/ATTIC/z_lower_left_mini2_g10.fcstd

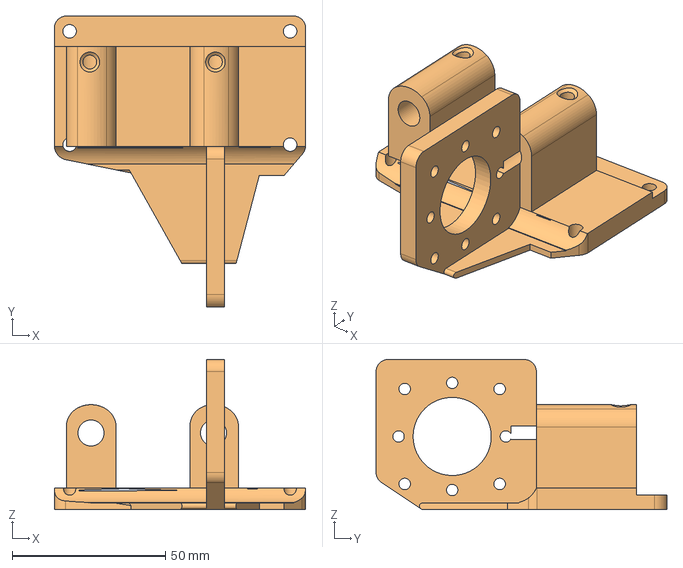
[picture p135: CAD file, 2017-11-28]
production_parts/printed_parts/z_lower_left_mini2/ATTIC/z_lower_left_mini2_g10.fcstd
82.1 x 95.0 x 49.0 mm
