reprapperMC/mini-hibiscus/production_parts/assemblies/assembly_parts/80MM_FAN.fcstd

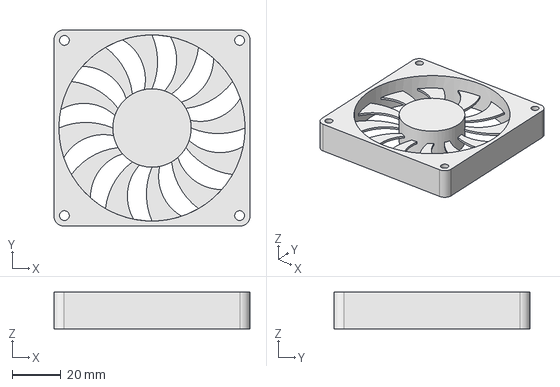
[picture p136: CAD file, 2018-02-08]
production_parts/assemblies/assembly_parts/80MM_FAN.fcstd
80.0 x 80.0 x 15.0 mm
