reprapperMC/mini-hibiscus/production_parts/assemblies/assembly_subs/spool_arm_assem.fcstd

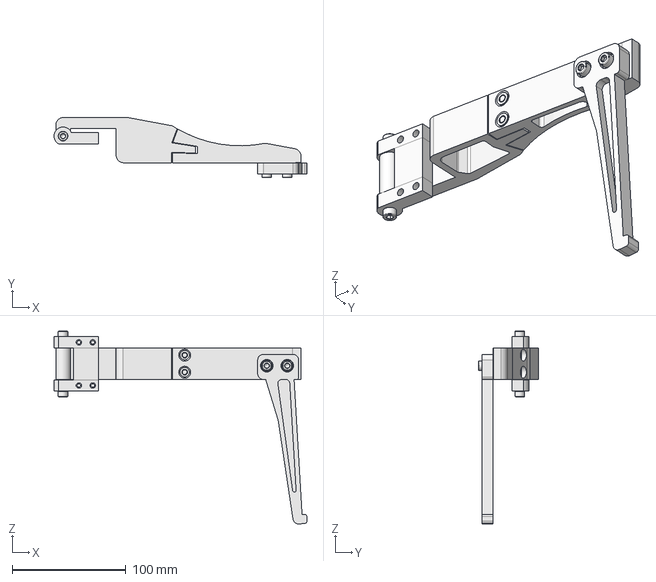
[picture p137: CAD file, 2018-02-08]
production_parts/assemblies/assembly_subs/spool_arm_assem.fcstd
222.6 x 53.1 x 169.7 mm
