reprapperMC/mini-hibiscus/production_parts/assemblies/inserts_assemblies/extruder_mount_inserts.fcstd

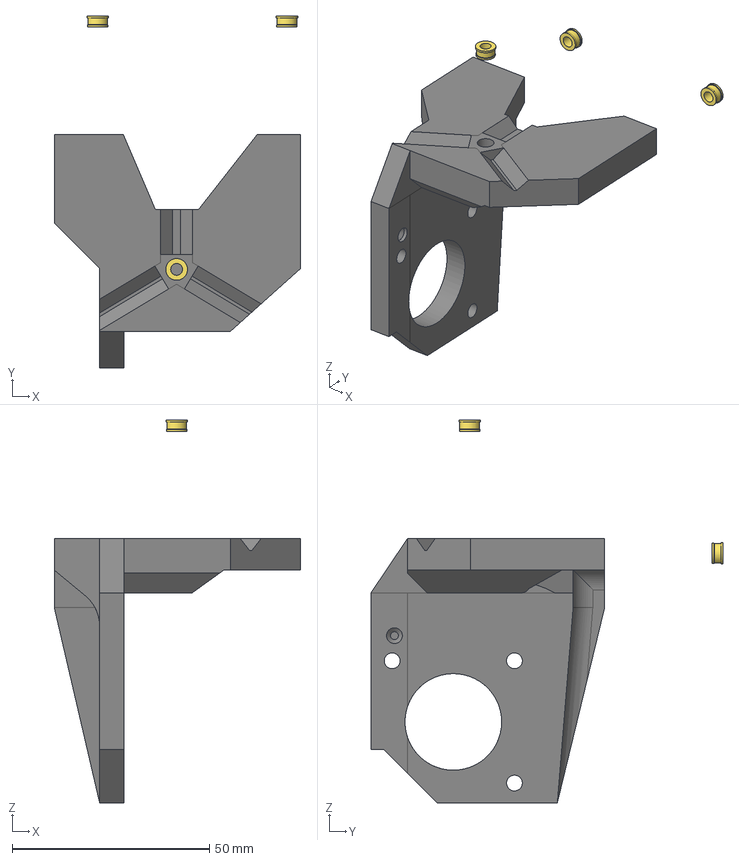
[picture p138: CAD file, 2018-04-23]
production_parts/assemblies/inserts_assemblies/extruder_mount_inserts.fcstd
62.5 x 89.2 x 97.0 mm
Beefy_extruder_mount_v2_01
M3_insert_01
M3_insert_02
M3_insert_03
