reprapperMC/mini-hibiscus/production_parts/assemblies/LCD_Assembly/LCD.fcstd

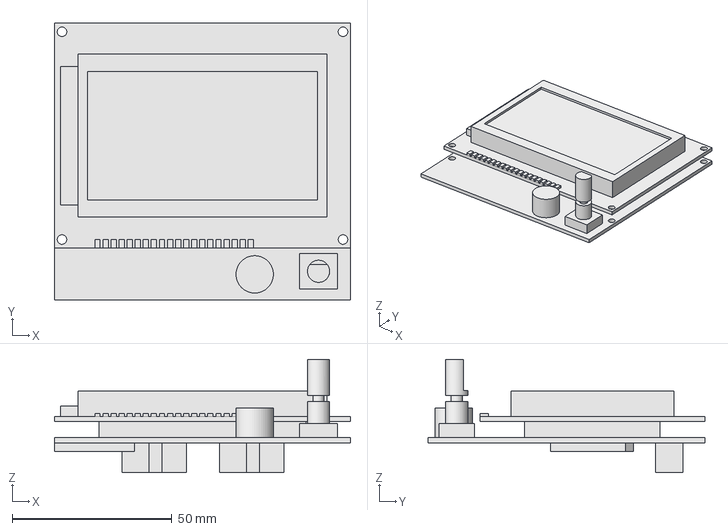
[picture p139: CAD file, 2018-01-29]
production_parts/assemblies/LCD_Assembly/LCD.fcstd
92.7 x 86.7 x 35.5 mm
