reprapperMC/mini-hibiscus/production_parts/jigs/ReamerHandler.stl

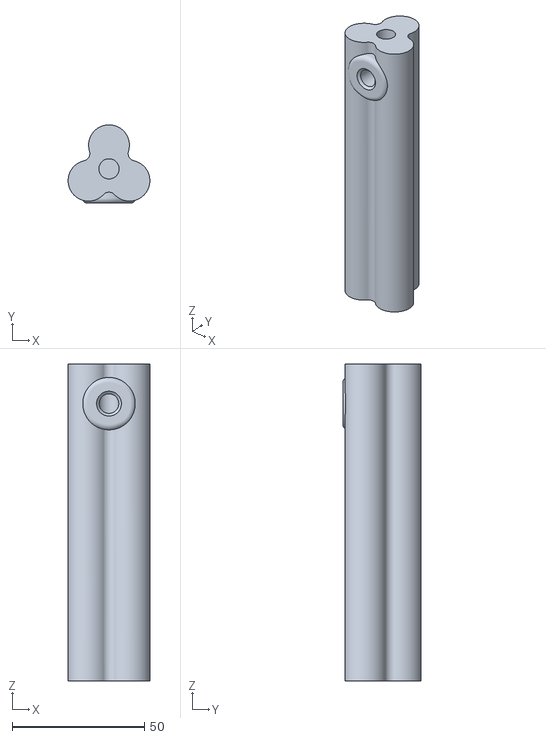
[picture p140: CAD file, 2018-03-22]
production_parts/jigs/ReamerHandler.stl
31.0 x 29.7 x 120.0
