reprapperMC/mini-hibiscus/production_parts/printed_parts/x_belt_tensioner/ATTIC/x_belt_tensioner_open_v3.stl

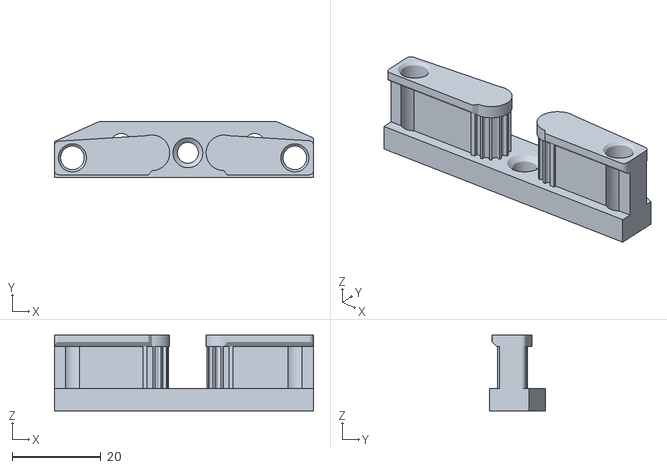
[picture p141: CAD file, 2018-01-08]
production_parts/printed_parts/x_belt_tensioner/ATTIC/x_belt_tensioner_open_v3.stl
58.3 x 12.5 x 17.0
