reprapperMC/mini-hibiscus/(list of files, cad)

Other CAD files:
production_parts/assemblies/assembly_subs/hibiscus_frame_assembled..step
production_parts/printed_parts/double-bearing-holder/double-bearing-holder_black_v1.8.2.fcstd
production_parts/printed_parts/x_end_motor_mini2/x_end_motor_v2.5.3_mini2.stl
production_parts/printed_parts/Y_rod_mount/Y_rod_mount_v2.fcstd
production_parts/printed_parts/z_lower_left_mini2/Z-Lower_Left_Mini2_v1.7.1.stl
production_parts/printed_parts/z_lower_right_mini2/ATTIC/z_lower_right_adjustable.stl
production_parts/printed_parts/z_lower_right_mini2/Z-Lower_Right_Mini2_v1.7.1.stl
production_parts/jigs/fixtures/reaming_modular_base/long_reaming_base_milled.fcstd
production_parts/printed_parts/belt_tensioning_collar/belt_tensioning_collar_v1.2.fcstd
production_parts/printed_parts/LCD_Printed_parts/Mini_lcd_case/Mini_LCD_case_v3.1.stl
production_parts/printed_parts/spool_arm_support/ATTIC/spool_mount_b.fcstd
production_parts/printed_parts/Z-End_Pairs/Right_Pair_v0.2.fcstd
production_parts/printed_parts/z_lower_left_mini2/ATTIC/z_lower_left_mini2_v1.5.stl
production_parts/printed_parts/z_lower_right_mini2/ATTIC/z_lower_right_mini2_v1.5.stl
production_parts/jigs/fixtures/reaming_modular_base/long_reaming_base_milled_path_pocket.fcstd
production_parts/printed_parts/wiper_mount/wiper_mount_v1.1.fcstd
production_parts/printed_parts/x_bearing_holder/ATTIC/x_bearing_holder_V3.6.step
production_parts/printed_parts/z_lower_right_mini2/ATTIC/z_lower_right_sNG_v1.2.stl
production_parts/printed_parts/x_end_idler_mini2/ATTIC/X_end_idler_mini2_v2.8.step
Production_parts/machined_parts/bed_leveling_washer/bed_leveling_washer_PP-MP0082_revA.step
production_parts/assemblies/assembly_fasteners/M2X10SHCS.fcstd
production_parts/assemblies/assembly_fasteners/M2X6SHCS.fcstd
production_parts/assemblies/assembly_fasteners/M2_washer.fcstd
production_parts/assemblies/assembly_fasteners/M3_washer.fcstd
production_parts/assemblies/assembly_fasteners/M3x10FHCS.fcstd
production_parts/assemblies/assembly_fasteners/M3x12BHCS.fcstd
production_parts/assemblies/assembly_fasteners/M3x12SHCS.fcstd
production_parts/assemblies/assembly_fasteners/M3x8BHCS.fcstd
production_parts/assemblies/assembly_fasteners/M5_shoulder_bolt.fcstd
production_parts/assemblies/assembly_fasteners/M5_washer.fcstd
production_parts/assemblies/assembly_fasteners/M8x40FHCS.fcstd
production_parts/assemblies/assembly_fasteners/m3_lock_washer.fcstd
production_parts/assemblies/assembly_fasteners/m3_nut.fcstd
production_parts/assemblies/assembly_fasteners/m3_nylock_nut.fcstd
production_parts/assemblies/assembly_fasteners/m3_setscrew.fcstd
production_parts/assemblies/assembly_fasteners/m3x16FHCS.fcstd
production_parts/assemblies/assembly_fasteners/m3x20BHCS.fcstd
production_parts/assemblies/assembly_fasteners/m3x20FHCS.fcstd
production_parts/assemblies/assembly_fasteners/m3x25FHCS.fcstd
production_parts/assemblies/assembly_fasteners/m3x30BHCS.fcstd
production_parts/assemblies/assembly_fasteners/m3x30SHCS.fcstd
production_parts/assemblies/assembly_fasteners/m3x35BHCS.fcstd
production_parts/assemblies/assembly_fasteners/m3x35SHCS.fcstd
production_parts/assemblies/assembly_fasteners/m3x6BHCS.fcstd
production_parts/assemblies/assembly_fasteners/m3x6FHCS.fcstd
production_parts/assemblies/assembly_fasteners/m3x8SHCS.fcstd
production_parts/assemblies/assembly_fasteners/m5_nut.fcstd
production_parts/assemblies/assembly_fasteners/m5_nylock_nut.fcstd
production_parts/assemblies/assembly_fasteners/m5x14shcs.fcstd
production_parts/assemblies/assembly_fasteners/m5x20shcs.fcstd
production_parts/assemblies/assembly_fasteners/m5x25_pan_head.fcstd
production_parts/assemblies/assembly_fasteners/m5x40FHCS.fcstd
production_parts/assemblies/assembly_parts/40mm_fan.fcstd
production_parts/assemblies/assembly_parts/40mm_fan.step
production_parts/assemblies/assembly_parts/608_bearing.fcstd
production_parts/assemblies/assembly_parts/608_bearing.step
production_parts/assemblies/assembly_parts/625_bearing.fcstd
production_parts/assemblies/assembly_parts/Idler_spacers.fcstd
production_parts/assemblies/assembly_parts/M2_insert.fcstd
production_parts/assemblies/assembly_parts/M5_insert.fcstd
production_parts/assemblies/assembly_parts/NEMA17.step
production_parts/assemblies/assembly_parts/NEMA17_half_size.fcstd
production_parts/assemblies/assembly_parts/RJM_01_08_1.stp
production_parts/assemblies/assembly_parts/idler_pulley_openbuilds.fcstd
production_parts/assemblies/assembly_parts/limit_switch.fcstd
production_parts/assemblies/assembly_parts/m8_nut.step
production_parts/assemblies/assembly_parts/m8_washer.step
production_parts/assemblies/assembly_parts/power_switch.fcstd
production_parts/assemblies/assembly_parts/pulley.fcstd
production_parts/assemblies/assembly_parts/schnoz_wad.fcstd
production_parts/assemblies/assembly_parts/x_belt.fcstd
production_parts/assemblies/assembly_parts/x_chain_end1.stp
production_parts/assemblies/assembly_parts/x_chain_end2.stp
production_parts/assemblies/assembly_parts/x_chain_link.stp
production_parts/assemblies/assembly_parts/y_belt.fcstd
production_parts/assemblies/assembly_parts/z_belt_l.fcstd
production_parts/assemblies/assembly_parts/z_belt_r.fcstd
production_parts/assemblies/assembly_parts/z_chain_end.stp
production_parts/assemblies/assembly_parts/z_chain_end2.stp
production_parts/assemblies/assembly_parts/z_chain_link.stp
production_parts/assemblies/assembly_subs/hibiscus_frame_assembled.fcstd
production_parts/assemblies/assembly_subs/hibiscus_y_axis.fcstd
production_parts/assemblies/assembly_subs/hibiscus_y_axis.step
production_parts/assemblies/assembly_subs/hibiscus_y_axis_guide.fcstd
production_parts/assemblies/assembly_subs/hibiscus_y_axis_guide.step
production_parts/assemblies/assembly_subs/x_chain_assem.fcstd
production_parts/assemblies/assembly_subs/x_gantry.fcstd
production_parts/assemblies/assembly_subs/z_axis_left.fcstd
production_parts/assemblies/assembly_subs/z_axis_right.fcstd
production_parts/assemblies/inserts_assemblies/LCD_bracket_inserts.fcstd
production_parts/assemblies/inserts_assemblies/LCD_case_inserts.fcstd
production_parts/assemblies/inserts_assemblies/LCD_side_cable_bracket_inserts.fcstd
production_parts/assemblies/inserts_assemblies/LCD_top_cable_bracket_inserts.fcstd
production_parts/assemblies/inserts_assemblies/belt_mount_inserts.fcstd
production_parts/assemblies/inserts_assemblies/blower_duct_inserts.fcstd
production_parts/assemblies/inserts_assemblies/double_bearing_holder_inserts_nonswitch_side.fcstd
production_parts/assemblies/inserts_assemblies/double_bearing_holder_inserts_switch_side.fcstd
production_parts/assemblies/inserts_assemblies/handle_bar_inserts.fcstd
production_parts/assemblies/inserts_assemblies/spool_arm_bracket_inserts.fcstd
production_parts/assemblies/inserts_assemblies/spool_mount_a_inserts.fcstd
production_parts/assemblies/inserts_assemblies/spool_mount_b_inserts.fcstd
production_parts/assemblies/inserts_assemblies/upper_strain_relief_inserts.fcstd
production_parts/assemblies/inserts_assemblies/x_bearing_holder_inserts.fcstd
production_parts/assemblies/inserts_assemblies/x_belt_tensioner_inserts.fcstd
production_parts/assemblies/inserts_assemblies/x_carriage_inserts.fcstd
production_parts/assemblies/inserts_assemblies/x_end_motor_inserts.fcstd
production_parts/assemblies/inserts_assemblies/y_axis_rod_mount_inserts.fcstd
production_parts/assemblies/inserts_assemblies/y_idler_inserts.fcstd
production_parts/assemblies/inserts_assemblies/z_brake_mount_inserts.fcstd
production_parts/assemblies/inserts_assemblies/z_upper_left_inserts.fcstd
production_parts/jigs/CertStickerPlacement.stl
production_parts/jigs/EL-HR0130_90mm_Spacer.fcstd
production_parts/jigs/EL-HR0130_90mm_Spacer.stl
production_parts/jigs/Hibiscus_tie-down_jig.fcstd
production_parts/jigs/Hibiscus_tie-down_jig.stl
production_parts/jigs/ReamerHandle.fcstd
production_parts/jigs/X-Idler_BearingHelper.stl
production_parts/jigs/X-MIN_WRAP_JIG.fcstd
production_parts/jigs/X-MIN_WRAP_JIG.stl
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
