reprapperMC/mini-hibiscus/production_parts/printed_parts/testing/polyflexy-bedcorner-testing.ods

Sample type | Original Measurement | Used Measurement 1 | Used Measurement 2 | Used Measurement 3 | Used Measurement 4 | Notes
Original Sample | 5.9 | 5.61 | 5.1 | 4.69 | 5
20%Infill | 6.07 | 5.61 | 5.25 | 5.43 | 4.98
50%Infill | 6.13 | 5.17 | 5.14 | 5.56 | 5.75
80%Infill | 6.06 | 5.23 | 5.05 | 5.33 | 5.15
80%+1Wall | 5.88 | 4.88 | 5.39 | 4.94 | 5.03 | Slippage when Forced; no axis shift; tested from 1/19 – 3/06
80%+2Walls | 5.89 | 5.06 | 4.86 | 5.09 | 5.58 | Little slip when forced; no axis shift; tested from 1/19 – 3/06
80%+3Walls | 5.93 | 5.33 | 5.29 | 5.2 | 5.14 | Almost no Slip; No axis shifts; tested from 1/19 – 3/06
4.50-4.99mm |  |  |  |  |  | Determination: My Measurements do not show a patterned retention of the deformation, I did feel a difference when it comes to the mobility of the glass, 80% infill with 3 walls seems to move less so if slicing for production I would recommend using those settings. **BIG NOTE!! THERE WAS A NOTABLE INCREASE IN MATERIAL CONSISTENCY AND PRINT QUALITY CONSISTENCY!!** (increase of skin overlap % recommended, some wall separation)
5.00-5.25mm
5.26-5.50mm
5.51-5.99mm
+6.00mm
