reprapperMC/mini-hibiscus/production_parts/assemblies/inserts_assemblies/double_bearing_holder_inserts_switch_side.pdf

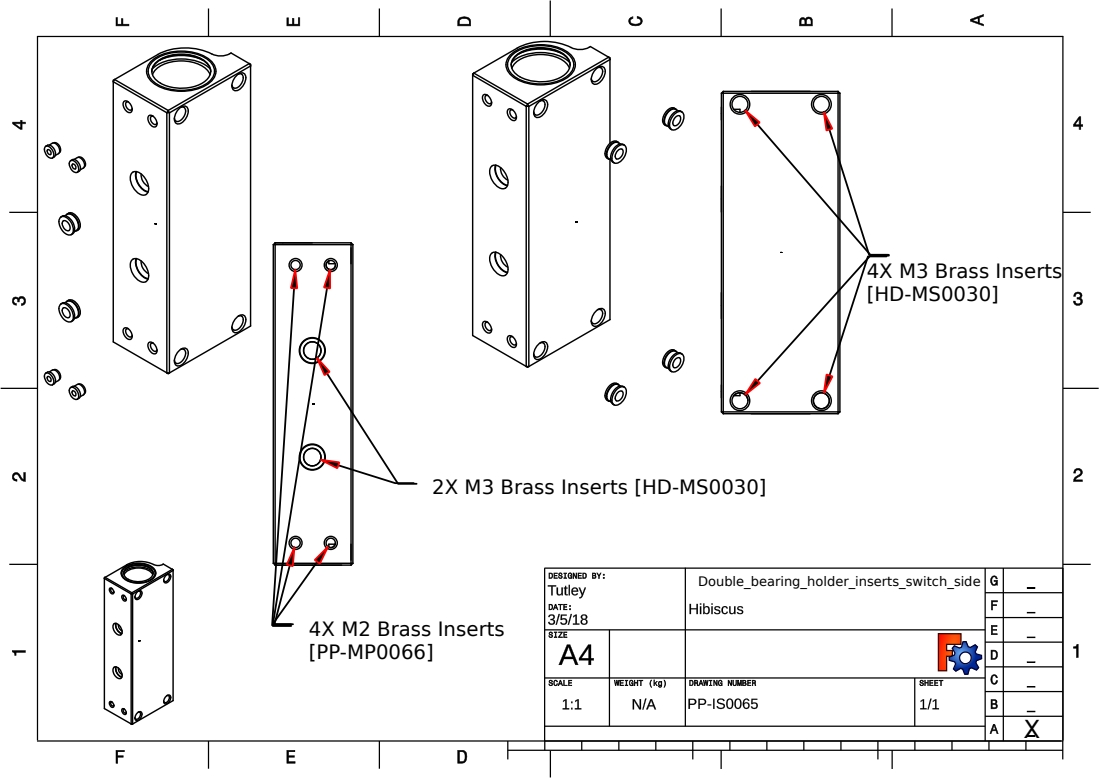
[picture p143: page 1]
Double_bearing_holder_inserts_switch_side; 4X M3 Brass Inserts [HD-MS0030]; 4X M2 Brass Inserts [PP-MP0066]

2X M3 Brass Inserts [HD-MS0030]
