reprapperMC/mini-hibiscus/production_parts/assemblies/inserts_assemblies/spool_arm_bracket_inserts.pdf

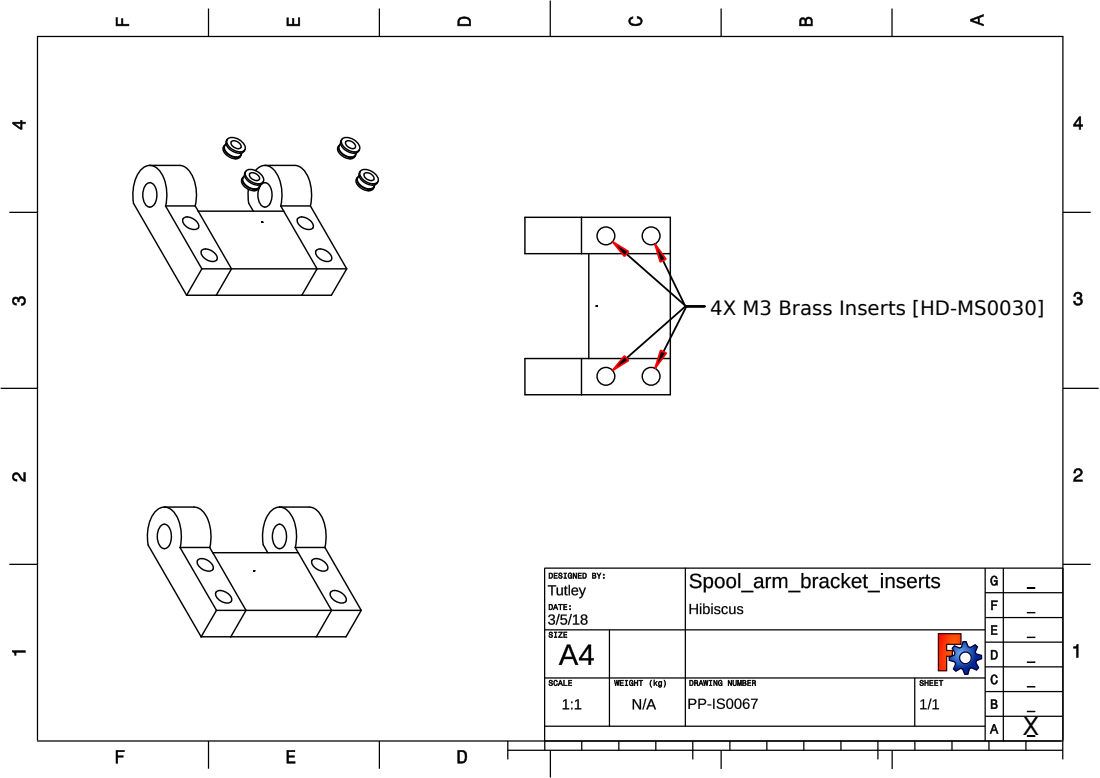
[picture p144: page 1]

4X M3 Brass Inserts [HD-MS0030]
