reprapperMC/mini-hibiscus/production_parts/assemblies/inserts_assemblies/x_carriage_inserts.pdf

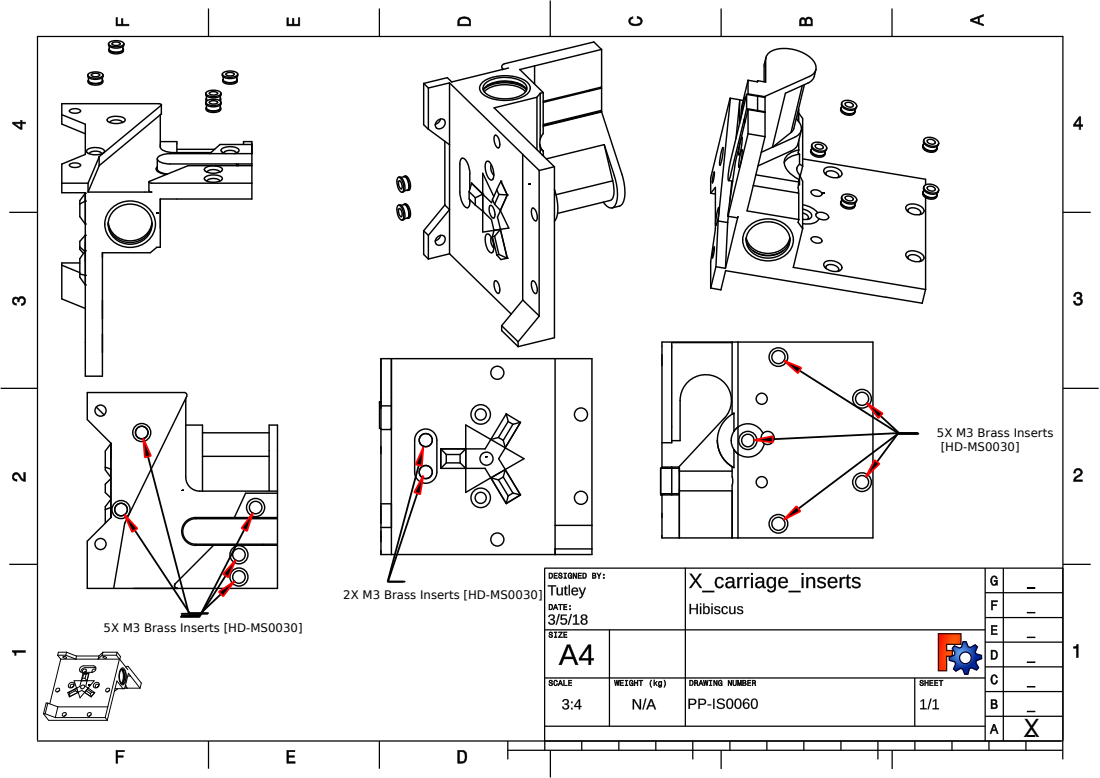
[picture p145: page 1]
5X M3 Brass Inserts [HD-MS0030]

2X M3 Brass Inserts [HD-MS0030]

5X M3 Brass Inserts [HD-MS0030]
