reprapperMC/mini-hibiscus/production_parts/assemblies/inserts_assemblies/x_bearing_holder_inserts.pdf

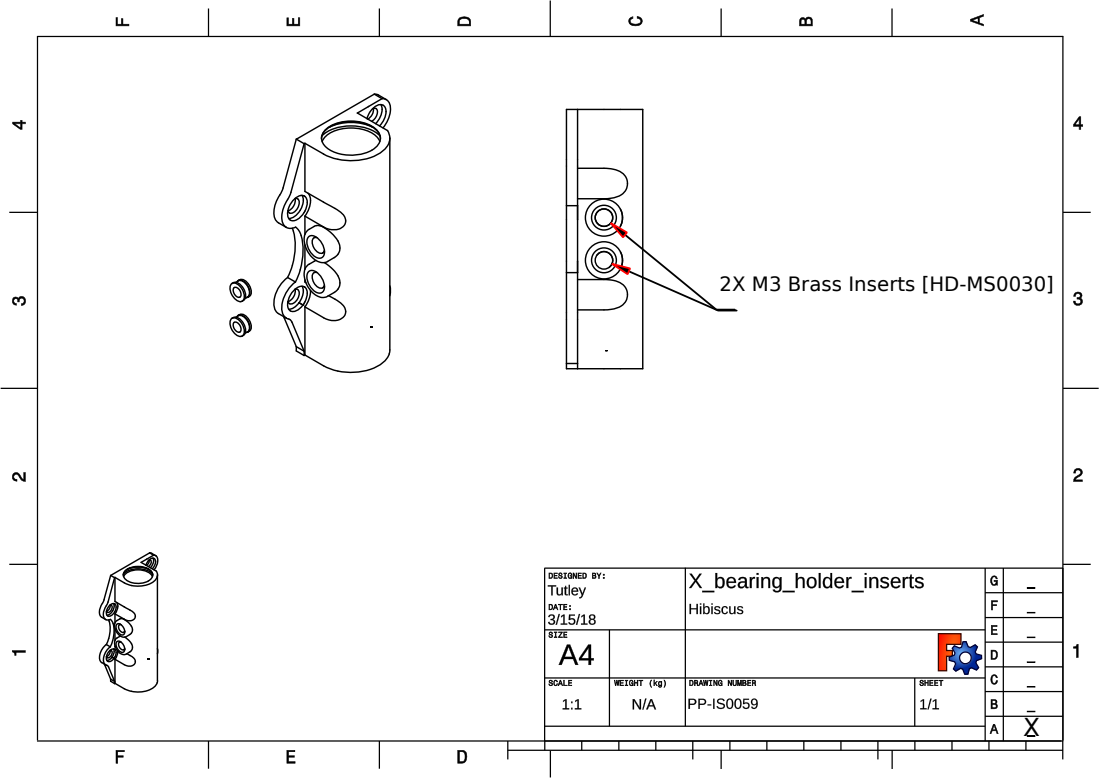
[picture p146: page 1]

2X M3 Brass Inserts [HD-MS0030]
