reprapperMC/mini-hibiscus/production_parts/machined_parts/Modular_bed_etched/mini_modular_bed_etched_AS-HB0005.pdf

4X R3.0

## SS Plate

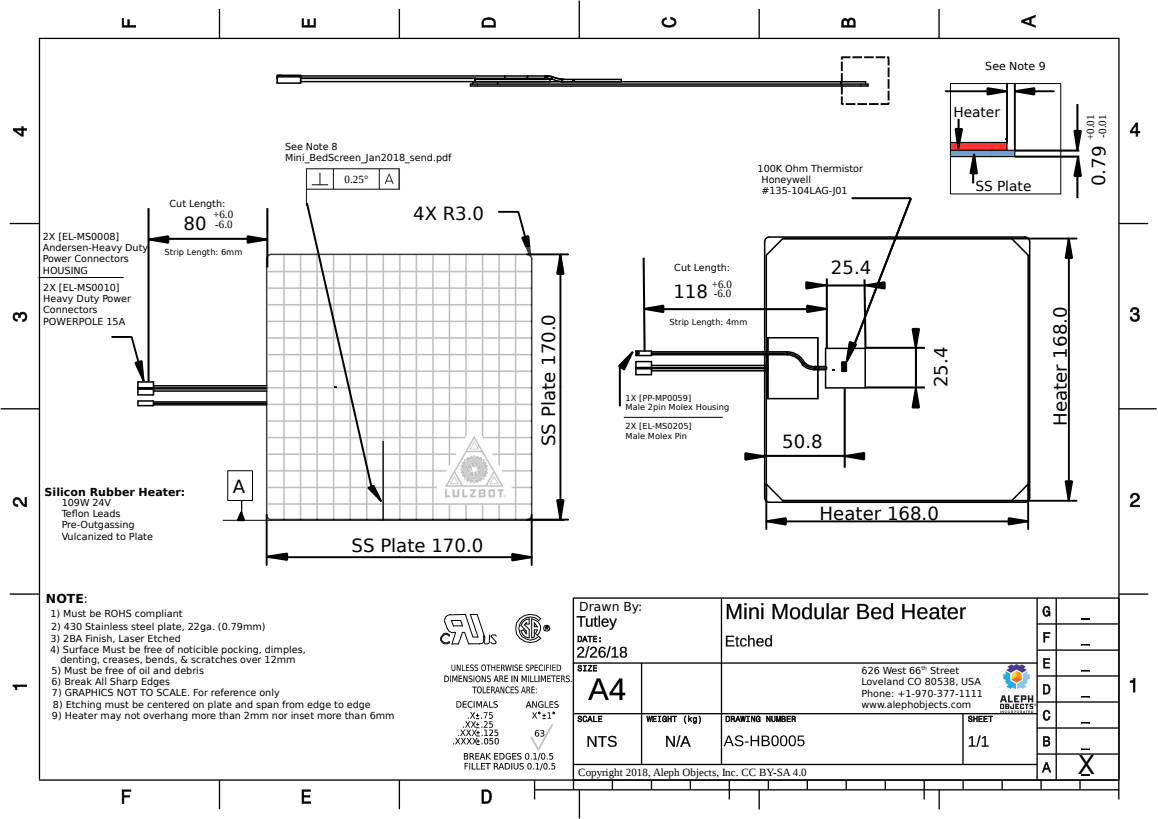
[picture p147: page 1]
Heater 168.0; SS Plate 170.0; Pla; Heater; See Note 9; See Note 8 Mini_BedScreen_Jan2018_send.pdf; Cut Length:; Strip Length: 6mm; Strip Length: 4mm; 100K Ohm Thermistor Honeywell #135-104LAG-J01

Andersen-Heavy Duty
Power Connectors
HOUSING
Heavy Duty Power
Connectors
POWERPOLE 15A

Male 2pin Molex Housing

Male Molex Pin

Silicon Rubber Heater:
Teflon Leads
Pre-Outgassing
Vulcanized to Plate

NOTE:
1) Must be ROHS compliant
2) 430 Stainless steel plate, 22ga. (0.79mm)
3) 2BA Finish, Laser Etched
4) Surface Must be free of noticible pocking, dimples,
denting, creases, bends, & scratches over 12mm
5) Must be free of oil and debris
6) Break All Sharp Edges
7) GRAPHICS NOT TO SCALE. For reference only
8) Etching must be centered on plate and span from edge to edge
9) Heater may not overhang more than 2mm nor inset more than 6mm

Drawn By:

626 West 66th Street Loveland CO 80538, USA Phone: +1-970-377-1111 www.alephobjects.com

Copyright 2018, Aleph Objects, Inc. CC BY-SA 4.0
