reprapperMC/mini-hibiscus/production_parts/electronics/e3d_hot_tightened_assembly/AS-HE0026_universal_orientation_RevB.pdf

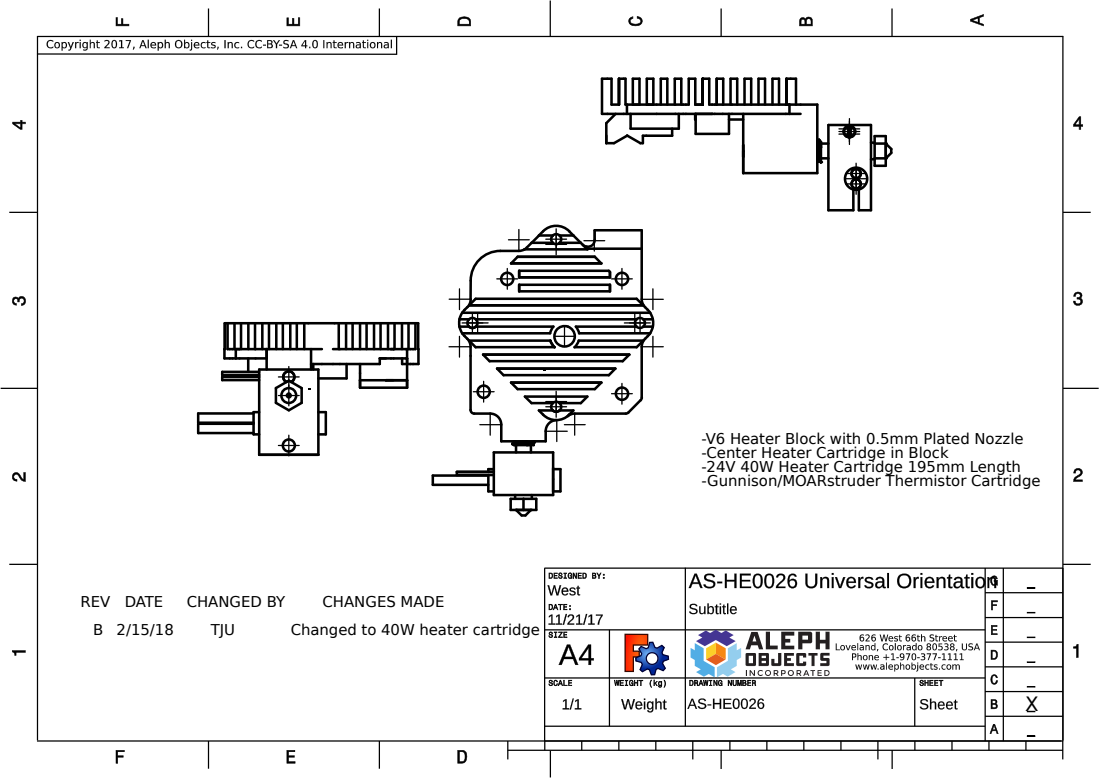
[picture p148: page 1]
TJU; Changed to 40W heater cartridge; REV DATE; CHANGED BY; CHANGES MADE

-V6 Heater Block with 0.5mm Plated Nozzle
-Center Heater Cartridge in Block
-24V 40W Heater Cartridge 195mm Length
-Gunnison/MOARstruder Thermistor Cartridge
