reprapperMC/mini-hibiscus/production_parts/assemblies/inserts_assemblies/blower_duct_inserts.pdf

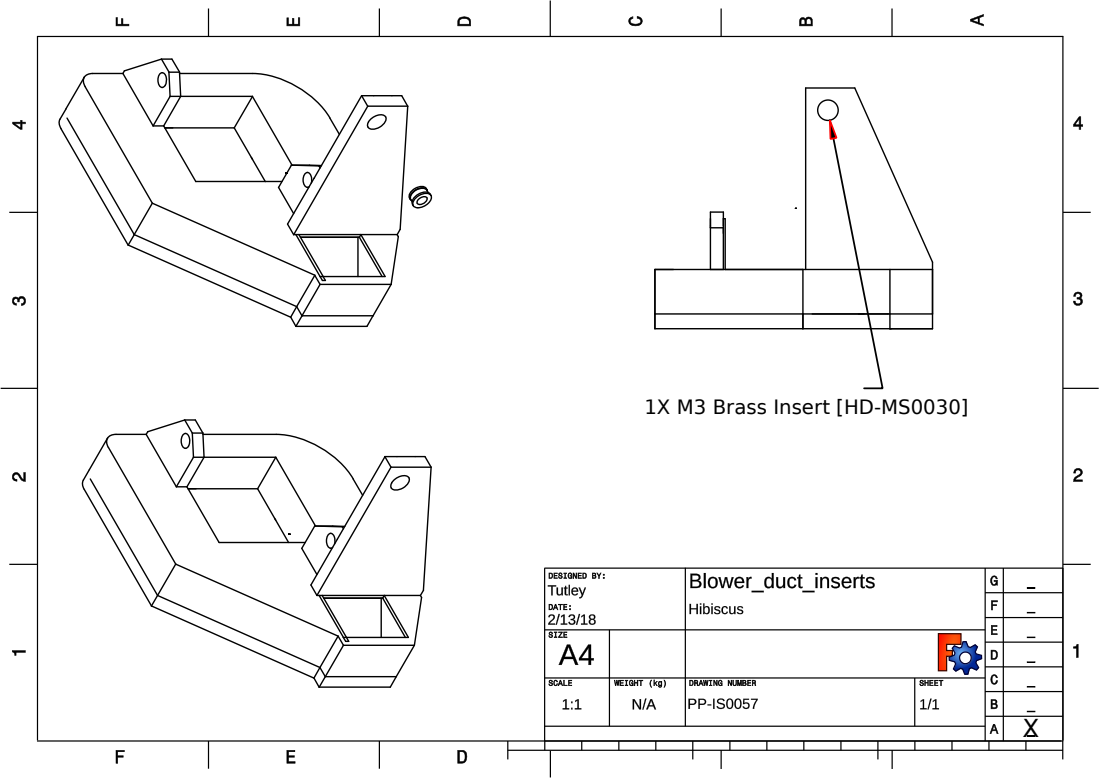
[picture p149: page 1]

1X M3 Brass Insert [HD-MS0030]
