reprapperMC/mini-hibiscus/production_parts/assemblies/inserts_assemblies/spool_mount_a_inserts.pdf

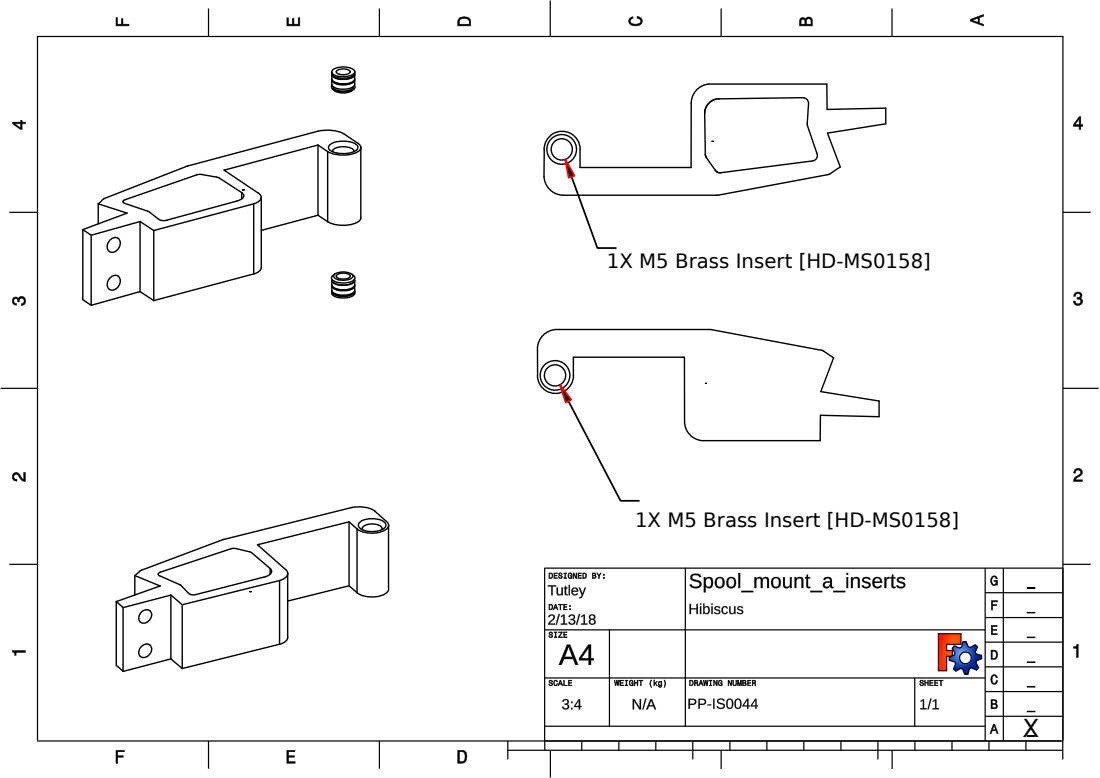
[picture p150: page 1]

1X M5 Brass Insert [HD-MS0158]
