reprapperMC/mini-hibiscus/production_parts/assemblies/inserts_assemblies/spool_mount_b_inserts.pdf

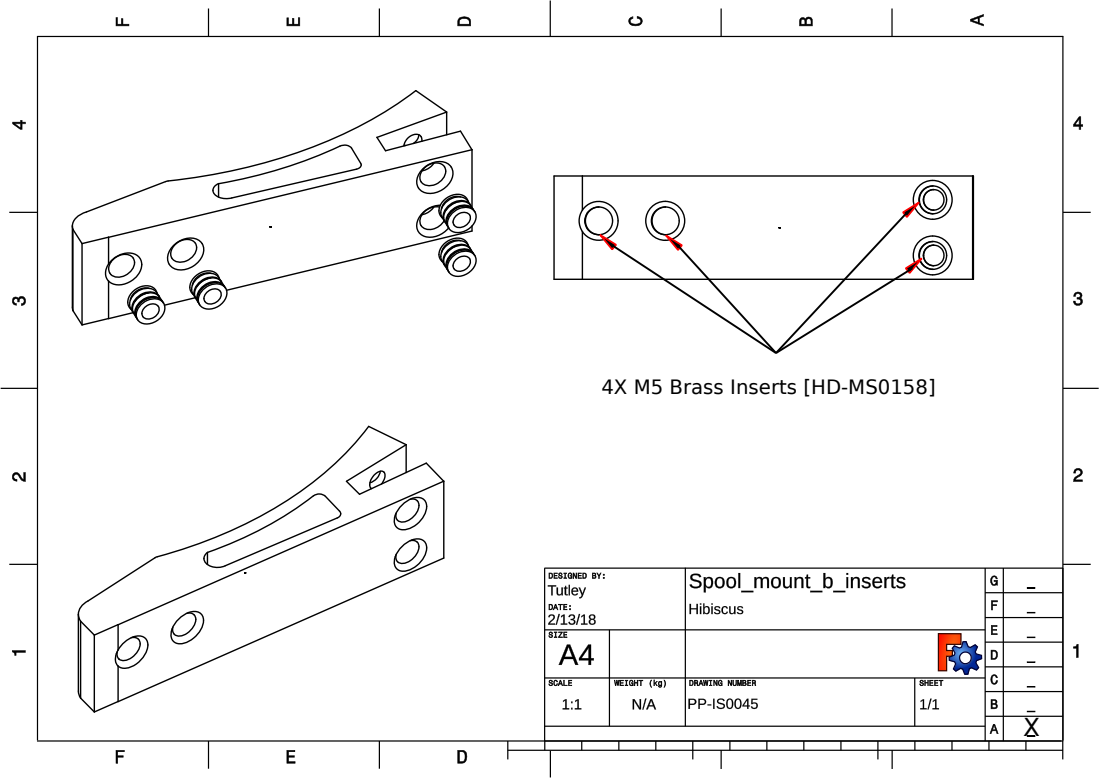
[picture p151: page 1]

4X M5 Brass Inserts [HD-MS0158]
