reprapperMC/mini-hibiscus/production_parts/electronics/e3d_hot_tightened_assembly/TITAN-IM-PARTS (Edition 3).pdf

## TITAN-BODY-RH

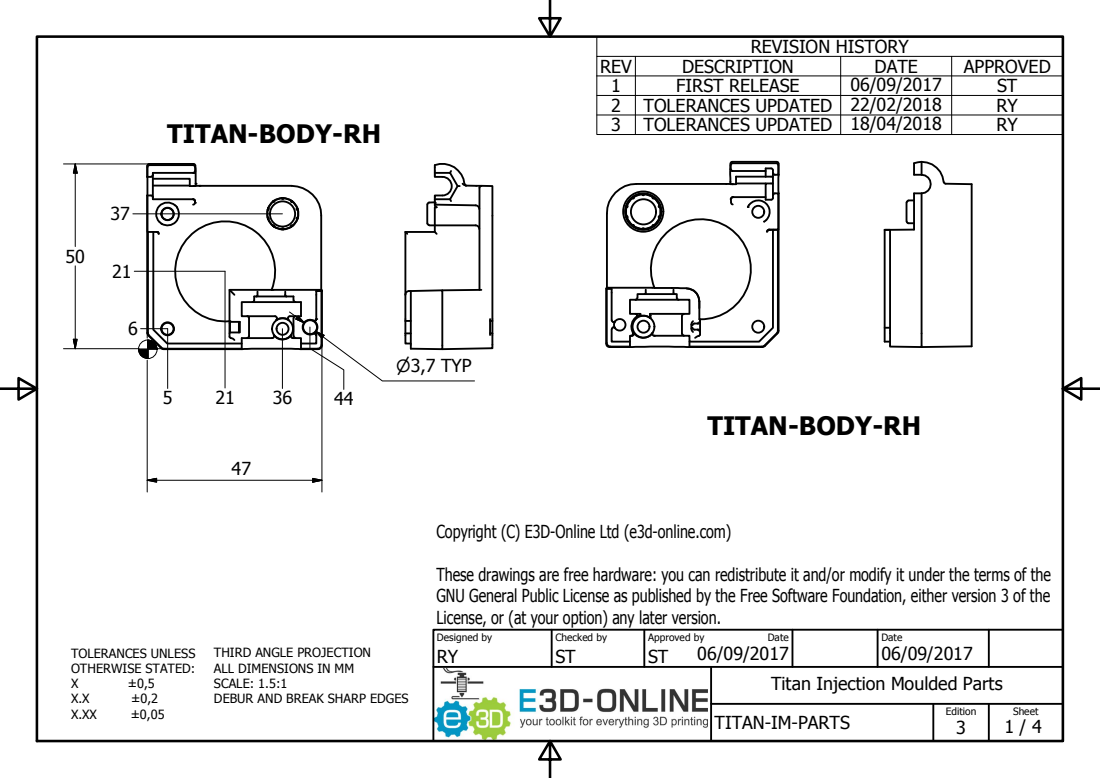
[picture p153: page 1]
Designed by; Checked by; Approved by; Date; Edition; Sheet; REVISION HISTORY; REV; DESCRIPTION; DATE; APPROVED; FIRST RELEASE; TOLERANCES UPDATED; TOLERANCES UNLESS OTHERWISE STATED:; P3,7 TYP

TITAN-BODY-RH

Copyright (C) E3D-Online Ltd (e3d-online.com)

These drawings are free hardware: you can redistribute it and/or modify it under the terms of the
GNU General Public License as published by the Free Software Foundation, either version 3 of the
License, or (at your option) any later version.

THIRD ANGLE PROJECTION
ALL DIMENSIONS IN MM
SCALE: 1.5:1
DEBUR AND BREAK SHARP EDGES

Titan Injection Moulded Parts

TITAN-IM-PARTS

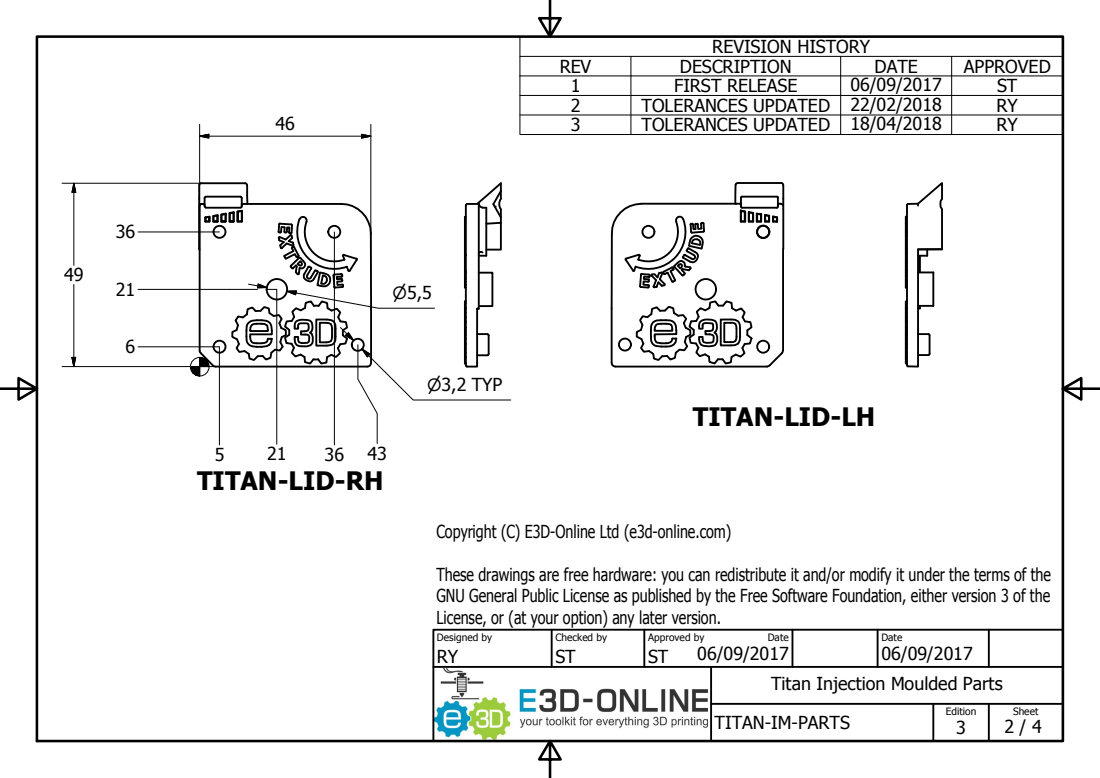
[picture p154: page 2]
Designed by; Checked by; Approved by; Date; Edition; Sheet; REV; DESCRIPTION; DATE; APPROVED; FIRST RELEASE; TOLERANCES UPDATED; P3,2 TYP

TITAN-LID-LH

TITAN-LID-RH

Copyright (C) E3D-Online Ltd (e3d-online.com)

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

Titan Injection Moulded Parts

## TITAN-IDLER-2.1

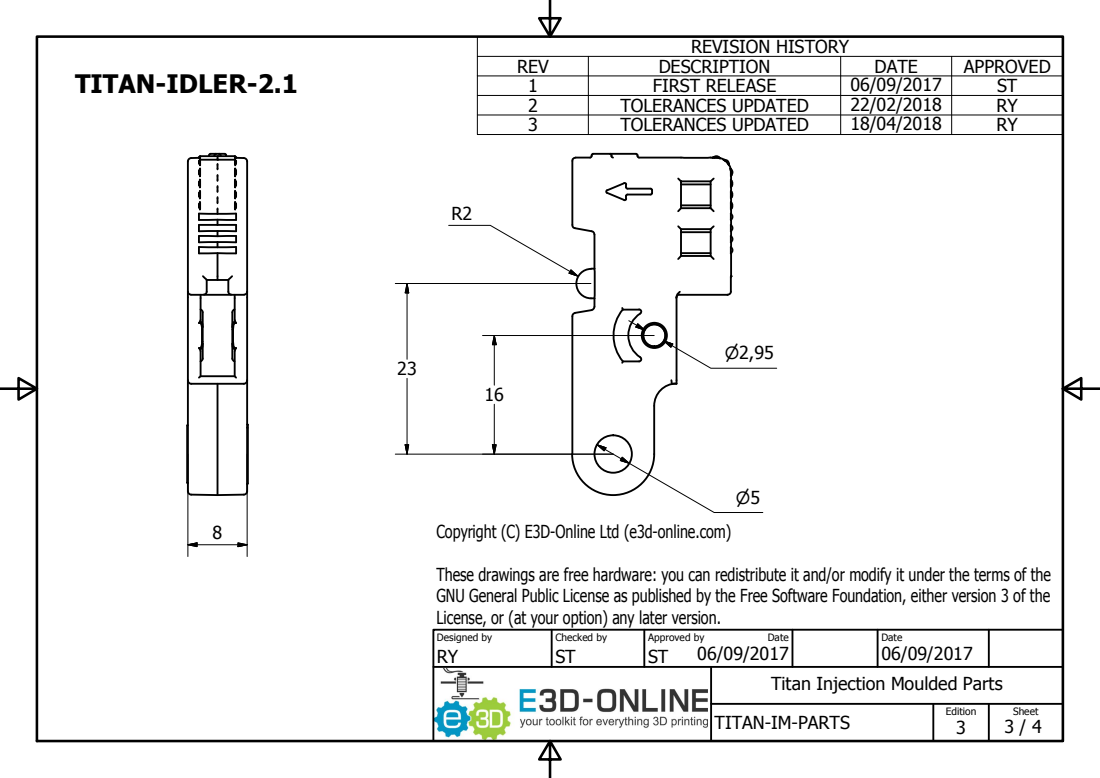
[picture p155: page 3]
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

Copyright (C) E3D-Online Ltd (e3d-online.com)

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

Titan Injection Moulded Parts

A-A ( 2:1 )

A

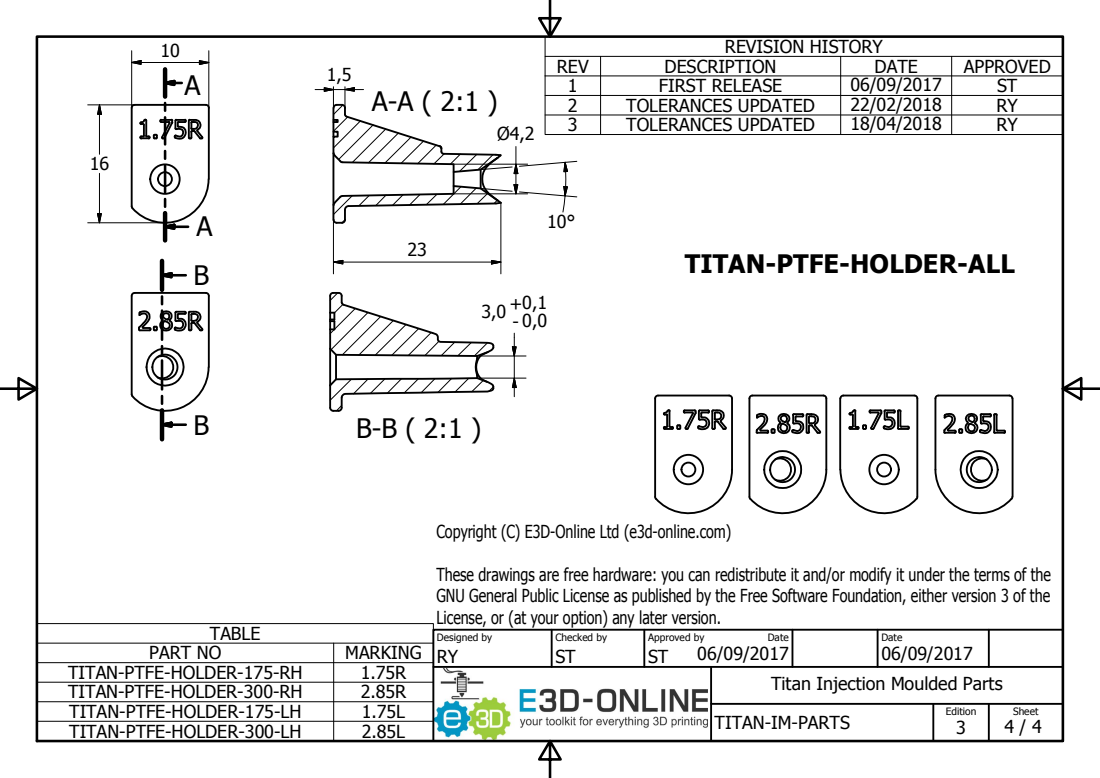
[picture p156: page 4]
Designed by; Checked by; Approved by; Date; Edition; Sheet; REV; DESCRIPTION; DATE; APPROVED; FIRST RELEASE; TOLERANCES UPDATED; TABLE; PART NO; MARKING; TITAN-PTFE-HOLDER-175-RH; TITAN-PTFE-HOLDER-300-RH; TITAN-PTFE-HOLDER-175-LH; TITAN-PTFE-HOLDER-300-LH

TITAN-PTFE-HOLDER-ALL

Copyright (C) E3D-Online Ltd (e3d-online.com)

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

Titan Injection Moulded Parts
