reprapperMC/mini-hibiscus/production_parts/electronics/HEATSINK/Thermal_gap_filler_cut_size_HD-MS0463.pdf

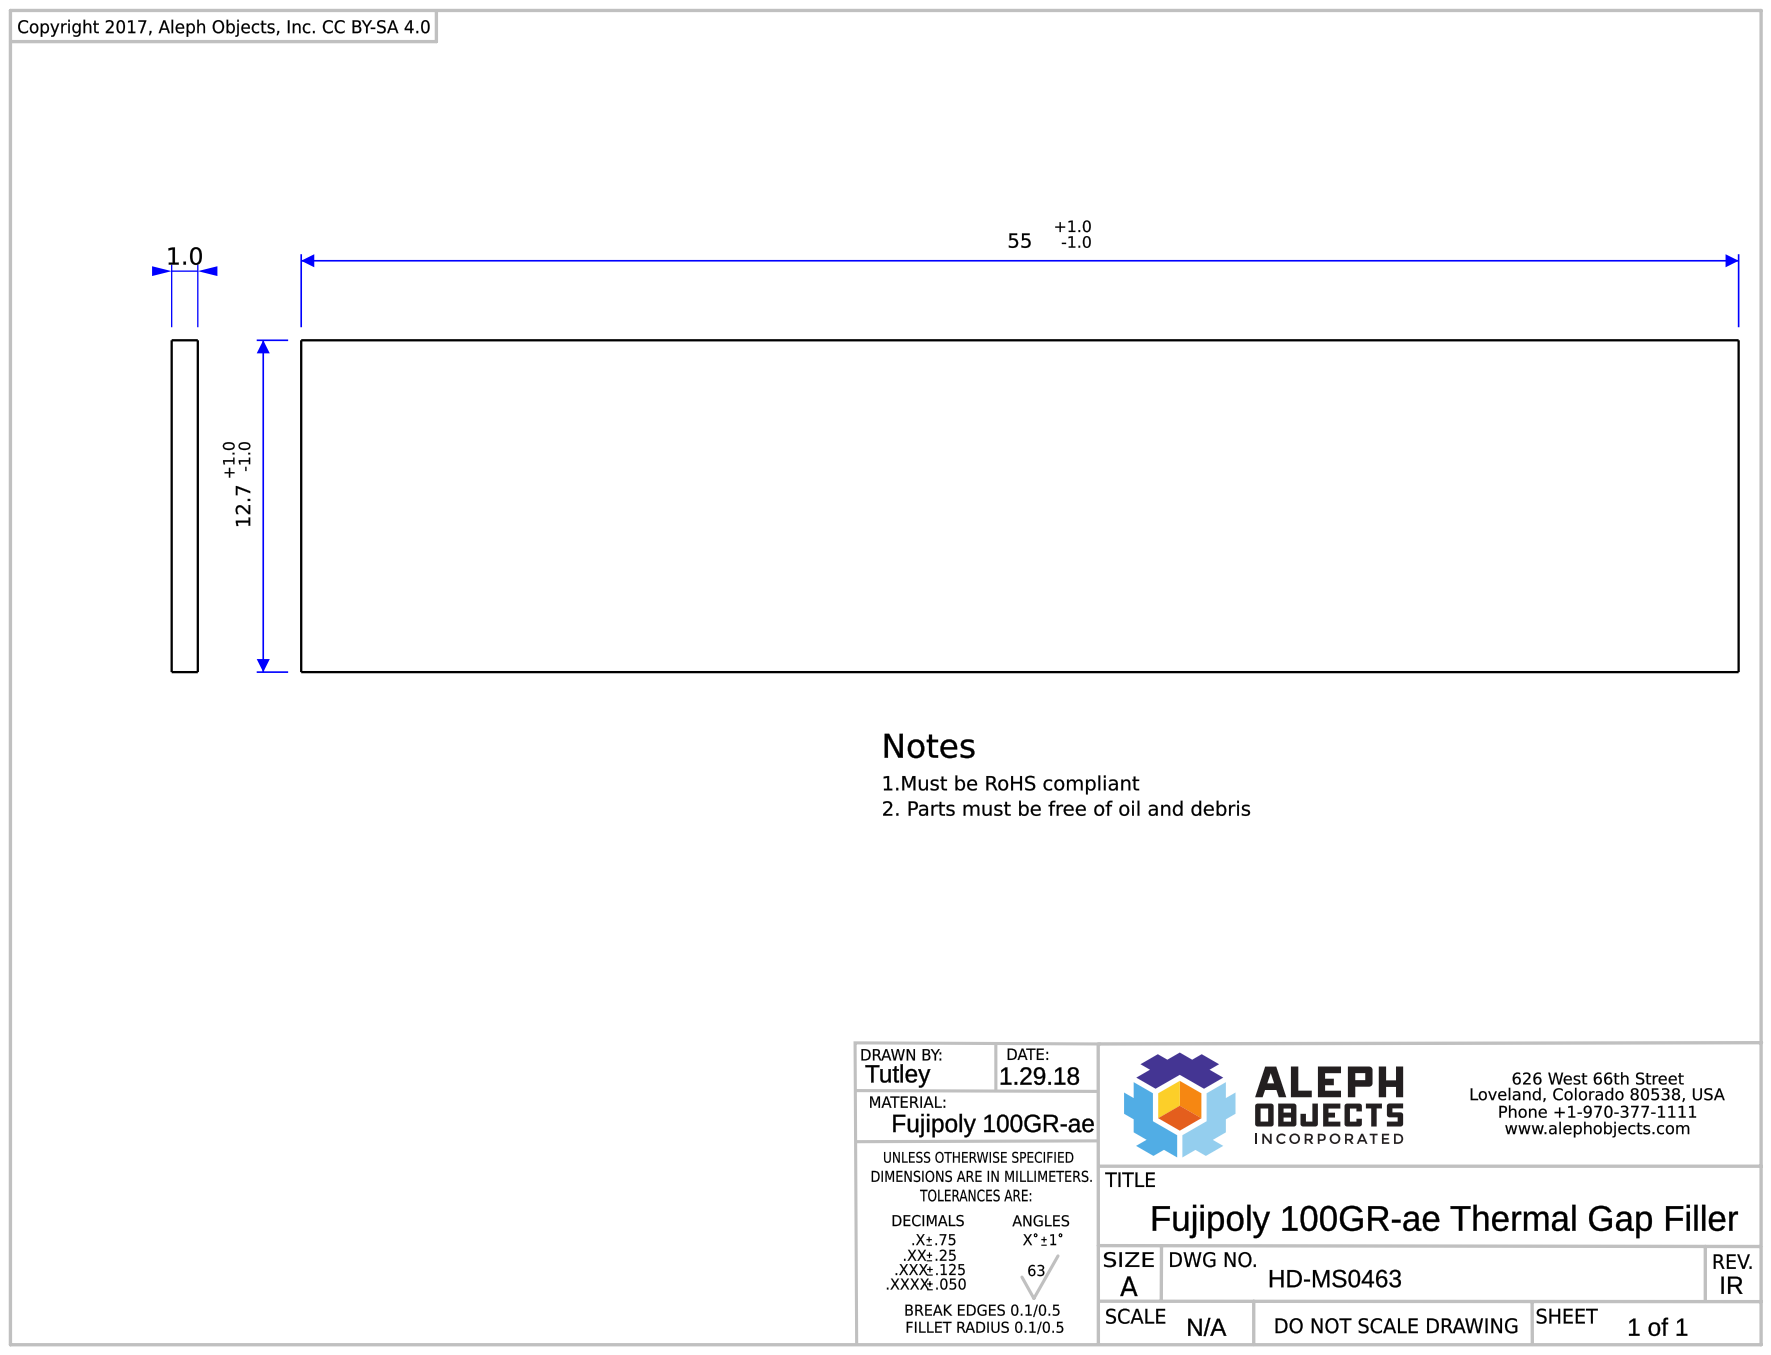
[picture p157: page 1]
