reprapperMC/mini-hibiscus/production_parts/machined_parts/Modular_bed_etched/Mini_BedScreen_Jan2018_send.pdf

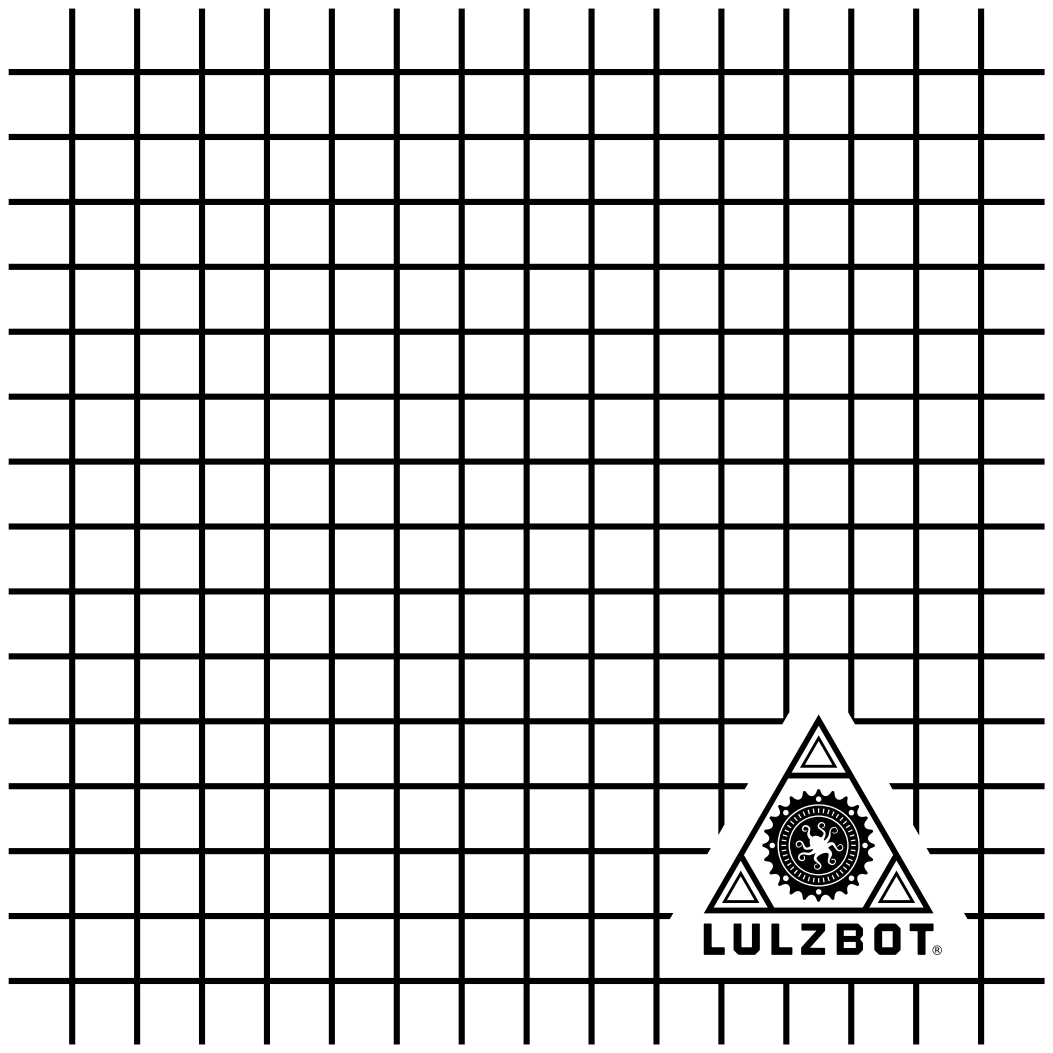
[picture p158: page 1]
