reprapperMC/mini-hibiscus/production_parts/machined_parts/bed_mount_plate/bed-mount-plate-mini_PP-FP0138_revG.pdf

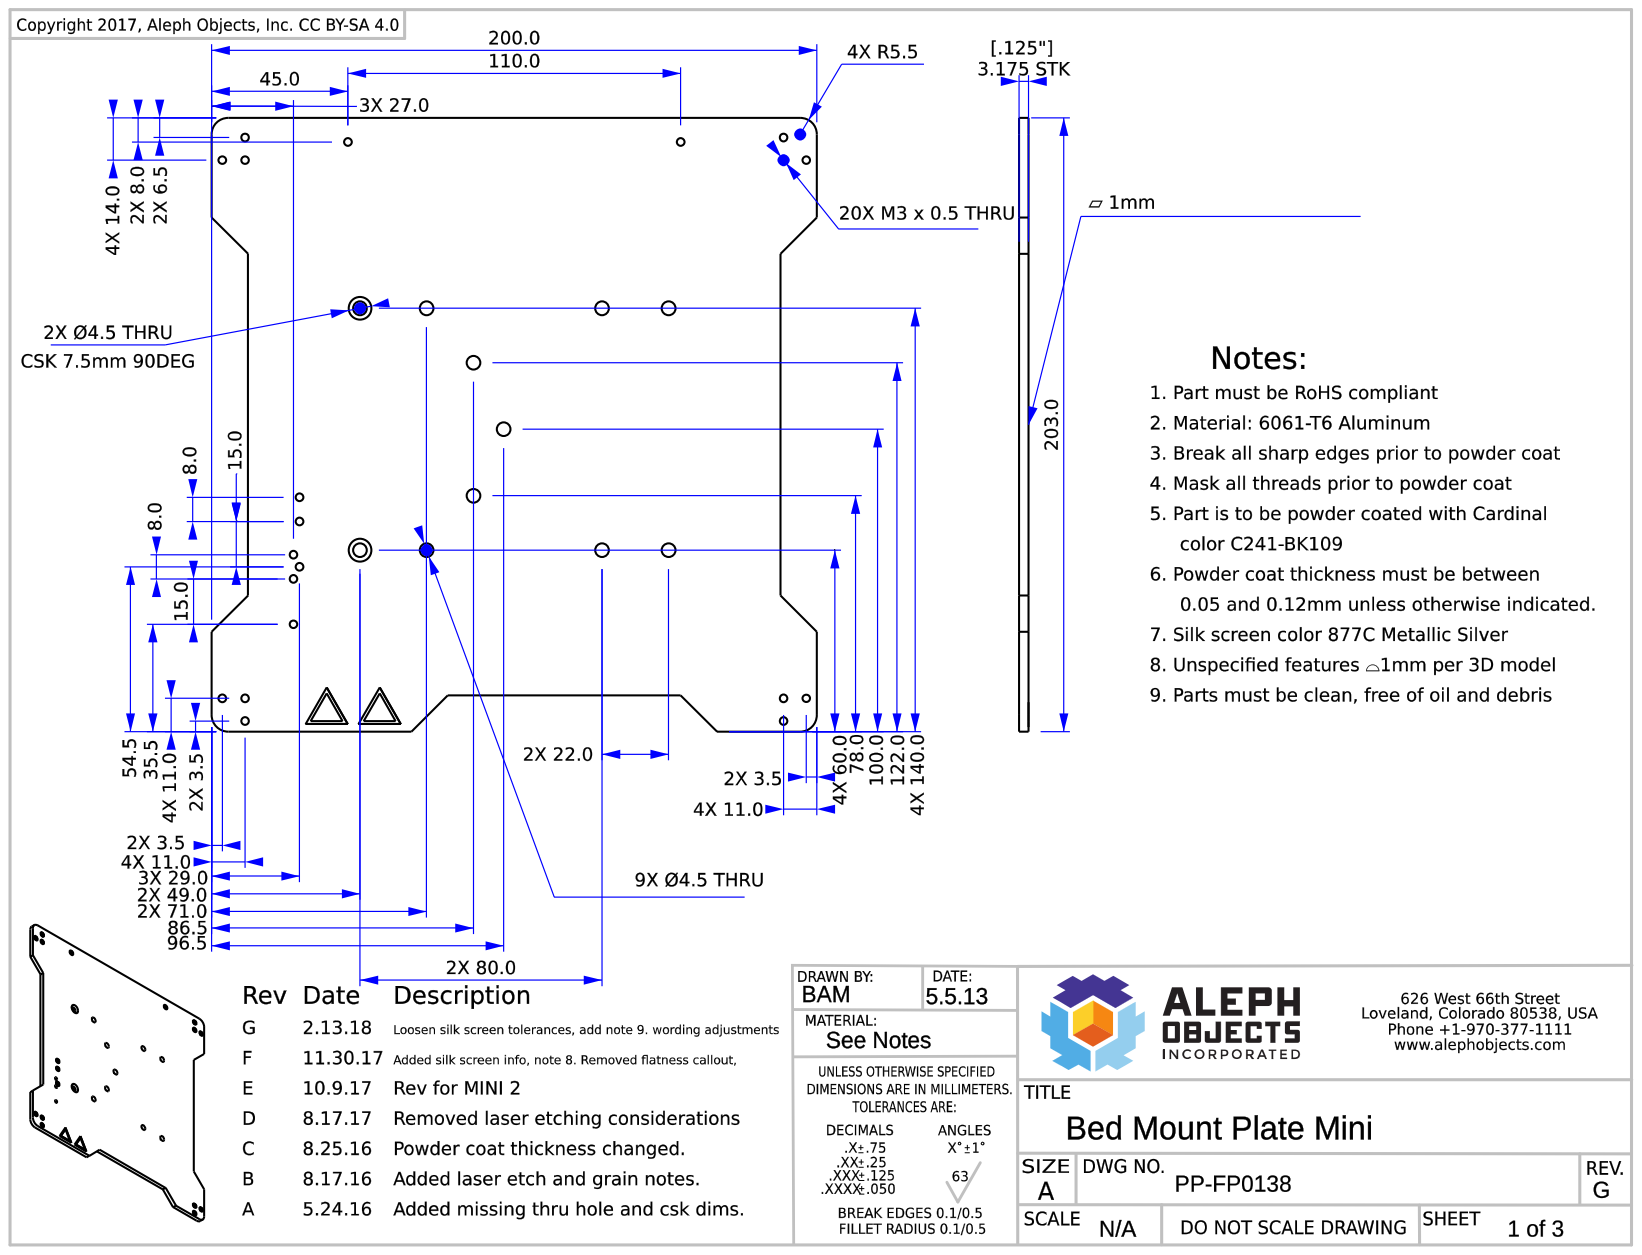
[picture p159: page 1]

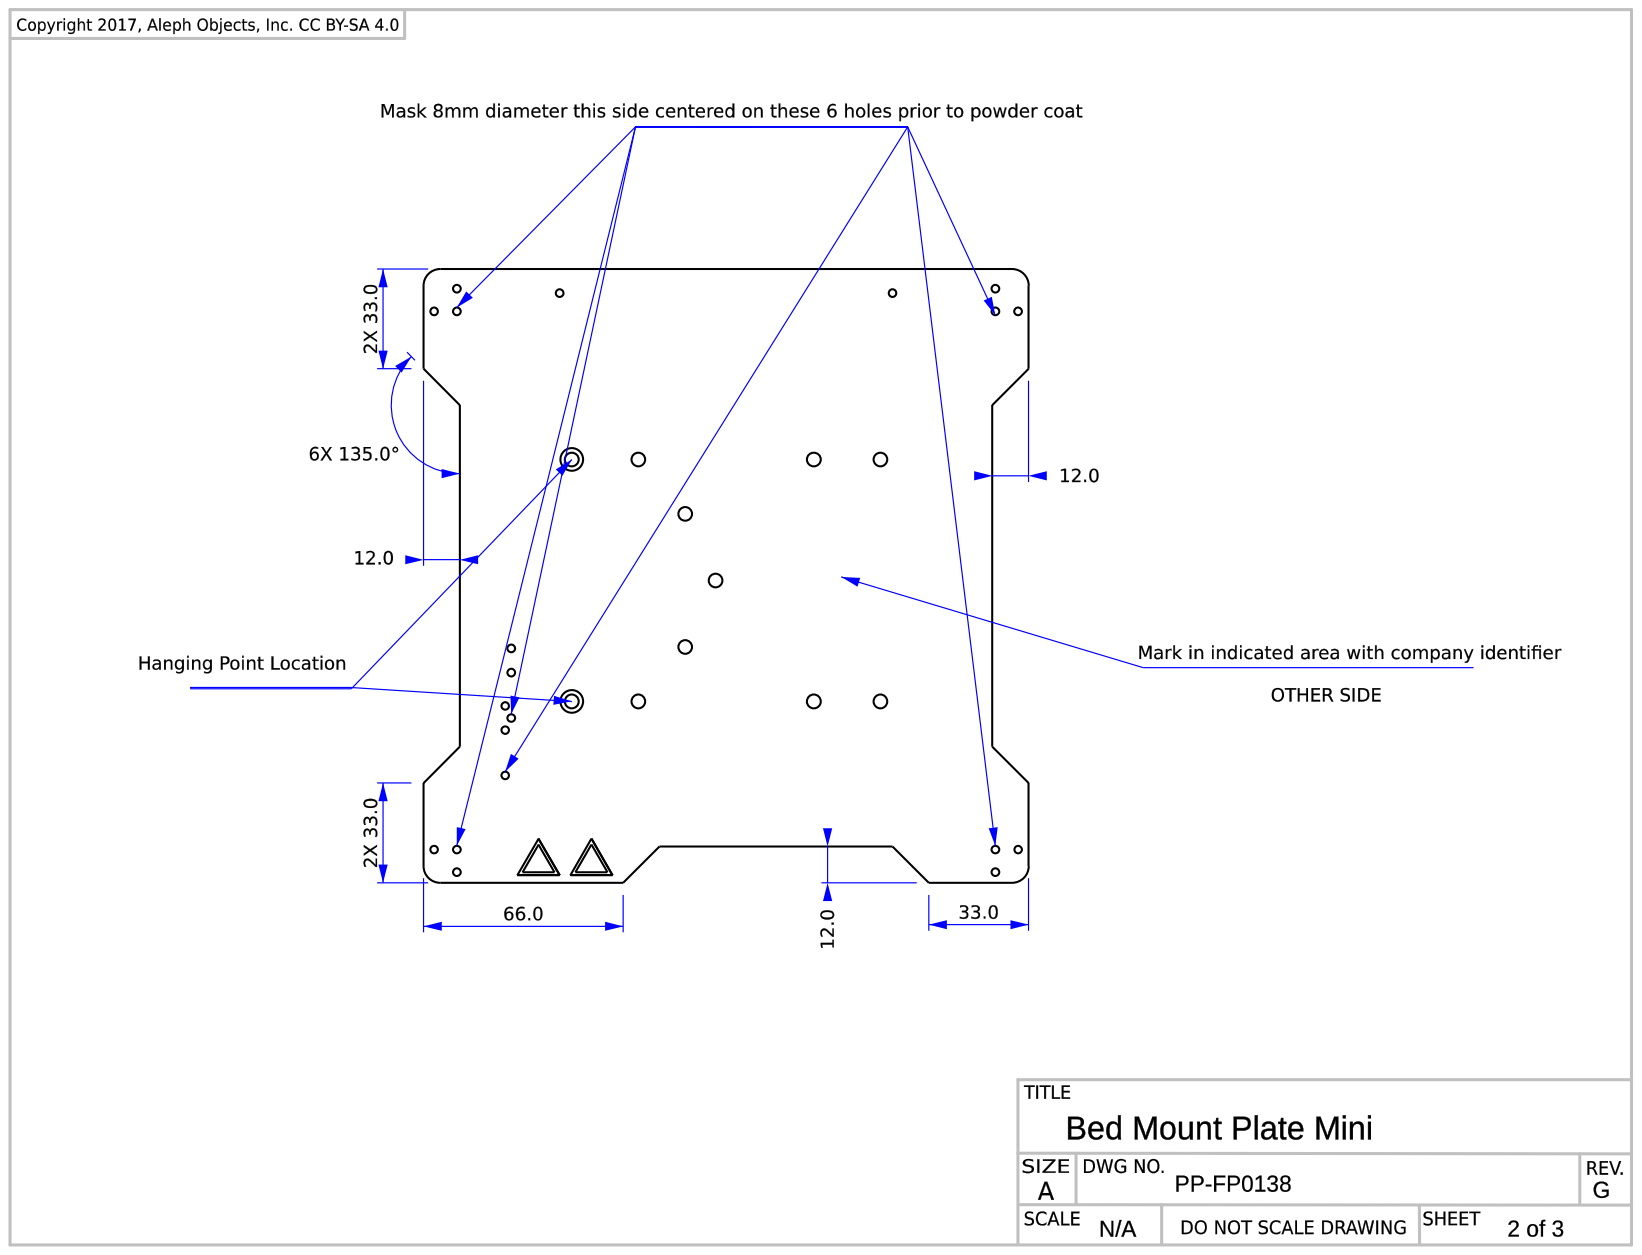
[picture p160: page 2]

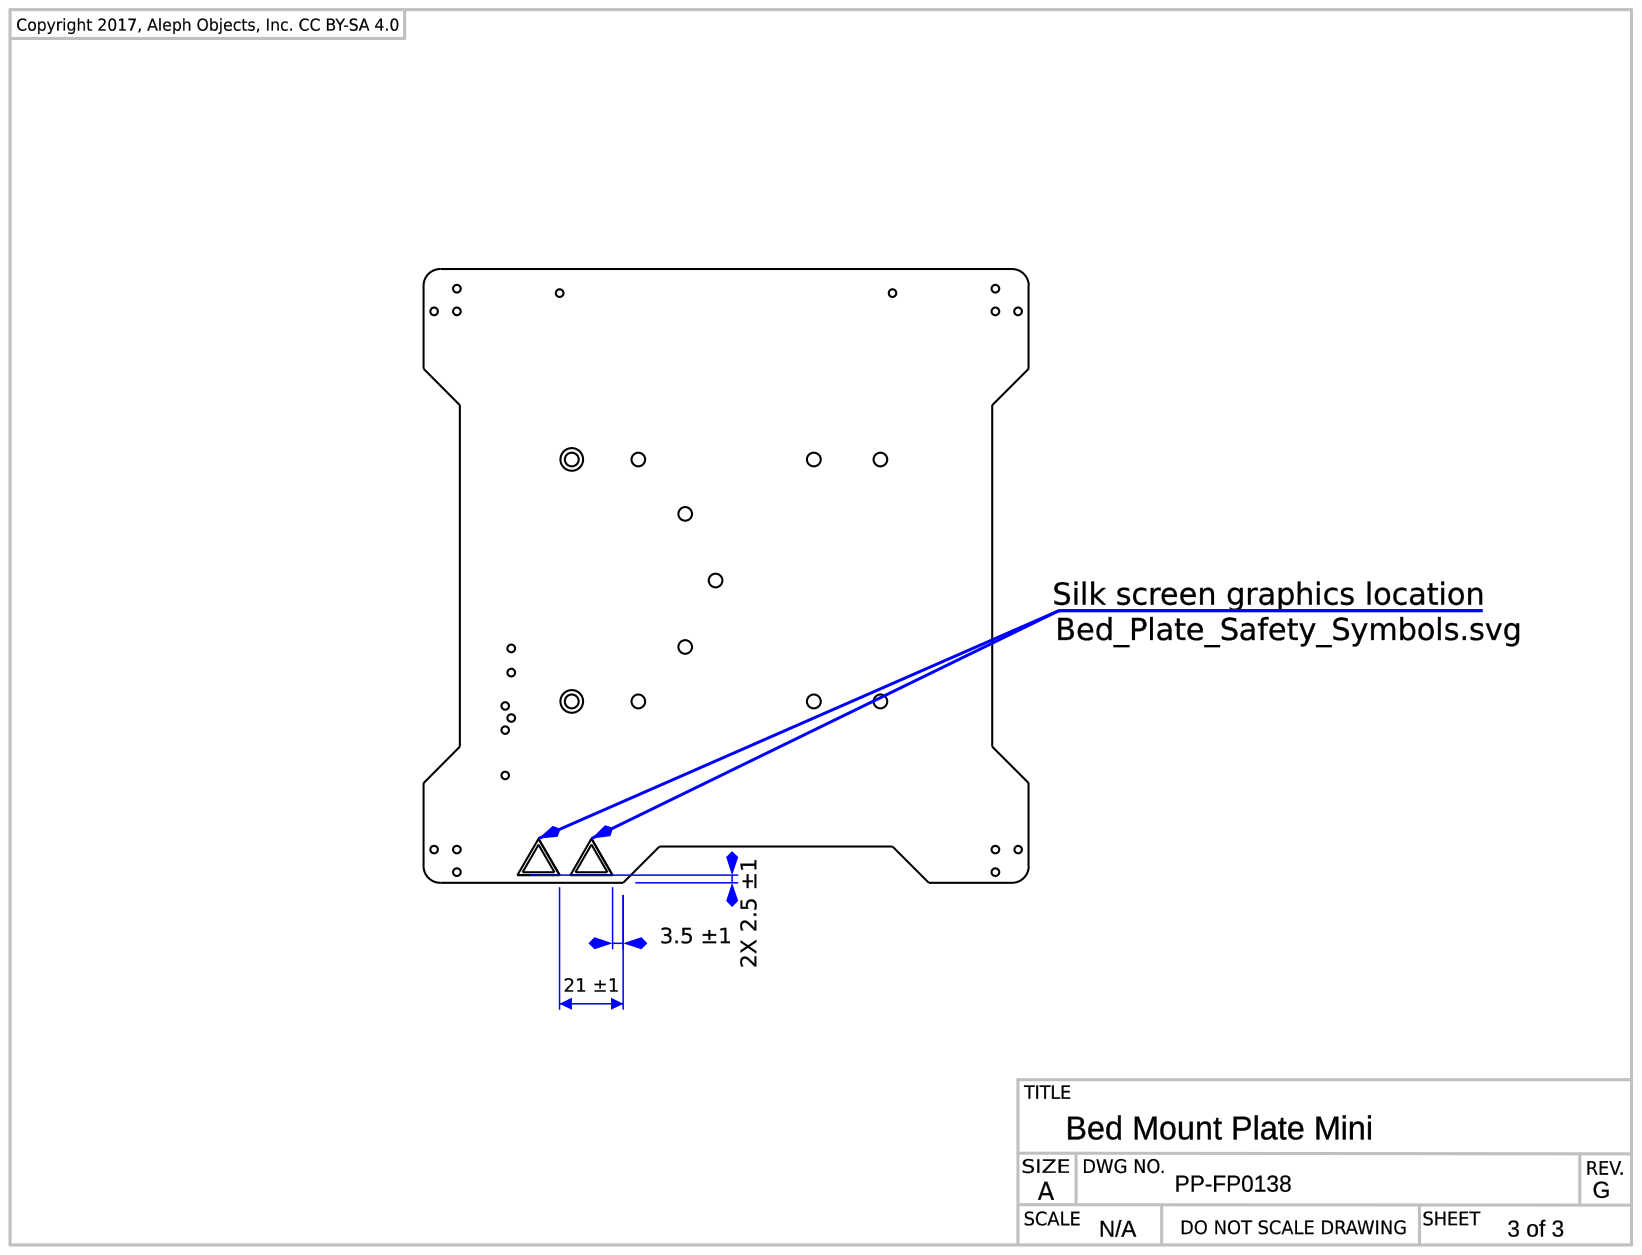
[picture p161: page 3]
