reprapperMC/mini-hibiscus/production_parts/machined_parts/right_side/right-side-mini_PP-FP0052_revG.pdf

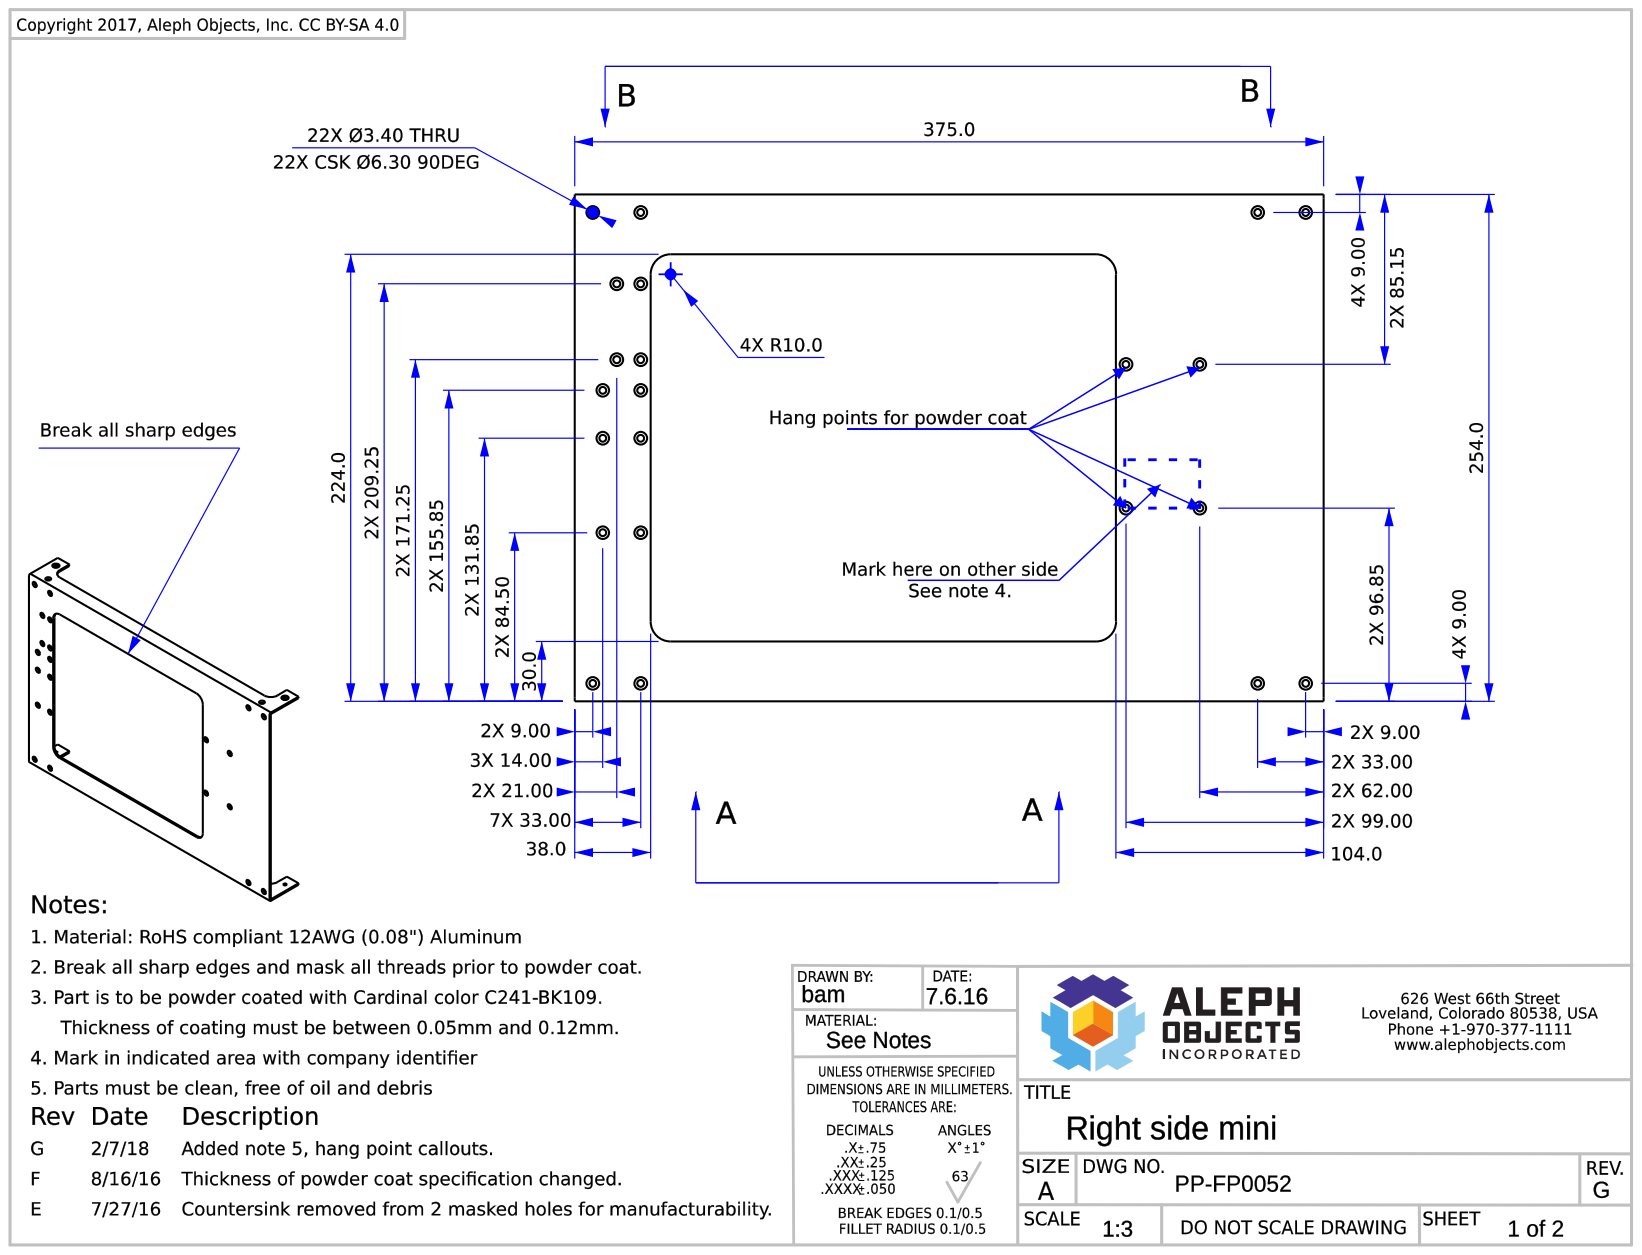
[picture p162: page 1]

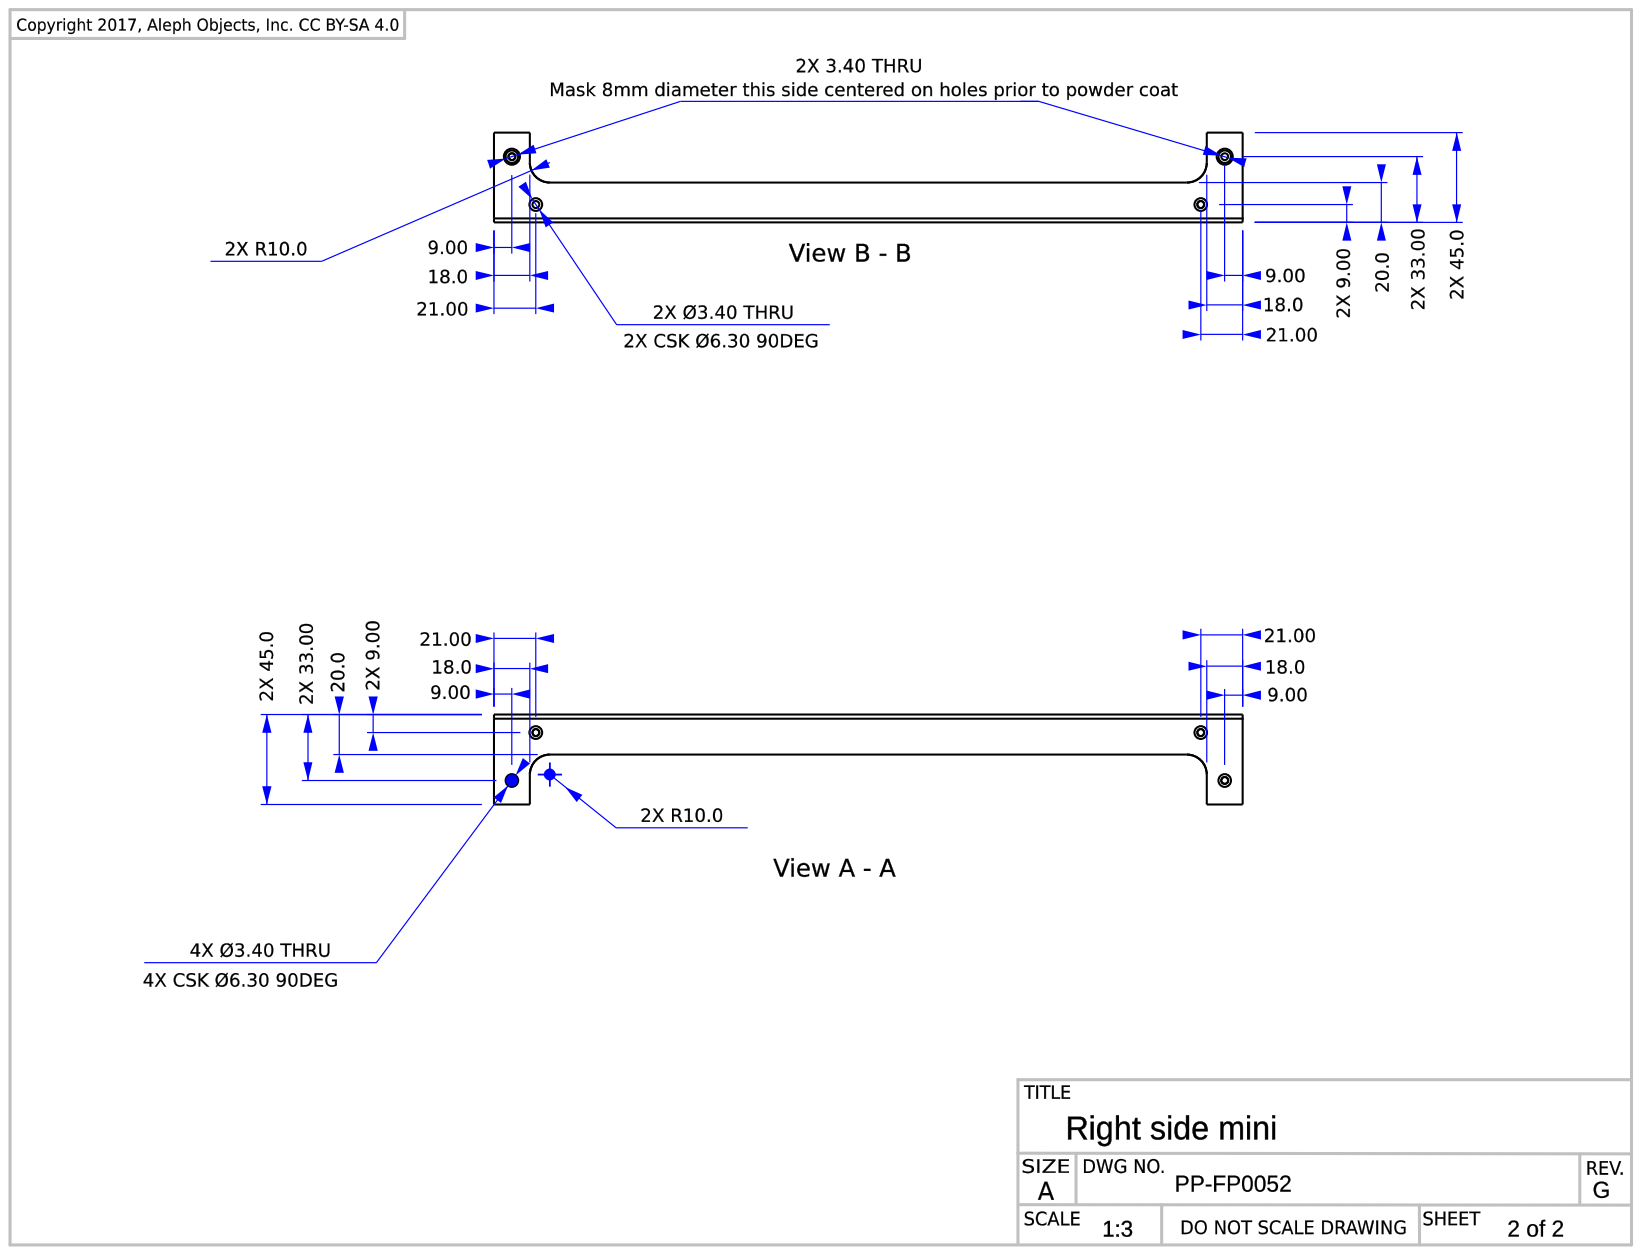
[picture p163: page 2]
