reprapperMC/mini-hibiscus/documentation/quick_start_quide/Mini_2_WSG_Cover_01.pdf

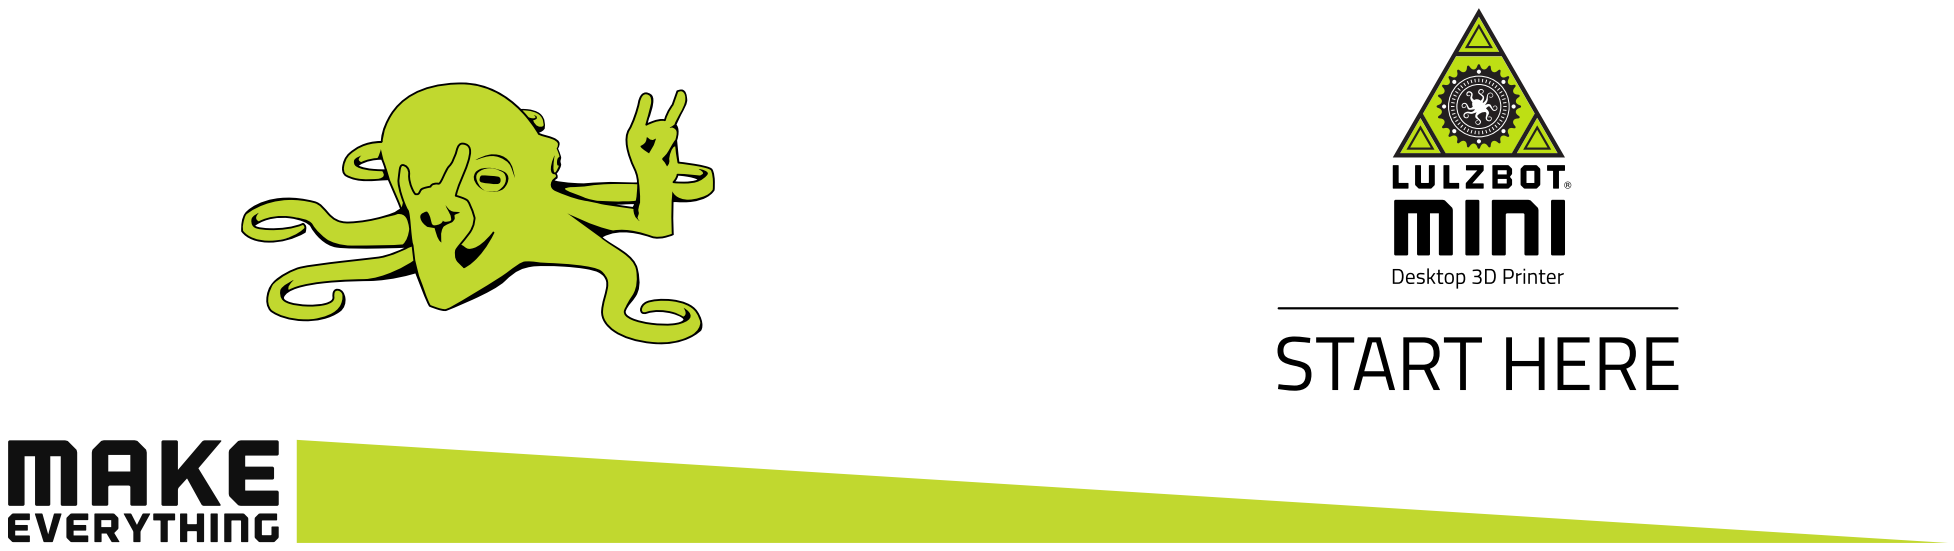
[picture p164: page 1]
