reprapperMC/mini-hibiscus/production_docs/compliance/safety_warnings_LulzBot_Mini2.pdf

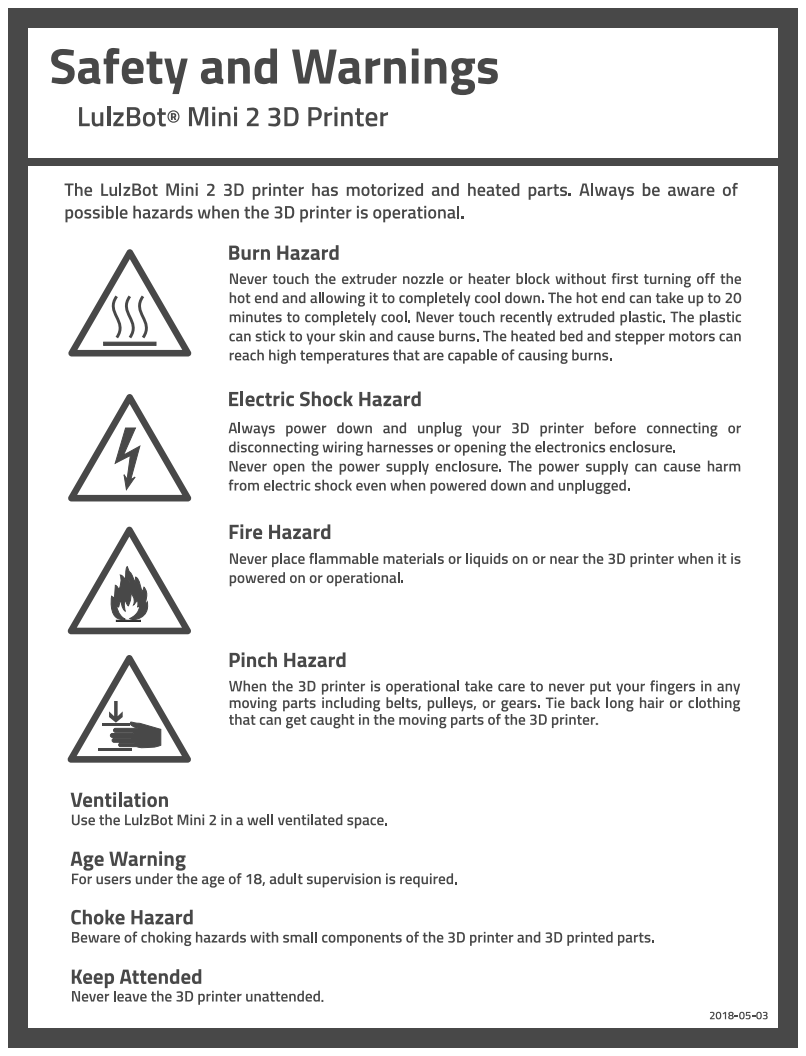
[picture p165: page 1]
