reprapperMC/mini-hibiscus/production_docs/labels/asset_tag/Mini2_AssetTag_Bleed.pdf

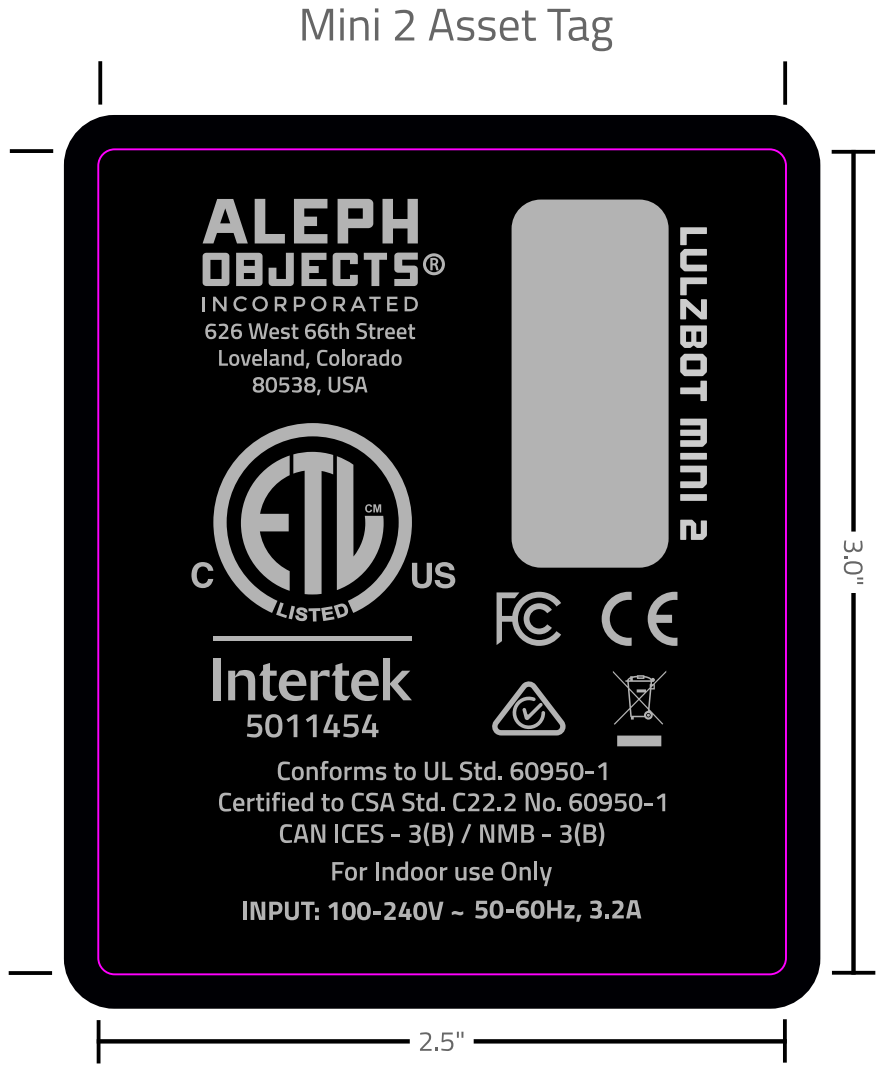
[picture p166: page 1]
