reprapperMC/mini-hibiscus/production_docs/labels/electrial_warning/Mini2_ElectricWarning_Tag_Bleed.pdf

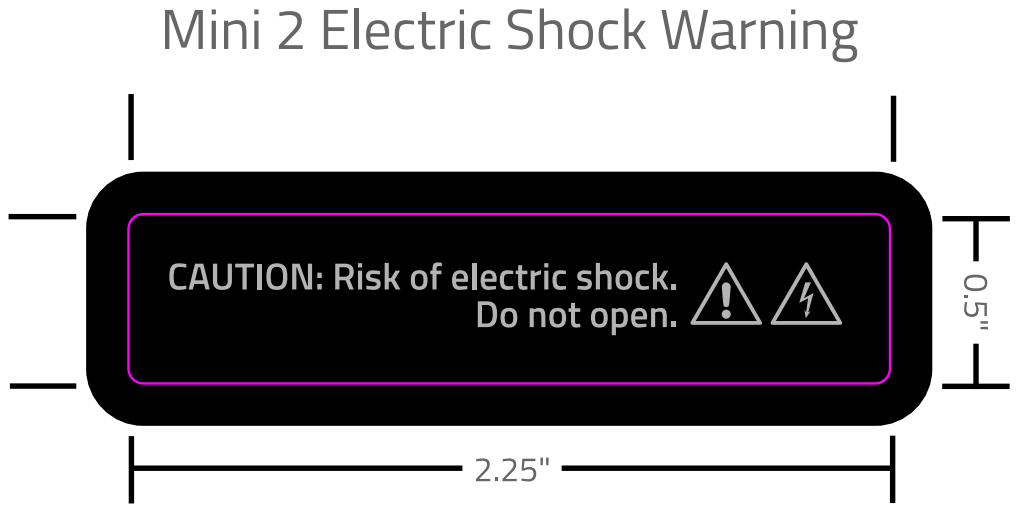
[picture p167: page 1]
