reprapperMC/mini-hibiscus/production_docs/labels/hot_symbol/Hot_Symbol_Size_Outline_03.pdf

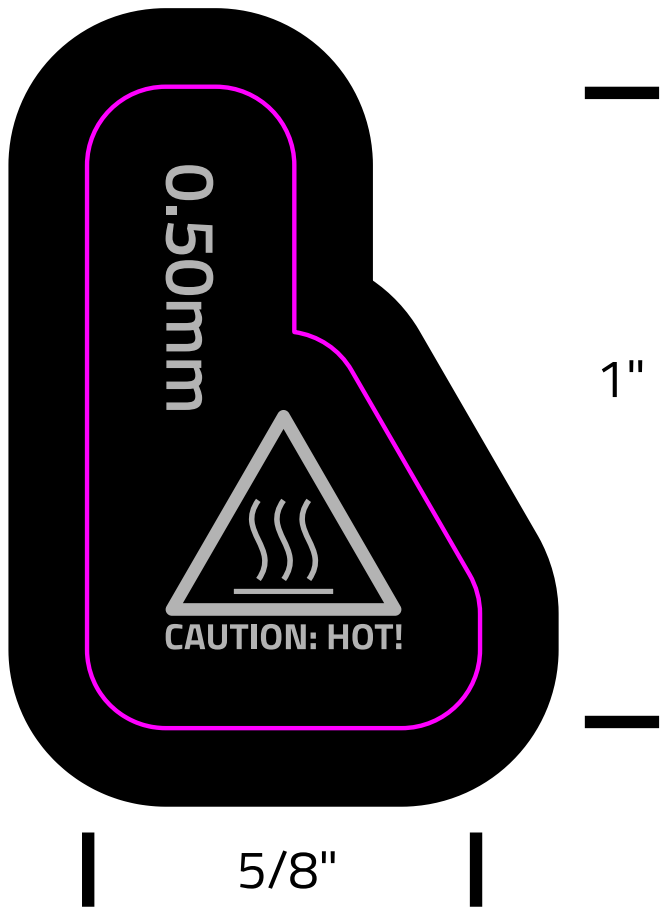
[picture p168: page 1]
