reprapperMC/mini-hibiscus/production_docs/labels/hot_symbol/hotSymbol_Outline_03.pdf

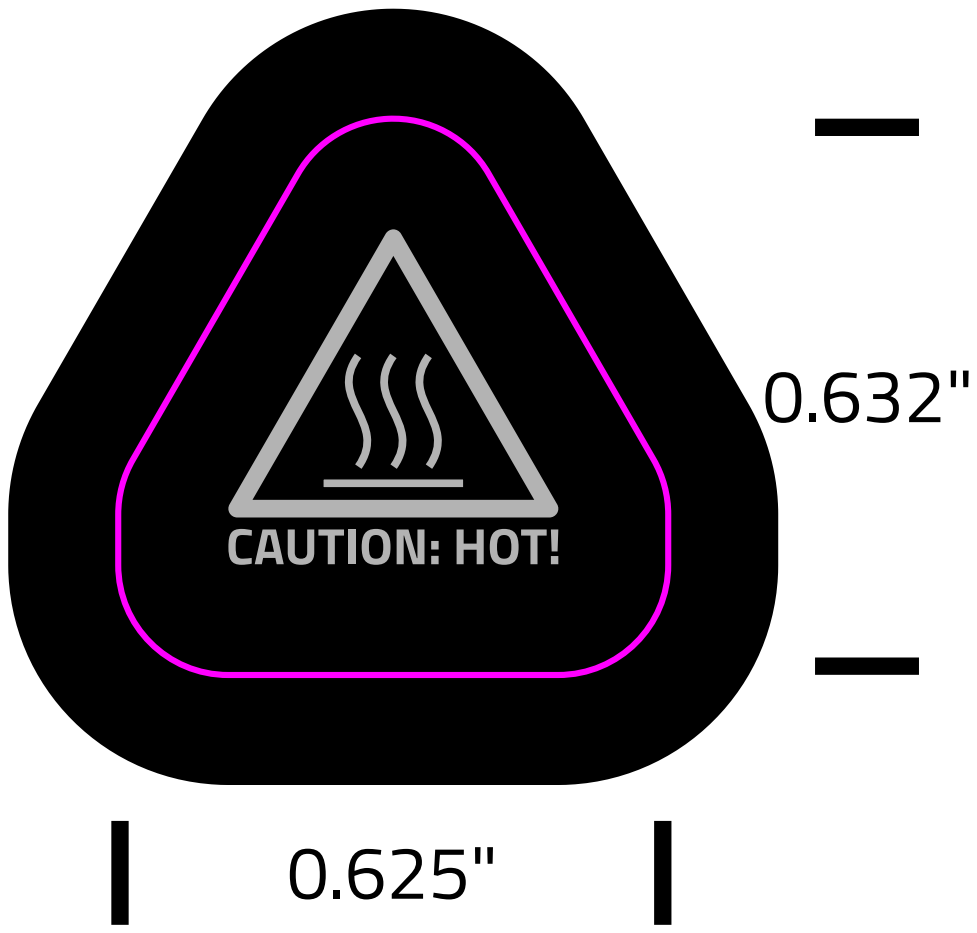
[picture p169: page 1]
