reprapperMC/mini-hibiscus/production_docs/labels/asset_tag/source/Mini2_AssetTag.pdf

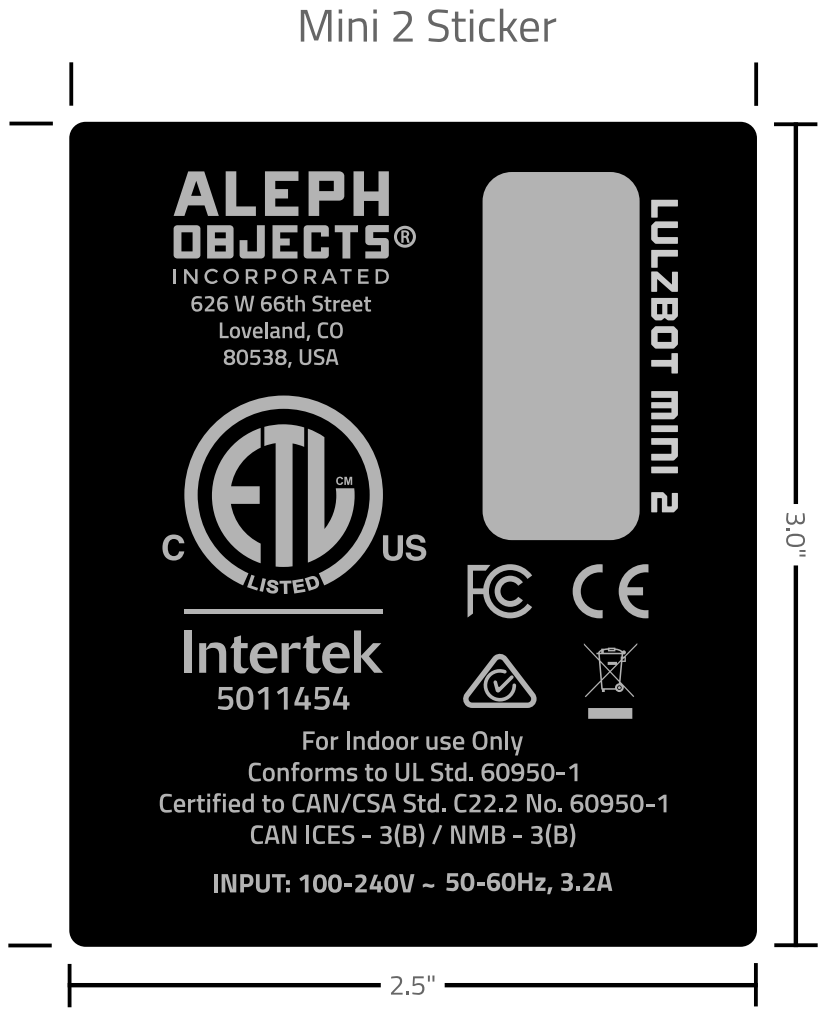
[picture p170: page 1]
