reprapperMC/mini-hibiscus/production_docs/labels/asset_tag/source/Mini2_AssetTag_wSerial.pdf

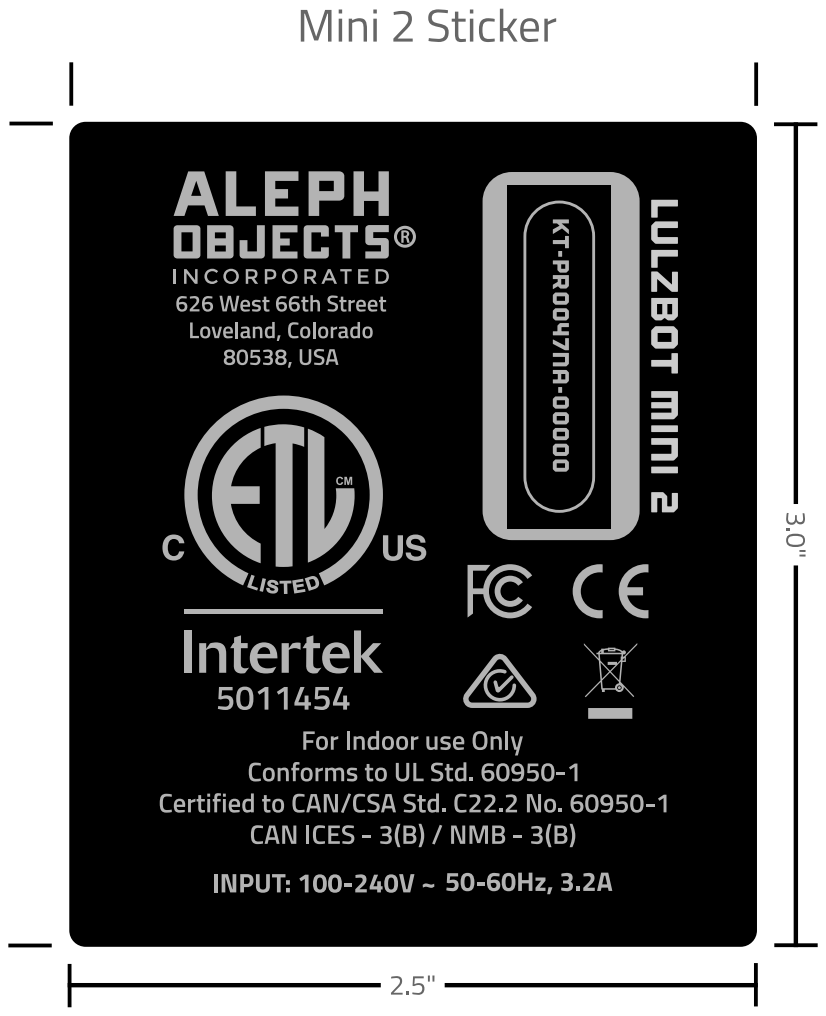
[picture p171: page 1]
