reprapperMC/mini-hibiscus/production_docs/labels/asset_tag/source/Mini2_SerialSticker.pdf

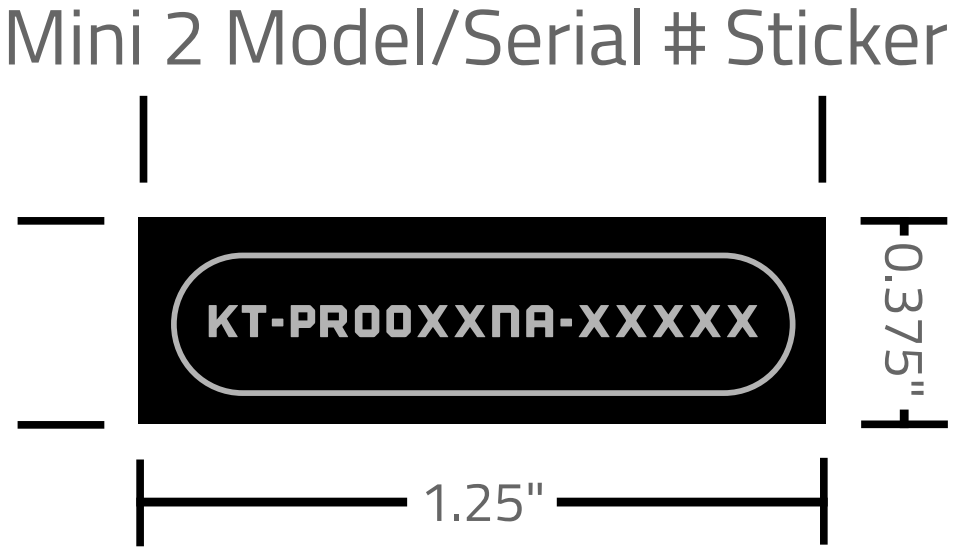
[picture p172: page 1]
