reprapperMC/mini-hibiscus/production_docs/labels/electrial_warning/source/Mini2_ElectricWarning_Tag.pdf

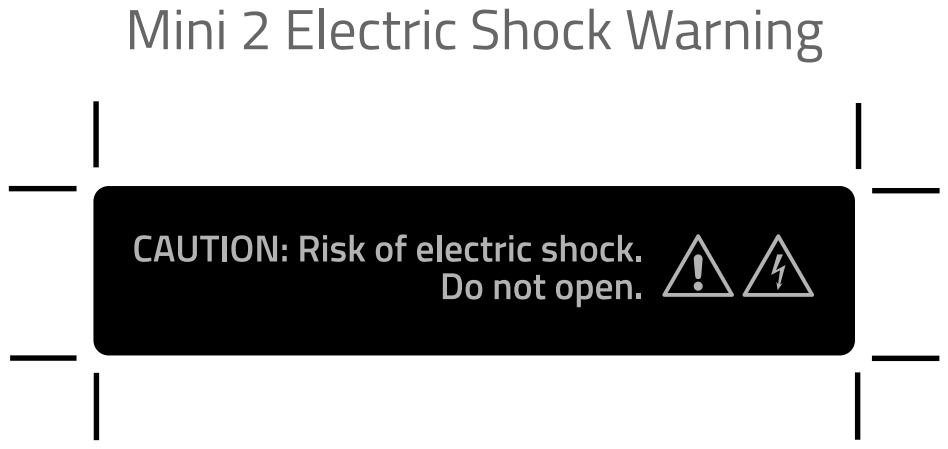
[picture p173: page 1]

Mini 2 Electric Shock Warning
