reprapperMC/mini-hibiscus/production_docs/labels/hot_symbol/Source/hotSymbol_andSize_03.pdf

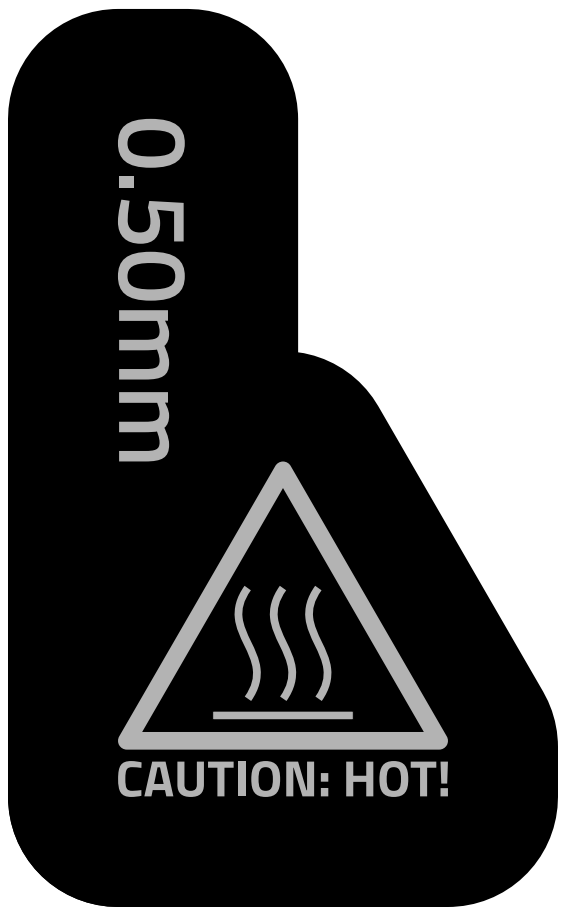
[picture p174: page 1]
