reprapperMC/mini-hibiscus/(commit log)

2017-08-01 Added Z-Belt Driven Mini Parts
    [Idler_spacers.fcstd, Mini2_assem.fcstd, belt_tensioner.stl, belt_tensioning_clamp.fcstd, idler_spacer.stl, x_belt_mount_s.stl, x_belt_tensioner.fcstd, x_carriage.fcstd]
2017-08-08 Added Mini 2 BOM, restructured directory
    [Idler_spacers.fcstd, Mini2_assem.fcstd, belt_tensioner.stl, belt_tensioning_clamp.fcstd, idler_spacer.stl, x_belt_mount_s.stl, x_belt_tensioner.fcstd, x_carriage.fcstd]
2017-09-06 Made Z belt clamp beefier, added new x carriage and extruder mount for titan aero
    [belt_tensioner.stl, belt_tensioning_clamp.fcstd, extruder_mount.fcstd, extruder_mount.stl, x_carriage_s_V2.1.stl, x_carriage_v2.stl]
2017-09-12 Updated X carriage to print bearing housing seperately, updated extruder mount for v5 finch blower shroud
    [extruder_mount.fcstd, extruder_mount.stl, x_bearing_holder.stl, x_belt_tensioner.fcstd, x_carriage.fcstd, x_carriage_v2.stl, x_carriage_v3.stl]
2017-09-18 Updated x carriage and cap to include third mounting hole
    [x_carriage_cap.fcstd, x_carriage_cap_v3.stl, x_carriage_v3.1.stl]
2017-09-18 removed old x carriage parts
    [x_carriage_cap_s_v2.stl, x_carriage_v3.stl]
2017-09-19 Updated belt tensioner stl's
    [belt_tensioner.stl, x_belt_mount_s.stl]
2017-09-20 Added 2 piece spool arm mount
    [spool_mount_a.fcstd, spool_mount_a.stl, spool_mount_b.fcstd, spool_mount_b.stl]
2017-09-21 Added cable drawings for x cable chain and extruder harness. Rearranged files.
    [Idler_spacers.fcstd, Mini2_assem.fcstd, belt_tensioner.stl, belt_tensioning_clamp.fcstd, extruder_mount.fcstd, extruder_mount.stl, idler_spacer.stl, spool_mount_a.fcstd]
2017-09-28 Updated x carriage and cap for molex microfit connector. Updated x harness drawing to reflect molex microfit pinout
    [x_carriage_cap.fcstd, x_carriage_cap_v3.2.stl, x_carriage_v3.2.stl]
2017-09-28 Added extruder cable drawings for molex microfit connector
2017-09-28 Updated X carriage for ease of assembly with molex microfit
    [x_carriage_v3.3.stl]
2017-09-28 updated x bearing holder for improved printability
    [x_bearing_holder_v2.stl]
2017-09-28 Restructured directories, added machined parts, added printed parts that remain the same from gladiola
    [8mmx315_rod_v1.0.fcstd, 8mmx315_rod_v1.0.step, 8x19mm_smooth_rod_revA.fcstd, 8x19mm_smooth_rod_revA.step, 8x19mm_smooth_rod_revB.fcstd, Idler_spacers.fcstd, Mini2_assem.fcstd, bed-mount-plate-mini_PP-MP0146_revC.fcstd]
2017-09-29 added extruder mount with xmax endstop mount (v2.1)
    [extruder_mount_v2.1.stl, extruder_mount_v2.stl]
2017-10-19 Updated BOM, added cable harnesses
2017-10-20 removed nubbin, corrected bed corner for 2 part bed
    [8x19mm_smooth_rod_revA.fcstd, 8x19mm_smooth_rod_revA.step, 8x19mm_smooth_rod_revB.fcstd, bed_corner_mini_2pb.fcstd, bed_corner_mini_2pb.stl, bed_corner_v2.7.fcstd, bed_corner_v2.7.step, bed_corner_v2.7.stl]
2017-10-20 adding printed part numbers
2017-10-20 updating BoM with sub assemblies
2017-10-20 adjusted printed part names to match BOM
    [belt-clamp-mini_black_v1.2.fcstd, belt-clamp-mini_black_v1.2.stl, belt-mount_black_v1.2.fcstd, belt-mount_black_v1.2.stl, belt_tensioner.stl, belt_tensioning_collar.fcstd, x_belt_tensioner.stl, x_carriage_cap_mini2.fcstd]
2017-10-20 Corrected part names on BOM
2017-10-20 adjusted BOM structure
2017-10-20 updating sub assembly
2017-10-20 Updated BOM aero assembly
2017-10-30 Added Mini_2_MBOM to production_docs
    [Mini_2_MBOM.ods]
2017-10-31 adding part numbers to MBOM
    [Mini_2_MBOM.ods]
2017-10-31 updating sub assembly number
    [Mini_2_MBOM.ods]
2017-10-31 Added double-bearing-holder_v1.6 to printed_parts
    Remodeled in current FreeCAD version to clean model tree, bearing bore size decreased from 16.6 to 16.4
    [double-bearing-holder_black_v1.6.fcstd, double-bearing-holder_black_v1.6.stl]
2017-10-31 Add hefty fillets for motor stability
    [z_lower_left_mini2.fcstd, z_lower_left_mini2.stl, z_lower_right.fcstd, z_lower_right_s.stl]
2017-10-31 added double bearing holder with captive self aligning bushing
    [double-bearing-holder_black_v1.5.fcstd, double-bearing-holder_black_v1.5.stl]
2017-10-31 Added STEP file because there was none
    [top-plate-mini_PP-FP0051_revG.step]
2017-10-31 Re-exported STEP for sheetmetal supplier
    [bottom-plate-mini_PP-MP0149_revB.step]
2017-11-01 Added double-bearing-holder_black_v1.7 to printed_parts
    v1.7 includes changes from v1.5 remodeled in FreeCAD 0.17
    [double-bearing-holder_black_v1.7.fcstd, double-bearing-holder_black_v1.7.stl]
2017-11-01 Adjusted extruder pin assignments for molex microfit standard, adjusted extruder motor harness for molex microfit standard, updated x end idler and z belt clamp
    [x_end_idler_v2_mini2.stl, z_belt_clamp.fcstd, z_belt_clamp_v2.stl]
2017-11-01 Increased facets displayed on double-bearing-holder_v1.7 and re-exported .stl
    [double-bearing-holder_black_v1.7.fcstd, double-bearing-holder_black_v1.7.stl]
2017-11-01 Updated double bearing parts to capture self aligning bearings.
    [x_bearing_holder_v3.stl, x_carriage_mini2_v4.stl, x_end_idler_v2_mini2.stl, x_end_motor_v2_mini2.stl]
2017-11-01 Cable harness drawings revised; part numbers added, strip length for microfit reduced
    Removed heater cartridge harness and added hotend assembly with preinstalled cartridge
    Updated extruder pin assignments; removed orrientation label, updated extruder motor harness picture and updated all harness part numbers.
2017-11-02 Added X-end-motor and x-end-idler v2.1
    [x_end_idler_v2.1_mini2.stl, x_end_motor_mini2.stl, x_end_motor_v2.1_mini2.stl, x_end_motor_v2_mini2.stl]
2017-11-06 Added X-End Motor & X-End Idler v2.2
    Reversed positions of precision and self-aligning bushings in front double bearing holder on both parts.
    Precision bushing now goes in from the bottom and the self-aligning bushing in from the top.
    These versions are to test the use of an internal retaining ring for retaining the self-aligning bushing on top.
    They will be supported from below with the retention screw & insert implemented in version 2.1.
    [x_end_idler_v2.2_mini2.stl, x_end_motor_v2.2_mini2.stl]
2017-11-09 rev'd mini 2 sheet metal drawings
    [bed-mount-plate-mini_PP-FP0138_revE.fcstd, bed-mount-plate-mini_PP-FP0138_revE.step, bottom-plate-mini_PP-MP0149_revC.fcstd, electronics-case-mini_PP-FP0139_revI.fcstd, left-side-mini_PP-FP0055_revI.fcstd]
2017-11-10 Rev finch blower shroud for mini2
    [blower_shroud.fcstd, blower_shroud.stl]
2017-11-10 Added step file for electronics case
    [electronics-case-mini_PP-FP0082_revH.stl, electronics-case-mini_PP-FP0139_revI.step]
2017-11-10 Added step files for the bottom and left side mini sheetmetal
    [bottom-plate-mini_PP-MP0149_revC.step, left-side-mini_PP-FP0055_revI.step]
2017-11-10 Added X-end-Idler version 2.3
    Fixes wall thickness on front M3 Bushing Retainer hole, added missing chamfer on rear M3 smooth rod set screw holes as well
    [x_end_idler_v2.3_mini2.stl]
2017-11-14 Added X-Carriage Cap v3.3
    Lengthened cable pathway by 20mm and deepened for better cable fitment
    [x_carriage_cap_mini2_v3.3.fcstd, x_carriage_cap_mini2_v3.3.stl]
2017-11-14 Updated Molex connector housing part number
2017-11-14 Add heatsink assembly drawing
2017-11-14 Applied redline modifications to sheetmetal drawings
    Removed rev letter from part numbers
    Corrected dimension from 3x to 2x on bottom plate pg 1
    Bottom plate pg 2 shelf parallel tolerance increased from .25mm to 1mm
    Added pg 3 to bed mount plate for location of graphics
    Re-removed notes about laser etching from bed mount plate pg 2
    specified "OTHER SIDE" for supplier mark location on bed mount plate pg 2
    called out bottom two holes for a hangpoint on electronics case, pg 1
    [bed-mount-plate-mini_PP-FP0138_revE.fcstd, bottom-plate-mini_PP-MP0149_revC.fcstd, electronics-case-mini_PP-FP0139_revI.fcstd, left-side-mini_PP-FP0055_revI.fcstd, right-side-mini_PP-FP0052_revF.fcstd, top-plate-mini_PP-FP0051_revG.fcstd]
2017-11-14 Adjusted two piece bed corner slice to reduce failure rate
2017-11-14 Repo cleanup, removal of older versions of machined and printed parts
    [bed-mount-plate-mini_PP-MP0146_revC.fcstd, bed-mount-plate-mini_PP-MP0146_revC.step, bed-mount-plate-mini_PP-MP0146_revD.step, bed-plate-mini_PP-MP0146_revD.fcstd, bed_leveling_washer_PP-MP0082_revA.step, bed_leveling_washer_v2.0_PP-MP0082.fcstd, bed_leveling_washer_v2.0_PP-MP0082_rev_IR.step, bottom-plate-mini_PP-MP0149_revB.fcstd]
2017-11-14 Update blower shroud
    [Universal_blower_duct.stl, blower_shroud.fcstd, blower_shroud.stl]
2017-11-16 Added EL-HR0130 90mm Spacer to new production_parts/jigs folder
    [EL-HR0130_90mm_Spacer.fcstd, EL-HR0130_90mm_Spacer.stl]
2017-11-16 Updated x bearing holder to minimize belt rubbing
    [x_bearing_holder_v3.5.stl]
2017-11-17 Add non geared lower mounts
    [z_lower_left_mini2NG.stl, z_lower_left_mini2_NG.fcstd, z_lower_rightNG.fcstd, z_lower_right_sNG.stl]
2017-11-17 Added X-End Idler v2.4 to address https://code.alephobjects.com/T1316
    Deepened Idler nyloc nut pocket by 1.5 mm and increased the chamfer on the Idler bolt head recess by 1mm.
    This should bite the nylon in the nyloc nut better and make sure that the screw head rest flush in the back of the part.
    [x_end_idler_v2.4_mini2.stl]
2017-11-20 Added retaining-ring to printed_parts
    [retaining-ring.fcstd, retaining-ring.stl]
2017-11-20 Updated Z belt clamp to get rid of stress marks when tightening
    [z_belt_clamp.fcstd, z_belt_clamp_v1.1.fcstd, z_belt_clamp_v1.1.stl, z_belt_clamp_v2.stl]
2017-11-21 Added older version of extruder mount for use with EINSY
    [extruder_mount.stl]
2017-11-21 Update universal orientation drawing for correct aero mirrored type
    [AS-HE0026_Universal_Orientation.fcstd]
2017-11-21 Correct orientation of wires and heater block
    [AS-HE0026_Universal_Orientation.fcstd]
2017-11-22 Added X-Carriage Cap v4.1 to address https://code.alephobjects.com/T1295
    Adjustment to edge of carriage near cable pathway for cap fitment, see ticket for complete details.
    https://code.alephobjects.com/T1295
    [x_carriage_mini2_v4.1.stl, x_carriage_mini2_v4.stl]
2017-11-27 Added X-End Idler version 2.5 to address https://code.alephobjects.com/T1316
    M5 Nut Pocket size increased by 100 microns from 8.22 to 8.32 (flat side to flat side) and 1mm chamfer added to M5 Nut entrance.
    See ticket for complete details: https://code.alephobjects.com/T1316
    [x_end_idler_v2.3_mini2.stl, x_end_idler_v2.4_mini2.stl, x_end_idler_v2.5_mini2.stl]
2017-11-28 Update heater length
2017-11-28 Update freecad drawing to reflect pdf drawing
    [AS-HE0026_Universal_Orientation.fcstd]
2017-11-28 Add models for 10:1 geared stepper motor
    [z_lower_left_mini2_g10.fcstd, z_lower_left_mini2_g10.stl, z_lower_right_g10.stl]
2017-11-28 Added gussets to z uppers to prevent flex
    [z_upper_left_mini2_V2.fcstd, z_upper_left_mini2_v2.stl, z_upper_right_mini2_v2.fcstd, z_upper_right_mini2_v2.stl]
2017-11-28 new NG Z lowers to prevent issues with packaging found during drop testing. Also corrects hole locations on right.
    [z_lower_left_mini2NG_v1.1.stl, z_lower_left_mini2_NG_v1.1.fcstd, z_lower_right_sNG_v1.1.stl]
2017-11-28 Drop lower X rod 2.5mm and make motor side rod mounts blind
    [x_bearing_holder_v3.6.stl, x_end_idler_v2.6_mini2.stl, x_end_motor_v2.3_mini2.stl]
2017-11-28 removed V2 z uppers due to intersection with spool mount
    [z_upper_left_mini2_V2.fcstd, z_upper_left_mini2_v2.stl, z_upper_right_mini2_v2.fcstd, z_upper_right_mini2_v2.stl]
2017-11-28 Actually corrected hole locations on right this time
    [z_lower_right_sNG_v1.1.stl]
2017-11-29 Adjusted extruder mount so nozzle sits in same spot as dodo
    [extruder_mount_v2.1.stl, extruder_mount_v2.stl]
2017-11-29 Move extruder mounting hole 3mm forward
    [extruder_mount_v3.fcstd, extruder_mount_v3.stl]
2017-11-29 Shift holes to correct location
    [extruder_mount_v3.fcstd, extruder_mount_v3.stl]
2017-11-30 Correct and update assembly and parts
    [X_end_idler_mini2_v2.step, X_end_motor_mini2_v2.step, bed_corner_mini_2pb.step, bed_standoff.fcstd, bed_standoff.step, double-bearing-holder_black_v1.step, hibiscus_assebled.fcstd, hibiscus_frame_assembled..step]
2017-11-30 Create stl files for updated printed parts
    [x_bearing_holder_v3.6.stl, x_end_idler_v2.6_mini2.stl, x_end_motor_v2.3_mini2.stl]
2017-11-30 new NG z lower right, since prior hole location correction was influenced by improper assembly alignment.
    [z_lower_right_sNG_v1.2.stl]
2017-11-30 Add bump stop for use with stall guard feature
    [bump_stop.fcstd, bump_stop.stl]
2017-11-30 Removed v3 extruder mount
    [extruder_mount_v3.fcstd, extruder_mount_v3.stl]
2017-12-04 Add belt clearance T1411
    [bump_stop.fcstd, bump_stop.stl]
2017-12-04 Resize insert hole T1414
    [x_bearing_holder_v3.6.stl]
2017-12-04 Updated x belt tensioner design
    [x_belt_tensioner.fcstd, x_belt_tensioner.stl, x_belt_tensioner_open_v2.3.stl, x_belt_tensioner_post.fcstd, x_belt_tensioner_post.stl, x_belt_tensioner_v2.fcstd]
2017-12-06 Add supports to z lowers
    [z_lower_left_mini2NG_v1.1.stl, z_lower_left_mini2_NG_v1.1.fcstd, z_lower_right_sNG_v1.1.stl]
2017-12-06 Increased gap for breakaway support for new slice
    [x_carriage_mini2_v4.2.stl]
2017-12-06 Add gusset to z uppers
    [z_upper_left_mini2_v1.fcstd, z_upper_left_mini2_v1.stl, z_upper_right_mini2_v1.fcstd, z_upper_right_mini2_v1.stl]
2017-12-06 Add g-code for automatically leveling the x axis
2017-12-07 Added welding callout
    [bottom-plate-mini_PP-MP0149_revD.fcstd]
2017-12-08 drawing updates - Silk screening and additional feedback.
    [8mmx315_rod_v1.0_revA.fcstd, bed-mount-plate-mini_PP-FP0138_revF.fcstd, bottom-plate-mini_PP-MP0149_revD.fcstd, electronics-case-mini_PP-FP0139_revJ.fcstd, top-plate-mini_PP-FP0051_revH.fcstd]
2017-12-08 clarified welding callout per feedback
    [bottom-plate-mini_PP-MP0149_revD.fcstd]
2017-12-08 new part number
    [electronics-case-mini_PP-FP0147.fcstd]
2017-12-08 corrected name and date on drawing
    [electronics-case-mini_PP-FP0147.fcstd]
2017-12-12 Move z height to 3mm below endstop
2017-12-12 Add variable tension feature to x ends
    [x_end_idler_v2.7_mini2.stl, x_end_motor_v2.4_mini2.stl]
2017-12-13 Updated fork terminal to ring terminal for Y-Axis Motor T1465
2017-12-13 Modify blower for better internal bridging
    [Universal_blower_duct.stl]
2017-12-13 Add brace around fan hole for better bridging
    [Universal_blower_duct.stl]
2017-12-14 removed old revisions of recently updated drawings
    [8mmx315_rod_v1.0.fcstd, 8mmx315_rod_v1.0.step, bed-mount-plate-mini_PP-FP0138_revE.fcstd, bed-mount-plate-mini_PP-FP0138_revE.step, bottom-plate-mini_PP-MP0149_revC.fcstd, bottom-plate-mini_PP-MP0149_revC.step, electronics-case-mini_PP-FP0139_revI.fcstd, electronics-case-mini_PP-FP0139_revI.step]
2017-12-18 Add beefy extruder mount
    [hibiscus_beefy_extruder_mount.fcstd, hibiscus_beefy_extruder_mount.stl]
2017-12-19 Rev'd bearing parts for tighter fit and precision bushings
    [x_bearing_holder_v3.7.stl, x_carriage_mini2_v4.3.stl, x_end_motor_v2.5_mini2.stl]
2017-12-19 Rev'd double bearing holder for tighter fit and precision bushings
    [double-bearing-holder_black_v1.8.fcstd, double-bearing-holder_black_v1.8.step, double-bearing-holder_black_v1.8.stl]
2017-12-19 Rev'd x_end_idler for tighter fit and precision bushings. Re-export double bearing holder STL with better settings.
    [X_end_idler_mini2_v2.8.step, double-bearing-holder_black_v1.8.stl, x_end_idler_v2.8_mini2.stl]
2017-12-19 fixed fillet weirdness
    [double-bearing-holder_black_v1.8.fcstd, double-bearing-holder_black_v1.8.step, double-bearing-holder_black_v1.8.stl]
2017-12-28 Lower holes motor mounting holes to allow better clearance for motor
    [hibiscus_beefy_extruder_mount.fcstd, hibiscus_beefy_extruder_mount.stl]
2017-12-29 scaled back thickest section of mounting wall to allow clearance of gear
    [hibiscus_beefy_extruder_mount.fcstd, hibiscus_beefy_extruder_mount.stl]
2018-01-02 Retained bearings on all reamed out bearing parts
    [double-bearing-holder_black_v1.8.1.fcstd, double-bearing-holder_black_v1.8.1.stl, x_bearing_holder_v3.7.1.stl, x_carriage_mini2_v4.3.1.stl, x_end_idler_v2.8.1_mini2.stl, x_end_motor_v2.5.1_mini2.stl]
2018-01-03 Open nyloc nut hole for better fit
    [x_end_idler_v2.8.1_mini2.stl, x_end_motor_v2.5.1_mini2.stl]
2018-01-04 Resave stl for x idler
    [x_end_idler_v2.8.1_mini2.stl]
2018-01-08 updated retention ring, adjusted x belt tensioner
    [retaining-ring_v2.fcstd, retaining-ring_v2.stl, x_belt_tensioner_open_v3.stl, x_belt_tensioner_v2.fcstd, x_belt_tensioner_v3.fcstd, x_carriage_v4.3.1.step]
2018-01-08 Updated MINI2 MBOM
    [Mini_2_MBOM.ods]
2018-01-09 corrected HD-MS0190 to HD-BT0039 in MBOM
    [Mini_2_MBOM.ods]
2018-01-09 Add test folder with new x carriage and beefy extruder mount
    [Beefy_extruder_mount_v2.fcstd, Minii_x_carriage_V2.fcstd, Minii_x_carriage_V2.stl, beefy_extruder_mount_v2.stl]
2018-01-10 added in-progress reaming fixtures for precision bushings
    [double-bearing-holder_reaming_assembly.fcstd, reaming_base.fcstd, reaming_top_double-bearing-holder.fcstd, reaming_top_x_bearing_holder.fcstd, reaming_top_x_carriage.fcstd, reaming_top_x_end_idler.fcstd, reaming_top_x_end_motor.fcstd, x_bearing_holder_reaming_assembly.fcstd]
2018-01-10 Add x carriage cap to test folder
    [Minii_x_carriage_V2.fcstd, Minii_x_carriage_V2.stl, extruder_screw_cap.fcstd, extruder_screw_cap.stl, minii_X_carriage_cap_v2.fcstd, minii_X_carriage_cap_v2.stl]
2018-01-10 added vacuum attachment for reaming tops and base.
    [double-bearing-holder_reaming_assembly.fcstd, reaming_base.fcstd, reaming_top_double-bearing-holder.fcstd, reaming_top_x_bearing_holder.fcstd, reaming_top_x_carriage.fcstd, x_bearing_holder_reaming_assembly.fcstd, x_carriage_reaming_assembly.fcstd]
2018-01-10 redesigned x end reaming fixtures, added vacuum
    [reaming_top_x_end_idler.fcstd, reaming_top_x_end_idler.stl, reaming_top_x_end_motor.fcstd, reaming_top_x_end_motor.stl, x_end_idler_reaming_assembly.fcstd, x_end_motor_reaming_assembly.fcstd]
2018-01-10 Getting MBoM into OCA
    [Mini_2_MBOM.ods]
2018-01-10 updating MBoM
    [Mini_2_MBOM.ods]
2018-01-10 added STL files for reaming fixtures
    [reaming_base.stl, reaming_top_double-bearing-holder.stl, reaming_top_x_bearing_holder.stl, reaming_top_x_carriage.stl]
2018-01-10 MBoM -> OCA updates
    [Mini_2_MBOM.ods]
2018-01-10 MBoM updates to OCA
    [Mini_2_MBOM.ods]
2018-01-11 MBoM Edits to OCA
    [Mini_2_MBOM.ods]
2018-01-12 Added z compression bushing test report
2018-01-15 corrected bearing retaining screw/insert holes on x idler
    [x_end_idler_v2.8.1_mini2.stl]
2018-01-16 Change air exit slots to be a little smaller
    [Universal_blower_duct_V1.stl]
2018-01-16 added Z brake mount
    [z_brake_mount.fcstd, z_brake_mount.stl]
2018-01-16 adding flat BoM
    [hibiscus_FlatBoM_1.16.18.ods]
2018-01-16 updating flat BoM
    [hibiscus_FlatBoM_1.16.18.ods]
2018-01-17 moved z brake mount to printed parts
    [z_brake_mount.fcstd, z_brake_mount.stl]
2018-01-17 Add brake board cable drawing
2018-01-17 Add dolores electric brake submodule
2018-01-17 Update strip length for motor jumper
2018-01-18 Updated spool arm support halves to correct fit and function T1510
    [spool_mount_a_v1.5.fcstd, spool_mount_a_v1.5.stl, spool_mount_b_v1.5.fcstd, spool_mount_b_v1.5.stl]
2018-01-19 Added heatsink for trinamic drivers on einsy board
    [heatsink_einsy_PP-MP0210.fcstd, heatsink_einsy_PP-MP0210.step]
2018-01-22 Update titan aero block orientation drawing
    [AS-HE0026_Universal_Orientation.fcstd, extruder_screw_cap.fcstd, extruder_screw_cap.stl]
2018-01-22 Change position of center bushing and tension screws on x idler
    [x_end_idler_v2.8.2_mini2.stl]
2018-01-22 Adjusted retaining ring slots in double bearing and x bearing holders
    [double-bearing-holder_black_v1.8.1.fcstd, double-bearing-holder_black_v1.8.2.fcstd, double-bearing-holder_black_v1.8.2.stl, x_bearing_holder_v3.7.2.stl]
2018-01-22 Add beveled edges for better printing add x end motor with adjusted vr bearing location
    [x_end_idler_v2.8.2_mini2.stl, x_end_motor_v2.5.2_mini2.stl]
2018-01-22 Add pdf and odg drawing for universal orientation
    [AS-HE0026_Universal_Orientation.fcstd]
2018-01-23 Add new clamp post
    [minii_x_clamp_post.fcstd, minii_x_clamp_post.stl]
2018-01-23 Add belt mount
    [minii_belt_mount.fcstd, minii_belt_mount.stl]
2018-01-23 Fix broken files
    [x_end_idler_v2.8.2_mini2.stl, x_end_motor_v2.5.2_mini2.stl]
2018-01-24 Added embeefened bed corners for modular bed system T1707
    [bed_corner_mini_2pb_v2.fcstd, bed_corner_mini_2pb_v2.stl]
2018-01-25 Added Masking for einsy heatsink to left plate
    [left-side-mini_PP-FP0055_revI.fcstd, left-side-mini_PP-FP0055_revI.step, left-side-mini_PP-FP0055_revJ.fcstd]
2018-01-25 Add x end stl's, adjust double bearing holder for printability
    [double-bearing-holder_black_v1.8.2.fcstd, x_end_idler_v2.8.2_mini2.stl, x_end_motor_v2.5.2_mini2.stl]
2018-01-25 Added heatsink frame
    [einsy_heatsink_frame.fcstd, einsy_heatsink_frame.stl]
2018-01-25 Added Z Lowers v1.5 to printed parts, addresses T1737
    [z_lower_left_mini2_v1.5.stl, z_lower_right_mini2_v1.5.stl]
2018-01-29 Add lcd parts and directory in production parts
    [8mm_spacer.fcstd, LCD.fcstd, LCD_Mini_bracket_RIGHT.fcstd, LCD_Mini_bracket_RIGHT.stl, LCD_case_v3.1.fcstd, LCD_spacer.fcstd, M3_insert.fcstd, Mini_LCD_assembled.fcstd]
2018-01-29 Cut out circle from cover spacer so knob can be depressed fully
    [cover_spacer.fcstd, cover_spacer.stl]
2018-01-29 Move knob cutout
    [cover_spacer.fcstd, cover_spacer.stl]
2018-01-29 Add screw covers to cover spacer to help with esd
    [cover_spacer.fcstd, cover_spacer.stl]
2018-01-29 Added Heatsink Thermal Gap Filler Test data
    [Thermal_gap_filler_drawing.fcstd]
2018-01-29 removed bad heatsink test images
2018-01-30 changed board-side fan connector housings to 3-pin versions
2018-01-30 Update cover naming to reduce confusion
    [cover_spacer.fcstd, cover_spacer.stl, lcd_cover_m.dxf, lcd_cover_m.fcstd, lcd_cover_m.step]
2018-01-30 Removed x max switch cables from toolhead wiring
2018-01-30 updated MBOM and z brake cable drawings
    [Mini_2_MBOM.ods]
2018-01-31 Update lcd drawings to address red lines
    [lcd_cover_m.dxf, lcd_cover_m.fcstd]
2018-01-31 Change tolerances
    [lcd_cover_m.fcstd]
2018-01-31 Add missing dimension
    [lcd_cover_m.fcstd]
2018-01-31 Add powder coat color to notes on drawing
    [lcd_cover_m.dxf, lcd_cover_m.fcstd, lcd_cover_m.step]
2018-02-06 Update lcd assembly
    [Mini_LCD_assembled.fcstd, lcd_cover_m.fcstd]
2018-02-06 Add new blower duct for better cooling
    [blower_duct_v2.stl]
2018-02-07 Updated Hibiscus assembly and updated assembly files
    [40mm_fan.step, 51mm_blower.step, 608_bearing.fcstd, 608_bearing.step, 625_bearing.fcstd, 8mmx315_rod_v1.0_revA.step, EInsy_assem.fcstd, Idler_spacers.fcstd]
2018-02-07 Update Mini2 MBOM in production_docs according to T1784
    [Mini_2_MBOM.ods]
2018-02-08 WIP final pre-production revs of sheet metal drawings
    [bed-mount-plate-mini_PP-FP0138_revG.fcstd, bottom-plate-mini_PP-MP0149_revE.fcstd, electronics-case-mini_PP-FP0147_RevA.fcstd, left-side-mini_PP-FP0055_revK.fcstd, right-side-mini_PP-FP0052_revG.fcstd]
2018-02-08 added graphics files for bed mount plate silk screen
2018-02-08 Updated hibiscus assembly with fasteners
    [50mm_blower.fcstd, 51mm_blower.step, 80MM_FAN.fcstd, M2X10SHCS.fcstd, M2X6SHCS.fcstd, M2_washer.fcstd, M3_washer.fcstd, M3x10FHCS.fcstd]
2018-02-09 Added Beefier x bearing holder for T1923 and updated assembly
    [x_bearing_holder_V3.7.3.step, x_bearing_holder_v3.7.3.stl, x_carriage.fcstd]
2018-02-09 updated x_bearing_holder reaming fixture for v3.7.3
    [reaming_top_x_bearing_holder.fcstd, reaming_top_x_bearing_holder_v3.7.3.fcstd, x_bearing_holder_reaming_assembly.fcstd]
2018-02-09 added x bearing holder reaming fixture stl
    [reaming_top_x_bearing_holder_v3.7.3.stl]
2018-02-09 changed board power connectors to fork terminals for einsy, added heat shrink offset note to x extruder harness
2018-02-09 moved old model files to ATTIC
    [Beefy_extruder_mount_v2.fcstd, Minii_x_carriage_V2.fcstd, Minii_x_carriage_V2.stl, Universal_blower_duct.stl, Universal_blower_duct_V1.stl, X_end_idler_mini2_v2.8.step, X_end_idler_mini2_v2.step, X_end_motor_mini2_v2.step]
2018-02-12 Update chassis assembly electrical drawings
2018-02-12 Replaced RAMBo power harness with wires for EinsyRetro power
2018-02-12 Added weights for printed parts to BOM.
    [Mini_2_MBOM.ods]
2018-02-12 Added more weights to mini BOM
    [Mini_2_MBOM.ods]
2018-02-12 added missing drawings for supplied components per T1712
    [smooth_idler_pully_wheel_HD-MS0412.fcstd]
2018-02-12 Added some assembly part numbers
    [Mini_2_MBOM.ods]
2018-02-13 Updated printed part weights
    [Mini_2_MBOM.ods]
2018-02-13 Production revs of sheet metal drawings
    [bed-mount-plate-mini_PP-FP0138_revF.fcstd, bed-mount-plate-mini_PP-FP0138_revF.step, bed-mount-plate-mini_PP-FP0138_revG.fcstd, bed-mount-plate-mini_PP-FP0138_revG.step, bottom-plate-mini_PP-MP0149_revD.fcstd, bottom-plate-mini_PP-MP0149_revE.fcstd, bottom-plate-mini_PP-MP0149_revE.step, electronics-case-mini_PP-FP0147.fcstd]
2018-02-13 Adjusted shoulder height on x bearing holder reaming fixture mount holes T1947
    [reaming_top_x_bearing_holder_v3.7.3.fcstd, reaming_top_x_bearing_holder_v3.7.3.stl, reaming_top_x_bearing_holder_v3.7.4.fcstd, reaming_top_x_bearing_holder_v3.7.4.stl]
2018-02-13 Updated MBOM for new cable harnesses T1784
    [Mini_2_MBOM.ods]
2018-02-13 Updated assembly part numbers and some Sub layer numbering
    [Mini_2_MBOM.ods]
2018-02-13 Added inserts drawings/assemblies
    [belt_mount_inserts.fcstd, blower_duct_inserts.fcstd, double_bearing_holder_inserts_nonswitch_side.fcstd, double_bearing_holder_inserts_switch_side.fcstd, extruder_mount_inserts.fcstd, handle_bar_inserts.fcstd, spool_arm_bracket_inserts.fcstd, spool_mount_a_inserts.fcstd]
2018-02-14 Replace bed leveling washer with production version from Olive per T1949
    [bed_leveling_washer_revA.fcstd, bed_leveling_washer_v2.0_PP-MP0082_revA.fcstd, bed_leveling_washer_v2.0_PP-MP0082_revA.step]
2018-02-14 Update top plate width tolerance to match new tolerance of bottom plate T1952
    [top-plate-mini_PP-FP0051_revH.fcstd, top-plate-mini_PP-FP0051_revI.fcstd, top-plate-mini_PP-FP0051_revI.step]
2018-02-14 Added Z End matched pairs to printed_parts
    [Left_Pair_v0.2.fcstd, Left_Pair_v0.2.stl, Right_Pair_v0.2.fcstd, Right_Pair_v0.2.stl]
2018-02-14 Updated sub layers and corrected part numbers
    [Mini_2_MBOM.ods]
2018-02-15 Added LCD mounting hardware to MBOM T1784
    [Mini_2_MBOM.ods]
2018-02-15 Rev'd e3d universal orientation drawing to include 40W heater cartridge
2018-02-15 Corrected structure numbering; LCD harness brackets T1784
    [Mini_2_MBOM.ods]
2018-02-15 Added Mini 2 part number notes and Certification sticker part number
    [Mini_2_MBOM.ods]
2018-02-15 Updated LCD assembly with differnt LCD cover and assembly number
    [Mini_2_MBOM.ods]
2018-02-15 Updated Nylon cover part number to the correct one
    [Mini_2_MBOM.ods]
2018-02-15 Overall profile tolerance to 3D model per T1950, adjustments to front graphic per T1951
    [electronics-case-mini_PP-FP0147_RevA.fcstd]
2018-02-16 Corrected the E3d hotend assembly to the Universal one instead of Mini 1
    [Mini_2_MBOM.ods]
2018-02-16 Updated sublayering, and added part HD-MS0463 to AS-PR0092
    [Mini_2_MBOM.ods]
2018-02-20 Updated Thermal Gap Filler Drawing
    [Thermal_gap_filler_drawing.fcstd]
2018-02-20 Updated MBOM with Mini 2 toolkit, adjusted heatbed assembly T1784
    AS-PR0100 removed from AS-PR0093; replaced with AS-HB0001 & AS-HB0008
    Imported AS-PK0029 from OCA; Mini 2 toolkit changes
    [Mini_2_MBOM.ods]
2018-02-22 Updates all gcode in the printed parts directory for mini 2 for beta unit production
    [bed_clip_v3.fcstd, bed_clip_v3.step, bed_clip_v3.stl, bed_corner_mini_2pb.fcstd, bed_corner_mini_2pb.stl, belt-clamp-mini_black_v1.2.fcstd, belt-clamp-mini_black_v1.2.stl, belt-mount_black_v1.2.fcstd]
2018-02-22 Update the slice for PP-GP0320 x carriage cap for mini 2
2018-02-22 Update the slice for PP-GP0231 wiper mount for mini2 beta builds
2018-02-22 Updates slice for PP-GP0308 z belt clamp for mini hibiscus
2018-02-22 Updated drawing for titan injection molded parts.
2018-02-22 Update stepper brake fork terminal type
2018-02-22 Add new y rod mount for better nyloc seating
    [Y_rod_mount_v2.fcstd, Y_rod_mount_v2.stl]
2018-02-22 Update drawing to specify connector orientation
2018-02-22 Update lcd cable drawings to clarify orientation of connector location of pin one and profile view
2018-02-26 Updated MBOM PNs to conform to prefix conventions, other additions; T1799
    [Mini_2_MBOM.ods]
2018-02-26 Correct connector orientation
2018-02-27 Update thermal gap filler to include cleaning and change y rod mount to use current hardware
    [Thermal_gap_filler_drawing.fcstd, Y_rod_mount_v2.fcstd, Y_rod_mount_v2.stl]
2018-02-28 Updated X level gcode to turn off soft stops, raised current 100mA
2018-02-28 Added force gauge attachment
2018-02-28 adjusted reaming fixture for x end motor
    [reaming_top_x_end_motor.fcstd, reaming_top_x_end_motor.stl]
2018-03-01 adjusted left side drawing p4 heatsink masking tolerance
    [left-side-mini_PP-FP0055_revK.fcstd]
2018-03-01 Corrected MBOM location for AS-CB0082 part number change from EL-HR0118 T1799
    [Mini_2_MBOM.ods]
2018-03-02 added milled reaming base
    [Mirrored_Aero.fcstd, reaming_base_milled.fcstd, reaming_base_milled.step, reaming_base_milled_path.fcstd]
2018-03-02 added etched mini modular bed
    [Mini_pad_drwng.fcstd]
2018-03-02 adjusted heatsink thermal gap filler drawing
2018-03-02 Part number updates for several cables to match proper naming conventions
2018-03-02 Added FreeCAD path and G-code for reaming base
    [reaming_base_milled_path.fcstd]
2018-03-05 Remove M84 from end gcode to prevent nozzle from falling into print
2018-03-05 Corrected a part number in the MBOM T1799
    [Mini_2_MBOM.ods]
2018-03-05 updated part numbers per T1806
    [belt_mount_inserts.fcstd, double_bearing_holder_inserts_nonswitch_side.fcstd, double_bearing_holder_inserts_switch_side.fcstd, handle_bar_inserts.fcstd, spool_arm_bracket_inserts.fcstd, x_carriage_inserts.fcstd, y_axis_rod_mount_inserts.fcstd]
2018-03-06 Updated extruder assembly with new part numbers for extruder mount and blower duct T1799
    [Mini_2_MBOM.ods]
2018-03-08 Make mounting holes larger to account for m3 washers
    [minii_X_carriage_cap_v2.fcstd, minii_X_carriage_cap_v2.stl]
2018-03-08 Cut out sections so alignment on frame can occur
    [top_cable_bracket.fcstd, top_cable_bracket.stl]
2018-03-09 Updated MBOM, multiple fixes & part number changes T1799
    [Mini_2_MBOM.ods]
2018-03-09 moved hot tightening drawing, renamed heatsink folder
    [AS-HE0026_Universal_Orientation.fcstd, Thermal_gap_filler_drawing.fcstd]
2018-03-09 Added Scotchbrite to toolkit T1799
    [Mini_2_MBOM.ods]
2018-03-12 Added LCD spacer printed part
    [Mini_2_MBOM.ods]
2018-03-14 Updated LCD harness part number AS-CB0083, AS-CB0084 T1799
    [Mini_2_MBOM.ods]
2018-03-14 Updates slice for mini x carriage cap PP-GP0320 to meet quality standards
2018-03-15 added material around nylock pocket for x end idler T2045
    [x_end_idler_v2.8.3_mini2.stl]
2018-03-15 Update pinout for one of the Z motors per T1806
2018-03-15 Remove old ribbon cable add new black ribbon cable
2018-03-15 Revert "Updates all gcode in the printed parts directory for mini 2 for beta unit production"
    This reverts commit 70c38c4ee4ff323854c8e1e13bd3891f57a95082.
    [bed_clip_v3.fcstd, bed_clip_v3.step, bed_clip_v3.stl, bed_corner_mini_2pb.fcstd, bed_corner_mini_2pb.stl, belt-clamp-mini_black_v1.2.fcstd, belt-clamp-mini_black_v1.2.stl, belt-mount_black_v1.2.fcstd]
2018-03-16 Added remaining inserts assemblies and drawings
    [LCD_bracket_inserts.fcstd, LCD_case_inserts.fcstd, LCD_side_cable_bracket_inserts.fcstd, LCD_top_cable_bracket_inserts.fcstd, upper_strain_relief_inserts.fcstd, x_bearing_holder_inserts.fcstd]
2018-03-16 updated spool arm bracket inserts drawing
2018-03-16 Added note for length of wires from ferrite to board side connector housing
2018-03-16 bed corner polyflex testing
    [polyflexy-bedcorner-testing.ods]
2018-03-16 Updated AS-TH0066 to include HD-MS0446 per T1799
    [Mini_2_MBOM.ods]
2018-03-16 added updated LCD top cable bracket to master branch
    [top_cable_bracket.fcstd, top_cable_bracket.stl]
2018-03-16 updated LCD top cable bracket inserts drawing for T1806
2018-03-16 updated LCD top cable bracket insert assem
    [LCD_top_cable_bracket_inserts.fcstd]
2018-03-16 updated x carriage reaming top and assembly
    [reaming_top_x_carriage.fcstd, reaming_top_x_carriage.stl, x_carriage_reaming_assembly.fcstd]
2018-03-19 Updated LCD top cable bracket so text doesn't go off page
2018-03-19 Add scratch spec and update material
    [lcd_cover_m.dxf, lcd_cover_m.fcstd]
2018-03-19 removed proprietary message from inserts drawings T2131
2018-03-19 Updates the slice for AS-PR0095 x end idler for mini 2
2018-03-19 Update drawing to have different wording
    [lcd_cover_m.fcstd]
2018-03-19 Update drawing to have higher tolerance
    [lcd_cover_m.fcstd]
2018-03-20 Adjusts the x bearing holder slice for better bed positioning
2018-03-20 Add production gcode for cable bracket clearance change
2018-03-20 Added multiple production jigs to Production_parts/jigs T1787
    [Hibiscus_tie-down_jig.fcstd, Hibiscus_tie-down_jig.stl, X-MIN_WRAP_JIG.fcstd, X-MIN_WRAP_JIG.stl, X-Motor_Pulley-Spacer_6mm.stl, X-Motor_PulleySpacer_6mm.fcstd, Y-Motor_PulleySpacer_2mm.fcstd, Y-Motor_PulleySpacer_2mm.stl]
2018-03-21 updated x ends for compression washer fit and better compressability
    [x_end_idler_v2.8.4_mini2.stl, x_end_motor_v2.5.3_mini2.stl]
2018-03-21 Updated Toolkit & document bag per T1799
    [Mini_2_MBOM.ods]
2018-03-21 Update aerostruder v2 assembly to have filament alignment
    [40mm_fan.fcstd, 50mm_blower.fcstd, aerostruder_v2.fcstd]
2018-03-21 Make assembly a MUX
    [aerostruder_v2.fcstd]
2018-03-21 z shipping gcode added to sample prints/calibration T1813
2018-03-21 Updated packaging section of BOM with current label & foam p#s T1799
    [Mini_2_MBOM.ods]
2018-03-22 Updated X-End Motor gcode T2044 T2045
2018-03-22 Returned filament sample bag & label to packaging T1799
    [Mini_2_MBOM.ods]
2018-03-22 Adjusted X idler for better compressability for T2105
    [x_end_idler_v2.8.5_mini2.stl]
2018-03-22 updated x level g code to not drop motor current during leveling
2018-03-22 Added reamer handle to production_parts/jigs T1787
    [ReamerHandle.fcstd, ReamerHandler.stl]
2018-03-22 Change file name to reflect harness length and current rev, change cable length to 230mm T1806
2018-03-23 Added v2 Aero PinionGear Spacer to Production_parts/jigs T1787
    [v2Aero_PinionGear-Spacer.stl]
2018-03-23 Updated QA checklist to reflect y-belt tension 23-27 newtons T2164.
2018-03-23 Updated v2 Aero PinionGear-Spacer for error in model T1787
    [v2Aero_PinionGear-Spacer.stl]
2018-03-23 Updated X-End Idler v2.8.5 gcode T2045 T2105
2018-03-23 Moving old freecad and stl files to attic
    [x_end_idler_v2.8.2_mini2.stl, x_end_idler_v2.8.3_mini2.stl, x_end_idler_v2.8.4_mini2.stl]
2018-03-23 Added v2Aero_Octopus_Calibration_PLA.gcode to sample_prints/calibration T1813
2018-03-28 Address screw interference noted in T2239
    [Beefy_extruder_mount_v2.1.fcstd, beefy_extruder_mount_v2.1.stl]
2018-03-28 Update hotend drawing to have correct part number and orientation
2018-03-28 Added a newton value when checking the x-belt tension.
2018-03-28 Adjusts slice for PP-GP0307 Belt tension collar to improve ease of use
2018-03-29 Adjusted x end idler to have more material around upper x rod T2244
    [x_end_idler_v2.8.6_mini2.stl]
2018-03-29 updated fcstd file for x idler
2018-04-02 Added z lowers with adjustable rod
    [z_lower_left_adjustable.stl, z_lower_right_adjustable.stl]
2018-04-02 Updated slice for AS-PR0095 x end idler for mini2 v 2.8.6
2018-04-02 Address T2299 screw dragging on rod
    [Mini_2_MBOM.ods]
2018-04-02 Added updated octopus calibration gcode to sample_prints/calibration T1813
2018-04-03 Replaced HD-BT0137 on PP-IS0060 with HD-BT0140 per T2299 T1799
    [Mini_2_MBOM.ods]
2018-04-03 Remove 2 POS term block from MBOM T1799
    [Mini_2_MBOM.ods]
2018-04-03 Added X-Idler_BearingHelper to production_parts/jigs T1787
    [X-Idler_BearingHelper.fcstd, X-Idler_BearingHelper.stl]
2018-04-05 Updated HD-BL0015 to HD-BL0033 to reflect GT2 to GT3 update per T2331 T1799
    [Mini_2_MBOM.ods]
2018-04-05 Added CertificationStickerPlacement jig to Production_parts/jigs T1787
    [CertStickerPlacement.fcstd, CertStickerPlacement.stl]
2018-04-06 Update slice for PP-GP0341 extruder mount for mini2
2018-04-06 Move all assembly folders into one master assembly folder T1898
    [40mm_fan.fcstd, 40mm_fan.step, 50mm_blower.fcstd, 608_bearing.fcstd, 608_bearing.step, 625_bearing.fcstd, 80MM_FAN.fcstd, EInsy_assem.fcstd]
2018-04-06 Move smooth ideler pulley to the correct repo file under machined parts T1898
    [smooth_idler_pully_wheel_HD-MS0412.fcstd]
2018-04-06 Remove these files from Production parts file T1898
    [40mm_fan.fcstd, 40mm_fan.step, 50mm_blower.fcstd, 608_bearing.fcstd, 608_bearing.step, 625_bearing.fcstd, 80MM_FAN.fcstd, EInsy_assem.fcstd]
2018-04-06 Removed this file from Production Parts file, to reorganize T1898
    [M2X10SHCS.fcstd, M2X6SHCS.fcstd, M2_washer.fcstd, M3_washer.fcstd, M3x10FHCS.fcstd, M3x12BHCS.fcstd, M3x12SHCS.fcstd, M3x8BHCS.fcstd]
2018-04-06 Removed from Production file to reorganize T1898
    [LCD_bracket_inserts.fcstd, LCD_case_inserts.fcstd, LCD_side_cable_bracket_inserts.fcstd, LCD_top_cable_bracket_inserts.fcstd, belt_mount_inserts.fcstd, blower_duct_inserts.fcstd, double_bearing_holder_inserts_nonswitch_side.fcstd, double_bearing_holder_inserts_switch_side.fcstd]
2018-04-06 Remove formed part file from Production Parts, moved into Machined parts T1898
    [smooth_idler_pully_wheel_HD-MS0412.fcstd]
2018-04-06 Move Hibiscus Assembled free cad files to Assemblies folder T1898
2018-04-06 Add LCD machined parts folder T1898
    [lcd_cover_m.dxf, lcd_cover_m.fcstd, lcd_cover_m.step, plastic_laser_cut_lcd_cover.fcstd, plastic_laser_cut_lcd_cover.step]
2018-04-06 Add Modular bed etched file T1898
    [Mini_pad_drwng.fcstd]
2018-04-06 Remove Modular Bed files from main production parts file T1898
    [8mm_spacer.fcstd, LCD.fcstd, LCD_Mini_bracket_RIGHT.fcstd, LCD_Mini_bracket_RIGHT.stl, LCD_case_v3.1.fcstd, LCD_spacer.fcstd, M3_insert.fcstd, Mini_LCD_assembled.fcstd]
2018-04-06 Move LCD assembly to correct location T1898
    [8mm_spacer.fcstd, LCD.fcstd, LCD_spacer.fcstd, M3_insert.fcstd, Mini_LCD_assembled.fcstd]
2018-04-06 Add LCD printed parts file to correct locations T1898
    [LCD_Mini_bracket_RIGHT.fcstd, LCD_Mini_bracket_RIGHT.stl, LCD_case_v3.1.fcstd, Mini_LCD_case_v3.1.stl, Mini_lcd_bezel_spacer.fcstd, Mini_lcd_bezel_spacer.stl, cover_spacer.fcstd, cover_spacer.stl]
2018-04-06 Remove fixtures from Production Parts folder T1898
    [double-bearing-holder_reaming_assembly.fcstd, reaming_base.fcstd, reaming_base.stl, reaming_base_milled.fcstd, reaming_base_milled.step, reaming_base_milled_path.fcstd, reaming_top_double-bearing-holder.fcstd, reaming_top_double-bearing-holder.stl]
2018-04-06 Move fixtures folder to proper location in repo T1898
    [double-bearing-holder_reaming_assembly.fcstd, reaming_base.fcstd, reaming_base.stl, reaming_base_milled.fcstd, reaming_base_milled.step, reaming_base_milled_path.fcstd, reaming_top_double-bearing-holder.fcstd, reaming_top_double-bearing-holder.stl]
2018-04-11 Update Electrioics case part number to PP-FP0147 T1799
    [Mini_2_MBOM.ods]
2018-04-11 Add tension collar with belt slack spot
    [belt_tensioner_v1.stl, belt_tensioning_collar_v1.fcstd]
2018-04-12 Add z-rod spacing jig .fcstd
    [z-top_gauge.fcstd]
2018-04-12 Move gauge files to gauge dir
    [z-top_gauge.fcstd]
2018-04-12 Add thicker z belt clamps
    [z_belt_clamp_v1.2.fcstd, z_belt_clamp_v1.2.stl]
2018-04-12 Reverted a couple of silk screen dimension changes T1806
    [electronics-case-mini_PP-FP0147_RevA.fcstd, electronics-case-mini_PP-FP0147_RevB.fcstd, electronics-case-mini_PP-FP0147_RevB.step]
2018-04-12 Add wider Z-Belt Clamp v1.3 with extended teeth T2356
    [z_belt_clamp_v1.3.fcstd, z_belt_clamp_v1.3.stl]
2018-04-12 reverted an additional silk screen location dimension
    [electronics-case-mini_PP-FP0147_RevB.fcstd]
2018-04-12 Fixed internal face error on Z-Belt Clamp v1.3 T2356 T2355
    [z_belt_clamp_v1.3.fcstd, z_belt_clamp_v1.3.stl]
2018-04-12 Shorten collar
    [belt_tensioner_v1.stl, belt_tensioning_collar_v1.fcstd]
2018-04-13 Added z top gauge v2
    [z_top_gauge_v2.fcstd, z_top_gauge_v2.step]
2018-04-13 Adjust belt collar slot size to prevent belt from pulling out
    [belt_tensioner_v1.1.stl, belt_tensioning_collar_v1.1.fcstd]
2018-04-13 Updates slice for PP-GP0308 Z belt clamp v1.3 T2355
2018-04-17 Updates slice for PP-GP0307 belt tensioning collar v1.1
2018-04-17 Move old files and ATTIC directories
    [z_upper_left_mini2.fcstd, z_upper_left_mini2.stl]
2018-04-17 Move old versions and ATTIC directories
    [z_upper_right_mini2.fcstd, z_upper_right_mini2.stl]
2018-04-17 Added Z-Belt Tension Measurement gcode to sample_prints/calibration T1813
2018-04-17 updated fork terminal connectors T1806
2018-04-17 replaced old reaming base files with updated ones for higher quality results
    [long_reaming_base_milled.fcstd, long_reaming_base_milled_path_holes.fcstd, long_reaming_base_milled_path_pocket.fcstd, reaming_base.fcstd, reaming_base.stl, reaming_base_milled.fcstd, reaming_base_milled.step, reaming_base_milled_path.fcstd]
2018-04-17 Updated MBOM with changes to Z-Uppers/Lowers, Black ribbon cables, green extruder mount, and fork terminals for AS-CB0069 per T1799
    [Mini_2_MBOM.ods]
2018-04-19 Modified X-Level gcode; Returned motor current to 600mA and move tool head to right before leveling T2179 T1813
2018-04-19 Modified Z-Belt measure gcode with changes to X-level gcode T1813
2018-04-20 Updated belt tension collar to actual belt thickness, version 1.2 T2166 T2359
    [belt_tensioner_v1.2.stl, belt_tensioning_collar_v1.2.fcstd]
2018-04-23 Adjusted x belt tensioner post for T2403
    [minii_x_clamp_post_v1.1.fcstd, minii_x_clamp_post_v1.1.stl]
2018-04-23 Updated model files for Z-Lower Left&Right & Z-Upper Left&Right to current versions, old versions stored in ATTIC T1806
    [Z-Lower_Left_Mini2_v1.7.1.stl, Z-Lower_Right_Mini2_v1.7.1.stl, Z-Upper_Left_Mini2_v1.4.fcstd, Z-Upper_Left_Mini2_v1.4.stl, Z-Upper_Right_Mini2_v1.4.fcstd, Z-Upper_Right_Mini2_v1.4.stl, z_lower_left_adjustable.stl, z_lower_left_mini2_v1.5.stl]
2018-04-23 Add a second check after burn in and the test print to make sure belts are still in spec
2018-04-23 updated inserts drawings for slotted z uppers and lowers, beefy x idler
    [1mmx20mm_dowel_pin.fcstd, extruder_mount_inserts.fcstd, x_end_idler_inserts.fcstd, z_lower_left_inserts.fcstd, z_lower_right_inserts.fcstd, z_upper_left_inserts.fcstd, z_upper_right_inserts.fcstd]
2018-04-24 corrected x idler and z upper right inserts drawings
2018-04-24 added 1mm to x belt tensioning post
    [minii_x_clamp_post.fcstd, minii_x_clamp_post.stl, minii_x_clamp_post_v1.1.fcstd, minii_x_clamp_post_v1.1.stl, minii_x_clamp_post_v1.2.fcstd, minii_x_clamp_post_v1.2.stl]
2018-04-24 Add a check to make sure z carriages reach bottom of travel
2018-04-24 Added updated octopus calibration gcode with new model T1813
2018-04-24 Updates slice for PP-GP0333 x belt tensioner post v1.2 T2429
2018-04-26 Removed obsolete gcode X-Belt Tensioner Post PP-GP0333 T2429 T1837
2018-04-26 Alleviate tugging on hibiscus toolhead ground line
2018-04-27 Updated MBOM with labels for UL according to T1799
    [Mini_2_MBOM.ods]
2018-04-27 adjusted motor values.
2018-04-30 Added 2 SH-PG0084 to MBOM for EU/AU Shipments T1799
    [Mini_2_MBOM.ods]
2018-04-30 Update to include new torque specs and Hi-Pot testing
2018-05-01 Add Serial number merge files for production
    [sn_merge_mini-AU.csv, sn_merge_mini-EU.csv, sn_merge_mini-NA.csv]
2018-05-03 Move DC-LB0154 Caution Hot Sticker from Calibration to Z-Axis Left T2493
    [Mini_2_MBOM.ods]
2018-05-03 Make consistent with file naming convention
    [1mmx20mm_dowel_pin.fcstd, 40mm_fan.fcstd, 40mm_fan.step, 50mm_blower.fcstd, 608_bearing.fcstd, 608_bearing.step, 625_bearing.fcstd, 80MM_FAN.fcstd]
2018-05-03 Add safety warning sheet and remove flat bom and old cura instructions
    [hibiscus_FlatBoM_1.16.18.ods]
2018-05-03 Add QSG cover, and clean up file formating
    [1mmx20mm_dowel_pin.fcstd, 40mm_fan.fcstd, 40mm_fan.step, 50mm_blower.fcstd, 608_bearing.fcstd, 608_bearing.step, 625_bearing.fcstd, 80MM_FAN.fcstd]
2018-05-03 Change file names to be all lower case
    [sn_merge_mini-AU.csv, sn_merge_mini-EU.csv, sn_merge_mini-NA.csv]
2018-05-04 Added OctopusRev6_Outline to printed_parts/jigs T1787 Updated calibration octopus gcode T1813 Updated Z-shipping gcode T2491
    [OctopusRev06_Outline.stl]
